liorknafo/home-robot/home-robot-sim/controller/requirements-learned.txt

# Optional desktop experiment. Install a compatible torch build separately first.
# Original Jetson Nano needs a separately validated JetPack/Python/torch environment.
lightglue @ git+https://github.com/cvg/LightGlue.git@eb42fee2d71449efb0aa5c10549752b5d75384d8
