liorknafo/home-robot/home-robot-sim/docs/superpowers/plans/2026-10-08-r1-bay-board.md

# R1 Bay Board (4-layer board under the Jetson) Implementation Plan

> **For agentic workers:** REQUIRED SUB-SKILL: Use superpowers:subagent-driven-development (recommended) or superpowers:executing-plans to implement this plan task-by-task. Steps use checkbox (`- [ ]`) syntax for tracking.

**Goal:** Move the power & I/O board from the 50 × 178 mm 2-layer strip to one 4-layer board of at most 100 × 100 mm (nominally 74 × 100) at base level under the unchanged Jetson. Then route it, check it, package it for fabrication, integrate it into the robot CAD, harness and BOM, and re-sync the simulator.

**Architecture:**
- **CAD and board stay coupled through files.** `cad/build_robot.py` (CadQuery) writes the meshes and manifest. `pcb/extract_outline.py` derives the board outline from them. `pcb/build_pcb.py` regenerates the KiCad board from `pcb/board_spec.py` (single source of truth). `pcb/route.py` routes it with Freerouting.
- **Two-way coupling from B8 on.** Until then the coupling is one-way, CAD → pcb. From B8 the CAD also imports the routed board: a STEP plus `pcb/board_cad.json`.
- **Plan order.** B1 moves the CAD placeholders, B2–B7 build the board, B8–B10 close the loop in the CAD, the harness and the simulator.

**Tech stack:**
- CadQuery 2.8 (`$CADPY`).
- KiCad 9.0.9 pcbnew (`$KPY`), `kicad-cli` (`$KCLI`).
- Freerouting 2.4.1 on Java 25.
- Blender 4 (viewer).
- Simulator `.venv` (sync, controller tests), Unreal 5.8 (benchmark).

**Spec:** `/Users/liorknafo/Documents/Codex/2026-10-03/i-x20/outputs/home-robot-sim/docs/superpowers/specs/2026-10-07-r1-bay-board-design.md`.
- It amends `2026-10-06-r1-low-profile-design.md` and `2026-10-04-r1-power-io-board-design.md`. Read the bay spec first, then the parts of those two that it keeps in force.

**Replaces:** tasks L4–L11 of `docs/superpowers/plans/2026-10-06-r1-low-profile.md`. L1–L3b of that plan are done and stay.

**Evidence to start from:**
- `home-robot-r1/.superpowers/sdd/2026-10-06-r1-low-profile/task-W4L-report.md` (the fit spike).
- Its scripts and placements in `.../handoff-scratch/w4l/`: `bay1_full.py` / `bay1_full.json` hold the THT and SMD positions in robot x, y; `bay1_full_conn.json` holds the connector positions.
- `home-robot-r1/.superpowers/sdd/codebase-survey-bay.md`: file:line map of every strip-specific and 2-layer-specific place in the code.

## Global Constraints

Copied from the bay spec. Every task's requirements include this section.

**Board:**
- **Size and position:** one 4-layer, 1.6 mm PCB with a bounding box ≤ 100 × 100 mm. Nominal outline robot x −66.5..7.5, y −50..50. Board bottom z 35.4, top z 37.0.
- **Outline from the CAD:** ≥ 1.5 mm to every fixed part.
- **Shape:**
  - full width for x −66.5..−14;
  - a tongue at |y| ≤ 33.5 for x −14..7.5, between the motor notches (motor x ±12.5, |y| ≥ 35, + 1.5 mm);
  - the rear Jetson standoffs at (−33, 40) and (−33, −46) clamp the board;
  - the front Jetson standoffs (x 25) lie ahead of it.
- **Stack-up:**
  - F.Cu: signals + SMD;
  - In1: solid GND;
  - In2: power pours (VBAT_SW, VMOT, 5V, 3V3) + signals;
  - B.Cu: signals.
- **Copper:** the quote's default (JLCPCB 4-layer default: 1 oz outer, 0.5 oz inner; confirm when ordering). Power paths sized from IPC-2221 at ≤ 10 °C rise. Parallel copper on F.Cu / In2 / B.Cu with via stitching counts. Heavier copper changes the price, so it needs the user's approval.

**Height zones:**
- **Under the carrier** (x ≥ −38.5): every part top, including a mated plug and its wire bend, ≤ z 54.77 − 1.5, i.e. ≤ 16.27 mm above the board top.
- **Behind the carrier** (x < −38.5): part tops ≤ lid underside − 3 mm (z 97.5).
- The old carrier-band rule (BAND_PLAN_MARGIN / BAND_PLAN_EXEMPT) is retired.

**Placement:**
- **Behind the carrier, exposed with the lid off:**
  - F1, F2, K1, C1;
  - the Pico, with its USB plug out of the left edge into the old strip-end space (x ≈ −54..−42, y 50..70), pluggable from above;
  - J1 battery, J2 rocker, J13 toggle loop, J12 arm button, J6 / J7 rear cliffs, on the rear edge.
- **Under the carrier:**
  - both DRV8874 carriers and the GY-521;
  - J4 / J5 on the motor-notch edges;
  - J10 / J11 bumpers on the side edges;
  - J8 / J9 front cliffs and J3 Jetson 5 V on the tongue's front edge;
  - U5A / U5B facing the P03;
  - the spares J14 / J15.
- **Under-carrier connectors:** each leaves its cable a path in the 17 mm gap. Either a right-angle (side-entry) housing or header, or a vertical part whose mated height plus a 90° wire bend fits the 16.27 mm zone. The cable leaves at a board edge, outward. These are plugged before the Jetson is fitted.
- **Assembly (LP3/LP4):**
  - reflow on top only;
  - ≥ 1.0 mm between SMD bodies;
  - ≥ 2.0 mm from an SMD pad to the pads of tall THT parts;
  - R13 thermal reliefs on SMD pads in zones;
  - values and polarity on silk;
  - F.Paste + stencil;
  - order: reflow SMD → inspect → iron THT → modules.
- **C1:** within 30 mm of both drivers' VIN pins.
- **Module sockets:** unmirrored.
- **Status LEDs and test pads:** behind the carrier if they fit there without breaking a rule; otherwise under it, recorded in BRINGUP.

**Rules:**
- **Unchanged:** R13 thermal reliefs; R16 Motor class with 1.0 mm clearance; R17 vias ≥ 0.5 mm from other-net pads and the 4.5 mm GND-only washer keep-out per M3 hole; LP12 one tented GND via per top-side SMD GND pad, now to In1; zero GND tracks; placement parity; route.py writes the board only on a clean result.
- **R4:** widths recomputed for the ordered copper.
- **R15:** on In1 — ≤ 1.05× for the power loops, ≤ 1.2× for the signal returns, and no In1 slot longer than 10 mm. The 40 mm B.Cu run rule is dropped.

**Mounting:**
- 4 × M3 into heat-set inserts in P_base on 2.4 mm printed PETG spacers. Start from the spike positions (−19.5, ±38), (−11.5, ±8.5) (H3/H4 moved by ruling PB4).
- The board is clamped in the two rear Jetson standoff stacks: base → 2.4 mm spacer → board → M2.5 × 20 mm standoff → Jetson. The Jetson stays at z 57.
- Printed bearing ribs on P_base sit under the rear-edge connector row.
- THT leads are trimmed to ≤ 1.4 mm.

**P03:** turned 90° in the front bay, x 9..47, |y| ≤ 31, z 33–48. Foam tape plus tie slots. Leads to U5A / U5B are about 10 mm. Re-check against the bumper riders B at full travel.

**Motor cables:** the factory 6-wire cables plug straight into J4 / J5. The W_motor harness and the motor-header joints are dropped.

**Pico GPIO:** PICO_GPIO in board_spec stays the single map. Constraints: I2C on a valid I2C pair; ADC only on GP26–28; each motor's IN1/IN2 on one PWM slice A/B. parts-and-connections.json follows it.

**CAD gates:**
- the build exits 0;
- `validation.json` → `clash_scan_empty` true;
- printability all-pass (Prusa MK3S: fits 250 × 210 × 210, overhangs, walls, a flat base);
- COM x ≤ −15 mm, nominal and worst case;
- robot top 155.15 mm (≤ 160);
- the Jetson, the lid and the LiDAR unchanged.

**Jetson model:** always NVIDIA's official Jetson Nano B01 model in the CAD, renders, viewer and sim sync. Never a block.

**Hard robot rules:** no blind reversing; the circle rule for spins; bumper and cliff behaviour unchanged.

**Never:**
- order or pay for anything;
- add ballast without asking the user;
- delete user data (`$SIM/Saved/Stereo` is theirs).

**Running sim:** the Unreal editor and the autonomy service may be running. Restart them only in B10, and tell the user.

**Version control:**
- Commit on branch `power-io-board` in `$R1`. Every message ends with `Co-Authored-By: Claude Opus 5.5 <noreply@anthropic.com>`.
- `$SIM` is not git: back up the files a task changes to `$SP/backup-original/bay-B<N>/` first.

**Machine limits:**
- ONE Freerouting JVM at a time, `-Xmx1g`.
- `df -h /System/Volumes/Data` ≥ 10 GB before each router run.
- No blocking command over about 4 minutes: run builds, routing, DRC and fills in the background with a log.
- Keep outputs small.
- Never open `$SP/f1`, `$SP/t6`, `$SP/t6r`.

Shell variables:

```bash
R1=/Users/liorknafo/Documents/Codex/2026-10-03/i-x20/outputs/home-robot-r1
SIM=/Users/liorknafo/Documents/Codex/2026-10-03/i-x20/outputs/home-robot-sim
SP=/private/tmp/claude-501/-Users-liorknafo-Documents-Codex-2026-10-03-i-x20-outputs-home-robot-sim/030356d9-c2ab-4fc2-a131-e83b5b8d9fe0/scratchpad
CADPY=$SP/cadvenv/bin/python          # CadQuery 2.8 + trimesh + numpy + matplotlib; recreate from $R1/cad/requirements.txt if $SP is gone
KPY=/Applications/KiCad/KiCad.app/Contents/Frameworks/Python.framework/Versions/Current/bin/python3
KCLI=/Applications/KiCad/KiCad.app/Contents/MacOS/kicad-cli
PURE="cd $R1 && $CADPY -m unittest discover -s pcb/tests -p 'test_*.py' -t ."
KTEST() { cd $R1 && PYTHONPATH=$R1 $KPY -m unittest pcb.tests.$1 -v; }
```

## Review Focus

These are inputs and conditions the spec implies but the obvious tests would miss. Each has its test in the owning task.

1. **A cable plugged into a connector under the Jetson.** The mated plug plus its wire bend must clear the carrier underside, and the cable must leave at an edge with nothing in the way. Test: B3 `test_under_carrier_connectors_leave_a_cable_path`.
2. **Plugging and unplugging the battery (J1), the rocker (J2) and the rear XH row.** The board must not flex. Every rear-edge connector sits over a bearing rib and within 35 mm of a fixing (M3 hole or standoff clamp). Test: B8 validation key `bay_rear_connectors_supported`.
3. **A bumper hit at full travel.** The turned P03 must not be struck by the bumper riders B. Test: B1 validation key `p03_clear_of_bumper_travel`.
4. **THT power pads connected to the planes through thermal spokes.** The spokes, summed over the layers each pad connects on, must carry the pad's net current at ≤ 10 °C. They must stay spokes, not solid, so the user can still iron the pad. Test: B6 `test_power_pad_spokes_carry_their_current`.
5. **The Pico USB plug, pushed in from above with the lid off and the Jetson fitted.** Its path to the left edge, and the space above it, must be clear. Tests: B3 `test_pico_usb_at_the_left_edge_with_clear_plug_path` and B8 validation key `pico_usb_insert_path_clear`.

## File structure

| File | Responsibility | Tasks |
|---|---|---|
| `cad/build_robot.py` | Robot CAD: the bay board placeholders (B1), then the real board (B8), cable runs (B9), mass records, validation keys | B1, B8, B9 |
| `pcb/board_spec.py` | Frame, height zones, REMOVED_CAD_IDS, PARTS footprints, PLACEMENT, EDGE_CONNECTORS, POWER_ZONES, PICO_GPIO | B2, B3, B4 |
| `pcb/extract_outline.py` | Bay outline, M3 holes and clamp holes from the CAD meshes → `pcb/board_outline.json` | B2 |
| `pcb/copper.py` (new) | Stack-up, copper weights, IPC-2221 widths and capacities | B4 |
| `pcb/build_pcb.py` | 4-layer board generation (stack-up, In1 plane, power pours on F.Cu / In2, B.Cu GND fill) | B4 |
| `pcb/zone_check.py` | Trunk check per layer, GND plane on In1, R15 on In1, In1 slot check, power capacity | B4, B5, B6 |
| `pcb/route.py` | 4-layer routing (In1 as a plane), strip-only stages removed | B5 |
| `pcb/power_check.py` (new) | B6 power check entry point and report | B6 |
| `pcb/make_fab.py` (new), `pcb/fab/ORDERING.md` (new) | Fabrication package | B7 |
| `pcb/export_cad.py` (new) → `pcb/board_cad.json`, `pcb/fab/r1_power_io.step` | Board data for the CAD | B8 |
| `pcb/tests/*` | test_board_spec, test_outline, test_copper (new), test_fab (new), ktest_pcb, ktest_route, ktest_power (new) | B2–B7 |
| `parts-and-connections.json`, `BRINGUP.md` (new, R1 root) | Harness, pin tables, BOM notes; bring-up | B9, B10 |
| `$SIM/Scripts/sync_robot_data.py` outputs, viewer files | Simulator and viewer | B10 |

---

### Task B1: CAD — bay board placeholders under the Jetson, P03 turned, motor joints removed

**Files:**
- Modify `cad/build_robot.py`. The survey (`codebase-survey-bay.md`, "cad/build_robot.py") lists every strip site with line numbers: the STRIP block :253–269, base holes :286 / :339 / :363, motor items :419–420, strip parts :433–455, Jetson standoffs :491–495, wires :882–902, NOW :1014, screw checks :1063 / :1493, lid-switch gaps :1627–1631, mass :1780–1791, prose :1830–2044.
- Regenerated outputs: `cad/*.json`, `cad/home-robot-r1.step` / `.glb`, `print-parts/`.

**Interfaces:**
- Consumes: spike positions from `handoff-scratch/w4l/bay1_full.json` and `bay1_full_conn.json` (robot x, y).
- Produces CAD ids:
  - `bay_board` (1.6 mm plate, nominal outline, M3 holes, clamp holes);
  - `bay_pico`, `bay_drv_0` (left), `bay_drv_1` (right), `bay_imu`, `pico_usb_plug` (at the left edge);
  - `bay_spacer_0..3` (2.4 mm printed PETG, z 33–35.4), `bay_screw_0..3`, `insert_bay_0..3`;
  - `bay_clamp_spacer_1`, `bay_clamp_spacer_3` (2.4 mm, under the rear Jetson standoffs);
  - `bay_rib_0..n` (printed ribs on P_base, top z 35.4).
- Produces constants: `BAY_OUTLINE` (robot x, y polygon), `ZBAY=35.4`, `BAY_T=1.6`, `ZBAY_TOP=37.0`, `BAY_MOUNTS=[(-19.5,38),(-19.5,-38),(-5.5,24),(-7,-14.5)]`, `BAY_CLAMPS=[(-33,40),(-33,-46)]`, `CARRIER_X=-38.5`, `UNDER_CARRIER_Z=54.77`.
- Changed: `jetson_standoff_1` and `jetson_standoff_3` become M2.5 × 20 mm nylon F-F, z 37.0–57.0. `jetson_screw_1` and `jetson_screw_3` become M2.5 × 12 countersunk.
- `p03_regulator` is turned: x 9..47, |y| ≤ 31, z 33..47 (14 mm), with foam z 33..34 if the current model has it. Tie slots in P_base.
- Removed: `strip_*`, `insert_strip_*`, `motor_header_*`, `W_motor_*`. `motor_cable_*` is re-routed to the J4 / J5 positions.
- New `validation.json` keys:
  - `p03_clear_of_bumper_travel` (bool);
  - `jetson_carrier_bottom_z` (float, must be 57.0);
  - `bay_under_carrier_max_top_z` (float, ≤ 53.27, from the placeholder modules);
  - `bay_ribs_under_rear_row` (bool).

**Steps:**
- [ ] **Step 1: Read the inputs.** Read the spec, this task, the survey's CAD section, and spike report §5 and §8. Load `bay1_full.json` / `bay1_full_conn.json` and note the positions of the Pico, DRV_L, DRV_R, IMU and the rear-edge connectors (J13, J6, J7, J12, J2, J1).
- [ ] **Step 2: Replace the strip block with the bay block** (:253–269 and the strip parts :433–455):
  - `BAY_OUTLINE` as the nominal polygon: rear x −66.5; front x 7.5 on the tongue; tongue |y| ≤ 33.5 for x > −14; full width |y| ≤ 50 for x ≤ −14.
  - `bay_board` = that polygon extruded `BAY_T` at `ZBAY`, with Ø3.2 holes at `BAY_MOUNTS` and Ø2.7 holes at `BAY_CLAMPS`.
  - Module placeholders at the spike positions, with the same `module()` helper and heights: Pico 15, DRV 14, IMU 14 above the board top. Rename the ids as above.
  - `pico_usb_plug` at the Pico's left-edge receptacle, pointing +y, into x ≈ −54..−42, y 50..70, z ≈ 44–52.
- [ ] **Step 3: Mounting.**
  - `insert_bay_i` at `BAY_MOUNTS`, made with the existing `insert()` helper (:158), with base holes as at :286.
  - `bay_spacer_i` 2.4 mm printed rings (z 33–35.4, Ø7 / Ø3.4).
  - `bay_screw_i` M3 × 8 pan-head from above.
  - Split the two rear Jetson standoff stacks (`JSTAND` indices at x −33): add the `bay_clamp_spacer_*` rings (z 33–35.4), make the standoff z 37.0–57.0 (20 mm), and lengthen the screw to M2.5 × 12. The front standoffs stay unchanged.
  - Remove `insert_strip_*` and their base holes. Remove the `JTHRU` clearance holes, since the clamp replaces them.
- [ ] **Step 4: P03.**
  - Set `P03C,P03S` to the turned pose: centre (28, 0), size (38, 62, 14) in x, y, z.
  - Add 2 tie slots in P_base beside it, in the same style as `TIES` (:253).
  - Add validation `p03_clear_of_bumper_travel`: sweep each `P_bumper_rider_*_B` (and every bumper part extract_outline sweeps) through its 5 mm travel, using the same sweep vector as `extract_outline.py` (bumper sweep near :162). Assert the swept solid does not intersect the P03 box inflated by 0.5 mm. Store the bool and the minimum gap.
- [ ] **Step 5: Motor items.**
  - Delete `motor_header_*` (:419) and `W_motor_*` (:885).
  - Re-route `motor_cable_{side}` with `wire()` from its motor exit to the J4 (left) / J5 (right) position in `bay1_full_conn.json`, at z 38 + 5.
  - Keep `NOW` treating `motor_cable*` as a wire.
- [ ] **Step 6: Wires.** Point W01, W02, W04, W10–W13, W14, W15, W16 and W_bumper_* (:882–902) at the spike connector positions (`bay1_full_conn.json`). Exit z = `ZBAY_TOP` + 5 behind the carrier, and `ZBAY_TOP` + 3 under it. Use the existing `wire()` helper, which writes `cable-cut-list.json`.
- [ ] **Step 7: Ribs and the remaining strip references.**
  - Add `bay_rib_i` on P_base under the rear-edge connector row. Each rib runs along y, 2 mm wide, z 33–35.4, under each rear connector's body (from `bay1_full_conn.json`). Keep each rib ≥ 1.0 mm from every THT pad position in `bay1_full.json`.
  - Validation `bay_ribs_under_rear_row`: true when each of J13, J6, J7, J12, J2, J1 has a rib under ≥ 50 % of its courtyard length.
  - Mass records: `PW` = p03_regulator, bay_board, bay_drv_0, bay_drv_1; `CTRL` = bay_pico, bay_imu, bay_board.
  - Lid-switch gaps (:1627–1631): use the bay ids. Update the strip prose (:1830–1831, :1990, :2012–2018, :2044) to describe the bay board.
- [ ] **Step 8: Remaining validation keys.**
  - `jetson_carrier_bottom_z` = the Jetson carrier PCB's min z, which must be 57.0.
  - `bay_under_carrier_max_top_z` = the max top z of every bay module placeholder whose footprint has x ≥ `CARRIER_X`, which must be ≤ 53.27.
  - Fold all four new keys into the overall validation pass, so a False fails the build's validation summary.
- [ ] **Step 9: Build** in the background:
  ```bash
  mkdir -p $SP/B1 && cd $R1 && $CADPY cad/build_robot.py > $SP/B1/build.log 2>&1; echo exit $?
  ```
  Expected: exit 0. Check with `python3 -c "import json;v=json.load(open('$R1/cad/validation.json'));print({k:v[k] for k in ('clash_scan_empty','p03_clear_of_bumper_travel','jetson_carrier_bottom_z','bay_under_carrier_max_top_z','bay_ribs_under_rear_row')})"`. Expected: True, True, 57.0, ≤ 53.27, True.
  - The printability summary is all-pass.
  - `mass-properties.json` `total_com_mm[0]` ≤ −15, and the worst case ≤ −15. The spike estimate is −18.25 / −15.70.
  - Robot top 155.15.
- [ ] **Step 10: Pure pcb tests.** Run `$PURE`. The tests that read strip ids are expected to fail until B2 (`test_removed_cad_ids_exist`, `test_removed_cad_ids_are_the_strip_placeholders`, test_outline). List them in the report. No other test may newly fail.
- [ ] **Step 11: Commit.**
  ```bash
  cd $R1 && git add cad print-parts && git commit -m "cad: board moves under the Jetson (bay placeholders), P03 turned in the front bay, motor joints dropped (bay B1)

  Co-Authored-By: Claude Opus 5.5 <noreply@anthropic.com>"
  ```

### Task B2: Board frame and outline for the bay

**Files:**
- Modify `pcb/board_spec.py`: frame :9–44, `HEIGHT_ZONES` :28, `BAND_*` :32–39, `max_part_h_at`, `REMOVED_CAD_IDS` :233, `MAX_PART_H`.
- Modify `pcb/extract_outline.py`: `ENV` :40, slab :39, `HOLE_SPOTS_ROBOT` :46, holes :321–331, plus clamp holes.
- Regenerate `pcb/board_outline.json`.
- Modify `pcb/tests/test_outline.py` and `pcb/tests/test_board_spec.py` (the strip tests listed in the survey).

**Interfaces:**
- Consumes: the B1 CAD ids and constants (`BAY_MOUNTS`, `BAY_CLAMPS`, `CARRIER_X`, `UNDER_CARRIER_Z`).
- Produces in `board_spec`:
  - `BOARD_X0=-66.5`, `BOARD_Y0=50.0`, `BOARD_W=74.0`, `BOARD_H=100.0`. The frame convention is unchanged: u = x − X0 (u 0 rear → 74 front), v = Y0 − y (v 0 = left edge y +50 → v 100 right edge).
  - `Z_PCB_BOTTOM=35.4`, `Z_PCB_TOP=37.0`.
  - `CARRIER_U=28.0` (x −38.5), `UNDER_CARRIER_Z=54.77`, `CARRIER_CLEARANCE=1.5`.
  - `UNDER_CARRIER_MAX_H = UNDER_CARRIER_Z - CARRIER_CLEARANCE - Z_PCB_TOP` (= 16.27).
  - `MAX_PART_H = CEILING_Z_LID - Z_PCB_TOP`, with `CEILING_Z_LID = LID_UNDERSIDE_Z - 3.0` (= 97.5), giving 60.5.
  - `HEIGHT_ZONES=[(CARRIER_U, 0.0, BOARD_W, BOARD_H, UNDER_CARRIER_MAX_H)]`.
  - `max_part_h_at(u, v)` returns the zone limit or `MAX_PART_H`. `BAND_PLAN_MARGIN` and `BAND_PLAN_EXEMPT` are deleted.
  - `REMOVED_CAD_IDS` = bay_board, bay_pico, bay_drv_0, bay_drv_1, bay_imu, pico_usb_plug, bay_spacer_0..3, bay_screw_0..3, bay_clamp_spacer_1, bay_clamp_spacer_3.
- Produces `board_outline.json` with the same keys as today, plus `clamp_holes_uv` (2 entries). `cutouts_uv` is empty unless the meshes need one.

**Steps:**
- [ ] **Step 1: Write the failing tests first** (rewrite the strip tests).
  - In test_board_spec, `test_strip_frame` becomes `test_bay_frame`:
    ```python
    def test_bay_frame(self):
        self.assertEqual((B.BOARD_X0, B.BOARD_Y0, B.BOARD_W, B.BOARD_H), (-66.5, 50.0, 74.0, 100.0))
        self.assertEqual((B.Z_PCB_BOTTOM, B.Z_PCB_TOP), (35.4, 37.0))
        self.assertLessEqual(max(B.BOARD_W, B.BOARD_H), 100.0)   # JLCPCB <= 100 x 100 price
        self.assertAlmostEqual(B.UNDER_CARRIER_MAX_H, 16.27, places=2)
        self.assertAlmostEqual(B.MAX_PART_H, 60.5, places=2)
    ```
    - `test_height_zones_are_well_formed` asserts `HEIGHT_ZONES == [(28.0, 0.0, 74.0, 100.0, B.UNDER_CARRIER_MAX_H)]`.
    - `test_max_part_h_formula` asserts the formula above.
    - `test_removed_cad_ids_are_the_strip_placeholders` becomes `test_removed_cad_ids_are_the_bay_placeholders`, asserting the exact id set above.
    - Delete `test_band_plan_margin`.
  - In test_outline:
    - Replace the strip assertions with:
      - `test_bbox_within_100mm`: outline bbox ≤ 74.0 × 100.0 + 0.01;
      - `test_large_enough`: area ≥ 6,000 mm²;
      - `test_outline_inside_the_bay_envelope`;
      - `test_motor_notches`: no outline point within 1.5 mm of either motor mesh's xy hull;
      - `test_clamp_holes_at_the_rear_jetson_standoffs`: `clamp_holes_uv` equals `BAY_CLAMPS` in board coordinates ±0.1;
      - `test_holes_sit_on_the_bay_inserts`: `holes_uv` equals the `insert_bay_*` centres from the manifest ±0.1;
      - `test_rear_edge_keeps_off_the_battery_tray`: kept, with the bay values.
    - Delete `test_strip_envelope_is_the_cad_placeholder`, `test_front_corner_notches_for_the_motor_mounts` and `test_cutouts_around_both_jetson_standoffs`.
    - Keep the generic tests: necks, short edges, keep-out margin, RealGeometryTests.
    - BoardHeightTests:
      - `test_height_zones_cover_the_area_under_the_jetson_carrier`: every board cell under the carrier mesh's xy hull has u ≥ CARRIER_U;
      - `test_every_cell_of_the_board_is_under_its_height_limit`: for each 1 mm cell, `Z_PCB_TOP + max_part_h_at(cell) ≤` (the lowest mesh bottom above the board at that cell) − 1.5, or ≤ 97.5 where nothing is above.
- [ ] **Step 2: Run the tests to watch them fail.** Run `$PURE`. Expected: the new frame and outline tests FAIL with the old strip values.
- [ ] **Step 3: Update board_spec.**
  - Set the constants above.
  - Rewrite `max_part_h_at` as a zone lookup.
  - Delete the band constants and their users. Grep `BAND_PLAN` across `pcb/` and fix every hit.
  - Set `REMOVED_CAD_IDS`.
- [ ] **Step 4: Update extract_outline.**
  - `ENV` = robot x −70..10, y −50..50. The meshes then cut the rear (tray wall), the front (P03) and the notches (motors).
  - Slab Z0..Z1 = 33.0..54.77.
  - `HOLE_SPOTS_ROBOT` = the `insert_bay_*` centres from the manifest.
  - Add `CLAMP_SPOTS_ROBOT` = the centres of `jetson_standoff_1` and `jetson_standoff_3` → `clamp_holes_uv`. Exclude those two standoffs and `bay_clamp_spacer_*` from the keep-out hulls: they are the clamp, not obstacles.
  - Keep `MARGIN` 1.5, `CLOSE` 1.1 and the one-piece rule.
- [ ] **Step 5: Generate and test.**
  ```bash
  cd $R1 && $CADPY pcb/extract_outline.py && eval $PURE
  ```
  Expected: all pure tests PASS, except the ktest-dependent ones listed in B3 (none are in the pure suite).
- [ ] **Step 6: Commit.**
  ```bash
  git add pcb/board_spec.py pcb/extract_outline.py pcb/board_outline.json pcb/tests
  git commit -m "pcb: bay board frame, height zones and outline from the CAD (bay B2)

  Co-Authored-By: Claude Opus 5.5 <noreply@anthropic.com>"
  ```
  ktest_pcb is red until B3, because PLACEMENT still holds strip coordinates.

### Task B3: Placement under the Jetson (still 2 layers; B4 converts the stack)

**Files:**
- Modify `pcb/board_spec.py`:
  - `PARTS` footprints for the under-carrier connectors that need right-angle parts;
  - `PLACEMENT` (including H1–H4 at `holes_uv`, plus H5 / H6 clamp holes);
  - `EDGE_CONNECTORS`, `TERMINALS`;
  - `POWER_ZONES` (F.Cu polygons for the new placement);
  - `SMD_GND_VIAS` (regenerated);
  - `PREROUTES`, `HOP_VIAS`, `PREROUTE_VIAS` all emptied;
  - `PICO_GPIO`, only if remapped.
- Modify `pcb/build_pcb.py`: H5 / H6 as NPTH Ø2.7 footprints with the keep-out.
- Run `pcb/make_schematic.py` to regenerate the schematic, project, DRU and netlist.
- Modify `pcb/tests/ktest_pcb.py` and `pcb/tests/test_board_spec.py` (their strip tests).
- Modify `pcb/zone_check.py`: `MOUNT_HOLES` gains H5 / H6, with `CLAMP_KEEP=3.5` mm (no copper but GND).
- Modify `parts-and-connections.json`.

**Interfaces:**
- Consumes: the B2 frame, `HEIGHT_ZONES`, `max_part_h_at`, `board_outline.json` (`holes_uv`, `clamp_holes_uv`).
- Produces:
  - `EDGE_CONNECTORS: dict[str, str]`, ref → entry direction, one of `'+u'`, `'-u'`, `'+v'`, `'-v'`. The cable leaves the board in that direction. The old edge names are dropped.
  - `CABLE_BEND_MM = {'XH': 5.0, 'PinHeader': 5.0, 'VH': 7.0}`: the wire-bend allowance above a vertical mated plug.
  - `MATED_H: dict[str, float]`: per-connector mated height (housing + plug) above the board top, taken from the datasheets and recorded with a source note.
  - `UNDER_CARRIER(ref) -> bool`: true when the part's courtyard reaches u ≥ CARRIER_U, computed from PLACEMENT and the footprint courtyard bbox.
  - `connector_family(ref) -> str`: one of 'XH', 'VH', 'PinHeader', 'Terminal', from the PARTS footprint name.
  - `cable_lane_obstacles(board, ref, direction, max_h)`: a test helper in ktest_pcb (defined in Step 1).

**Steps:**
- [ ] **Step 1: Write the failing tests.**
  - ktest_pcb:
    - `test_connectors_on_their_edges`: for each ref in EDGE_CONNECTORS, the courtyard is within 1.5 mm of the outline edge in its entry direction.
    - `test_connector_plug_entry_faces_outward`: generic. The connector's entry side, from its footprint orientation, points along its EDGE_CONNECTORS direction.
    - Delete `test_lp7_front_connectors_outside_the_carrier` and `test_front_band_holds_only_smd`.
    - `test_part_heights_fit_where_they_sit`: uses `max_part_h_at` for every courtyard cell.
    - `test_under_carrier_connectors_leave_a_cable_path` (Review Focus 1):
      ```python
      def test_under_carrier_connectors_leave_a_cable_path(self):
          for ref, d in B.EDGE_CONNECTORS.items():
              if not B.UNDER_CARRIER(ref):
                  continue
              fam = B.connector_family(ref)          # 'XH' | 'VH' | 'PinHeader' | 'Terminal'
              vertical = B.PARTS[ref]['fp'].endswith('_Vertical')
              need = B.MATED_H[ref] + (B.CABLE_BEND_MM[fam] if vertical else 0.0)
              self.assertLessEqual(need, B.UNDER_CARRIER_MAX_H, ref)
              # nothing taller than 3 mm between the connector's entry side and the board edge in direction d
              self.assertEqual(cable_lane_obstacles(self.board, ref, d, max_h=3.0), [], ref)
      ```
      `cable_lane_obstacles` is a test helper: the lane is the connector's courtyard width, swept in direction d to the outline. It returns the refs whose courtyards in that lane have h > 3.0.
    - `test_pico_usb_at_the_left_edge_with_clear_plug_path` (Review Focus 5). The USB receptacle end of U1A/U1B points −v (left edge, v 0). The lane `USB_PLUG_W` wide from the receptacle to v 0 holds no courtyard. The receptacle is within 3 mm of the edge.
    - `test_band_holds_the_frequent_connectors_and_fuses`: J1, J2, J6, J7, J12, J13, F1, F2, K1, C1, U1A and U1B have every courtyard point at u < CARRIER_U.
    - `test_c1_within_30mm_of_both_vin`: the distance from C1's centre to the VIN pad of U3P and of U4P is ≤ 30.0. Report the two values.
    - `test_clamp_holes_at_outline_clamp_holes`: H5 / H6 sit at `clamp_holes_uv` ±0.05, and no copper but GND lies within `CLAMP_KEEP`.
  - test_board_spec:
    - `test_every_off_board_connector_has_an_edge`: every connector ref is in EDGE_CONNECTORS, with a direction in {'+u','-u','+v','-v'}.
    - `test_pico_usb_end_points_at_the_left_end` → `..._at_the_left_edge`, asserting the −v direction.
- [ ] **Step 2: Run the tests to watch them fail.**
  ```bash
  cd $R1 && $KPY pcb/build_pcb.py && KTEST ktest_pcb 2>&1 | tail -30
  ```
  Expected: FAIL. The parts sit at strip coordinates, outside the bay outline.
- [ ] **Step 3: Choose the under-carrier connector parts.**
  - For every connector with `UNDER_CARRIER`, compute `MATED_H + bend` for the vertical part. Record the datasheet heights in `MATED_H` with a comment giving the source.
  - If a part exceeds 16.27, switch it to the side-entry KiCad footprint: `JST_XH_S{n}B-XH-A_1x0{n}_P2.50mm_Horizontal`, `JST_VH_S2P-VH_1x02_P3.96mm_Horizontal`, or `PinHeader_1x06_P2.54mm_Horizontal`. The MKDS terminals are already horizontal.
  - Update `PARTS` (fp, h, MPN), then run `$KPY pcb/make_schematic.py` so `test_generated_files_are_current` stays green.
- [ ] **Step 4: Write PLACEMENT.**
  - Convert `handoff-scratch/w4l/bay1_full.py` positions from robot x, y to u, v with `robot_to_board`.
  - Adjust for the Step 3 footprints, and for H5 / H6 with their keep-out.
  - Move the LEDs and test pads into the band (u < 28) wherever every rule still holds. List those that stay under the carrier, for B10's BRINGUP.
  - **Band fallback (spec risk 1).** The spike filled about 98.5 of the 100 mm along v. If the band parts do not fit with the Step 3 footprints and H5 / H6, apply these in order and stop at the first that fits:
    1. C1 → SMD can, Ø10 × 10.5, Panasonic EEE-FK1E471P; then C1 may go under the carrier.
    2. C1 laid flat.
    3. Spike variant B-ii: the full 100 × 100 board, with the P03 on a printed shelf over a motor. This changes B1/B2: report BLOCKED with numbers, and the controller re-scopes.

    Record which one was used.
  - Write EDGE_CONNECTORS directions and TERMINALS.
  - Draw `POWER_ZONES` F.Cu polygons for VBAT_SW, VMOT, 5V around their trunk pads, as the existing tests require (4 mm corridor, disjoint).
  - Regenerate `SMD_GND_VIAS` with the LP12 rule.
  - Empty `PREROUTES`, `HOP_VIAS` and `PREROUTE_VIAS`.
  - If routing will want a GPIO remap, record it in `PICO_GPIO`, respecting the hardware constraints.
- [ ] **Step 5: parts-and-connections.json.**
  - Update the connector table: edges, right-angle parts, motor cables plugging straight into J4 / J5.
  - Update the Pico pin table, so it equals `PICO_GPIO`.
  - The uncommitted L5b edit in this file is the starting point. Diff it against `PICO_GPIO` and fix any mismatch.
- [ ] **Step 6: Build and run the tests.**
  ```bash
  cd $R1 && $KPY pcb/build_pcb.py && KTEST ktest_pcb 2>&1 | tail -5 && eval $PURE 2>&1 | tail -3
  ```
  Expected: ktest_pcb all PASS (still 2 layers), pure all PASS, DRC with 0 silk problems. Record the C1 distances.
- [ ] **Step 7: Plot and commit.**
  - Plot the placement (F.Fab + courtyards) to `$SP/B3/placement.png`.
  - Commit:
    ```bash
    git add pcb parts-and-connections.json && git commit -m "pcb: placement under the Jetson, right-angle connectors under the carrier (bay B3)

    Co-Authored-By: Claude Opus 5.5 <noreply@anthropic.com>"
    ```

### Task B4: 4-layer stack-up and copper rules

**Files:**
- Create `pcb/copper.py` and `pcb/tests/test_copper.py`.
- Modify `pcb/build_pcb.py`: :173 layer count, stack-up, zones :225–237.
- Modify `pcb/board_spec.py`: `POWER_ZONES` entries gain `layers`; BAT+, F1_OUT, F2_OUT become zones too; `NETCLASSES` comment and R4 text.
- Modify `pcb/zone_check.py`: `trunk_layer` :37 → per-net layer lists; the GND functions :101–180 use `copper.GND_PLANE_LAYER`; new `in1_voids`.
- Modify `pcb/tests/ktest_pcb.py` (the 2L tests :151 / :184 / :197 / :248) and `pcb/tests/test_board_spec.py` (`test_power_zones_are_the_f_cu_trunks`, `test_preroutes_are_well_formed`).

**Interfaces:**
- Produces `pcb/copper.py`:
  ```python
  """Copper stack-up of the ordered board and IPC-2221 widths (bay spec 2026-10-07 §2)."""
  STACKUP = ('F.Cu', 'In1.Cu', 'In2.Cu', 'B.Cu')
  COPPER_OZ = {'F.Cu': 1.0, 'In1.Cu': 0.5, 'In2.Cu': 0.5, 'B.Cu': 1.0}   # JLCPCB 4-layer default; confirm when ordering
  GND_PLANE_LAYER = 'In1.Cu'
  RISE_C = 10.0
  MIL = 0.0254

  def is_internal(layer):
      return layer.startswith('In')

  def ipc2221_width_mm(current_a, oz, rise_c=RISE_C, internal=False):
      """Track width (mm) that carries current_a at rise_c on copper of weight oz (IPC-2221 chart fit)."""
      k = 0.024 if internal else 0.048
      area_mil2 = (current_a / (k * rise_c ** 0.44)) ** (1 / 0.725)
      return area_mil2 / (1.378 * oz) * MIL

  def ipc2221_current_a(width_mm, oz, rise_c=RISE_C, internal=False):
      """Current (A) a track of width_mm carries at rise_c (inverse of ipc2221_width_mm)."""
      k = 0.024 if internal else 0.048
      area_mil2 = width_mm / MIL * 1.378 * oz
      return k * rise_c ** 0.44 * area_mil2 ** 0.725

  def capacity_a(widths_by_layer, rise_c=RISE_C):
      """Summed IPC current of parallel copper: {layer: width_mm} -> A."""
      return sum(ipc2221_current_a(w, COPPER_OZ[l], rise_c, is_internal(l)) for l, w in widths_by_layer.items() if w > 0)
  ```
- Produces `POWER_ZONES` entries shaped `dict(net=..., layers=('F.Cu','In2.Cu'), poly=[(u, v), ...])`.
- Produces `zone_check.in1_voids(board) -> list[(length_mm, bbox)]`: the holes in the filled In1 GND polygon, excluding the board cutouts and the mounting / clamp holes.

**Steps:**
- [ ] **Step 1: Write the failing tests** in `pcb/tests/test_copper.py` (pure):
  ```python
  import unittest
  from pcb import copper as C

  class CopperTests(unittest.TestCase):
      def test_ipc2221_reference_widths(self):
          self.assertAlmostEqual(C.ipc2221_width_mm(7.5, 1.0), 4.838, delta=0.01)
          self.assertAlmostEqual(C.ipc2221_width_mm(5.0, 1.0), 2.765, delta=0.01)
          self.assertAlmostEqual(C.ipc2221_width_mm(2.1, 1.0), 0.836, delta=0.01)
          self.assertAlmostEqual(C.ipc2221_width_mm(1.0, 0.5, internal=True), 1.563, delta=0.01)

      def test_current_is_the_inverse_of_width(self):
          for i in (0.5, 2.1, 5.0, 7.5):
              self.assertAlmostEqual(C.ipc2221_current_a(C.ipc2221_width_mm(i, 1.0), 1.0), i, places=6)

      def test_parallel_copper_adds(self):
          one = C.capacity_a({'F.Cu': 3.0})
          self.assertAlmostEqual(C.capacity_a({'F.Cu': 3.0, 'B.Cu': 3.0}), 2 * one, places=6)
          self.assertGreater(C.capacity_a({'F.Cu': 3.0, 'B.Cu': 3.0}), 7.5)   # BAT+ on two outer layers

      def test_stackup_is_the_ordered_default(self):
          self.assertEqual(C.STACKUP, ('F.Cu', 'In1.Cu', 'In2.Cu', 'B.Cu'))
          self.assertEqual(C.COPPER_OZ, {'F.Cu': 1.0, 'In1.Cu': 0.5, 'In2.Cu': 0.5, 'B.Cu': 1.0})
          self.assertEqual(C.GND_PLANE_LAYER, 'In1.Cu')
  ```
  - ktest_pcb:
    - `test_power_zones_present`: In1 holds exactly one zone, net GND, covering the outline. In2 holds the pours VBAT_SW, VMOT, 5V, 3V3. B.Cu holds a GND fill. F.Cu holds the POWER_ZONES F.Cu entries.
    - `test_power_zone_pads_use_wide_thermal_reliefs`: every zone on every layer, spokes ≥ 1.2 mm, gap 0.3–0.5.
    - `test_filled_copy_keeps_every_trunk_connected`: per net, per layer it is poured on.
    - `test_in1_has_no_slot_longer_than_10mm`: on the placed board, `max(length for length, _ in in1_voids(b)) <= 10.0`. This catches THT rows whose antipads merge, e.g. 2.54 mm socket rows. The fix is a smaller In1 clearance and min-width, not a weaker test.
    - `test_assembly_rules_for_reflow`: unchanged, except SMD pads stay off In1, In2 and B.Cu.
  - test_board_spec:
    - `test_power_zones_are_the_trunks_on_their_layers`: each POWER_ZONES entry's layers ⊆ ('F.Cu','In2.Cu','B.Cu'). BAT+, F1_OUT, F2_OUT, VBAT_SW, VMOT and 5V each have a zone.
    - `test_preroutes_are_well_formed`: allows the four STACKUP layers.
- [ ] **Step 2: Run the tests to watch them fail.** Run `eval $PURE` and `KTEST ktest_pcb`. Expected: test_copper fails with ImportError; the ktest layer tests fail on the 2-layer board.
- [ ] **Step 3: Implement.**
  - Add `pcb/copper.py` as above.
  - In build_pcb:
    - `SetCopperLayerCount(4)`;
    - set the board stack-up to 1.6 mm with copper thicknesses from `COPPER_OZ` (0.035 mm per oz) via the KiCad 9 `BOARD_STACKUP` API;
    - In1 GND zone over the outline, priority 0, zone clearance 0.2, min width 0.2 (keeps the webs in 2.54 mm rows);
    - In2 pours for VBAT_SW, VMOT, 5V (the POWER_ZONES In2 polygons) and 3V3 (the area round the Pico 3V3 pin, U2 and the shifters);
    - B.Cu GND fill, priority 0;
    - F.Cu POWER_ZONES;
    - all with R13 reliefs.
  - zone_check:
    - `trunk_layer(net)` becomes `trunk_layers(net) -> tuple[str, ...]`, read from POWER_ZONES; GND → (`GND_PLANE_LAYER`, 'B.Cu').
    - Every GND function takes a `layer` argument that defaults to `GND_PLANE_LAYER`.
    - Add `in1_voids`.
  - board_spec: BAT+, F1_OUT and F2_OUT become POWER_ZONES on ('F.Cu', 'B.Cu'). Keep the Power class width 3.0 mm for the short stubs, and document that in the R4 comment: "two 1-oz outer layers in parallel, 10.6 A > 7.5 A at 10 °C".
  - Run `$KPY pcb/make_schematic.py` if the net classes change.
- [ ] **Step 4: Run the tests to watch them pass.**
  ```bash
  cd $R1 && $KPY pcb/build_pcb.py && KTEST ktest_pcb 2>&1 | tail -5 && eval $PURE 2>&1 | tail -3
  ```
  Expected: all PASS. Record the largest In1 void.
- [ ] **Step 5: Commit.**
  ```bash
  git add pcb && git commit -m "pcb: 4-layer stack-up - In1 GND plane, In2 power pours, IPC-2221 copper rules (bay B4)

  Co-Authored-By: Claude Opus 5.5 <noreply@anthropic.com>"
  ```

### Task B5: Route on 4 layers

**Files:**
- Modify `pcb/route.py`:
  - delete the strip stages: `CELL_GRIDS` :233, `BOX` :254, `POWER_PATH_*` :245, hop windows :250–277, `promote_bcu` :375, `BCU_RUN_MAX` :551;
  - generalise the layer handling (:33–55, :310–351, :454) to `copper.STACKUP`, with In1 as a plane that is not routed;
  - vias through all layers.
- Modify `pcb/zone_check.py`: `bcu_runs` is removed or kept unused.
- Modify `pcb/tests/ktest_route.py`:
  - The 2L tests → In1: `test_every_gnd_pad_on_the_main_gnd_piece`, `test_return_paths_through_the_gnd_plane`, and `test_no_foreign_copper_in_power_zones` per layer.
  - Delete `test_router_bcu_runs_are_short`.
  - Add `test_in1_has_no_slot_longer_than_10mm` on the routed board.
  - Move `CLASS_VIA` to one place, board_spec, and import it in route.py, ktest_route and make_schematic.
- Commit the routed `pcb/r1_power_io.kicad_pcb`.

**Interfaces:**
- Consumes: copper.py, `zone_check.in1_voids`, `POWER_ZONES` layers.
- Produces: the routed board, written only by route.py's clean path.

**Steps:**
- [ ] **Step 1: Rewrite the ktest_route tests first** (failing on the unrouted board).
  - R15 limits stay as they are: `POWER_LOOPS` ≤ 1.05×, `SIGNAL_RETURNS` ≤ 1.2×, measured on `GND_PLANE_LAYER`.
  - Add the slot test.
- [ ] **Step 2: Adapt route.py.**
  - The DSN carries F.Cu, In2.Cu and B.Cu as signal layers. In1.Cu is a plane: mark it as a power layer in the stack-up, or remove it from the DSN, then check the exported .dsn shows it is not routed.
  - Keep stages B–E, the clean-write rule, `--grids`, `--parallel 1` and `-Xmx1g`.
  - Remove `--critical` only if it is unused afterwards.
- [ ] **Step 3: Route** in the background:
  ```bash
  df -h /System/Volumes/Data | tail -1; pgrep -fl freerouting || true
  mkdir -p $SP/B5 && cd $R1 && $KPY pcb/route.py --grids 1 --parallel 1 --keep $SP/B5/run1 > $SP/B5/run1.log 2>&1; echo exit $?
  ```
  Expected: exit 0 with "clean". If not clean, read the evaluation in the log, fix the cause (placement nudges of ≤ 2 mm within the B3 rules, zone tweaks), and run the next grid. Use one JVM at a time.
- [ ] **Step 4: Run the tests.**
  ```bash
  KTEST ktest_route 2>&1 | tail -5; KTEST ktest_pcb 2>&1 | tail -3; eval $PURE 2>&1 | tail -3
  ```
  Expected: all PASS. Record the R15 ratios, the largest In1 void and the via count.
- [ ] **Step 5: Renders.** Write to `$SP/B5/`:
  - `render_top.png` and `render_iso.png` (`$KCLI pcb render`);
  - `copper_F.png`, `copper_In1.png`, `copper_In2.png`, `copper_B.png` (`$KCLI pcb export svg` per layer, converted to PNG).
- [ ] **Step 6: Commit.**
  ```bash
  git add pcb && git commit -m "pcb: bay board routed on 4 layers - DRC 0, R15 on In1 (bay B5)

  Co-Authored-By: Claude Opus 5.5 <noreply@anthropic.com>"
  ```
- **Stop condition:** if no grid gives a clean result after a real effort, stop and report what is unrouted, which test fails and by how much, and what you tried. The controller decides. Never change the layer count or relax a limit.

### Task B6: Power-path check

**Files:**
- Create `pcb/power_check.py` (report CLI) and `pcb/tests/ktest_power.py`.
- Modify `pcb/zone_check.py`: reuse the erosion code with a width parameter.

**Interfaces:**
- Consumes: `copper.capacity_a`, `copper.ipc2221_width_mm`, `B.CURRENT_A`, `B.POWER_TRUNK`, `POWER_ZONES` layers, the routed board.
- Produces:
  - `power_check.trunk_capacity(board, net) -> dict` with `{'width_mm': {layer: w}, 'capacity_a': A}`. w is the largest width for which the eroded filled copper of that net on that layer still joins every POWER_TRUNK pad of the net.
  - `power_check.pad_spoke_capacity(board, ref, pad) -> float` in A: the spoke copper summed over the layers the pad connects to its zone on.
  - `power_check.power_trunk_pads(board) -> list[(ref, pad, net)]`: every POWER_TRUNK pad, plus the GND pads of J1, J3, U5A, U5B, U3P and U4P.
  - `power_check.pad_uses_spokes(board, ref, pad) -> bool`: true when every zone connection of the pad is a thermal relief, not solid.
  - `power_check.min_track_width(board, net) -> float`: the narrowest track segment of the net, in mm.

**Steps:**
- [ ] **Step 1: Write the failing tests** (`pcb/tests/ktest_power.py`):
  ```python
  def test_trunks_carry_their_current_at_10C(self):
      for net, amps in B.CURRENT_A.items():
          if net in ('L_M1', 'L_M2', 'R_M1', 'R_M2'):
              continue
          cap = P.trunk_capacity(self.board, net)['capacity_a']
          self.assertGreaterEqual(cap, amps, net)

  def test_power_pad_spokes_carry_their_current(self):      # Review Focus 4
      for ref, pad, net in P.power_trunk_pads(self.board):
          self.assertGreaterEqual(P.pad_spoke_capacity(self.board, ref, pad), B.CURRENT_A[net], f'{ref}.{pad}')
          self.assertTrue(P.pad_uses_spokes(self.board, ref, pad), f'{ref}.{pad} must be relieved (iron-solderable)')

  def test_motor_tracks_meet_ipc(self):
      for net in ('L_M1', 'L_M2', 'R_M1', 'R_M2'):
          self.assertGreaterEqual(P.min_track_width(self.board, net), C.ipc2221_width_mm(B.CURRENT_A[net], C.COPPER_OZ['F.Cu']), net)
  ```
- [ ] **Step 2: Run to watch them fail.** `KTEST ktest_power`. Expected: FAIL with ImportError.
- [ ] **Step 3: Implement `power_check.py`.**
  - Trunk capacity: binary-search w per layer with the zone_check erosion of the filled zone (erode w/2, then check that the trunk pads still join); sum the layers with `capacity_a`.
  - Spokes: count the spoke width × spoke count per layer from the zone's relief settings and the pad's connection.
  - Track width: the minimum of the net's segments.
  - CLI: `$KPY pcb/power_check.py` prints a table: net, A, width per layer, capacity, margin.
- [ ] **Step 4: Run and fix the copper.** Widen pours or spokes, or add stitching vias, until every test passes. Spoke width ≤ 2.0 mm keeps the pads solderable. Then:
  ```bash
  $KPY pcb/route.py ...   # only if copper changed: re-route through the clean path
  KTEST ktest_power; KTEST ktest_route; KTEST ktest_pcb
  ```
  Expected: all PASS.
- [ ] **Step 5: Write the report table** to `$SP/B6/power.txt`, plus a DRV8874 dissipation estimate at 2.1 A per channel (R_DS(on) from the datasheet, both drivers) for spec risk 5.
- [ ] **Step 6: Commit** with the message "pcb: power-path check on the 4-layer copper (bay B6)" and the Co-Authored-By line.

### Task B7: Fabrication package

**Files:**
- Create `pcb/make_fab.py`, `pcb/fab/ORDERING.md` and `pcb/tests/test_fab.py`.
- Generated (committed): `pcb/fab/` with gerbers, drill, BOM csv, 1:1 PDF and STEP.

**Interfaces:**
- Consumes: the routed board.
- Produces `pcb/fab/r1_power_io-gerbers.zip`, `pcb/fab/r1_power_io-bom.csv`, `pcb/fab/r1_power_io-1to1.pdf` and `pcb/fab/r1_power_io.step`. B8 reads the STEP.

**Steps:**
- [ ] **Step 1: Write `test_fab.py` (pure).** The zip holds:
  - F.Cu, In1.Cu, In2.Cu, B.Cu;
  - F/B.Mask, F/B.Silkscreen;
  - F.Paste;
  - Edge.Cuts;
  - PTH and NPTH drill.

  It also asserts:
  - the Edge.Cuts gerber's extent is ≤ 100.0 × 100.0 mm;
  - the BOM lists every PARTS ref with its MPN;
  - ORDERING.md contains the strings "4 layers", "1 oz outer", "0.5 oz inner", "stencil", "reflow", "trim", "tented".
- [ ] **Step 2: Run to watch it fail.** Run `eval $PURE`. Expected: test_fab FAILs (no fab folder).
- [ ] **Step 3: Implement `make_fab.py`.**
  - Gerbers: `$KCLI pcb export gerbers --layers F.Cu,In1.Cu,In2.Cu,B.Cu,F.Mask,B.Mask,F.Silkscreen,B.Silkscreen,F.Paste,Edge.Cuts`.
  - Drill: `$KCLI pcb export drill --excellon-separate-th`.
  - BOM from PARTS.
  - PDF: `$KCLI pcb export pdf` at 1:1.
  - STEP: `$KCLI pcb export step --subst-models --include-tracks`, with envelopes for the parts that have no 3D model (FLR holders, VH and side-entry headers).
  - Silk text: raise 0.8 → 1.0 mm if every label still places (deferred L5 minor). Otherwise keep 0.8 and note it.
- [ ] **Step 4: Write ORDERING.md.** It must say:
  - JLCPCB, 4 layers, 1.6 mm, ≤ 100 × 100 (74 × 100), default copper (1 oz outer, 0.5 oz inner; confirm on the order page; heavier copper only with the user's OK), via tenting on, 5 pcs, about $8, plus a top stencil (solder paste);
  - FLR holder on a 1.6 mm board;
  - up-angled micro-USB for the Pico;
  - no D24V50F5;
  - P03 on foam tape; measure it first;
  - M2.5 × 20 mm nylon F-F standoffs ×2, M2.5 × 12 countersunk ×2, M3 inserts ×4, printed spacers;
  - assembly order: reflow SMD → inspect → iron THT (trim leads ≤ 1.4 mm) → modules;
  - "agents never order: the user places the order".
- [ ] **Step 5: Run the tests.** Run `$KPY pcb/make_fab.py && eval $PURE`. Expected: all PASS.
- [ ] **Step 6: Commit** with the message "pcb: fabrication package for the 4-layer bay board (bay B7)" and the Co-Authored-By line.

### Task B8: Real board into the robot CAD

**Files:**
- Create `pcb/export_cad.py` → `pcb/board_cad.json`. It holds, in robot x, y, z:
  - outline, holes, clamp holes;
  - every THT pad;
  - every connector's courtyard, entry direction and mated height;
  - module bodies;
  - the Pico USB receptacle.
- Modify `cad/build_robot.py`:
  - import `pcb/fab/r1_power_io.step` as `bay_board`;
  - the module models: Pico and DRV8874 from `reference-models/`, GY-521 body, P03 envelope;
  - ribs regenerated from `board_cad.json`;
  - plug, cable-stub and insertion checks;
  - new validation keys.
- Run `cad/rebuild_review.py` to regenerate design-review.html.

**Interfaces:**
- Consumes: `board_cad.json`, the STEP, the B1 ids.
- Produces validation keys:
  - `bay_rear_connectors_supported` (bool; Review Focus 2);
  - `pico_usb_insert_path_clear` (bool; Review Focus 5);
  - `under_carrier_cable_paths_clear` (bool).

**Steps:**
- [ ] **Step 1: Write `export_cad.py`.** Run `$KPY pcb/export_cad.py`. Check `board_cad.json` against the board: the hole count, and the outline area ±1 %.
- [ ] **Step 2: Replace the placeholders in `build_robot.py`.**
  - The STEP board at `ZBAY` (B1 ids keep their names, so REMOVED_CAD_IDS still matches).
  - Real module models at their socket pads, as `show/modules_l5.py` did for the viewer: official Pico R3 and Pololu DRV8874 STEP from `reference-models/`.
  - Re-place the M3 holes and clamps from `board_cad.json`.
- [ ] **Step 3: Ribs from the real pads.** Ribs sit under J1, J2, J6, J7, J12 and J13, at ≥ 1.0 mm from every THT pad.
  - `bay_rear_connectors_supported` = for each of those connectors: rib coverage ≥ 50 % of its courtyard length, and distance from its centre to the nearest M3 hole or clamp ≤ 35 mm.
  - If the distance fails, add an M3 hole in the band in board_spec PLACEMENT (B3 rules) and re-run B5–B7.
- [ ] **Step 4: Plug and cable checks.**
  - `pico_usb_plug` at the receptacle. `pico_usb_insert_path_clear` = the plug box swept +z by 30 mm intersects nothing but the lid.
  - For each under-carrier connector, add a cable-stub solid: the connector width, its mated height plus the bend, 15 mm long in its entry direction. `under_carrier_cable_paths_clear` = no stub intersects a non-wire solid.
  - Add the carrier underside lead-tail allowance (2.23 mm under the carrier PCB) as a slab in the clash scan.
- [ ] **Step 5: Build** with `$CADPY cad/build_robot.py > $SP/B8/build.log 2>&1; echo exit $?`. Expected:
  - exit 0;
  - `clash_scan_empty`, the three new keys and the B1 keys all true;
  - printability all-pass;
  - COM nominal and worst case ≤ −15;
  - robot top 155.15.
- [ ] **Step 6: Also do the deferred L2 items.**
  - Lid sector STLs are written bed-ready (skirt up, flat face down).
  - The LD14 lead aperture's warm-air path is counted in the `jetson_cooling` bypass term, or plugged with a printed grommet.
  - Then run `$CADPY cad/rebuild_review.py`.
- [ ] **Step 7: Run the pure tests** with `eval $PURE`. Expected: PASS.
- [ ] **Step 8: Commit** with the message "cad: real 4-layer bay board and modules in the robot, rear support ribs, plug and cable checks (bay B8)" and the Co-Authored-By line.

### Task B9: Harness and BOM

**Files:**
- Modify `cad/build_robot.py`: wire end points from `board_cad.json` connectors; `cable-cut-list.json`.
- Modify `parts-and-connections.json` (R1 root): cable lengths and the BOM.
- Create `pcb/tests/test_harness.py` (pure).

**Interfaces:**
- Consumes: `board_cad.json`, the CAD wires, PICO_GPIO.
- Produces: the final cable cut list and BOM.

**Steps:**
- [ ] **Step 1: Write `test_harness.py` first.**
  - Every connector ref in `EDGE_CONNECTORS` appears in `parts-and-connections.json` with the same part number as PARTS.
  - The Pico pin table equals `PICO_GPIO`.
  - Every `cable-cut-list.json` entry ending at a board connector ends within 10 mm of that connector's position in `board_cad.json`.
  - No BOM line names "D24V50F5", "W_motor" or "E06" for the drivers.
- [ ] **Step 2: Run it to watch it fail.** Run `eval $PURE`.
- [ ] **Step 3: Implement.**
  - Wires read the connector positions from `board_cad.json`.
  - Update the cut lengths in `parts-and-connections.json` (spike §8 table as the check: net about +169 mm).
  - BOM:
    - add M2.5 × 20 mm nylon F-F standoffs ×2, M2.5 × 12 screws ×2, M3 inserts ×4, M3 × 8 screws ×4, the right-angle connectors chosen in B3, printed spacers and ribs;
    - remove the strip spacers, the D24V50F5 and the W_motor parts;
    - fix the driver BOM code (E06 was the old MDD3A).
- [ ] **Step 4: Build and test.**
  ```bash
  $CADPY cad/build_robot.py > $SP/B9/build.log 2>&1; echo exit $?; eval $PURE
  ```
  Expected: exit 0, wire gap check clean, all tests PASS.
- [ ] **Step 5: Commit** with the message "harness: cables and BOM for the bay board (bay B9)" and the Co-Authored-By line.

### Task B10: Simulator sync, bring-up guide, viewer, mapping benchmark

**Files:**
- `$SIM`, after backups to `$SP/backup-original/bay-B10/`: `Scripts/sync_robot_data.py` outputs in `Content/RobotData`, and the Unreal robot refresh.
- Create `$R1/BRINGUP.md`.
- Viewer sources in `$R1/.superpowers/sdd/2026-10-06-r1-low-profile/handoff-scratch/viewer` and `/show`.

**Steps:**
- [ ] **Step 1: Sync the simulator.**
  - Back up `Content/RobotData` and every file the sync writes.
  - Run `$SIM/.venv/bin/python $SIM/Scripts/sync_robot_data.py`. Expected: exit 0, COM guard passes (≤ −15).
  - Run the controller unit tests and the scenarios: `cd $SIM && .venv/bin/python -m unittest discover -s controller/tests` and `tests/scenarios_round.py`. Expected: 166 OK + 1 expected failure (camera re-record), and every scenario PASS.
- [ ] **Step 2: Restart the Unreal editor and the autonomy service.**
  - Tell the user first: "restarting the Unreal editor now for the robot refresh".
  - Start the service with `$SIM/.venv/bin/python` (homebrew python has no cv2).
- [ ] **Step 3: L11 sim carry-overs.**
  - Re-record the 5 camera fixture sets at `camera_mount_m`: bedroom-edges, floor-rejection, floor_parallax, slipper-approach, slipper-side-approach. The expected-failure test then passes and its decorator is removed.
  - RobotPawn inertia from `body_inertia_kg_m2`.
  - LiDAR collision box set to the turret cylinder (160.3 mm box → cylinder).
- [ ] **Step 4: Mapping benchmark.** Run `tests/full_mapping_run.py` + `tests/score_full_mapping.py` in the background. Expected: all 5 rooms ≥ 90 %, the robot reports complete, ≤ 1500 s.
- [ ] **Step 5: Write `BRINGUP.md`.** It covers:
  - Order: reflow SMD → inspect → iron THT, trimming leads ≤ 1.4 mm → modules.
  - Measure the Jetson carrier's underside lead tails and the gap to the tallest under-carrier part before fitting the Jetson. The plan limit is 16.27 mm above the board top.
  - Set the P03 trimpot to 5.1 V before fitting the Jetson.
  - Plug every under-carrier connector (J3, J4, J5, J8–J11, U5A / U5B leads, spares) before fitting the Jetson.
  - Board bring-up with the Jetson off: Pico on USB, rails, LEDs. List the LEDs and test pads under the carrier (from B3).
  - Lid-on tegrastats test, and the 0.5 mm skirt feeler check.
  - Rules: no blind reversing, the circle rule, bumper and cliff behaviour unchanged.
- [ ] **Step 6: Viewer v9.**
  - Rebuild `r1-board.glb.txt` from the routed board: `$KCLI pcb export glb --subst-models --include-tracks --include-pads --include-silkscreen --include-soldermask --user-origin 0x0mm`. Offset it by (BOARD_X0, BOARD_Y0, Z_PCB_BOTTOM), with z 0 at the board bottom, and use the new frame.
  - Place the modules with `show/modules_l5.py`, adapted to the bay pads.
  - Rebuild `r1-robot.glb.txt` with `viewer/compose.py` and keep NVIDIA's full Jetson model.
  - Read artifact `3iX75ZyJSkk9HHurZMSUMp` first, then publish it with its URL.
- [ ] **Step 7: Final check against both specs.** Copy every acceptance line of the bay spec §6 and the low-profile spec §5–§6 into the report, each with its evidence.
- [ ] **Step 8: Commit** with the message "docs: bring-up guide; sim synced for the bay board (bay B10)" and the Co-Authored-By line.

### Task B11: Realistic IMU and odometry errors in the simulator (added 2026-10-09 at the user's request)

**Why:** the simulated gyro is ideal. `Source/HomeRobotSim/RobotPawn.cpp:437` sends the physics body's exact angular velocity: no zero-rate offset, noise, drift or scale error. So the mapping benchmark flatters heading between LiDAR scan matches. The real GY-521 (MPU-6050) has all of those. The robot code has no gyro-bias calibration, because the sim never needed one.

**Files:**
- Create `controller/sim_sensor_model.py`, a simulator-only layer applied where Unreal's raw state enters the controller. `autonomy_service.py` and `robot_client.py` use it; the brain never imports it.
- Create `Content/RobotData/sensor-errors.json`: parameters with datasheet sources, and a seed.
- Modify the robot side (`controller/autonomy/lidar_brain.py`, `localization.py` / `lidar.py`): gyro-bias estimation.
- Add tests under `controller/tests`.

**Steps:**
- [ ] **Step 1: Error model (sim side), seeded and switchable** (`errors: on/off`; default on for benchmarks, off only for exact-regression tests).
  - **Gyro (MPU-6050, ±250 °/s range):**
    - initial zero-rate offset per axis, drawn within ±20 °/s (datasheet ZRO tolerance);
    - a slow warm-up drift (the enclosure heats as the Jetson runs);
    - white noise at 0.005 °/s/√Hz × √(sample rate);
    - scale-factor error ±3 %;
    - cross-axis ±2 %;
    - quantization 1/131 °/s.
  - **Accelerometer:**
    - bias ±50 mg on x/y and ±80 mg on z;
    - noise 400 µg/√Hz;
    - quantization 1/16384 g.
  - **Odometry calibration error:**
    - per-wheel effective radius ±1 %;
    - effective track ±2 %.
    - Wheel slip already comes from the physics: the encoders count wheel rotation relative to the body.
  - Every number has its source in the JSON, marked "datasheet" or "assumed".
- [ ] **Step 2: Robot side.**
  - Estimate the gyro bias at start-up, while stationary (motors off; for example 2–3 s of samples, with the accelerometer and encoders confirming rest).
  - Keep re-estimating it whenever the robot is stationary (zero-velocity updates).
  - Inflate the heading uncertainty growth to match the noise model.
  - **Accelerometer.** Today the robot accepts a gravity sample only if the measured magnitude is within ±0.3 m/s² of 9.8 (`controller/autonomy/lidar_brain.py:468`, `:477`). The MPU-6050's z-axis offset can be up to ±80 mg (±0.78 m/s²), so a real board could fail that gate forever. The attitude would then never initialise, and the robot would stop with "tilted or attitude unknown" (`:1475`). Fix:
    - **Level calibration:** a one-time calibration on a flat floor at bring-up stores per-axis accelerometer offsets on the robot. The sim provides the same calibration file, generated by the same procedure.
    - **Gate:** the gravity gate becomes relative to the calibrated gravity magnitude.
    - **Online offset correction:** the roll/pitch offsets are re-estimated online from the cliff ToF floor plane (`downward_floor_pose`), which already overrides attitude when valid.
    - **Tests** (errors on):
      - attitude initialises;
      - stays within 1° of truth (offline scoring);
      - the tilt stop (> 0.15 rad for 10 s) still fires on a real tilt and never on bias alone.
  - No use of simulator truth.
  - The robot rules stay: no blind reversing, the circle rule, bumper and cliff behaviour.
- [ ] **Step 3: Tests.**
  - The model's statistics match the JSON for the gyro and the accelerometer (bias range, noise density, quantization), with a fixed seed.
  - Bias calibration converges within 0.05 °/s at rest.
  - A turn-in-place heading error stays bounded with errors on.
  - All existing controller tests and `tests/scenarios_round.py` still pass with errors on.
- [ ] **Step 4: Benchmark with errors on.** Run `tests/full_mapping_run.py` + `tests/score_full_mapping.py` in the background.
  - Compare with B10's error-free baseline: coverage per room, time, the heading-error trace (scored against truth, offline only).
  - Acceptance: all 5 rooms ≥ 90 %, complete, ≤ 1500 s.
  - If it fails, improve the robot's estimation. Don't weaken the error model.
- [ ] **Step 5: Report and commit.** Back up `$SIM` files to `$R1/.superpowers/backups/sim/bay-B11/` first (`$SIM` is not git). Commit the R1-side docs, if any, with the Co-Authored-By line.
