liorknafo/home-robot/home-robot-r1/pcb/fab/r1_power_io-bom.csv

Refs | Qty | Fit | Value | MPN | Footprint | Mount | Notes
C2 C4 C5 | 3 | yes | 100nF | Samsung CL21B104KBCNNNC (100 nF 50 V X7R 0805; verify before ordering) | Capacitor_SMD:C_0805_2012Metric | SMD top (reflow)
C3 | 1 | yes | 100uF 16V | Panasonic EEE-FK1C101P (FK, low ESR, 6.3 x 5.8 mm; verify before ordering) | Capacitor_SMD:CP_Elec_6.3x5.8 | SMD top (reflow) | polarised: + on silk; under the IMU module (5.8 mm can, PB16 / PB20)
D1 | 1 | yes | SS14 | Vishay SS14-E3/61T (SMA 40 V 1 A Schottky; verify before ordering) | Diode_SMD:D_SMA | SMD top (reflow) | cathode mark on silk
LED1 LED2 | 2 | yes | green | Lite-On LTST-C171GKT (green 0805; verify before ordering) | LED_SMD:LED_0805_2012Metric | SMD top (reflow) | cathode mark on silk
LED3 | 1 | yes | yellow | Lite-On LTST-C171YKT (yellow 0805; verify before ordering) | LED_SMD:LED_0805_2012Metric | SMD top (reflow) | cathode mark on silk
Q1 Q2 Q3 Q4 Q5 | 5 | yes | 2N7002 | Nexperia 2N7002,215 | Package_TO_SOT_SMD:SOT-23 | SMD top (reflow)
R1 R3 R5 R7 R9 R11 R17 | 7 | yes | 100k | Yageo RC0805FR-07100KL (0805, 1 %, 0.125 W thick film; verify before ordering) | Resistor_SMD:R_0805_2012Metric | SMD top (reflow)
R2 R4 R6 R8 R10 R13 R14 R15 R16 R18 R19 R20 R26 | 13 | yes | 10k | Yageo RC0805FR-0710KL (0805, 1 %, 0.125 W thick film; verify before ordering) | Resistor_SMD:R_0805_2012Metric | SMD top (reflow)
R12 | 1 | yes | 33k | Yageo RC0805FR-0733KL (0805, 1 %, 0.125 W thick film; verify before ordering) | Resistor_SMD:R_0805_2012Metric | SMD top (reflow)
R21 R23 | 2 | yes | 3.3k | Yageo RC0805FR-073K3L (0805, 1 %, 0.125 W thick film; verify before ordering) | Resistor_SMD:R_0805_2012Metric | SMD top (reflow)
R22 | 1 | yes | 1k | Yageo RC0805FR-071KL (0805, 1 %, 0.125 W thick film; verify before ordering) | Resistor_SMD:R_0805_2012Metric | SMD top (reflow)
R24 R25 | 2 | yes | 4.7k | Yageo RC0805FR-074K7L (0805, 1 %, 0.125 W thick film; verify before ordering) | Resistor_SMD:R_0805_2012Metric | SMD top (reflow)
C1 | 1 | yes | 470uF 25V | Panasonic EEU-FR1E471 | Capacitor_THT:CP_Radial_D10.0mm_P5.00mm | THT (iron) | polarised: + on silk
F1 F2 | 2 | yes | ATO fuse holder (FLR) | Littelfuse 178.6165.0001 | Fuse:FuseHolder_Blade_ATO_Littelfuse_FLR_178.6165 | THT (iron) | fuse holder only (the fuses are the plug-in rows: 7.5 A ATO in F1, 5 A ATO in F2); the KiCad footprint gives PCB <= 1.5 mm for its snap lock, this board is 1.6 mm: hold it flat and solder all 8 pins
J1 | 1 | yes | Battery in | AMASS XT30UPB-M (XT30 vertical PCB male, 2-pin, 15 A continuous; LCSC C428721; verify before ordering) | Connector_AMASS:AMASS_XT30UPB-M_1x02_P5.0mm_Vertical | THT (iron) | battery: pin 1 = GND, pin 2 = BAT+ (PB20; silk - / +): the battery lead GND in cavity 1
J2 | 1 | yes | Master rocker | JST B2P-VH(LF)(SN) | Connector_JST:JST_VH_B2P-VH_1x02_P3.96mm_Vertical | THT (iron)
J3 | 1 | yes | Jetson 5V | Molex 43650-0200 (Micro-Fit 3.0 1x2 right-angle THT header with peg, 8.5 A/circuit on 18 AWG; verify before ordering) | Connector_Molex:Molex_Micro-Fit_3.0_43650-0200_1x02_P3.00mm_Horizontal | THT (iron)
J4 J5 | 2 | yes | Left motor / Right motor | Amphenol 68016-106HLF (1x6 2.54 mm right-angle pin header; verify before ordering) | Connector_PinHeader_2.54mm:PinHeader_1x06_P2.54mm_Horizontal | THT (iron) | right-angle: the C18 pigtail socket lies on the board (PB25)
J6 J7 J8 J9 | 4 | yes | Cliff 1 / Cliff 2 / Cliff 3 / Cliff 4 | JST B5B-XH-A(LF)(SN) | Connector_JST:JST_XH_B5B-XH-A_1x05_P2.50mm_Vertical | THT (iron)
J10 J11 J12 J13 | 4 | yes | Bumper L / Bumper R / Arm button / Motor toggle loop | JST B2B-XH-A(LF)(SN) | Connector_JST:JST_XH_B2B-XH-A_1x02_P2.50mm_Vertical | THT (iron)
K1 | 1 | yes | G5LE-1 DC5 | Omron G5LE-1 DC5 | Relay_THT:Relay_SPDT_Omron-G5LE-1 | THT (iron)
U1A U1B | 2 | yes | Pico left row / Pico right row | Sullins PPTC201LFBN-RC (1x20 2.54 mm female socket, 8.5 mm body; verify before ordering) | Connector_PinSocket_2.54mm:PinSocket_1x20_P2.54mm_Vertical | THT (iron)
U2 | 1 | yes | GY-521 MPU-6050 | Sullins PPTC081LFBN-RC (1x8 2.54 mm female socket, 8.5 mm body; verify before ordering) | Connector_PinSocket_2.54mm:PinSocket_1x08_P2.54mm_Vertical | THT (iron)
U3L U3P U4L U4P | 4 | yes | DRV8874 left, VM/EN/PH row / DRV8874 left, VIN/OUT row / DRV8874 right, VM/EN/PH row / DRV8874 right, VIN/OUT row | Sullins PPTC071LFBN-RC (1x7 2.54 mm female socket, 8.5 mm body; verify before ordering) | Connector_PinSocket_2.54mm:PinSocket_1x07_P2.54mm_Vertical | THT (iron)
U5A U5B | 2 | yes | Regulator in (P03 module) / Regulator out (P03 module) | Phoenix Contact 1715721 (MKDS 1,5/ 2-5,08; verify before ordering) | TerminalBlock_Phoenix:TerminalBlock_Phoenix_MKDS-1,5-2-5.08_1x02_P5.08mm_Horizontal | THT (iron)
D2 | 1 | DNP | SS14 | Vishay SS14-E3/61T (SMA 40 V 1 A Schottky; verify before ordering) | Diode_SMD:D_SMA | SMD top (reflow) | DNP (LIO-226): 5V to the Pico's VSYS, fit it to run the Pico and 3V3 without the Jetson USB (BRINGUP.md section 4 item 2); under the DRV_R carrier; cathode mark on silk
J14 | 1 | DNP | Spare I2C |  | Connector_PinHeader_2.54mm:PinHeader_1x04_P2.54mm_Vertical | THT (iron) | DNP spare pad row (PB8); a bare 1x4 2.54 mm header may be fitted later (<= 8.5 mm tall)
J15 | 1 | DNP | Spare GPIO |  | Connector_PinHeader_2.54mm:PinHeader_1x06_P2.54mm_Vertical | THT (iron) | DNP spare pad row (PB8); a bare 1x6 2.54 mm header may be fitted later (<= 8.5 mm tall)
TP1 TP2 TP3 TP4 TP5 | 5 | no part | VBAT_SW / VMOT / 5V / 3V3 / GND |  | TestPoint:TestPoint_Pad_D2.0mm | SMD top (reflow) | bare copper test pad, no part
H1 H2 H3 H4 | 4 | no part | M3 |  | MountingHole:MountingHole_3.2mm_M3_Pad_Via | THT (iron) | plated M3 mounting hole (GND ring), no part
H5 H6 | 2 | no part | M2.5 clamp |  | MountingHole:MountingHole_3mm | THT (iron) | M2.5 clamp hole (NPTH, PB3), no part
 | 1 | plug-in | Raspberry Pi Pico (RP2040), owned (E02), with 2.54 mm male headers soldered on by the user | Raspberry Pi SC0915 (bare Pico, no headers; owned, E02; solder two 1x20 male strips before it goes in the sockets) |  | plugs in | into U1A, U1B
 | 2 | plug-in | DRV8874 single brushed DC motor driver carrier | Pololu 4035 |  | plugs in | into U3L, U3P, U4L, U4P
 | 1 | plug-in | GY-521 MPU-6050 IMU module | HiLetgo GY-521 (owned, E03) |  | plugs in | into U2
 | 1 | plug-in | P03 adjustable 5 V buck module, leads to the terminals | P03 (owned; set 5.1 V on the bench first) |  | plugs in | into U5A, U5B
 | 1 | plug-in | ATO blade fuse 7.5 A (main) | Littelfuse 0287007.PXCN (ATO 7.5 A; verify before ordering) |  | plugs in | into F1
 | 1 | plug-in | ATO blade fuse 5 A (motor branch) | Littelfuse 0287005.PXCN (ATO 5 A; verify before ordering) |  | plugs in | into F2
