liorknafo/home-robot/home-robot-r1/pcb/fab/r1_power_io.step

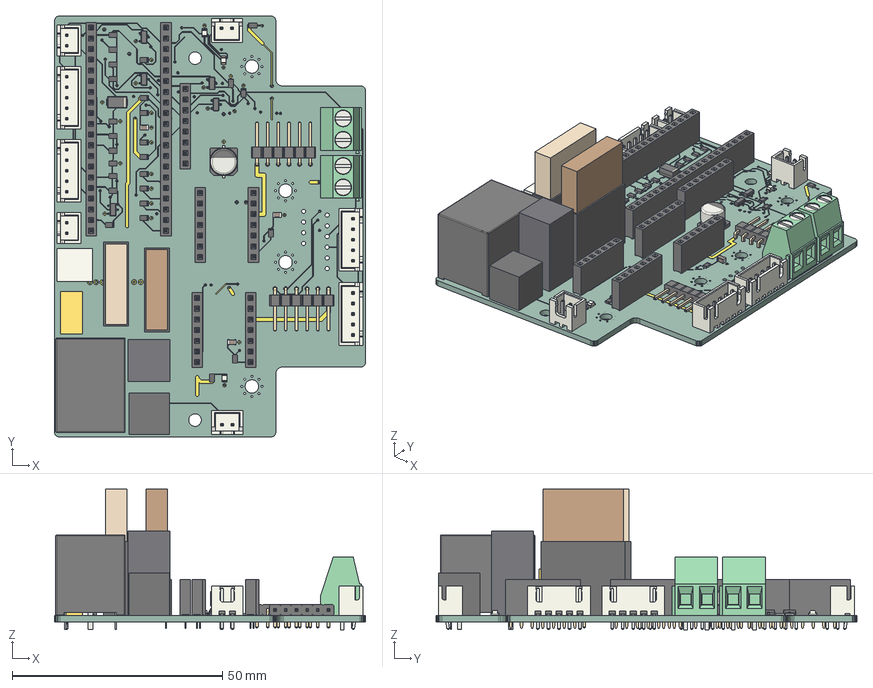
[picture p3: CAD file, 2026-10-21]
home-robot-r1/pcb/fab/r1_power_io.step
73.9 x 100.0 x 33.5 mm
LED_0805_2012Metric x 3
R_0805_2012Metric x 26
TerminalBlock_Phoenix_MKDS-1,5-2-5.08_1x02_P5.08mm_Horizontal x 2
J2_envelope
SOT-23 x 5
JST_XH_B2B-XH-A_1x02_P2.50mm_Vertical x 4
CP_Elec_6.3x5.8
JST_XH_B5B-XH-A_1x05_P2.50mm_Vertical x 4
C_0805_2012Metric x 3
PinSocket_1x07_P2.54mm_Vertical x 4
PinSocket_1x20_P2.54mm_Vertical x 2
J1_envelope
Relay_SPDT_Omron-G5LE-1
F2_envelope
C1_envelope
F1_envelope
PinHeader_1x06_P2.54mm_Horizontal x 2
PinSocket_1x08_P2.54mm_Vertical
J3_envelope
D_SMA
r1_power_io_copper
r1_power_io_via
r1_power_io_PCB
