liorknafo/home-robot/home-robot-r1/print-parts/coupons/P_coupon.step

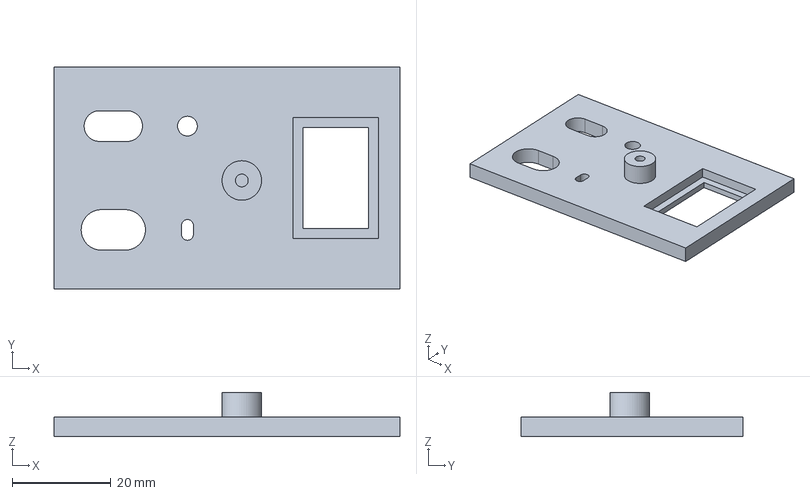
[picture p4: CAD file, 2026-10-12]
home-robot-r1/print-parts/coupons/P_coupon.step
70.0 x 45.0 x 9.00 mm
