liorknafo/home-robot/home-robot-r1/print-parts/P_bumper_right.step

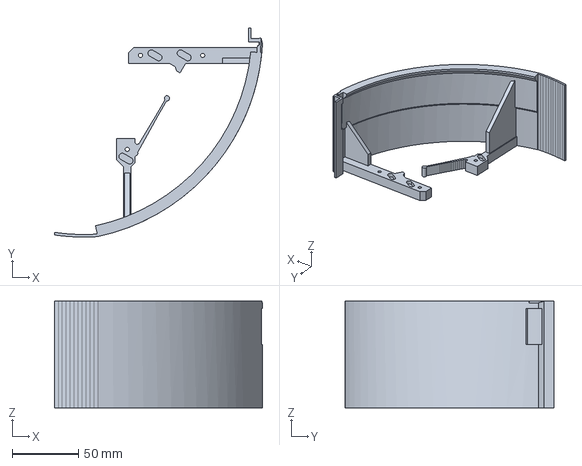
[picture p5: CAD file, 2026-10-17]
home-robot-r1/print-parts/P_bumper_right.step
157.2 x 158.1 x 80.5 mm
