liorknafo/home-robot/home-robot-r1/print-parts/P_rear_shell_right.step

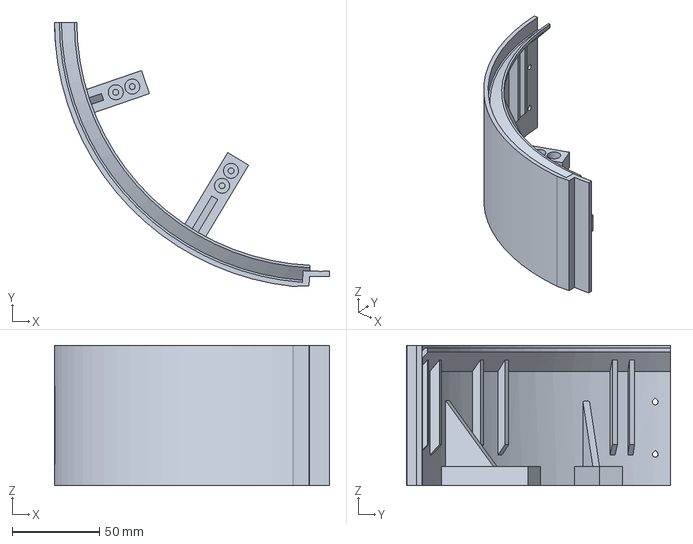
[picture p6: CAD file, 2026-10-17]
home-robot-r1/print-parts/P_rear_shell_right.step
157.6 x 151.2 x 80.5 mm
