liorknafo/home-robot/home-robot-r1/print-parts/P_lid_post_3.step

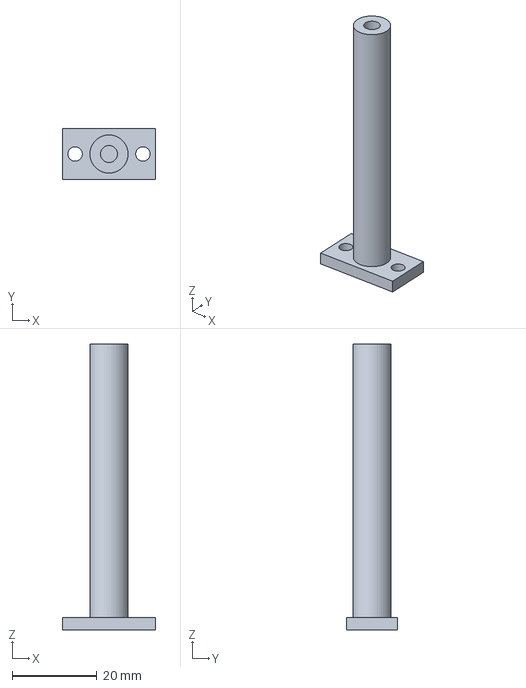
[picture p7: CAD file, 2026-10-17]
home-robot-r1/print-parts/P_lid_post_3.step
22.0 x 12.0 x 67.5 mm
