liorknafo/home-robot/home-robot-r1/print-parts/P_bumper_rider_left_A.step

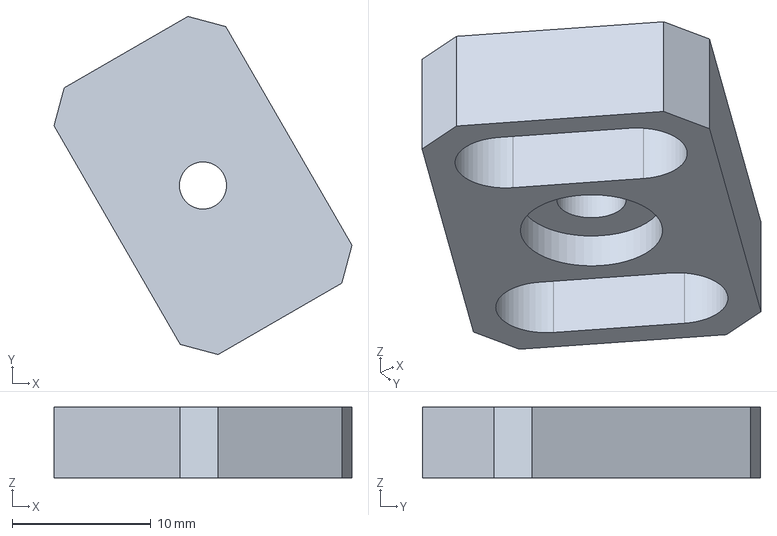
[picture p8: CAD file, 2026-10-17]
home-robot-r1/print-parts/P_bumper_rider_left_A.step
21.5 x 24.4 x 5.10 mm
