liorknafo/home-robot/home-robot-r1/print-parts/bay_clamp_spacer_1.step

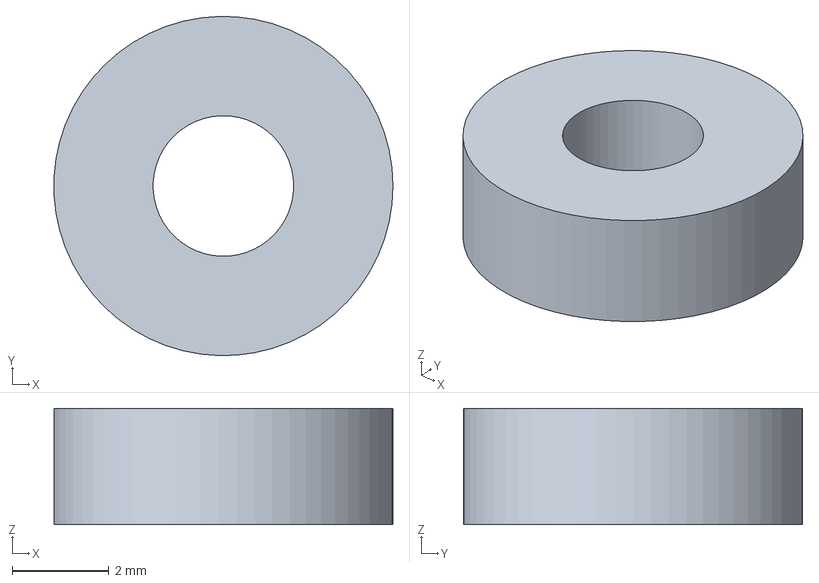
[picture p9: CAD file, 2026-10-17]
home-robot-r1/print-parts/bay_clamp_spacer_1.step
7.00 x 7.00 x 2.40 mm
