liorknafo/home-robot/home-robot-r1/print-parts/P_cliff_mount_4.step

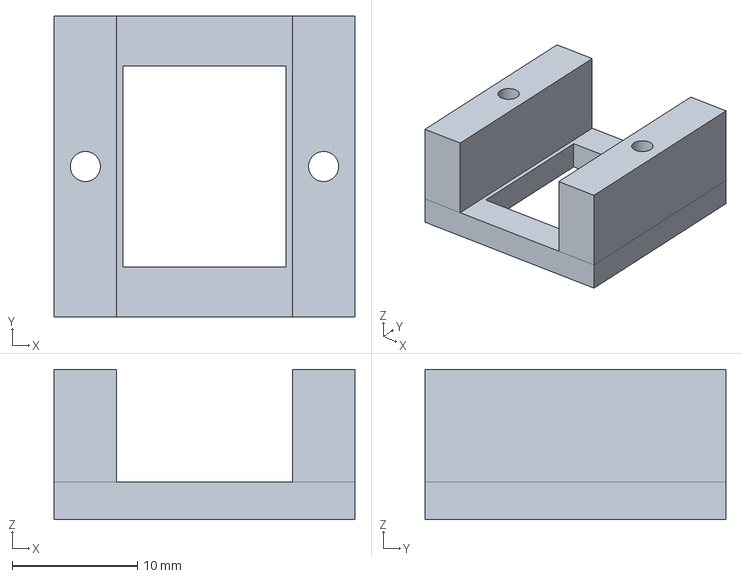
[picture p10: CAD file, 2026-10-17]
home-robot-r1/print-parts/P_cliff_mount_4.step
24.0 x 24.0 x 12.0 mm
