liorknafo/home-robot/home-robot-r1/print-parts/P_cliff_mount_2.step

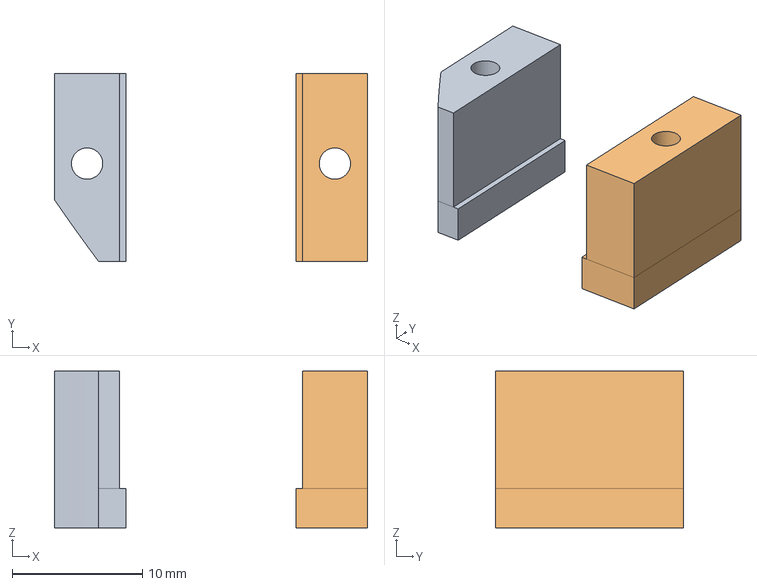
[picture p11: CAD file, 2026-10-17]
home-robot-r1/print-parts/P_cliff_mount_2.step
24.0 x 14.4 x 12.0 mm
