liorknafo/home-robot/home-robot-r1/print-parts/P_lid_front.step

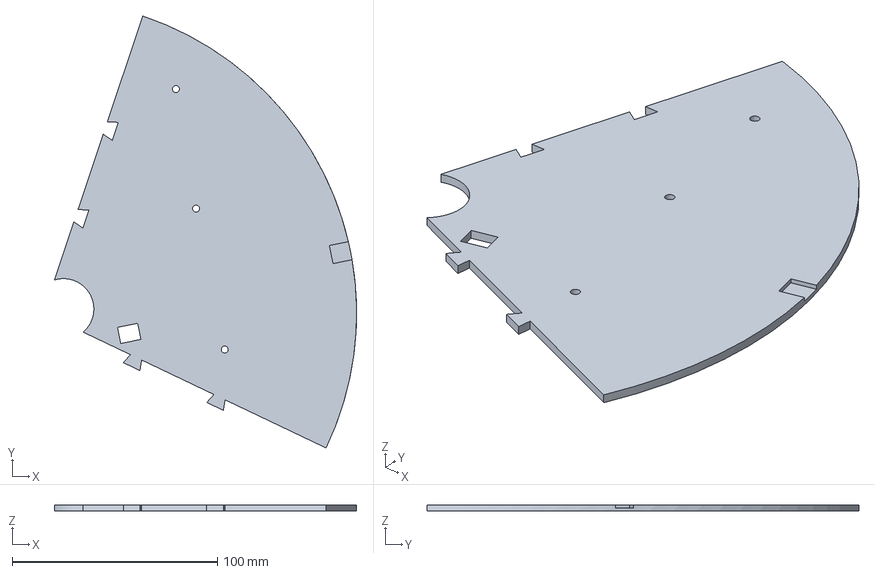
[picture p12: CAD file, 2026-10-17]
home-robot-r1/print-parts/P_lid_front.step
147.1 x 210.3 x 3.00 mm
