liorknafo/home-robot/home-robot-r1/print-parts/bay_rib_0.step

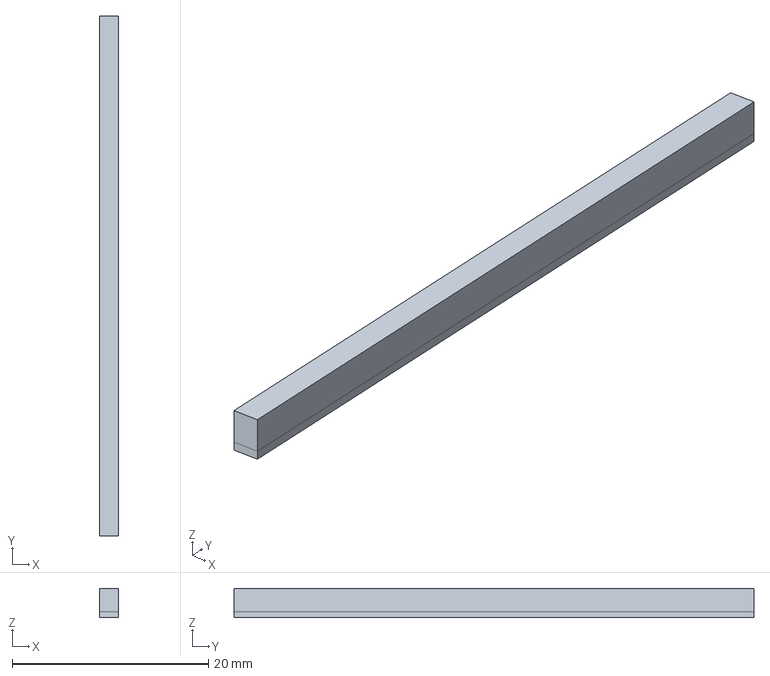
[picture p13: CAD file, 2026-10-17]
home-robot-r1/print-parts/bay_rib_0.step
1.95 x 53.0 x 3.00 mm
