liorknafo/home-robot/home-robot-r1/print-parts/P_lid_right.step

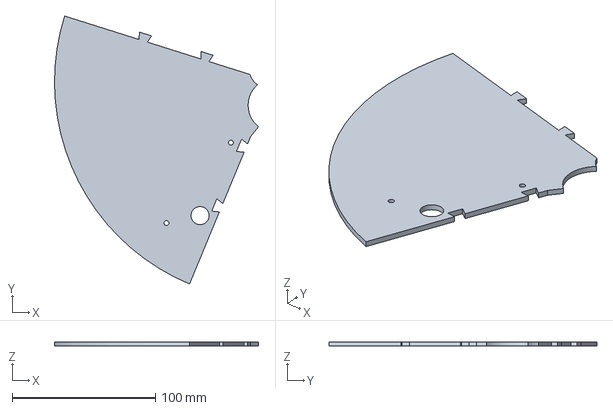
[picture p14: CAD file, 2026-10-17]
home-robot-r1/print-parts/P_lid_right.step
142.2 x 186.7 x 3.00 mm
