liorknafo/home-robot/home-robot-r1/print-parts/P_camera_led_shelf.step

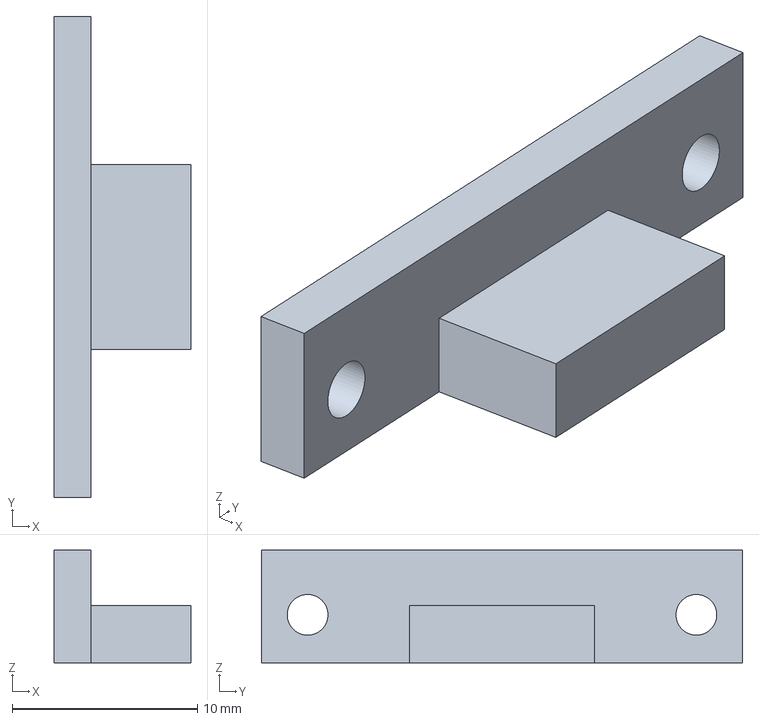
[picture p15: CAD file, 2026-10-17]
home-robot-r1/print-parts/P_camera_led_shelf.step
7.40 x 26.0 x 6.10 mm
