liorknafo/home-robot/home-robot-r1/print-parts/P_base.step

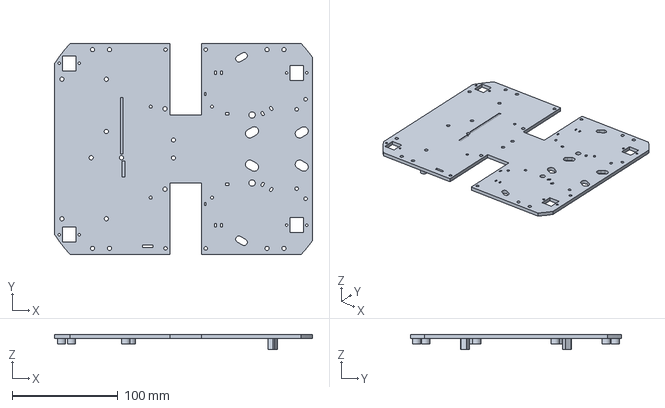
[picture p16: CAD file, 2026-10-13]
home-robot-r1/print-parts/P_base.step
244.0 x 200.0 x 14.5 mm
