liorknafo/home-robot/home-robot-r1/print-parts/P_lidar_tray.step

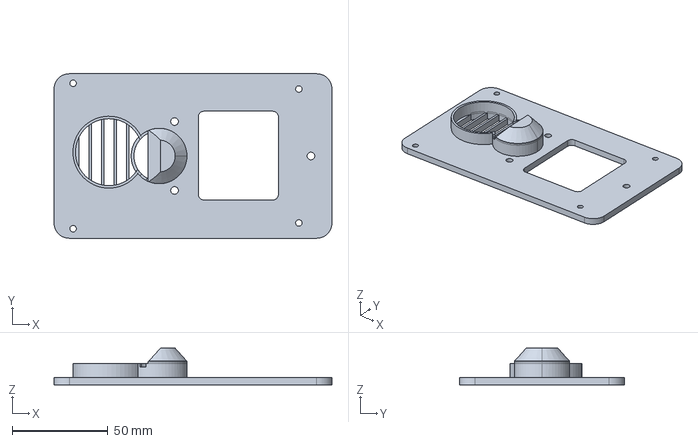
[picture p17: CAD file, 2026-10-13]
home-robot-r1/print-parts/P_lidar_tray.step
145.3 x 86.0 x 19.2 mm
