liorknafo/home-robot/home-robot-r1/print-parts/P_lidar_adapter_clip.step

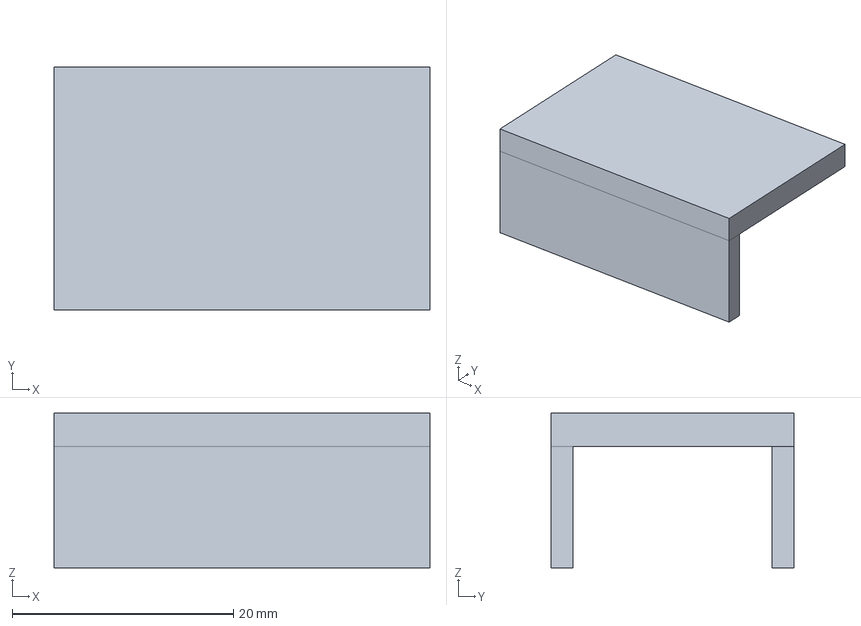
[picture p18: CAD file, 2026-10-12]
home-robot-r1/print-parts/P_lidar_adapter_clip.step
34.0 x 22.0 x 14.0 mm
