liorknafo/home-robot/home-robot-r1/print-parts/P_bumper_left.step

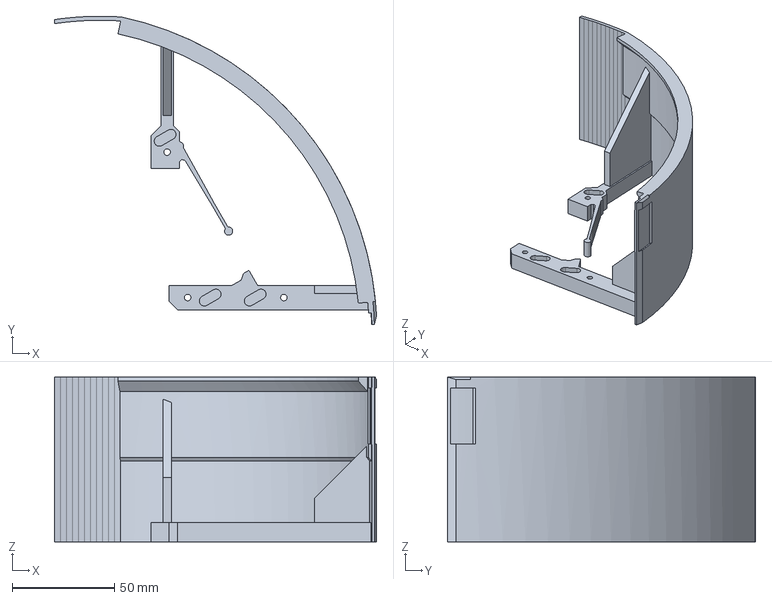
[picture p19: CAD file, 2026-10-12]
home-robot-r1/print-parts/P_bumper_left.step
157.2 x 150.6 x 80.5 mm
