liorknafo/home-robot/home-robot-r1/print-parts/bay_rib_1.step

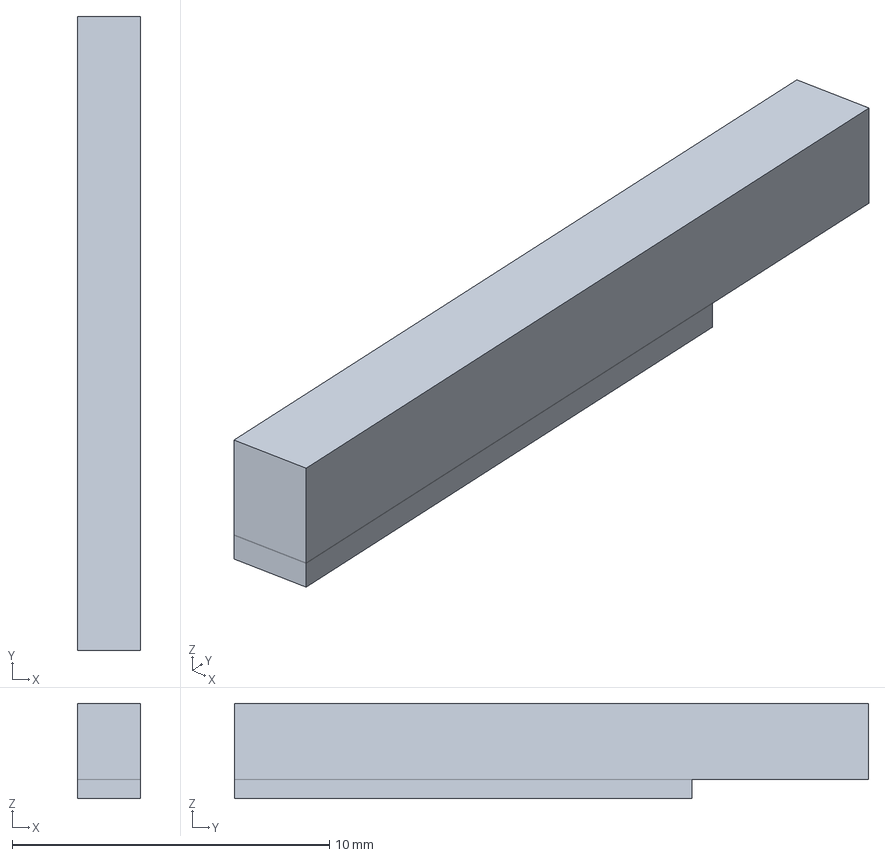
[picture p20: CAD file, 2026-10-12]
home-robot-r1/print-parts/bay_rib_1.step
2.00 x 20.0 x 3.00 mm
