liorknafo/home-robot/home-robot-r1/print-parts/P_rear_shell_left.step

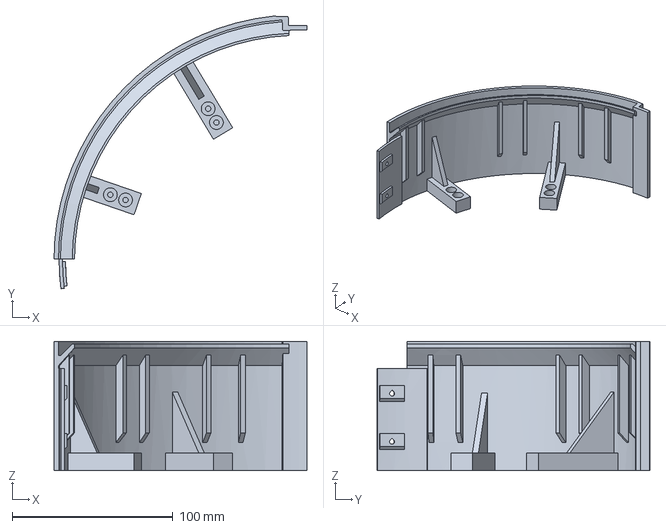
[picture p21: CAD file, 2026-10-12]
home-robot-r1/print-parts/P_rear_shell_left.step
157.6 x 169.9 x 80.5 mm
