liorknafo/home-robot/home-robot-r1/print-parts/P_battery_tray.step

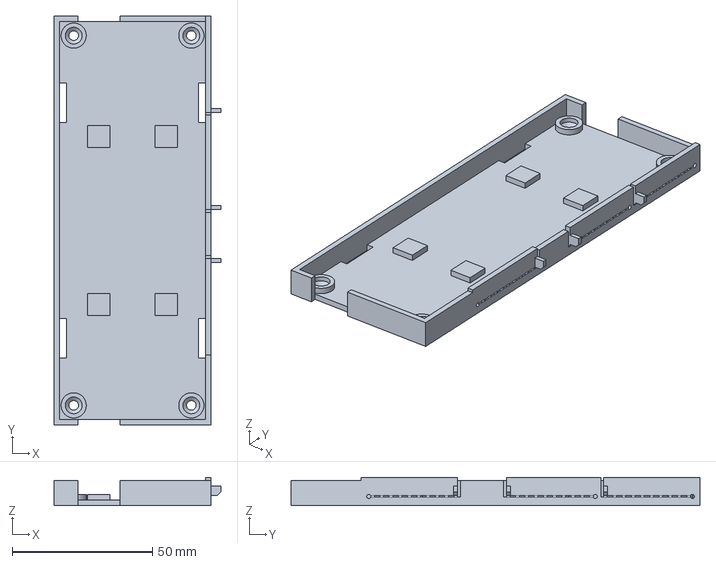
[picture p22: CAD file, 2026-10-12]
home-robot-r1/print-parts/P_battery_tray.step
59.5 x 146.0 x 10.0 mm
