liorknafo/home-robot/home-robot-r1/print-parts/P_ld14_grommet.step

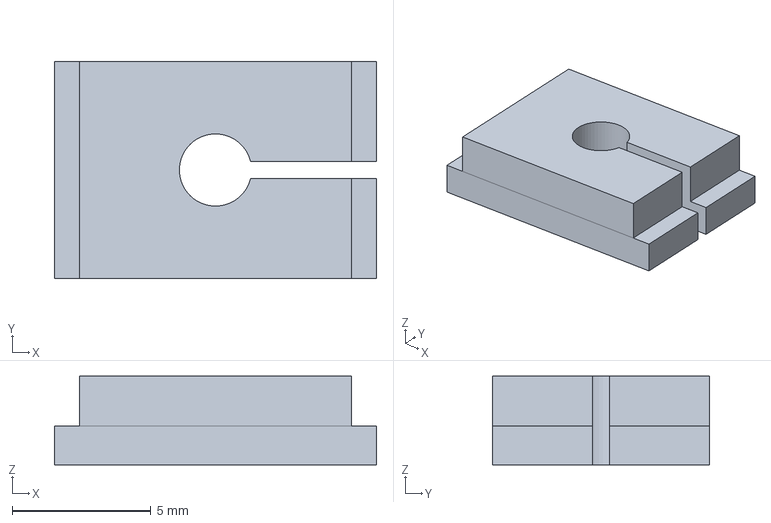
[picture p23: CAD file, 2026-10-12]
home-robot-r1/print-parts/P_ld14_grommet.step
11.6 x 7.80 x 3.20 mm
