liorknafo/home-robot/home-robot-r1/print-parts/P_camera_mount.step

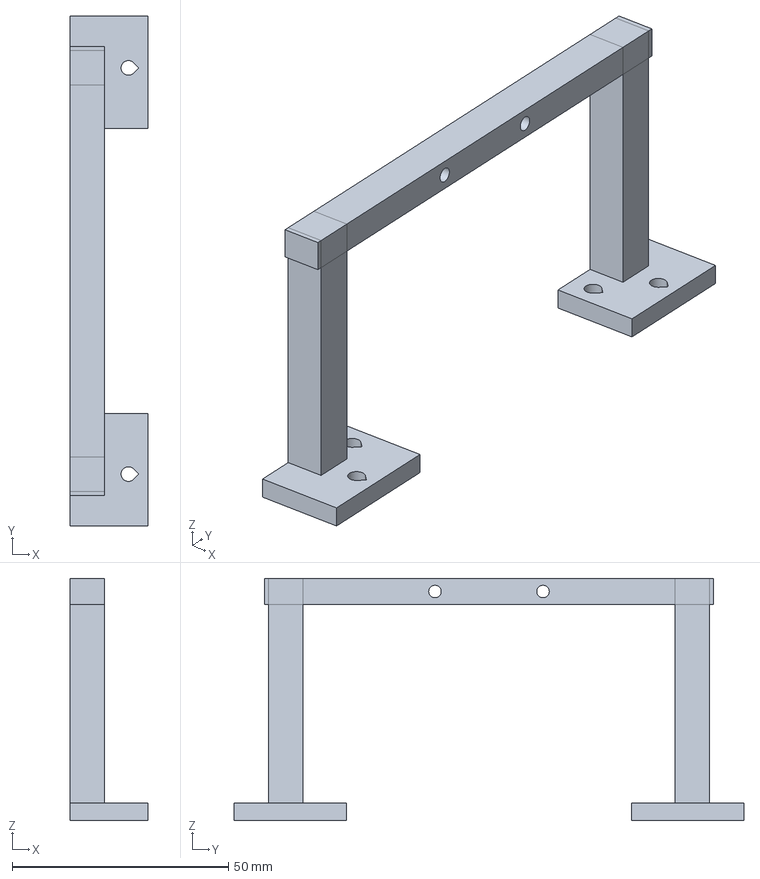
[picture p24: CAD file, 2026-10-12]
home-robot-r1/print-parts/P_camera_mount.step
18.0 x 118.0 x 56.0 mm
