liorknafo/home-robot/home-robot-r1/print-parts/P_lid_rear.step

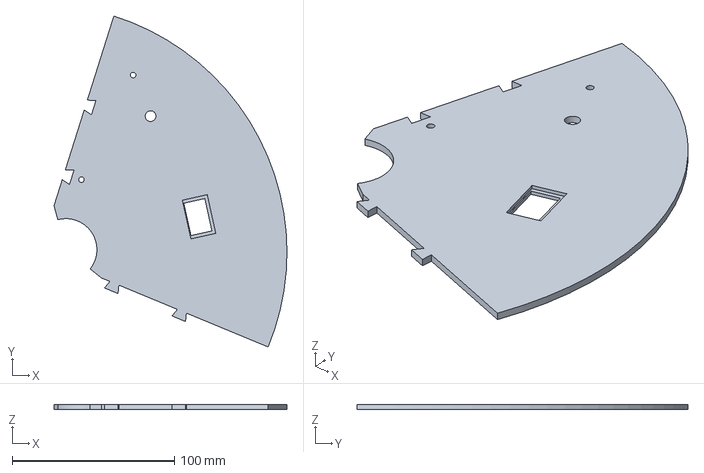
[picture p25: CAD file, 2026-10-12]
home-robot-r1/print-parts/P_lid_rear.step
143.5 x 203.8 x 3.00 mm
