liorknafo/home-robot/home-robot-r1/print-parts/P_motor_mount_right.step

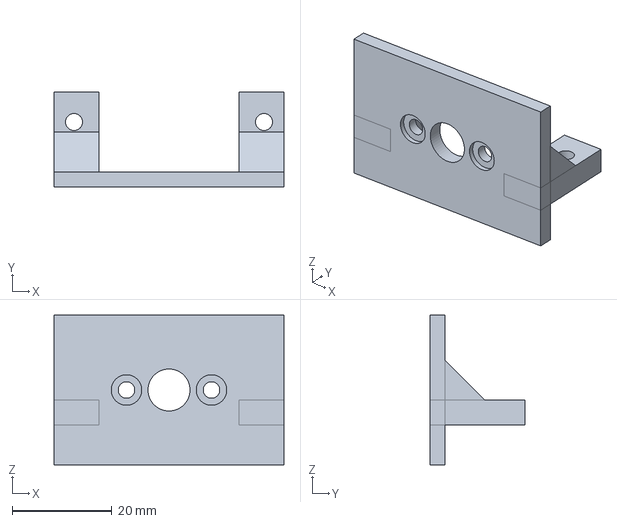
[picture p26: CAD file, 2026-10-12]
home-robot-r1/print-parts/P_motor_mount_right.step
46.0 x 19.0 x 30.0 mm
