liorknafo/home-robot/home-robot-r1/print-parts/P_camera_holder.step

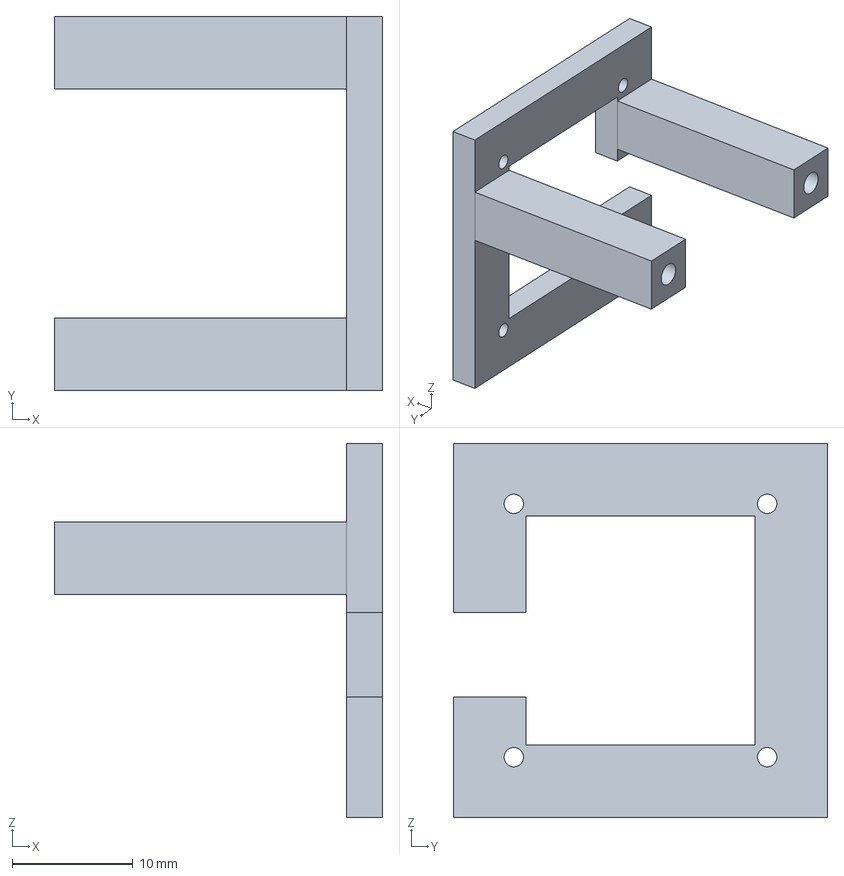
[picture p27: CAD file, 2026-10-12]
home-robot-r1/print-parts/P_camera_holder.step
27.2 x 31.0 x 31.0 mm
