liorknafo/home-robot/home-robot-r1/print-parts/P_camera_tower.step

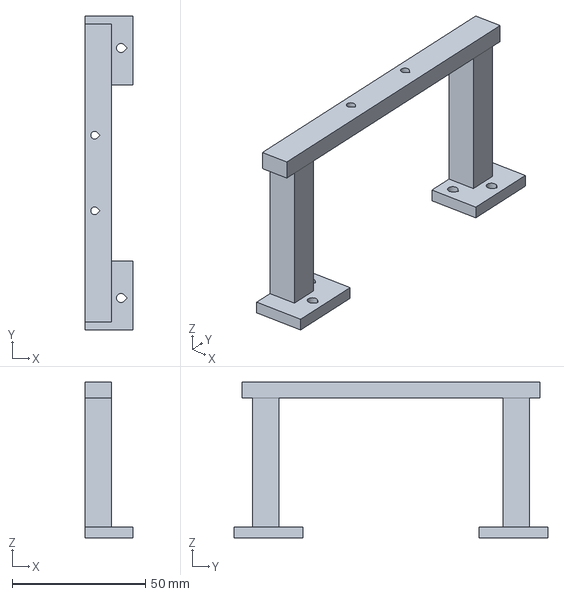
[picture p28: CAD file, 2026-10-09]
home-robot-r1/print-parts/P_camera_tower.step
18.0 x 118.0 x 58.5 mm
