liorknafo/home-robot/home-robot-r1/print-parts/P_camera_guard.step

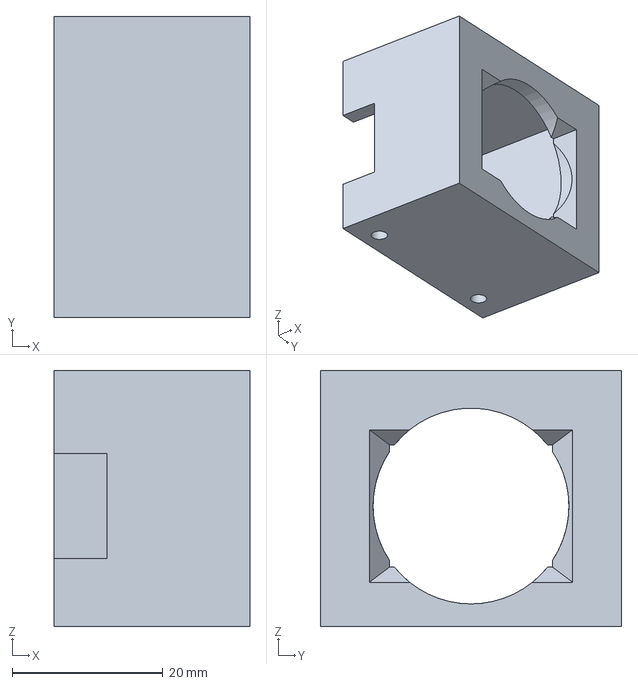
[picture p29: CAD file, 2026-10-09]
home-robot-r1/print-parts/P_camera_guard.step
26.0 x 40.0 x 34.0 mm
