liorknafo/home-robot/(list of files, cad)

Other CAD files:
home-robot-r1/print-parts/P_bumper_rider_left_B.step
home-robot-r1/print-parts/P_bumper_rider_left_C.step
home-robot-r1/print-parts/P_lid_post_2.step
home-robot-r1/print-parts/bay_spacer_0.step
home-robot-r1/print-parts/P_lid_post_4.step
home-robot-r1/print-parts/bay_spacer_3.step
home-robot-r1/print-parts/bay_clamp_spacer_3.step
home-robot-r1/print-parts/P_lid_post_1.step
home-robot-r1/print-parts/bay_spacer_1.step
home-robot-r1/print-parts/P_lid_left.step
home-robot-r1/print-parts/P_bumper_rider_right_B.step
home-robot-r1/print-parts/bay_spacer_2.step
home-robot-r1/print-parts/P_bumper_rider_right_A.step
home-robot-r1/print-parts/P_cliff_mount_1.step
home-robot-r1/print-parts/P_bumper_rider_right_C.step
home-robot-r1/print-parts/P_cliff_mount_3.step
home-robot-r1/print-parts/P_motor_mount_left.step
home-robot-r1/print-parts/P_base.stl
home-robot-r1/print-parts/P_battery_tray.stl
home-robot-r1/print-parts/P_bumper_left.stl
home-robot-r1/print-parts/P_bumper_rider_left_A.stl
home-robot-r1/print-parts/P_bumper_rider_left_B.stl
home-robot-r1/print-parts/P_bumper_rider_left_C.stl
home-robot-r1/print-parts/P_bumper_rider_right_A.stl
home-robot-r1/print-parts/P_bumper_rider_right_B.stl
home-robot-r1/print-parts/P_bumper_rider_right_C.stl
home-robot-r1/print-parts/P_bumper_right.stl
home-robot-r1/print-parts/P_camera_guard.stl
home-robot-r1/print-parts/P_camera_holder.stl
home-robot-r1/print-parts/P_camera_led_shelf.stl
home-robot-r1/print-parts/P_camera_mount.stl
home-robot-r1/print-parts/P_camera_tower.stl
home-robot-r1/print-parts/P_cliff_mount_1.stl
home-robot-r1/print-parts/P_cliff_mount_2.stl
home-robot-r1/print-parts/P_cliff_mount_3.stl
home-robot-r1/print-parts/P_ld14_grommet.stl
home-robot-r1/print-parts/P_lid_front.stl
home-robot-r1/print-parts/P_lid_left.stl
home-robot-r1/print-parts/P_lid_post_2.stl
home-robot-r1/print-parts/P_lid_post_4.stl
home-robot-r1/print-parts/P_lid_rear.stl
home-robot-r1/print-parts/P_lid_right.stl
home-robot-r1/print-parts/P_lidar_adapter_clip.stl
home-robot-r1/print-parts/P_lidar_tray.stl
home-robot-r1/print-parts/P_motor_mount_left.stl
home-robot-r1/print-parts/P_motor_mount_right.stl
home-robot-r1/print-parts/P_rear_shell_left.stl
home-robot-r1/print-parts/P_rear_shell_right.stl
home-robot-r1/print-parts/bay_clamp_spacer_1.stl
home-robot-r1/print-parts/bay_rib_0.stl
home-robot-r1/print-parts/bay_rib_1.stl
home-robot-r1/print-parts/bay_spacer_1.stl
home-robot-r1/print-parts/bay_spacer_2.stl
home-robot-r1/print-parts/coupons/P_coupon.stl
home-robot-sim/Blender/furnished-apartment.blend
