liorknafo/home-robot/home-robot-r1/revised-wiring-view.png

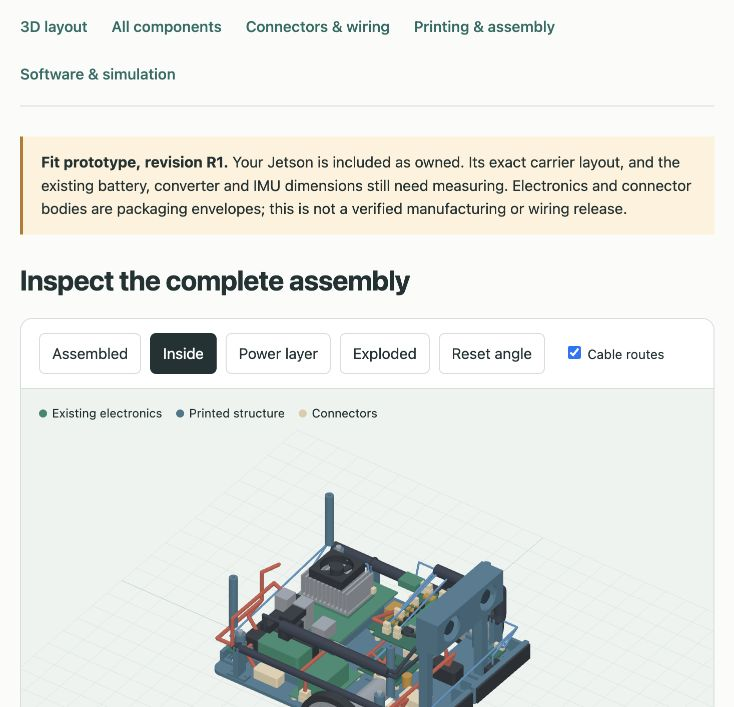
home-robot-r1/revised-wiring-view.png
