liorknafo/home-robot/home-robot-r1/robot-assembled.png

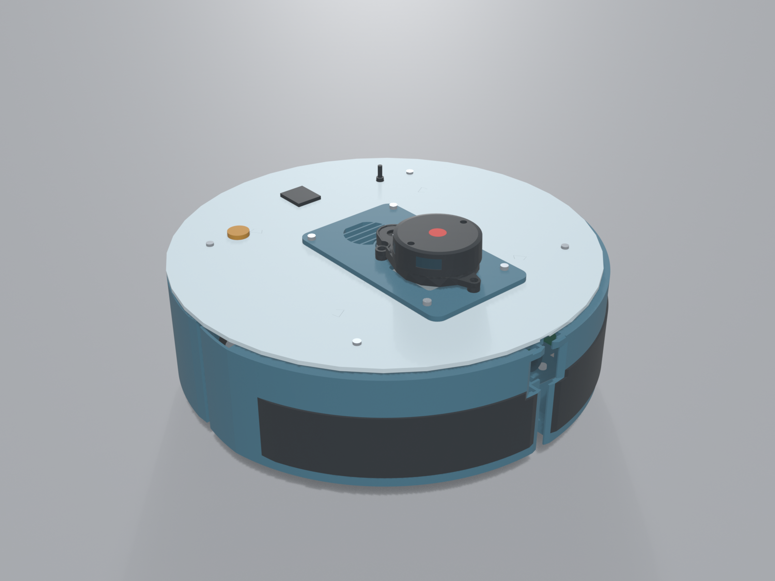
home-robot-r1/robot-assembled.png
