liorknafo/home-robot/home-robot-sim/tests/fixtures/threshold-offset/README.md

# Threshold offset fixture (task R, LIO-153)

Cut by `tests/cut_tv_console_fixture.py --threshold` from Unreal trial `full-mapping-20261013T023710` (task R trial 2): a reference map of the scans before 945 s at their true poses, and 6 level scans of 951.2-952.0 s just after the robot came down the 10 mm threshold (re-cast from the true pose). See `cut_threshold`.
