liorknafo/home-robot/home-robot-sim/tests/fixtures/tv-console-tilt/README.md

# TV console tilt fixture (task R, LIO-153)

Cut by `tests/cut_tv_console_fixture.py` from Unreal trial `full-mapping-20261013T010812` (task Q trial 2): the LiDAR re-cast from the evaluation-only true pose, pitch and roll (tests/replay_unreal_lidar.py), the localizer map as its own mapping loop had built it by 102.3 s, and 53 scans of 102.3-112.0 s while the robot turned in place tilted on the living rug's edge next to the TV console. See the script's docstring.
