liorknafo/home-robot/home-robot-r1/BRINGUP.md

# R1 bring-up guide (bay board under the Jetson)

How to solder, check, fit and first power the R1 power & I/O board (the 4-layer "bay board"), and the checks to make before the Jetson
and the lid go on.

**Where the numbers come from.** Written for commit 76232c4 (bay B10); the power connectors, the power rules and the assembly numbers
updated in bay B12a.
- The assembly order is `ASSY_ORDER` in `cad/build_robot.py`. Its resolved text is in `cad/component-manifest.json` (the `bay_board`
  note) and `design-review.html`. If this guide and `ASSY_ORDER` ever disagree, `ASSY_ORDER` wins. Section 6 follows its numbering.
- Soldering and ordering: `pcb/fab/ORDERING.md`.
- The firmware and board notes from B7 (`pcb/fab/BRINGUP-NOTES.md`) are folded in here.
- Heights and clearances: `cad/validation.json`.
- Part positions: `pcb/board_cad.json`, generated from the routed board. They are in robot coordinates (mm): x forward, y left, the
  board top at z 37.0.

---

## 0. Before anything: the battery connector J1 and the power rules

> **J1 pin 1 = GND, pin 2 = BAT+** (silk "−" and "+" beside each pin, on the side toward the fuses: the housing covers the pin ends;
> ruling PB20). This is the reverse of the usual "pin 1 = +" habit.
>
> **J1 is an XT30 header:** the AMASS XT30UPB-M, a vertical PCB-mount male rated 15 A continuous, on the board's rear edge. It is
> plugged from above with the lid off. The battery lead W01 runs from the battery's Tamiya plug, on 18 AWG silicone wire (red BAT+,
> black GND), to an AMASS XT30U-F (the female half). The XT30 housing is D-shaped, so it mates only one way round. The lead must carry:
> - **BAT+ (battery +, red) on the XT30U-F's "+" contact** (cavity 2), which mates J1 pin 2;
> - **GND (battery −, black) on its "−" contact** (cavity 1), which mates J1 pin 1.
>
> The D shape stops the plug going in the wrong way round. It does not stop a lead with its two wires soldered the wrong way round, so
> the meter check below still applies.
>
> **Three connector families: no lead fits a wrong header.** J1 (battery) is an XT30, J2 (rocker) a JST VH, J3 (Jetson 5 V) a Molex
> Micro-Fit 3.0. Tag each lead anyway, with a heat-shrink label near its plug: "J1 BATT", "J2 ROCKER", "J3 JETSON 5V".
>
> **The board has no reverse-polarity protection.** A reversed lead with the fuses fitted puts the battery backwards across the whole
> board. That is the costliest mistake you can make on it.
>
> **Fail-safe meter check, before the fuses ever go in** (ASSY step 0):
> 1. Leave F1 and F2 out.
> 2. Plug W01 into J1 and into the battery.
> 3. Measure **F1's input clip** (its BAT+ side, F1 pin 1) against GND. For GND, use an M3 hole ring (H1–H4), or TP5 if the GY-521 is
>    not yet plugged in (TP5 sits under it).
> 4. It must read **positive, about the pack voltage (≥ 6 V)**. A part-discharged pack reads lower.
> 5. A negative reading means the lead is reversed. With the fuses out, it has no current path: unplug it and swap the two wires at
>    the XT30U-F.
>
> Only after a positive reading may the fuses go in. **Fit a fuse only with the rocker off:** F1 first, F2 last (section 7, steps 1
> and 5).
>
> **The same check for the Jetson lead W04, before it ever touches the Jetson** (after section 7 step 3, with the P03 set and
> checked). The Micro-Fit only mates one way round, but its two crimps can still sit in the wrong cavities:
> 1. Plug W04 into J3. Leave its barrel plug free (not in the Jetson).
> 2. Rocker on. Measure the barrel plug's **centre against its sleeve**: it must read **positive, about 5.1 V**.
> 3. A negative reading means the crimps are swapped: rocker off, unplug W04, swap the two crimps in the receptacle.
>
> **Everyday rule:** switch the rocker off before you plug or unplug the battery, and shut the Jetson down before you switch the
> rocker off.

---

## 1. Solder the board

Order: **reflow SMD → inspect → iron THT, trimming leads to ≤ 1.4 mm → modules.** `pcb/fab/ORDERING.md` "Assembly" gives the full text.

1. **Reflow the SMD parts, top side only.** Tape the board down and print paste through the stencil. Place C2–C5, D1, Q1–Q5,
   LED1–LED3 and R1–R26, following the polarity marks on the silk: the LED and D1 cathode marks, SOT-23 pin 1 and C3 "+". Reflow on a
   hot plate or in an oven. TP1–TP5 stay bare copper, and D2 stays empty (DNP: section 4 item 2).
2. **Inspect.**
   - Look for bridges on the SOT-23 and 0805 parts, and re-check the polarity marks.
   - Check the GND joints for solder wicking into the tented vias beside them. The mask web there is only about 0.15 mm.
3. **Iron the THT parts, lowest first:**
   - the sockets U1A / U1B, U2, U3L / U3P, U4L / U4P;
   - the connectors: the XH headers, the VH (J2), the XT30 (J1) and the Micro-Fit (J3; push its plastic peg through its hole);
   - J4 / J5, U5A / U5B;
   - J15 stays without a header (DNP). The camera LED lead W21 is soldered into its holes 3, 5 and 6 from the top, on the bench, and laid
     flat along the board top to its front edge (under 6 mm high; a header with a plug would not fit under the Jetson carrier). See
     section 10 item 6. J15 hole 4 (3V3) sits between holes 3 and 5 and stays empty: after soldering, check with a meter for **no
     short** from 5V to 3V3 (TP3 to TP4), from hole 3 to hole 4, and from 5V to GND;
   - the FLR fuse holders, K1, and C1 ("+" on the silk).

   The power pads keep thermal-relief spokes, so use a large tip. U3P.2 (DRV_L GND) has one spoke per outer layer by design (ruling
   PB21): give it time to wet.

   **Trim every lead to ≤ 1.4 mm under the board.** The board sits on 2.4 mm spacers and printed ribs, which leaves 1.0 mm of air.
4. **Modules come last** (section 4 onward): the Pico first, on USB (section 4), then the P03, set on the bench (section 5), then the
   two DRV8874 carriers and the GY-521. Solder each carrier's two loose 1 × 7 headers so the pins stand out of its silkscreen
   (labelled) side: its components then face up when it is plugged (Pololu's "parts visible" option), and VIN is named on that
   underside, so find it before plugging. **A DRV8874 carrier also fits turned 180°, which puts VMOT on its VREF pin:** component side
   up, its VIN / GND / OUT1 row in U3P / U4P (the row nearer the front edge) and its VM / GND / EN row in U3L / U4L, VIN (named on its
   underside; VIN and VM share an end, beside the square GND pads) in the hole at the silk "VIN".

## 2. Unpowered checks

Make these checks with the board bare: no battery, no USB, no modules, F1 and F2 out.
- With a meter, check for **no short** from GND to BAT+, VBAT_SW, VMOT, 5V and 3V3.
  - For VBAT_SW, VMOT, 5V and 3V3, use the test pads in section 7.
  - BAT+ has no pad: probe it at F1's input clip or J1 pin 2.
- C1 and C3 charge from the meter on the resistance range, so the reading climbs. That is normal; a steady near-0 Ω reading is not.

## 3. The J1 lead check

Do the fail-safe check in section 0 now, on the bench. It is ASSY step 0.

## 4. Pico on USB only (battery unplugged, Jetson off)

1. Plug the Pico into its sockets, with the USB end toward the board's left edge. Connect it to a computer by USB.
2. The Pico's VBUS is not connected to the board, and its VSYS only through D2, which is not fitted (DNP). So USB powers only the Pico
   and, through its 3V3 pin, the board's 3V3 rail: the GY-521, the cliff ToF sensors (when plugged in) and the pull-ups. With the
   robot built, that USB is the Jetson's: with the Jetson off, the Pico and its sensors are off. If the robot must run its sensors
   without the Jetson's USB, fit D2 (an SS14, its band on the silk mark; it sits inside DRV_R's socket rows, so fit it with the DRV_R
   carrier out): the board's 5V then feeds VSYS, and the Pico's own VBUS diode keeps that 5V out of the USB host. With D2 fitted the
   firmware must enable USB only while VBUS is present (section 8, "D2 fitted").
3. **Expect:**
   - TP4 (3V3) at about 3.3 V.
   - TP3 (5V), TP1 (VBAT_SW) and TP2 (VMOT) dead.
   - LED1–LED3 off.
4. **I2C pull-ups, powered.** The GY-521 and all four ToF sensors plugged in, the Pico on USB in BOOTSEL (hold BOOTSEL while plugging
   it in, so no firmware drives the bus). Put the meter on its mA range from SDA to GND (J14 pad 3 to an M3 hole ring), then from SCL
   (J14 pad 4). R = 3.3 V / I: expect about **3.1 mA, 1.05 kΩ** each: R19 / R20 (10 kΩ), the GY-521's 2.2 kΩ and the four ToF
   carriers' 10 kΩ in parallel (2.8 mA at 0.4 V, inside I2C's 3 mA). If R < 1 kΩ (a module with stronger pull-ups), leave R19 / R20 off
   (design spec 2026-10-04). Do not use an ohmmeter to 3V3 with the Pico unpowered: it reads the RP2040's pad diodes and misses the
   GY-521's pull-ups, which hang on its LDO's output.
5. With a test sketch:
   - The I2C bus (GP2 SDA, GP3 SCL) finds the GY-521 at 0x68 (AD0 is tied to GND).
   - Each ToF sensor answers once its XSHUT line (GP0, GP10, GP5, GP13) is released.
6. The Pico's 3V3 regulator has about 300 mA for external loads (verify item in `ORDERING.md`).

## 5. Set the P03 5 V converter (before the Jetson)

1. Set the P03 on the bench, with a bench supply on its input: **trimpot to 5.1 V**.
2. Then verify it at **6.0 V input with a 4.71 A load**: the firmware's low-battery stop, at the P03's full output, the Jetson's 4.5 A
   + the 5V taps (`board_spec` P03_VIN_MIN, P03_OUT_A). Use an electronic load at 4.71 A, or a 1.08 Ω resistor (4.71 A at 5.1 V; a
   1.1 Ω part draws 4.64 A). The load dissipates about 24 W: use a 50 W part, or a smaller one on a heatsink. The bench supply must
   give at least 5 A at 6 V. Set 6.0 V at the P03's IN terminal (the bench leads drop too). Pass: the output holds the set 5.1 V
   within 0.1 V for a minute. **Read the input current too:** efficiency = 5.1 V × 4.71 A / (6.0 V × I_in) must be ≥ 85 %
   (`board_spec.P03_EFF`), i.e. I_in ≤ 4.7 A (about 4.6 A at the 5.0 V nominal, `P03_IN_A` 4.62 A). Its rating alone is not
   acceptance: the HW-316E's XL4015 (datasheet input 8–36 V; the seller says 4–38 V) is a non-synchronous buck with a sense shunt and
   needs about 0.6–0.8 V of headroom at this current, and motor starts sag the pack 0.3–0.5 V more, so the Jetson could brown out
   (SD-card corruption) before the clean shutdown.
   **If it fails,** raise the input in 0.1 V steps to the lowest input at which it passes. The firmware stop (section 8) becomes that
   input + 0.5 V (the motor-start sag), and `board_spec.P03_VIN_MIN` is set to match (a comment there; no board change).
3. Only then connect it to U5A (input) / U5B (output) and fit it (ASSY step 5).
4. **Polarity: pin 1 is "+" on both terminals.**
   - U5A pin 1 = P03 IN+ (VBAT_SW); U5B pin 1 = P03 OUT+ (5 V). Pin 2 is GND on both (IN− / OUT−).
   - Pin 1 is the screw nearer the robot's centre line. The silk "+" for U5A sits on the board just behind the terminal (the side away
     from the P03); for U5B, just past the terminal's end nearer the centre line.
   - Before the first power, check each "+" lead end to end with the meter's continuity range: P03 IN+ to U5A pin 1, P03 OUT+ to U5B
     pin 1. A swapped input lead puts the pack backwards on the P03 the moment the rocker goes on.
   - Section 7 step 3 checks both with power on, before the Jetson is connected.

Once the Jetson is on, its trimpot and tie cannot be reached.

## 6. Assembly into the robot (ASSY_ORDER, condensed)

The numbers below are copied from the resolved `ASSY_ORDER` (bay B12a build). The full text is the reference.

### Step 0. On the bench

**Make the two motor pigtails (C18) and tag them at once.**
- Tag one "**L / J4**" (left motor) and the other "**R / J5**" (right motor), right after making each one and before it is plugged on.
  They differ in length and in pin-1 order.
- Pre-cut the six wires to **61 mm (J4) / 57 mm (J5)**: the drawn route, plus the terminations, plus the full 12.7 mm pin spread.
  The six wires fan out 6.35 mm either side of the bundle's centre line at both ends: at the socket's sleeves and again at the male
  housing's cavities.
- Solder the socket end first: one wire on each tail of the right-angle socket, under a Ø1.8 sleeve. The red wire goes on pin 1, and
  the tails and wires point up.
- Push the socket onto its header. Leave the male ends long; they are finished in step 4.
- J4 pin 1 is at the rear end and J5 pin 1 at the front end (the square pads). The rule is the same for both: looking into the
  socket's mating face with its tails up, **the red wire (pin 1) is on the left**.
- The pigtails stay with the board.

**Tag the three power leads** "J1 BATT", "J2 ROCKER" and "J3 JETSON 5V". They are three different connector families and cannot be
cross-plugged (section 0); the tags are there anyway.

**Do the J1 fail-safe check** (section 0).

### Step 1. Ribs and front standoffs

- Bond the two printed bearing ribs into their 0.6 mm pockets in P_base with epoxy (F04), and let it cure.
- Fit the two front Jetson standoffs (24 mm stacks), screwed from below.

### Step 2. The board

Set the four 2.4 mm spacers and the two clamp spacers on P_base. Lower the board onto them and fix it with four M3 × 8 pan-head screws
into the inserts.

### Step 3. The battery tray, after the board

1. The tray's hold-down beams must be freed first: cut the breakaway posts.
2. **Set the tray 2 mm aft of its place**, then slide it forward. Its three spring fingers ride up their lead-ins onto the board's top
   face, between the rear connectors.
3. Screw the tray down.
4. **Hold-down feeler check:** at each finger, a **0.05 mm feeler must not pass under the tip.**
5. If it passes, that finger has play. Shim it with **0.1 mm PTFE tape (F03)** under the tip, one layer at a time (about 0.3 mm at
   most), until the feeler no longer passes.

### Step 4. The under-carrier cables

**Pigtails.**
1. Dress each one as drawn, with no slack (it rides up with the board when the joint is unplugged). The route: straight up out of the
   socket, forward about 12 mm over the board beside U5A (beside J9 on the right), out between the P03 and the motor face, and down to
   the inline joint just ahead of the motor (x 15.2..17.8, |y| 38..60).
2. Trim each wire at its own cavity of the male housing. Its finished length depends on where the wire sits at both ends:
   - J4: 35.4–60.8 mm (about 48.1 mm on the bundle's centre line);
   - J5: 31.1–56.5 mm (about 43.8 mm).
3. Crimp the male pins into the 1×6 housing, red wire = pin 1.

**Factory motor cables: measure, then coil.**
1. Measure each cable from the encoder cap to the female housing's rear face (the wire entry). Readings of **186–200 mm** all fit
   (2–3 turns). A longer cable, up to **220 mm**, still fits (up to 3.5 turns).
2. Lay the fixed path first, about 89 mm outside the coil:
   - a flat row along the motor's inner end face toward the rear;
   - round the motor's rear shoulder and forward over the motor top (never over the pigtail);
   - down the motor's front shoulder, under the bumper lead;
   - from the coil position into the housing.
3. Wind the remainder (the measured length less the fixed path: **97–111 mm**) into the **coil** on the base ahead of the motor:
   2–3.5 turns, about 16 mm across, at x 25, |y| 72. Tie it through its two slots.

**Inline joints.**
- Mate each motor's factory female housing onto its pigtail's male housing.
- The joint is **not keyed**: mate the pin-1 stripe to the pin-1 stripe (both halves are marked at the red wire), and check that the
  colours run straight across.
- Stand the joint on the base and tie it down: the tie goes down the motor opening and up through the slot beside it.

**Then plug the rest:** the bumpers J10 / J11 and the front cliffs J8 / J9.

### Step 5. The P03

Set and verify it on the bench (section 5). Connect it to U5A / U5B: pin 1 ("+", the screw nearer the robot's centre line) is IN+ on
U5A and OUT+ on U5B; the red wires go on pin 1. The P03 is the HW-316E board: its IN terminal is on one short end and OUT on the
other. Fit it with the IN end toward the robot's left (the U5A / U5B side), display up and toward the rear. The leads run out of each
end and over the P03's top: about 46 mm (IN) and 70 mm (OUT); cut 100 mm and 150 mm (cable-cut-list.json). On each P03 terminal "+" is
the screw nearer the robot's front. Fit it on its foam tape in the front bay, with a 2.5 mm cable tie through the P_base slots at
(39.5, ±33.3): the tie runs over the two capacitor tops, clear of the end terminals and the trimpot. Pull it snug, not tight: it presses on the
capacitors' vented tops and their surface-mount joints. Do not let it slide onto the trimpot.
Before the Jetson is connected, check both terminals with the meter (section 7 step 3).

### Step 6. Rear standoffs

Stand the two rear 20 mm F-F standoffs on the board. Screw each one down with an M2.5 × 12 countersunk screw from under P_base,
through the base, the clamp spacer and the board. These two stacks clamp the board.

### Step 7. The Jetson

Fit the Jetson (four M2.5 top screws), then its six plugs. Its barrel-jack power needs the J48 jumper fitted (section 8). Before the
5 V barrel plug goes in, check the Jetson lead W04 (section 0): its centre reads positive 5.1 V against its sleeve.

Before step 7, do sections 7–9: the LEDs, the test pads and the under-carrier plugs can be reached only until the Jetson is on.

## 7. First power with the Jetson not fitted

All three status LEDs and all five test pads sit **under the Jetson carrier** (robot x ≥ −38.5). They can be seen and reached only
before the Jetson is fitted, so do this whole section with it not fitted; the one point where it is powered is step 3, beside the
robot. **Keep the Pico on the bench computer's USB (section 4)** throughout: with D2 DNP and the Jetson not fitted, nothing else
powers the Pico and the 3V3 rail.

| Ref | Shows / net | Robot (x, y) mm | Note |
|---|---|---|---|
| LED1 | VBAT_SW (green, R21 3.3 k) | (−30.8, 46.0) | |
| LED2 | 5V (green, R22 1 k) | (−26.3, 39.5) | |
| LED3 | VMOT (yellow, R23 3.3 k) | (−26.0, −36.0) | |
| TP1 | VBAT_SW | (−17.0, 43.5) | |
| TP2 | VMOT | (−32.5, −40.0) | right edge, past the end of the right driver's U4L row; or probe VMOT at C1 "+" (behind the carrier) |
| TP3 | 5V | (−5.5, 10.5) | |
| TP4 | 3V3 | (−35.5, 45.0) | |
| TP5 | GND | (−22.3, 27.4) | **under the GY-521 module**: probe it before the IMU is plugged in, or use an M3 hole ring as GND |

> **Note on the GY-521.** B3's note (carried into the B10 brief) placed TP1, TP3, TP4 and TP5 under the GY-521. On the routed board
> (`board_cad.json`, GY-521 outline x −36.6..−20.2, y 13.2..34.4) **only TP5 is under it**. TP1, TP3 and TP4 lie outside the module,
> though still under the carrier. No test pad or LED sits under the Pico or the DRV8874 carriers.

Steps:

1. **Rocker off; then battery in, F1 fitted, F2 out.** Expect LED1 off and TP1 at 0 V.
2. **Rocker on.** Expect:
   - LED1 on;
   - TP1 at about the pack voltage;
   - the Pico's VSENSE (GP26) at about 0.248 × TP1 (the R11 100 k / R12 33 k divider; 2.16 V at 8.7 V).
3. **5 V rail and the P03 polarity check** (P03 connected; the Jetson lead W04 unplugged from J3). Measure against a GND pad:
   - U5A pin 1 ("+", P03 IN+) reads the pack voltage, positive;
   - U5B pin 1 ("+", P03 OUT+) reads the set 5.1 V, positive. TP3 reads the same, and LED2 is on.

   A negative or 0 V reading at U5B pin 1 means the P03 leads are swapped or loose: rocker off, battery out, fix them before going on.

   **5 V at the Jetson, under load** (after the W04 check in section 0). From the P03 to the Jetson there is about 65 mΩ (board copper,
   W04's 18 AWG, the Micro-Fit, the barrel jack): about 0.3 V at 4.5 A. Run the Jetson under load (a CPU + GPU stress) on W04, beside
   the robot and not yet fitted (the trimpot cannot be reached once it is on). Its barrel plug must read **≥ 5.0 V**; if not, trim the
   P03 up, but never so far that U5B pin 1 reads above `board_spec.V5_MAX` **5.25 V** with the Jetson unplugged. If both cannot hold,
   stop and report it (a shorter or heavier W04). A trim above 5.1 V is the new set-point for the 5.1 V readings in sections 0 and 6.
4. **Motor toggle on** (the J13 loop). K1 clicks, and MOTOR_ON_N (GP9) reads low. With F2 still out, VMOT stays dead.
5. **Rocker off, fit F2, rocker on.** F2 goes in only with the rocker off: fitted live, it would charge C1 + C3 (570 µF) through the
   fuse contacts. K1 makes the same charge on every motor-toggle-on (40–80 A peak for tens of µs), and that is accepted: the relay
   closes once, on contacts made for switching (their capacitive-inrush rating is on the `ORDERING.md` verify list), while a blade
   pushed in by hand makes and breaks several times as it scrapes into the clip, each time arcing on the clip that then carries the
   motor current. Expect:
   - TP2 (or C1 "+") at about the pack voltage;
   - LED3 on.
6. **Motors, wheels lifted.** Use the firmware limits in section 8.
   - Wake the drivers: DRV_SLEEP (GP7) high. R17 holds SLEEP low by default.
   - Spin each motor both ways at 20 kHz PWM.
   - Check that the encoder counts follow (GP1 / GP4 left, GP11 / GP12 right).
   - Check the current sense at about 50 % duty, with an ammeter in series with the motor: L_CS_ADC (GP27) and R_CS_ADC (GP28) read
     about D × I × 1.1 V/A (slow decay: CS is 0 in the off-time; through the R24 / C4 and R25 / C5 filters, settled in about
     3.6 ms), so I = V_ADC / (1.1 V/A × D) must match the ammeter (section 8).
7. **After a stall test,** touch U3P.2 (DRV_L GND, ruling PB21): its joint must not be hot.

## 8. Firmware limits (from BRINGUP-NOTES.md)

- **DRV8874 continuous current: 1.8 A per channel.**
  - At 2.1 A continuous, the junction reaches 88–136 °C. This assumes 40 °C air under the carrier, R_θJA 40 °C/W (JEDEC), and 70 °C/W
    for the 2-layer carrier. 1.8 A keeps it at or below about 110 °C.
  - Firmware enforces the limit from CS: 1.1 V/A on the carrier's 2.49 kΩ, read on GP27 (L_CS_ADC) and GP28 (R_CS_ADC). Each
    CS reaches its pin through an RC filter by its driver (R24 / C4, R25 / C5: 4.7 kΩ and 100 nF; with the carrier's 2.49 kΩ,
    τ = 7.19 kΩ × 100 nF ≈ 0.72 ms, about 220 Hz), so the reading is the 20 kHz chopping averaged; a stall shows within about 3.6 ms.
  - **CS reads I × duty** (LIO-234): the DRV8874 senses only its high-side FETs, and in the slow-decay off-time (the low-side brake)
    CS is 0, so V_ADC ≈ D × I × 1.1 V/A while the driver and the motor carry the full I. Use **I = V_ADC / (1.1 V/A × D)** and apply
    the 1.8 A limit to that I. It holds for D ≳ 0.1; at lower duty rely on the stall timer.
  - The filter cap also raises the driver's own cycle-by-cycle current limit from about 2.9 A to about 3.5 A at D = 0.5 (up to about
    4.4 A at low duty and in the first ms), still under its overcurrent protection.
  - Short peaks are fine: starts, and a stall up to the 2.1 A design current. A stall must be cut within seconds.
  - These datasheet figures are quoted from memory; see "Verify before ordering" in `ORDERING.md`.
- **Motor PWM about 20 kHz** (`board_spec.DRV_PWM_HZ`), **with slow decay.**
  - Forward: IN1 = 1 and IN2 = inverted PWM; reverse: IN2 = 1 and IN1 = inverted PWM. The off-time brakes on the low sides; the duty
    is the fraction with the PWM input low. On the RP2040, hold one channel of the slice high and invert the other's output.
  - With C1 fitted, C3 (100 µF FK at DRV_L's VIN) then carries 0.10 A of ripple, against its 0.16 A rating. At 1 kHz it would carry
    0.18 A, over its rating.
  - **Fast decay is not allowed.** PWM on IN1 with IN2 low coasts in the off-time: the motor current flows back into VIN and C3
    carries about 0.20 A, over its rating. The 0.16 A is the datasheet's 100 kHz figure, not derated to 20 kHz.
  - The off-time brake lasts one PWM period. It is not the sustained short brake a disarm must avoid (see "Braking" below); the
    firmware ramp still sets the deceleration.
  - **Never run the motors at low PWM frequencies, and never without C1.**
- **Driver control lines:**
  - PMODE is tied high (PWM / IN-IN mode).
  - SLEEP (GP7) wakes both drivers; R17 pulls it low.
  - FAULT (GP8) is open drain and shared, with an R18 pull-up.
  - Each motor's IN1 / IN2 pair is on one PWM slice: GP16 / 17 left, GP18 / 19 right.
- **Switch inputs.** The switches pull their pins to GND. ARM (GP14, a normally-open button on a 200 mm lead) has a 10 kΩ pull-up on
  the board (R26). BUMP_L (GP6) and BUMP_R (GP15) have none: they are normally closed (an open lead reads as a bump), so enable the
  RP2040's internal pull-ups on those two pins in firmware.
- **I2C:** I2C1 on GP2 (SDA) / GP3 (SCL) at **100 kHz**. The board has 10 kΩ pull-ups (R19 / R20); the bus runs over cables to the
  four ToF boards and the IMU. With their pull-ups the bus totals about 1.05 kΩ (section 4 item 4).
- **ToF addresses.** The four VL53L0X sensors all start at address 0x29.
  1. At boot, hold all four in reset: XSHUT1–XSHUT4 (GP0, GP10, GP5, GP13) low.
  2. Release one at a time, and give each a new address: **0x30, 0x31, 0x32, 0x33** for cliff 1–4 (J6, J7, J8, J9).
  3. The IMU stays at 0x68.
- **Battery low-voltage stop.** The pack is 6-cell NiMH: 7.2 V nominal, 8.7 V full.
  - VSENSE (GP26, ADC0) = VBAT_SW × 33 kΩ / (100 kΩ + 33 kΩ) = **0.248 × VBAT_SW** (R11 100 k top, R12 33 k bottom, C2 100 nF).
    Full charge (8.7 V) reads 2.16 V, inside the 3.3 V ADC range.
  - **Warn at 6.6 V** (1.1 V per cell; VSENSE 1.64 V).
  - **Stop at 6.0 V** (1.0 V per cell; VSENSE 1.49 V, an ADC count of about 1847 of 4095 at the 3.3 V reference). This assumes the
    P03 passed the 6.0 V / 4.71 A test in section 5; if it failed, the stop is the lowest passing input + 0.5 V.
  - Average over about 2 s, so motor starts do not trip it.
  - At the stop: stop the motors and tell the Jetson to shut down. Then switch the rocker off and charge the pack.
  - Do not run NiMH below 1.0 V per cell.
- **Camera LED:** GP20 (SPARE3, J15 pin 3) is the output CAMERA_LED, **low by default**.
  - The controller sets it high (LED fully on, about 59 mA from J15 pin 5) while a task drives, mapping or Go-to, and low when idle.
  - **No PWM dimming:** a rolling-shutter camera would show bands. GP20 is on PWM slice 2 A if dimming is ever wanted.
  - A 100 kΩ resistor from the MOSFET gate to GND keeps the LED off while the Pico boots or resets (section 10 item 6).
- **Jetson power:** barrel-jack power needs the Jetson Nano's **J48 jumper** fitted. On a B01 it sits beside the barrel jack; on an A02,
  beside the camera connector J13, on the carrier edge opposite the 40-pin header.
- **D2 fitted** (DNP as delivered; section 4 item 2): the Pico then runs from the board's 5V with the Jetson off. Once firmware
  enables USB, the RP2040's 1.5 kΩ D+ pull-up feeds 1–2 mA into the unpowered Jetson's hub, so enable USB only while the Pico's VBUS
  sense (GPIO24) is high; without VBUS, hold XSHUT1–XSHUT4 low and idle. The Pico and its sensors (about 0.2 A) keep running after
  the low-battery shutdown until the rocker goes off.
- **IMU:** the MPU-6050 runs DLPF_CFG = 4 (about 20 Hz), with samples forwarded at 20 Hz (ruling PB27; see section 14).
- **Braking: keep the ramp, never short-brake** (task F; numbers updated in tasks I and L). With the LD14 turned round at x 54, the lid
  closed over the front bay and the LD14 20 mm lower (task L), the robot's balance point is 16.2 mm behind the axle (13.7 mm in
  the CAD's worst case). Braking harder than about 1.4 m/s² down a 5° slope in that worst case (1.8 m/s² nominal) would
  lift the caster and rock the robot onto its bumper. DriveCore ramps every wheel setpoint, braking included, at 0.25 m/s², well below
  that. The firmware must keep that ramp. On a disarm (bumper, cliff, tilt, timeout) it must let the motors **coast**: drive both
  DRV8874 inputs of each motor low (IN-IN mode coast), never both high (short brake). The motor torque cap alone would allow about
  1.63 m/s², 0.2 m/s² above the worst-case downhill onset (task F had 0.06): only the firmware ramp keeps a hard stop on a
  downhill from rocking the robot forward, so it must not be removed or raised.

## 9. Before fitting the Jetson: plugs and the gap under the carrier

1. **Plug every under-carrier connector first.** Once the Jetson is on, none of them can be reached:
   - the J4 / J5 pigtails and their inline joints (step 4);
   - the bumpers J10 / J11;
   - the front cliffs J8 / J9;
   - the P03 leads at U5A / U5B;
   - the camera LED lead W21, soldered into J15 (section 1): check it lies flat on the board top and leaves the front edge without
     crossing a connector's mating face;
   - the spare J14, if fitted (DNP as delivered).

   **Handle these leads with ESD care, and inspect each cable before it is plugged** (LIO-234). ARM, BUMP_L / BUMP_R, XSHUT1–4,
   SDA / SCL and GP20 run straight to RP2040 pins and the encoder lines to bare 2N7002 gates, with no ESD protection: touch an M3 hole
   ring (GND) before handling a plug. The 5 V taps J4.4 / J5.4 (encoders), J13.1 (toggle loop) and J15.5 (camera LED) have no fuse
   or PTC, so a pinched motor cable or a shorted toggle or LED lead crowbars the Jetson's 5 V, and can fuse an inner trace (J5.4,
   J13.1 and J15.5 run on 0.8 mm half-ounce In2). The 3V3 taps J6.1–J9.1 (the four cliff leads; J8.1 / J9.1 via the In2 run to
   J15.4, then 0.15 mm F.Cu) leave on 0.15 mm In2 (about 0.76 A for 1 s), limited only by the Pico's 3V3 regulator, and COIL_P
   leaves on J13.2 to Q5's gate (D1 clamps it negative). Look for nicked insulation and check that no lead is pinched under the
   carrier, the P03 or a tie (`ORDERING.md` risk list; LIO-235 decides on PTCs).

   **J3 (Jetson 5 V)** is not under the carrier. It is in the rear band, behind the carrier (robot about (−43.9, −44.5)), with its
   mating face at the board's right edge, reachable with the lid off. Plug the Jetson lead W04 into it after the section 7 checks.
2. **Measure the gap.** The carrier PCB underside sits at z 57.0, which is **20.0 mm over the board top**. The plan's limit for any part
   under it, including a mated plug and its wire bend, is **16.27 mm over the board top** (z 53.27). That leaves 1.5 mm below the
   carrier's through-hole lead tails, which the CAD allows to reach 2.23 mm under the carrier PCB (`validation.carrier_lead_tail_slab`).

   The CAD's tallest under-carrier items:
   - the DRV8874 and GY-521 module stacks: 14.0 mm (z 51.0, `bay_under_carrier_max_top_z`);
   - the mated XH plugs J8–J11 with their wire bend: 14.8 mm;
   - the pigtail sockets and sleeves: 13.8 mm (z 50.8);
   - the U5A / U5B terminals: 13.8 mm.

   Measure two things:
   - **(a)** the tallest part over the board top, with every plug mated;
   - **(b)** how far the Jetson carrier's lead tails stand below its PCB. Measure this on the Jetson, upside down. On an A02, include
     the tails of its J40 / J44 pin headers (the carrier's rear-right corner); the B01 CAD model has no headers there.

   Then require **(a) + (b) + 1.5 mm ≤ 20.0 mm**.

   One way to see the real gap: put a small ball of modelling clay on the tallest parts, fit the Jetson, take it off again, and measure
   the squashed clay.

   **If the rule fails, do not force the Jetson down.** Re-dress the cable that is too high, or report it. The DRV and GY-521 stacks
   have only 2.27 mm of margin (bay spec, risk 2).

Then fit the Jetson (ASSY step 7).

## 10. Lid-on checks

1. **Fan duct check** (the LiDAR tray note in `cad/component-manifest.json`). Task L moved the seal round the fan's intake from a
   skirt under the lid to a duct under the LiDAR tray: it passes through the lid's central opening, ends 0.9 mm above the fan
   frame and, ahead of the fan, closes under the LD14 motor with a bowl.
   - Do this with the lid on its posts and the tray screwed onto it, before the LD14 goes on. The duct's lower edge cannot be reached
     from above, so use modelling clay: press four small balls (about 4 mm across) onto the fan frame just outside the round fan
     opening (front left, front right, rear left, rear right), fit the lid and the tray, lift them off again and measure the squashed
     clay with a caliper.
   - Every ball must be **0.5–1.0 mm** thick. Thinner: sand the duct end where it touched. Thicker than 1.0 mm: shim the fan,
     otherwise the bypass limit is lost (the bypass is 21.4 % of the grille's open area, against a 25 % limit that is
     reached at a 1.10 mm gap).
   - Through the tray's Ø26.4 hole for the LD14 motor, look down past the front of the fan: light must show between the
     bowl's back wall and the fan's front face (0.5 mm by design).
   - **LD14 motor over the fan.** The motor's rim sits 1.4 mm above the fan frame. Repeat the clay check with one ball on the
     fan frame's front edge, under where the motor will be, with the LD14 fitted: it must stay at least 0.5 mm thick. If not, put
     0.5 mm washers under the LD14's three lugs (not under the tray: that would open the duct gap).
2. **Lid-on tegrastats test.**
   - Everything is fitted and the lid and LiDAR tray are on.
   - Run the Jetson under its real load (the autonomy stack, or a CPU + GPU stress) until the temperatures settle, about 30 minutes, and
     log `tegrastats` throughout.
   - Pass: no thermal throttling (no forced clock drop), and the temperatures level off.
   - Record the peak CPU / GPU / thermal-zone values.
   - Also record the air temperature under the carrier, near the drivers: the DRV8874 figures in section 8 assume 40 °C.
3. **LD14 orientation and scan direction** (task F: the LD14 is turned round, spin axis 54 mm ahead of the axle).
   - The LD14 sits on its tray with its **round turret toward the front and its motor toward the back**. Task L: it sits 20 mm lower,
     straight on the tray plate (no towers): its three lugs rest on M3 heat-set inserts pressed flush into the plate top and take
     M3 × 5 socket-head screws from above (heads in the lugs' counterbores). Its motor drops through the tray into the fan duct. The
     tray takes four M3 × 12 screws with nyloc nuts under the lid: (−35, ±38) and (83, ±35).
   - The LD14 lead (W20, the 0.2 m C17 lead) runs from the USB adapter forward under the lid and straight up through the lid aperture
     at (39, 18), beside the J28 plug. Pass the plug up through the aperture, fit the grommet `P_ld14_grommet` round the lead, plug J28
     into the LD14 while the LD14 is still off the tray, then set the LD14 down and feed the slack back down through the grommet.
   - **Scan offset.** The LD14's 0° direction (its motor end) now points **backward**. In the LiDAR driver, add 180° to every scan
     angle and wrap the result into (−180°, 180°]: robot bearing = wrap(scan angle + 180°), for a scan in the usual counter-clockwise
     (REP-103) form whose 0° is the motor end. A raw LD14 angle, which runs clockwise, maps to wrap(180° − raw angle).
   - **Check.** Put a box about 0.5 m straight ahead of the robot: it must show at bearing 0°, not 180°. Then move it to the robot's
     left: it must show near +90°.
   - The LD14 sees nothing closer than 0.1 m from its spin axis. At x 54 that circle stays just inside the bumper, even with a half
     pushed in, so the LiDAR sees anything the bumper can touch. Do not move the LD14 further forward: at x 109 (tried in task F) a
     strip 5 cm deep in front of the bumper was blind, and the controller's close-range checks lost what was in it.
4. **Camera window check** (task F: the camera sits in the bumper band, fixed to the chassis, and looks out through a window cut across the
   bumper seam).
   - Jetson on, camera streaming at its full 1920 × 1080 mode (the widest view). Put a sheet of white paper about 0.5 m in front of the
     robot so that edges show up.
   - Look at all four image corners and edges: no part of the bumper may show. Then push the left half in to its stop, then the right
     half, then both, and look again each time.
   - Pass: the image never shows a bumper edge. If one shows, check that the camera holder sits flat on its crossbar and that the
     camera board sits flat on the holder (the lens must point straight ahead and level).
   - With the bumper at rest, the lens face sits about 12 mm behind the bumper skin. Check by eye that a flat card held against the
     bumper front, pushed until the bumper stops, does not touch the lens.
5. **Camera top-edge check** (task M, LIO-121: the camera now also finds furniture whose underside is between the LiDAR's scan line
   and the robot top, which the LiDAR passes under and only the LiDAR turret would hit).
   - The controller needs the top of the image to see the band up to 2 cm above the robot top, about 75 mm above the lens, from
     0.15 m ahead. The OV2735 camera (A) is sold as 96° diagonal with almost no distortion, which is about 88° × 57° at 16:9
     (top edge 28.6° above level). The simulator uses 84° × 54° (top edge 26.9°).
   - Jetson on, camera streaming in the mode the controller will use. Lay a ruler across the floor 0.15 m in front of the lens and
     hold a card edge level over it, first 155 mm above the floor (the detector's ceiling: the robot top + 2 cm, 26.6° up), then
     135 mm (the robot top with the LiDAR 20 mm lower, 20° up).
   - Pass: both card edges show in the image, below the top edge. If only the 135 mm edge shows, the camera still covers the robot
     top but not the 2 cm margin. If neither shows, the mode crops the sensor (some 4:3 modes do) or the lens points down: use a
     16:9 mode and check that the holder sits flat. Each degree the lens points down costs about 3 mm at 0.15 m.
6. **Camera LED** (task N, LIO-134: one white LED above the camera lens lights the floor and the band in front of the robot, so the camera
   can see the sofa's overhang in a dark corner. The controller sets it on at full brightness while a task drives, and off when idle.
   Parts E19 to E21 and C21; lead W21; it is fed from J15 pin 5 (5 V, budget 0.10 A) and switched by GP20.)
   - **Polarity, before gluing.** Solder the LED onto its carrier (E20) first. It lights only one way round.
     - Touch a 3 V coin cell through a 100 Ω resistor across the two pads. It glows dimly. If it stays dark, swap the leads.
     - Mark the anode pad (the pad that was on the cell's + when it lit) with a paint-pen dot on the back of the carrier. The wire from
       the 39 Ω resistor goes to that pad, and the wire from the MOSFET drain to the other.
     - Only then glue the carrier to the front face of the shelf `P_camera_led_shelf`, with its top edge flush with the block's top
       (z 91.0), never above it. Keep the two wires under that edge too.
   - **Fit check.** Screw the shelf under the camera board's two upper corner screws (M2 × 8 thread-forming, H09). Its block sits
     0.9 mm above the lens barrel. If the barrel touches it, file the underside of the block. The lens holder must stay under z 87.
     - Once the bumper is on, push its right half in to its stop (as in item 4). Its seam backer then passes 2.1 mm above the carrier:
       the half must reach its stop freely, with no tick from the carrier or its wires.
   - **Current check.** J15 is under the Jetson carrier, so do this and the next check **before the Jetson goes on** (section 9), with the
     Jetson off and the board powered as in section 7.
     - With the lead soldered into J15: at the switch, its red (5 V) wire against its black (GND) wire reads **5.0–5.2 V**.
     - Open the 5 V wire at the 39 Ω resistor (its joint is not yet in heat-shrink) and put the meter, on its 200 mA range, in series.
     - Force the LED on at the white wire (from J15 hole 3), on the J15 side of the switch's 100 Ω gate resistor, through a second
       100 Ω resistor. Use one of these two ways:
       - **Pico in its sockets, on USB, with no firmware driving GP20** (for example in BOOTSEL mode: hold BOOTSEL while you plug the
         USB cable in). Touch the second resistor to TP4 (3.3 V). TP4 has 3.3 V only while the Pico is on USB (section 4).
       - **Pico out of its sockets.** Touch the second resistor to TP3 (5 V). Never use 5 V with the Pico in: GP20 takes at most 3.3 V.
     - Expect **55–65 mA** (59 mA by design: (5 − 2.7 V) / 39 Ω). **Above 70 mA: stop** and check the resistor (it must be 39 Ω) and the
       wiring for a short.
     - **Heat check.** With the meter still in series, leave the LED forced on for 20 minutes (clip the second resistor in place).
       Then check the shelf block beside the carrier, with a fingertip if you can reach it or with a meter's thermocouple taped to it.
       It may be warm, but must stay under about 50 °C, where you can keep a finger on it (the PETG shelf softens near 80 °C). The
       current must still read 55–65 mA. The 39 Ω resistor (0.14 W in a 0.25 W part) may be warm too. If either is hotter, stop and
       report it: the fix is a 0.5 W resistor or a larger copper carrier.
     - Take the second 100 Ω resistor away: the LED must go out at once. Then close the 5 V joint and put every joint of the switch in
       heat-shrink.
   - **Off at power-up.** The 100 kΩ resistor from gate to source holds the MOSFET off while GP20 floats. Power the board with the Pico out
     of its sockets: the LED must stay dark. Then fit the Pico, plug its USB cable and watch it boot, then reset it: the LED must stay
     dark throughout, and come on only when the firmware sets GP20 high.
   - **Glare check** (Jetson on, camera streaming, lid on; in a dark room, so the LED is the only strong light).
     - Switch the LED on from the controller: a task sets it on while it drives (wheels lifted, as in section 7 step 6). If the task
       stops too soon, set GP20 high from a test sketch instead. Do not use the 100 Ω trick now: the firmware holds GP20 low, and the
       joints are in heat-shrink.
     - Hold a white card about 0.5 m in front of the robot. The camera image must show **no bright spot, ring or haze** from the LED, and no
       glow along the window's edges.
     - If it does, add black tape or matt black paint to the window's inner edges, outside the image (it must not cover the view).
       Then repeat item 4: no bumper edge or tape may show in the image.

## 11. Service

**Step 0, every time, before you reach inside:** shut the Jetson down, switch the rocker off, then unplug the battery at its Tamiya
plug. BAT+ is live and unfused at F1's input whenever the battery is plugged in: the rocker switches only what comes after F1.

- **Everyday rule:** switch the rocker off before you plug or unplug the battery, and shut the Jetson down before you switch the
  rocker off. Fit or pull a fuse only with the rocker off.
- **The lid comes off with the LiDAR tray and the LD14 on it** (four lid screws). Lift it straight up. Task L: the tray's fan duct
  hangs through the lid; when you refit it, lower it straight down: the bowl under the LD14 motor passes 0.5 mm in front of the fan's
  front face. The duct fits the glued lid's central opening with about 0.3 mm a side: if it binds when the tray first goes on, sand
  the lid opening's edge, not the duct.
- **With the lid off, these are reachable:** the board's rear band (Pico USB, the rear connector row, the Jetson 5 V lead J3, the
  fuses).
- **These need the Jetson off:** the motor inline joints, the other under-carrier connectors and the P03 (tie, trimpot). To take the
  Jetson off, unplug its six plugs (camera, LiDAR and Pico USB, Wi-Fi dongle, 5 V barrel plug, fan), then undo its four top screws.
- **To take the board out:**
  1. Jetson off.
  2. The two rear standoffs off (their M2.5 screws from under P_base).
  3. The battery out (undo the strap; its Tamiya plug is already out, step 0).
  4. The four tray screws out. Slide the tray 2 mm aft and lift it straight out.
  5. The four M3 board screws out.
  6. Unplug the rear-band plugs.
  7. **Unplug the motor inline joints before the board lifts:**
     - loosen each factory-cable coil tie first (the 8 mm each housing slides back comes out of the coil);
     - cut the joint ties;
     - slide each factory housing off its pigtail.

     The pigtails stay on J4 / J5 and ride up with the board.
  8. Unplug the bumper leads, the front cliff leads and the P03 leads.
  9. Lift the board.

  Fit new ties when it goes back, and re-tie the coils.

## 12. Robot behaviour rules (unchanged by the bay board)

- **No blind reversing.** The robot reverses only along the trail it has driven. Every simulator scenario audits this.
- **The circle rule for spins.** A turn in place is allowed only if every measured point is at least TURN_CLEAR (body radius +
  TURN_MARGIN) from base_link (`local_planner.turn_clear`).
- **Bumper and cliff behaviour are unchanged.**
  - A bumper press disarms the drive. The firmware re-arms only for a reverse with both wheels ≤ 0, which the controller drives only
    along its own trail, or for a pure spin toward the pressed side.
  - A cliff or tilt is a hard stop.

## 13. Simulator

On 2026-10-09 (bay B10) the simulator data were re-synced from `cad/mass-properties.json` at 76232c4:
- body 2.2838 kg, robot 2.4218 kg;
- robot COM x −18.48 mm (guard ≤ −15; the CAD worst case is −15.92);
- the body inertia tensor;
- the real bay board, modules, plugs, pigtails and joints in the visual meshes.

The Unreal pawn (rebuilt in B10 phase 2) takes its body inertia from `body_inertia_kg_m2`; the physics check reads it back exactly.
Its LiDAR collider is the turret-radius column from the lid top to the 155.15 mm robot top.

On 2026-10-11 (task F) the camera moved into the bumper band and the LD14 was turned round and moved forward; the simulator was
re-synced at 1876045:
- camera lens face x 146 mm, axis 80 mm above the floor, level (was x 117, 107.5 mm);
- LD14 turned 180° (motor toward the back), spin axis x 54 mm (was 20): the most forward position at which its 0.1 m minimum range
  stays inside the pressed bumper. Its scan plane stays at 147.5 mm. The simulator reports scans in the robot frame; the 180° offset is
  only for the real driver (section 10, item 3);
- robot 2.4175 kg, COM x −17.44 mm (guard, user decision: nominal ≤ −12 mm and the CAD's worst case ≤ −10 mm; the worst case is
  −14.88 mm).

The Unreal mapping benchmark with this robot (full-mapping-20261011T183022, errors on) entered all five rooms and mapped each 95–100 %,
with one bumper contact. It did not report the map complete within the 1500 s budget: the controller's completion rule allows at most
1.5 m² of safe-looking floor it cannot reach, and 1.56 m² remained (a living-room pocket and the inside of the shower tray). Details are
in the task F report.

On 2026-10-11 (task I) the lid was closed over the front bay (a 1.5 mm pocket under it over the bumper seam keeps a push into the
seam sensed) and the simulator was re-synced at e068608: robot 2.4442 kg (+26.7 g), COM x −15.96 mm (the CAD's worst case
−13.48 mm). The scenario suites, errors on and off, and goto_wall gave the same results as before the change. Unreal was not re-run for
this 1 % mass change; it reads the new mass and inertia at its next launch.

On 2026-10-12 (task L, LIO-120, the user's request) the LD14 was lowered 20 mm, the most the scan-band rule allows: laser plane
127.5 mm (was 147.5), robot top 135.15 mm (was 155.15). The simulator was re-synced from task L's final CAD: robot 2.4388 kg (was 2.4442), COM x −16.17 mm (the CAD's worst case −13.68 mm); the LiDAR scan plane is at 0.1275 m and the Unreal LiDAR column reaches 0.13515 m. Both sim2d scenario suites and goto_wall give logs byte-identical to main's; the 2D house completes 6 of 6 runs (median 790 s, main 763 s). sim2d has no camera, so in the 2D house the sofa base (underside 130 mm,
now between the scan line and the turret top) is found only by stall marks after the turret meets it; the front camera's overhang
detection is task M (LIO-121).

## 14. IMU calibration at bring-up

The GY-521 (MPU-6050) is not usable raw. Its datasheet allows a gyro zero-rate offset of up to ±20 °/s per axis, and accelerometer
zero-g offsets of ±50 mg (x, y) and ±80 mg (z). With the z offset alone the measured gravity can be 0.8 m/s² off 9.8: the controller's
gravity check would never pass, the attitude would never initialise, and the robot would stop with "tilted or attitude unknown". Bay
B11 added the calibration to the controller (`controller/autonomy/imu.py`) and tested it against a simulated board drawn near these
corners (`Content/RobotData/sensor-errors.json` in the simulator).

**Once, at bring-up** (and again after the bay board or the GY-521 is removed, re-seated or replaced):
1. **Where.** A flat, hard, plain floor (not a rug: the four cliff ToF sensors must see one plane), with 0.5 m clear all round.
2. **Warm up (preferred, not required).** About 10 min powered, Jetson running, puts the board near its working temperature. A cold
   calibration also works: the simulator calibrates cold, which is the worse case for the drift that follows. Either way the controller
   corrects the remaining temperature drift online, from the cliff floor plane, at every rest.
3. **Level, two headings.** The robot must be still with no motion command for 0.5 s; the motors may be on. Run the level
   calibration: `autonomy.imu.level_calibration`, driven by `controller/imu_level_calibration.py`. Today that tool reads the
   simulator; on the robot it must read the Pico's IMU stream, which is wired up with the firmware. Keep the robot still for the 5 s
   it records. Then turn it 180° by hand on the same spot and keep it still for 5 s more. The two headings cancel the floor's own tilt; the cliff ToF floor plane gives the
   reference attitude.
4. **Spin.** Motors on. The robot turns in place two full turns each way at 0.5 rad/s, so keep the 0.5 m clear. This measures how
   much of the yaw rate leaks into the x / y gyro (cross-axis sensitivity ±2 % plus the module's mounting tilt). The body's own
   vibration while spinning averages out over the two turns. The tilt of the spin axis, which the cliff floor plane sees, is taken
   out.
5. **Result.** `Content/RobotData/imu-calibration.json`: per-axis accelerometer offsets, the reference gravity, and the yaw coupling.
   The tool installs the file only if every check passes. Otherwise it writes `imu-calibration.rejected.json` and stops. The limits
   live in one place, `controller/autonomy/imu.py` (`LEVEL_HEADING_DIFF_LIMIT_M_S2`, `LEVEL_FLOOR_ATTITUDE_LIMIT_DEG`,
   `LEVEL_OFFSET_LIMIT_M_S2`, `YAW_COUPLING_LIMIT`); they are quoted here.

   **The real fault detectors:**
   - **Heading residuals.** The two headings' residuals must agree within 0.2 m/s² per axis. That is twice the floor's tilt times g,
     about 0.6°. A larger difference means the floor is not flat or the robot moved: move it and repeat.
   - **Floor attitude.** The cliff floor-plane attitude at rest must be ≤ 0.5°. More means the robot is not sitting flat on its wheels
     and caster (debris, an uneven spot) or a cliff ToF sensor reads off. Fix that rather than accept the numbers. A tilted GY-521 does
     not show here: it goes into the x / y offsets.

   **Gross-fault bounds:**
   - **Offsets:** |x|, |y| ≤ 0.75 and |z| ≤ 1.2 m/s². The stored offsets also absorb the accelerometer's sensitivity (±3 % of g) and
     cross-axis error (±2 % of g), so an in-spec MPU-6050 stores up to ±0.69 / ±0.69 / ±1.08 m/s² cold, and ±0.733 / ±0.733 /
     ±1.158 m/s² after the preferred 10-min warm-up (the zero-g temperature drift). Values beyond the bounds mean a broken sensor or a
     wrong range setting.
   - **Couplings:** ≤ 0.05 (cross-axis 2 % plus the mounting tilt).

**At every power-on** the robot calibrates the gyro bias itself. It must stand still for 2 s with no motion command; the motors may
be on. Do not touch it. It waits in its first measuring stop until this is done; if it never gets 2 s of stillness within 30 s it stops
with a message (Mapping and Go-to). After that, every stop re-estimates the bias (zero-velocity updates), and the
cliff floor plane keeps the accelerometer offsets right as the board warms.

**Firmware requirement (ruling PB27).**
- **Filter.** The Pico configures the MPU-6050 with **DLPF_CFG = 4**: gyro bandwidth 20 Hz, accelerometer 21 Hz.
- **Rate.** It forwards samples to the Jetson at **20 Hz**: either one sample per 20 Hz tick, or the samples in each 50 ms averaged.
- **Raw values.** Gyro at FS ±250 °/s, accelerometer at ±2 g, with no offset correction of its own.
- **Why it matters.** The controller's noise-dependent constants derive from these numbers (`IMU_DLPF_CFG`, `IMU_BANDWIDTH_HZ`,
  `IMU_RATE_HZ` in `imu.py`). Changing the firmware means changing them there.
- **Not calibrated.** The gyro scale factor (±3 %): the LiDAR corrects the heading every scan.
- **Floor-slope caveat.** The online offset correction treats the floor under the cliff sensors as level. Resting on a sloped floor
  it can learn up to ±0.5 m/s² (about 3°) of slope, with a 30 s time constant, and carry it into areas where the floor plane is
  invalid. That uses part of the tilt stop's 0.15 rad (8.6°) margin.
