liorknafo/home-robot/home-robot-sim/tests/fixtures/dining-chairs/chair_south_350_001724.png

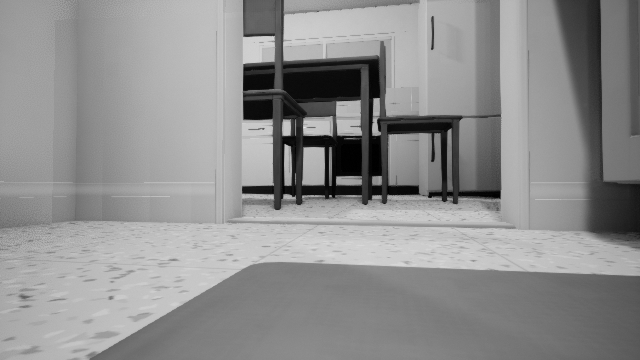
home-robot-sim/tests/fixtures/dining-chairs/chair_south_350_001724.png
