liorknafo/home-robot/home-robot-sim/tests/fixtures/dining-chairs/chair_south_350_001725.png

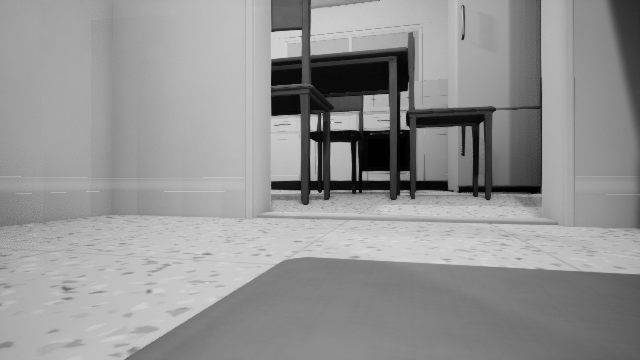
home-robot-sim/tests/fixtures/dining-chairs/chair_south_350_001725.png
