liorknafo/home-robot/home-robot-sim/tests/fixtures/dining-chairs/chair_south_350_001745.png

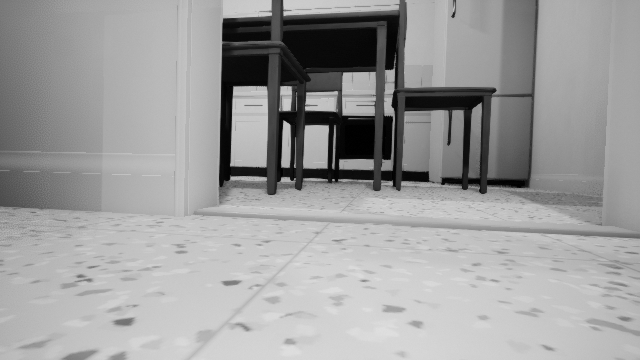
home-robot-sim/tests/fixtures/dining-chairs/chair_south_350_001745.png
