liorknafo/home-robot/home-robot-sim/tests/fixtures/dining-chairs/chair_south_350_001749.png

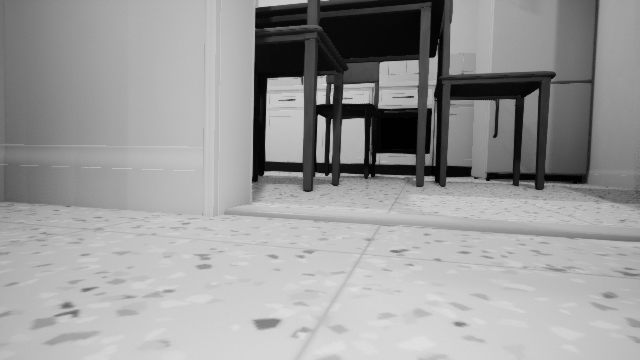
home-robot-sim/tests/fixtures/dining-chairs/chair_south_350_001749.png
