liorknafo/home-robot/home-robot-sim/tests/fixtures/dining-chairs/chair_south_937_004654.png

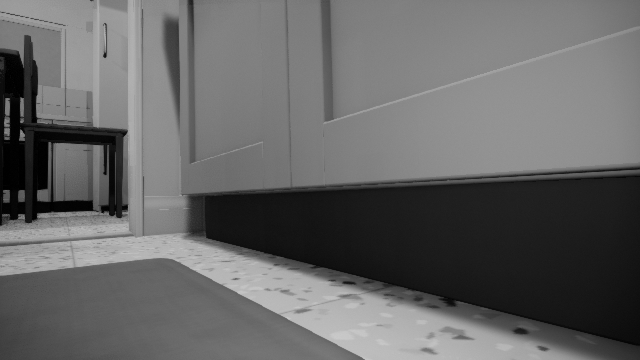
home-robot-sim/tests/fixtures/dining-chairs/chair_south_937_004654.png
