liorknafo/home-robot/home-robot-sim/tests/fixtures/dining-chairs/chair_south_937_004656.png

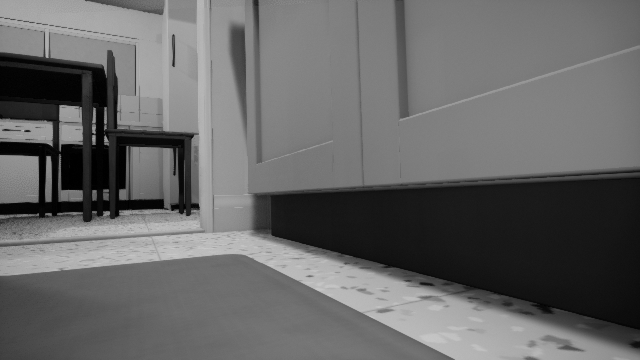
home-robot-sim/tests/fixtures/dining-chairs/chair_south_937_004656.png
