liorknafo/home-robot/home-robot-sim/tests/fixtures/dining-chairs/chair_south_937_004668.png

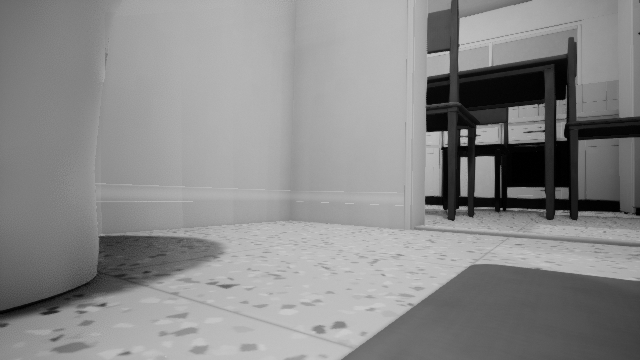
home-robot-sim/tests/fixtures/dining-chairs/chair_south_937_004668.png
