liorknafo/home-robot/home-robot-sim/tests/fixtures/dining-chairs/chair_south_937_004669.png

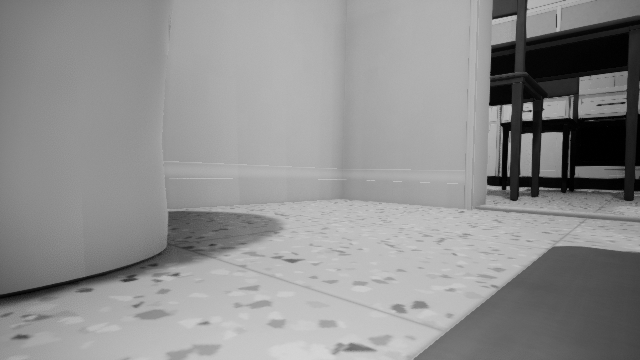
home-robot-sim/tests/fixtures/dining-chairs/chair_south_937_004669.png
