liorknafo/home-robot/home-robot-sim/tests/fixtures/floor_parallax/bathroom_001464.png

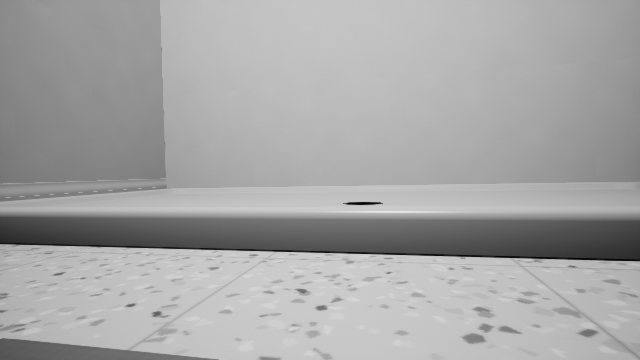
home-robot-sim/tests/fixtures/floor_parallax/bathroom_001464.png
