liorknafo/home-robot/home-robot-sim/tests/fixtures/floor_parallax/bathroom_001474.png

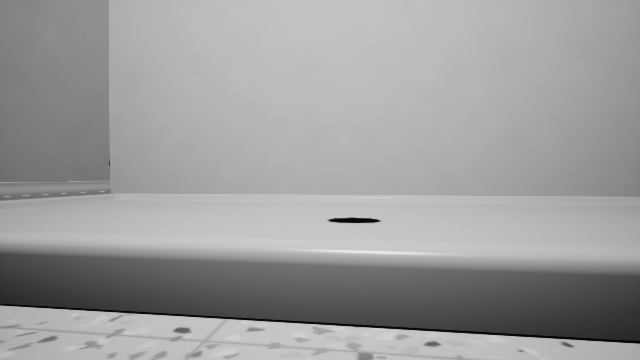
home-robot-sim/tests/fixtures/floor_parallax/bathroom_001474.png
