liorknafo/home-robot/home-robot-sim/tests/fixtures/floor_parallax/bathroom_001477.png

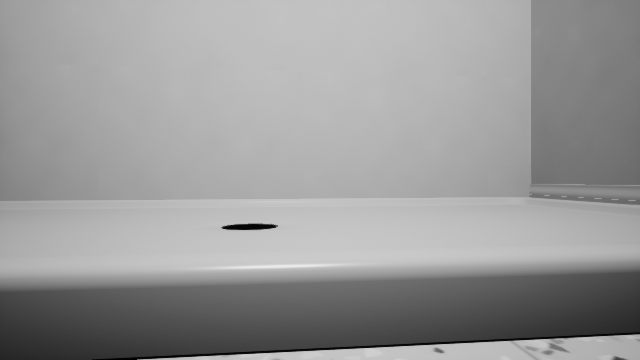
home-robot-sim/tests/fixtures/floor_parallax/bathroom_001477.png
