liorknafo/home-robot/home-robot-sim/tests/fixtures/floor_parallax/threshold_000037.png

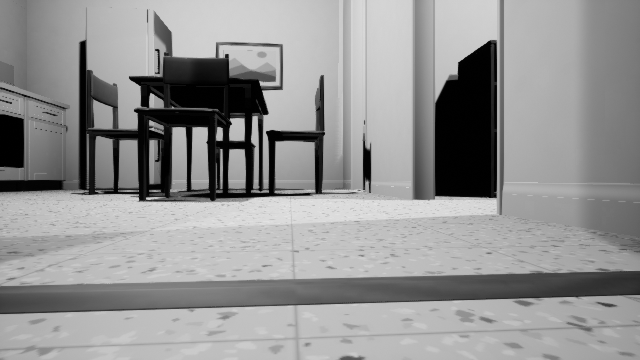
home-robot-sim/tests/fixtures/floor_parallax/threshold_000037.png
