liorknafo/home-robot/home-robot-sim/tests/fixtures/floor_parallax/threshold_000055.png

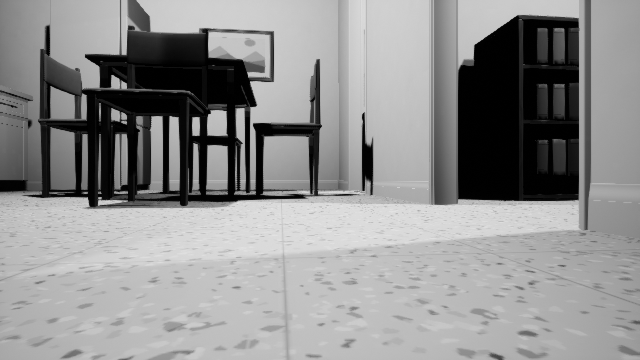
home-robot-sim/tests/fixtures/floor_parallax/threshold_000055.png
