liorknafo/home-robot/home-robot-sim/tests/fixtures/floor_parallax/threshold_000061.png

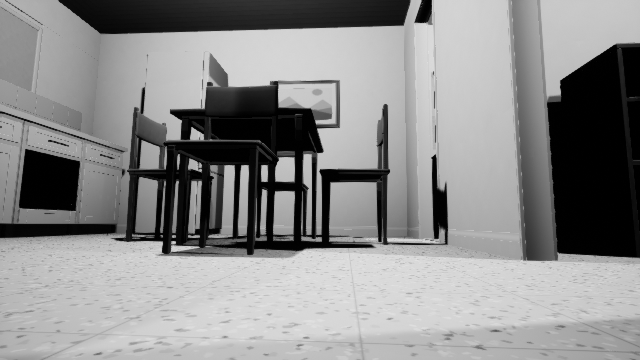
home-robot-sim/tests/fixtures/floor_parallax/threshold_000061.png
