liorknafo/home-robot/home-robot-sim/tests/fixtures/floor_parallax/threshold_000067.png

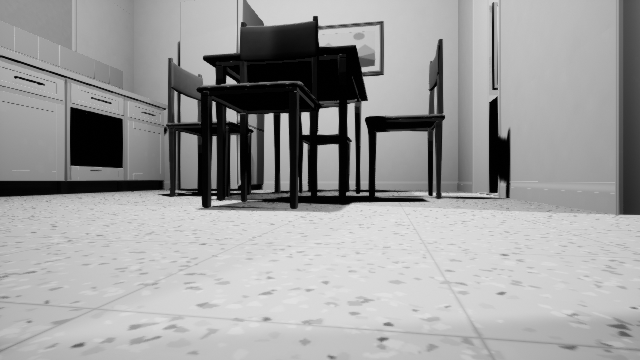
home-robot-sim/tests/fixtures/floor_parallax/threshold_000067.png
