liorknafo/home-robot/home-robot-sim/tests/fixtures/slipper-side-approach/left_000297.png

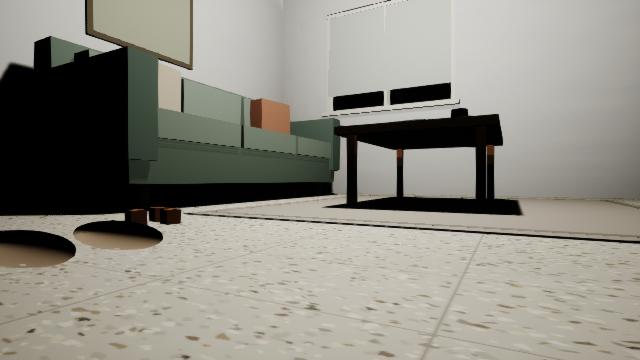
home-robot-sim/tests/fixtures/slipper-side-approach/left_000297.png
