liorknafo/home-robot/home-robot-sim/tests/fixtures/slipper-side-approach/left_000319.png

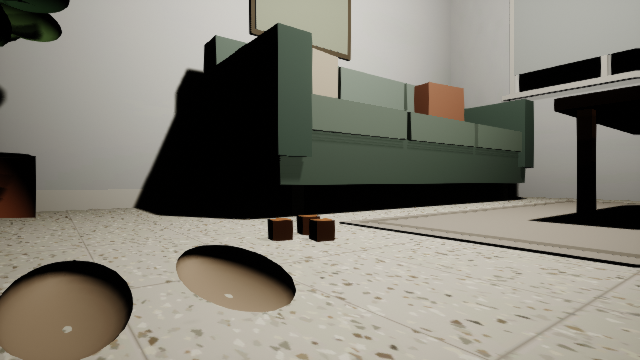
home-robot-sim/tests/fixtures/slipper-side-approach/left_000319.png
