liorknafo/home-robot/home-robot-sim/tests/fixtures/slipper-side-approach/left_000321.png

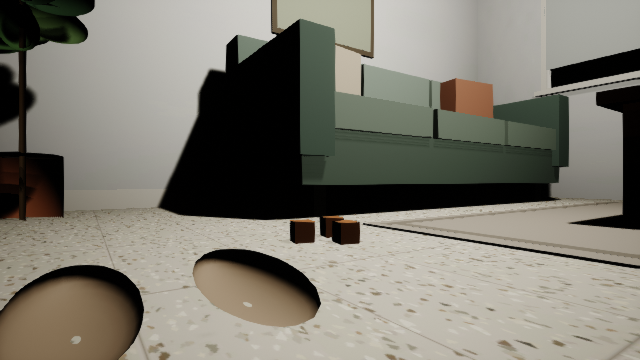
home-robot-sim/tests/fixtures/slipper-side-approach/left_000321.png
