liorknafo/home-robot/home-robot-sim/tests/fixtures/slipper-side-approach/left_000331.png

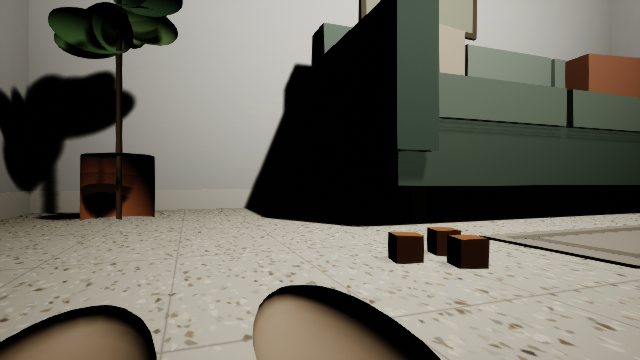
home-robot-sim/tests/fixtures/slipper-side-approach/left_000331.png
