liorknafo/home-robot/home-robot-sim/tests/fixtures/slipper-side-approach/left_000335.png

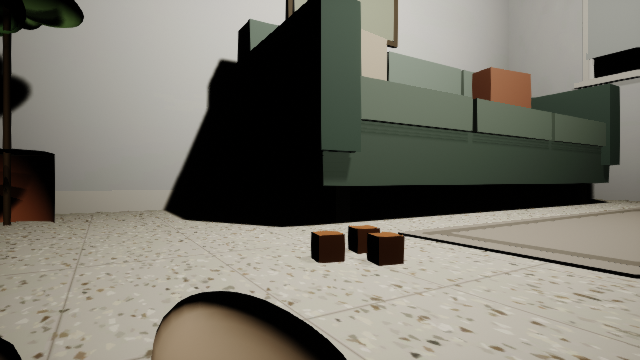
home-robot-sim/tests/fixtures/slipper-side-approach/left_000335.png
