liorknafo/home-robot/home-robot-sim/tests/fixtures/sofa-approach/angled_p045_000037.png

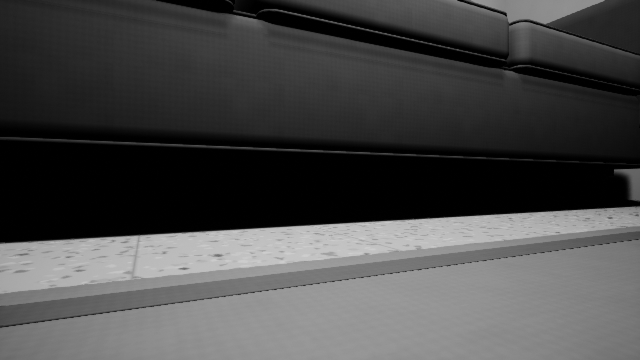
home-robot-sim/tests/fixtures/sofa-approach/angled_p045_000037.png
