liorknafo/home-robot/home-robot-sim/tests/fixtures/sofa-approach/angled_p045_000038.png

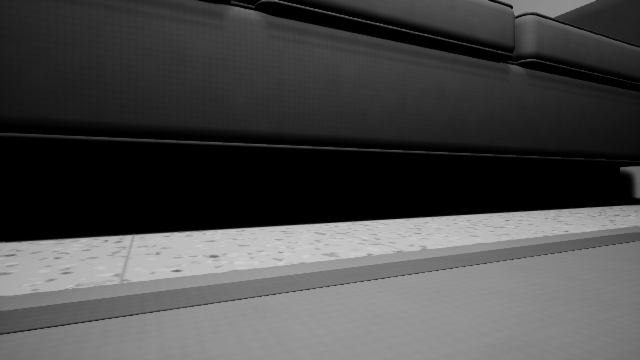
home-robot-sim/tests/fixtures/sofa-approach/angled_p045_000038.png
