liorknafo/home-robot/home-robot-sim/tests/fixtures/sofa-approach/angled_p045_000054.png

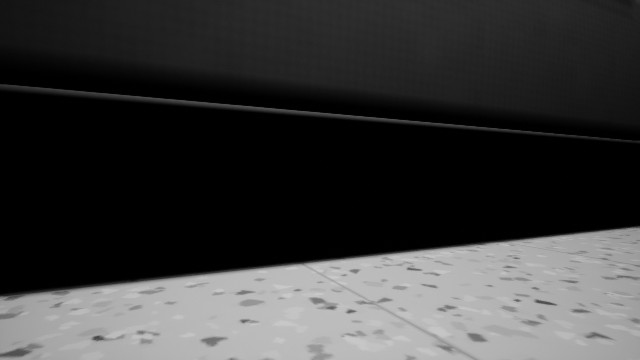
home-robot-sim/tests/fixtures/sofa-approach/angled_p045_000054.png
