liorknafo/home-robot/home-robot-sim/tests/fixtures/sofa-approach/straight_y150_000019.png

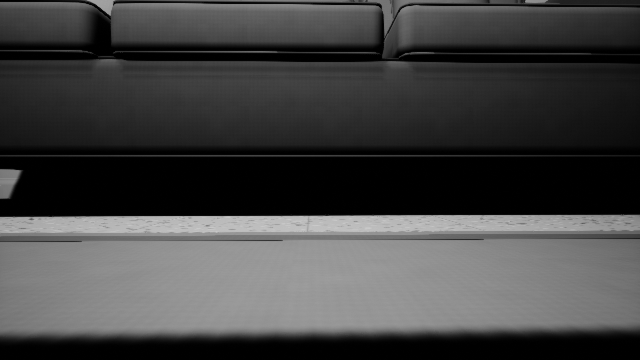
home-robot-sim/tests/fixtures/sofa-approach/straight_y150_000019.png
