liorknafo/home-robot/home-robot-sim/tests/fixtures/sofa-south-end/south_end_001488.png

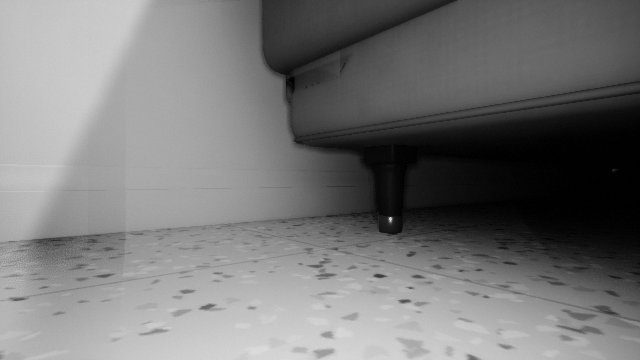
home-robot-sim/tests/fixtures/sofa-south-end/south_end_001488.png
