liorknafo/home-robot/home-robot-r1/pcb/fab/r1_power_io-1to1.pdf

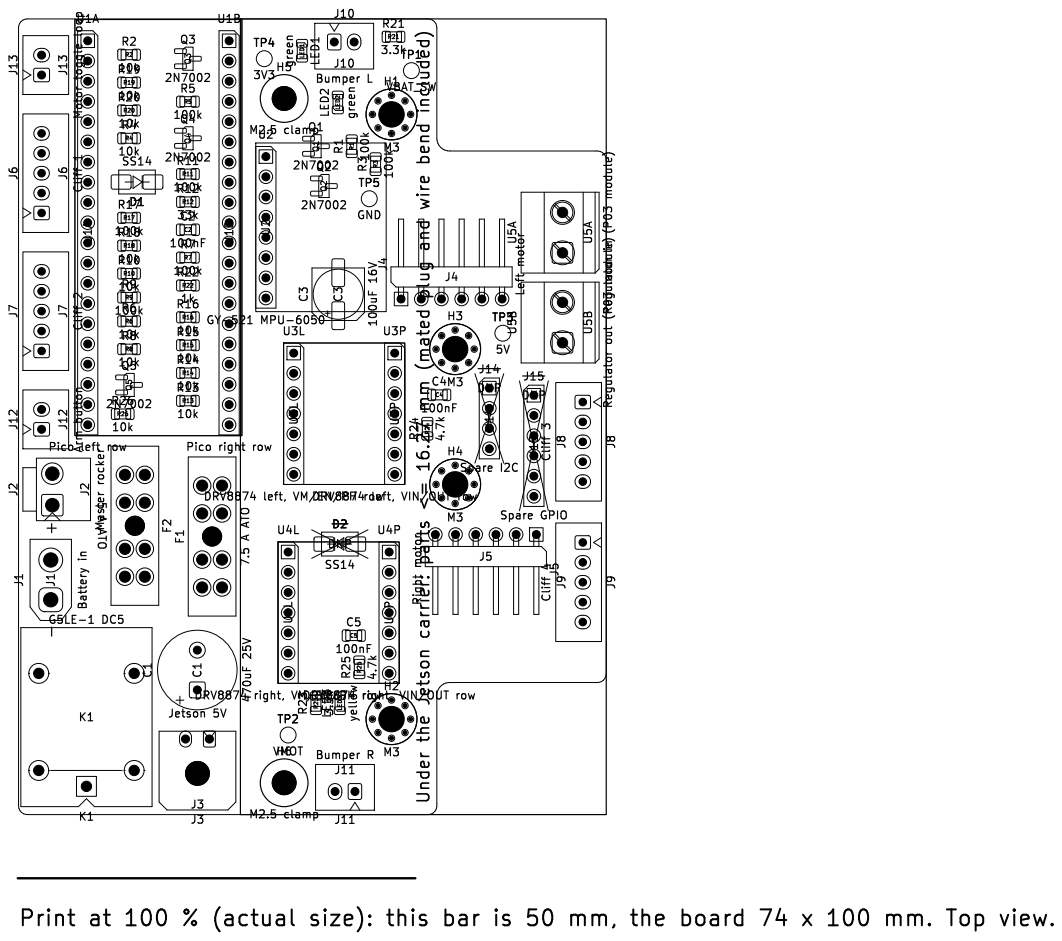
[picture p234: page 1]

Id: 1/4 Title: R1 bay board, 4 layers, 74 x 100 mm, 1:1

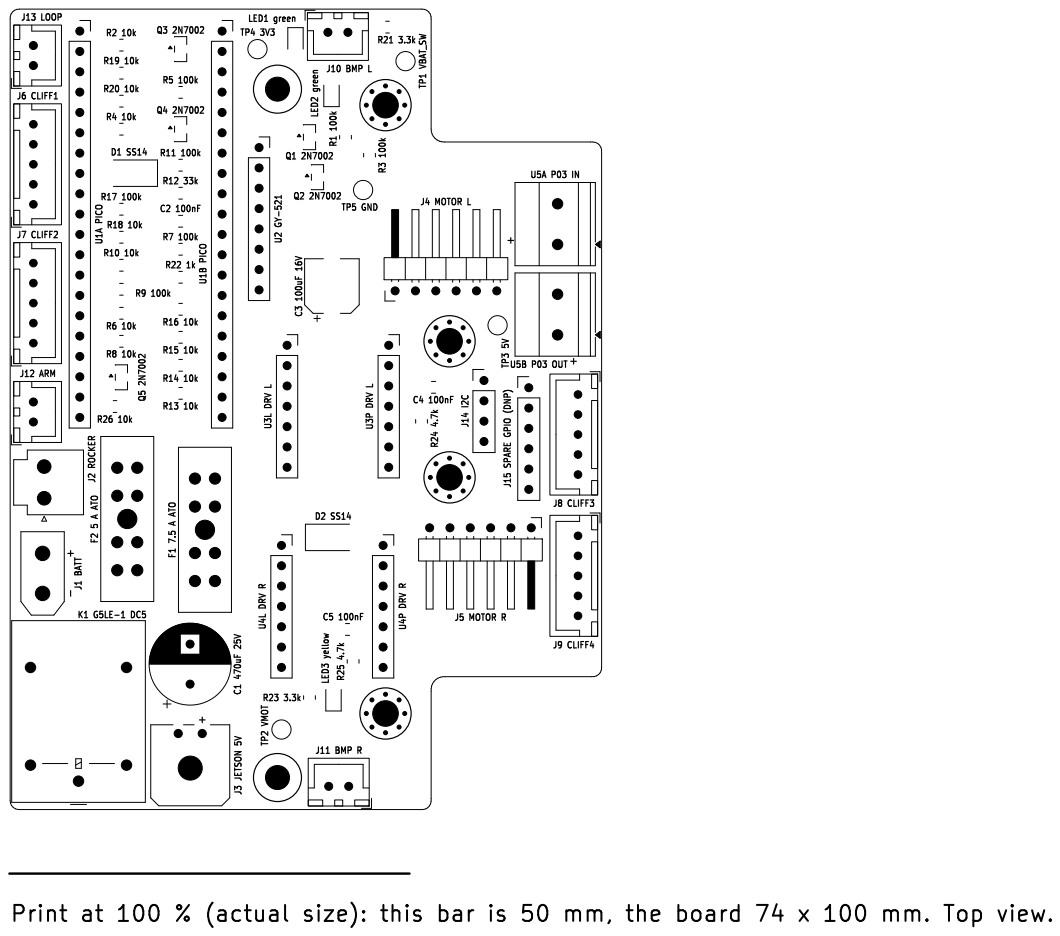
[picture p235: page 2]

Id: 2/4 Title: R1 bay board, 4 layers, 74 x 100 mm, 1:1

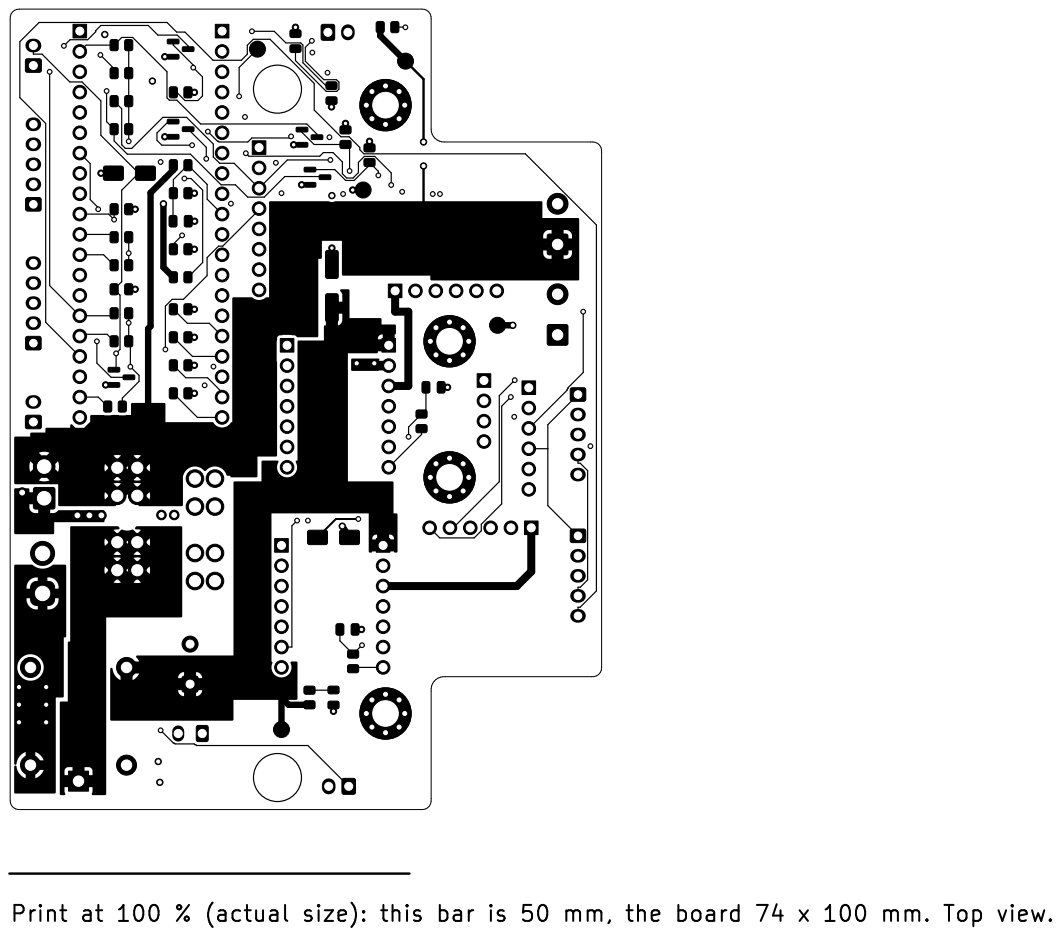
[picture p236: page 3]

Id: 3/4 Title: R1 bay board, 4 layers, 74 x 100 mm, 1:1

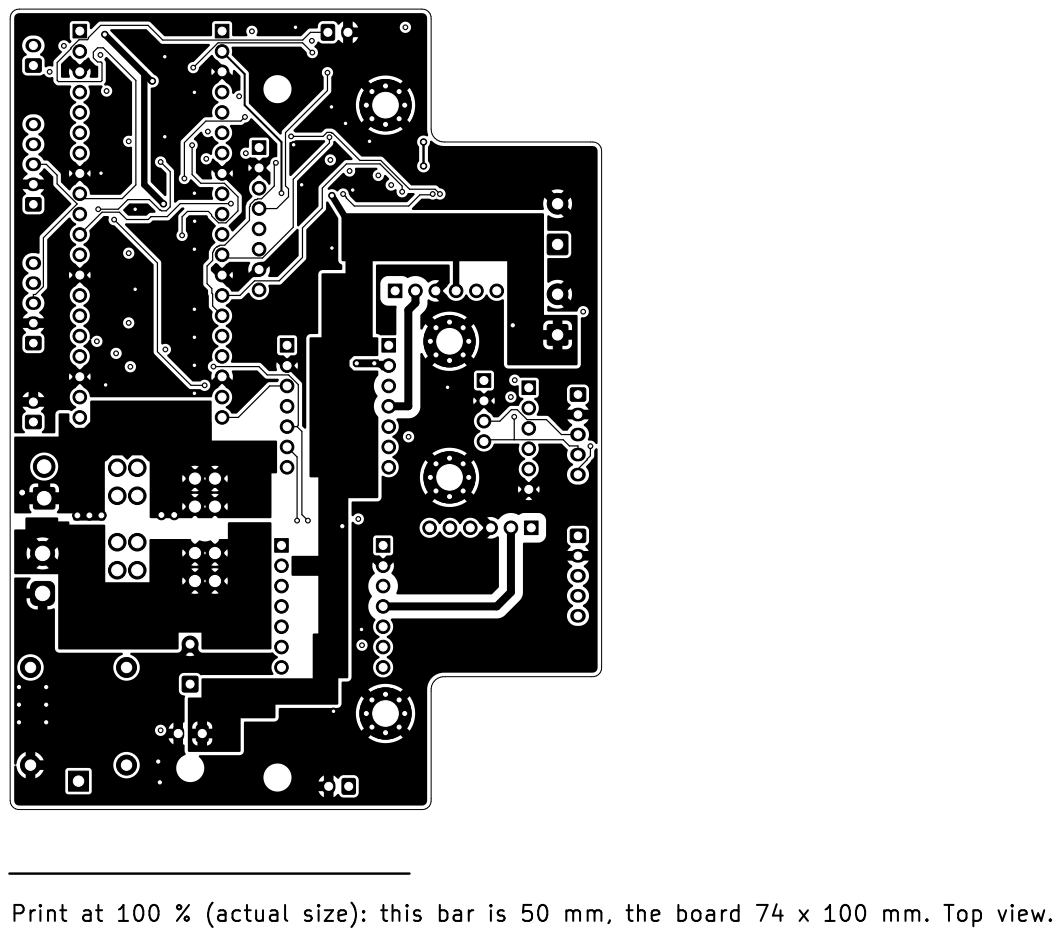
[picture p237: page 4]

Id: 4/4 Title: R1 bay board, 4 layers, 74 x 100 mm, 1:1
