liorknafo/home-robot/home-robot-r1/pcb/r1_power_io.kicad_pcb

## KiCad design home-robot-r1/pcb/r1_power_io.kicad_pcb (2026-10-20)

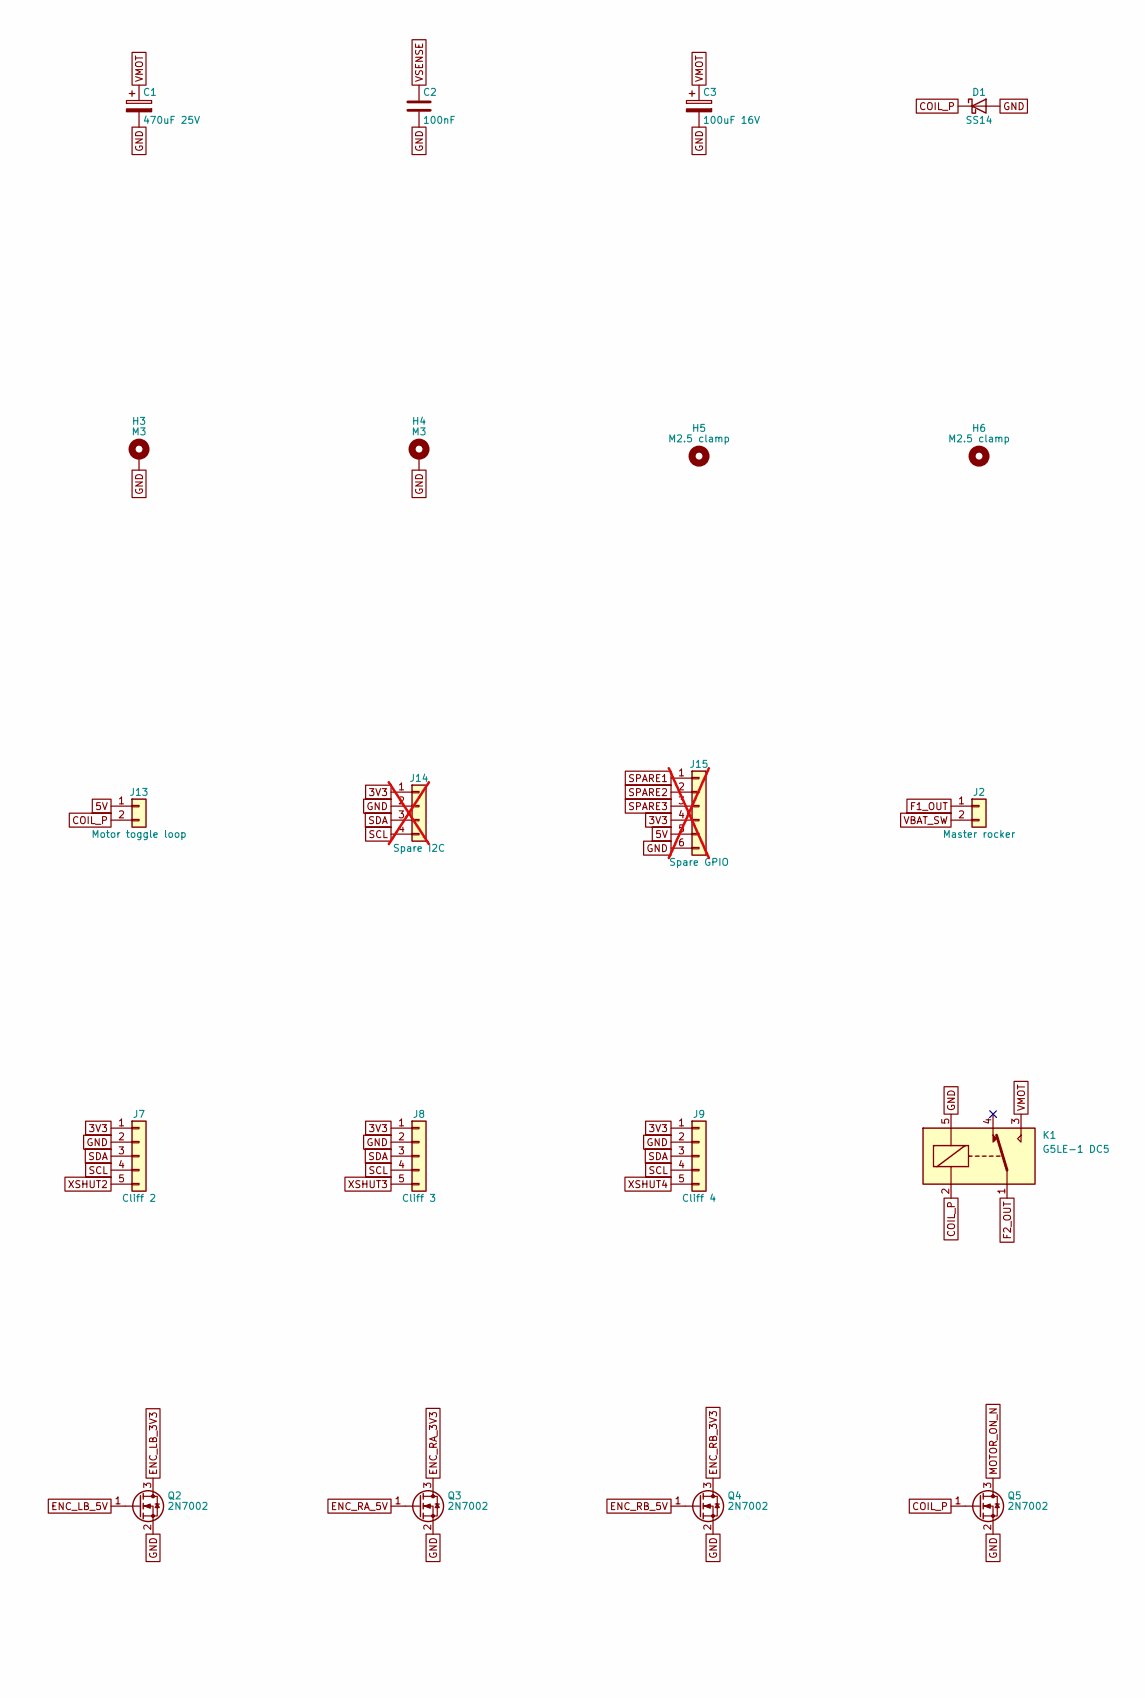
[picture p238: schematic r1_power_io.kicad_sch, part in row 1, column 1]

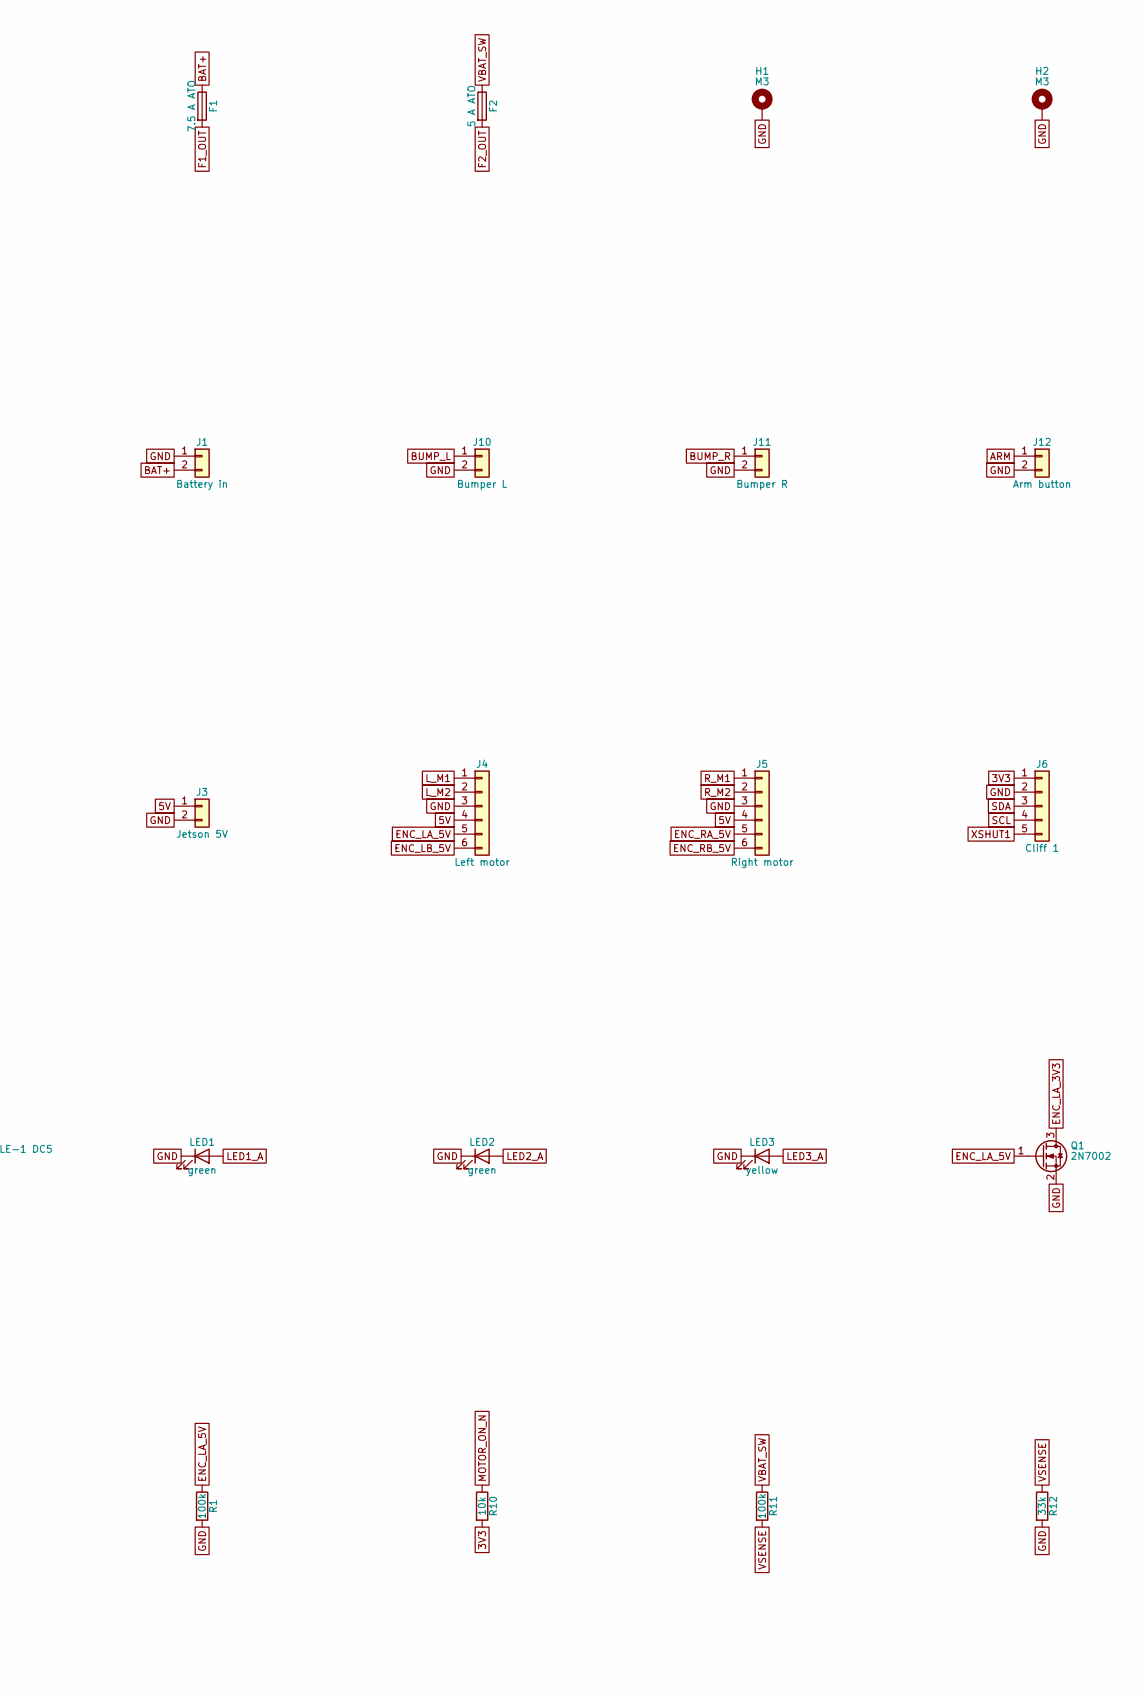
[picture p239: schematic r1_power_io.kicad_sch, part in row 1, column 2]

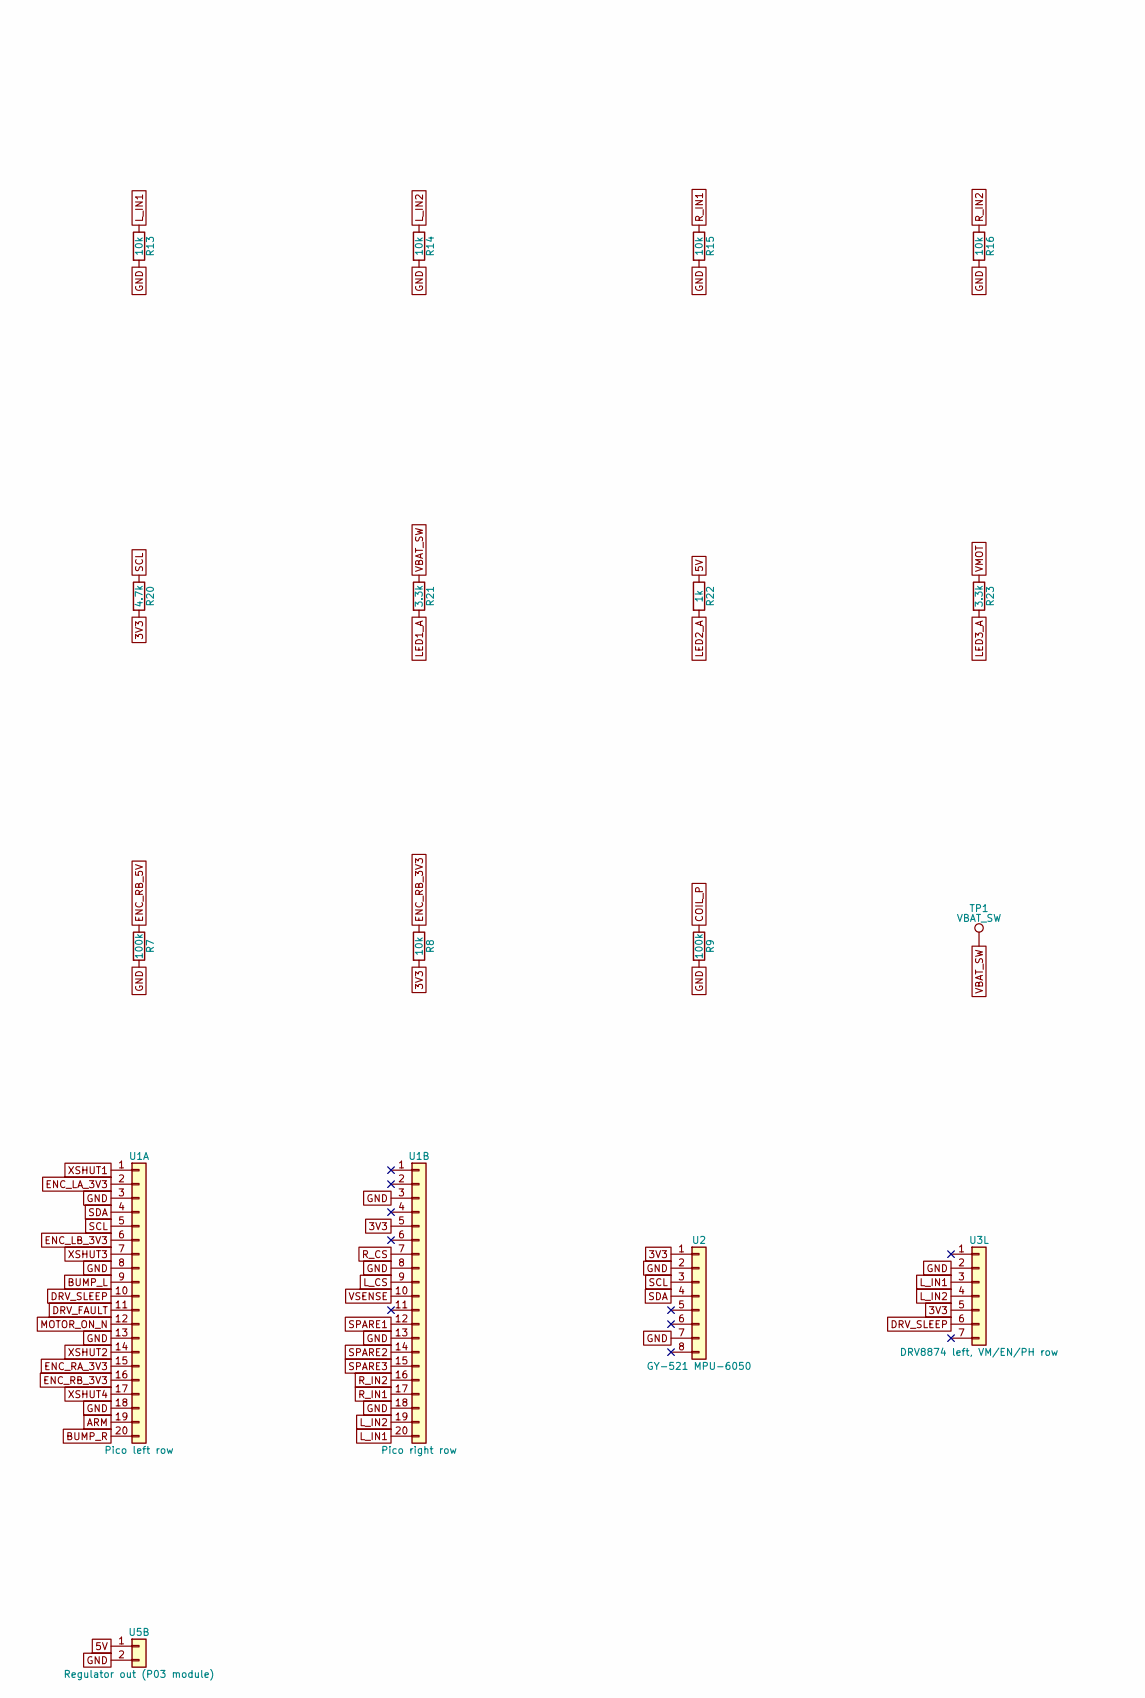
[picture p240: schematic r1_power_io.kicad_sch, part in row 2, column 1]

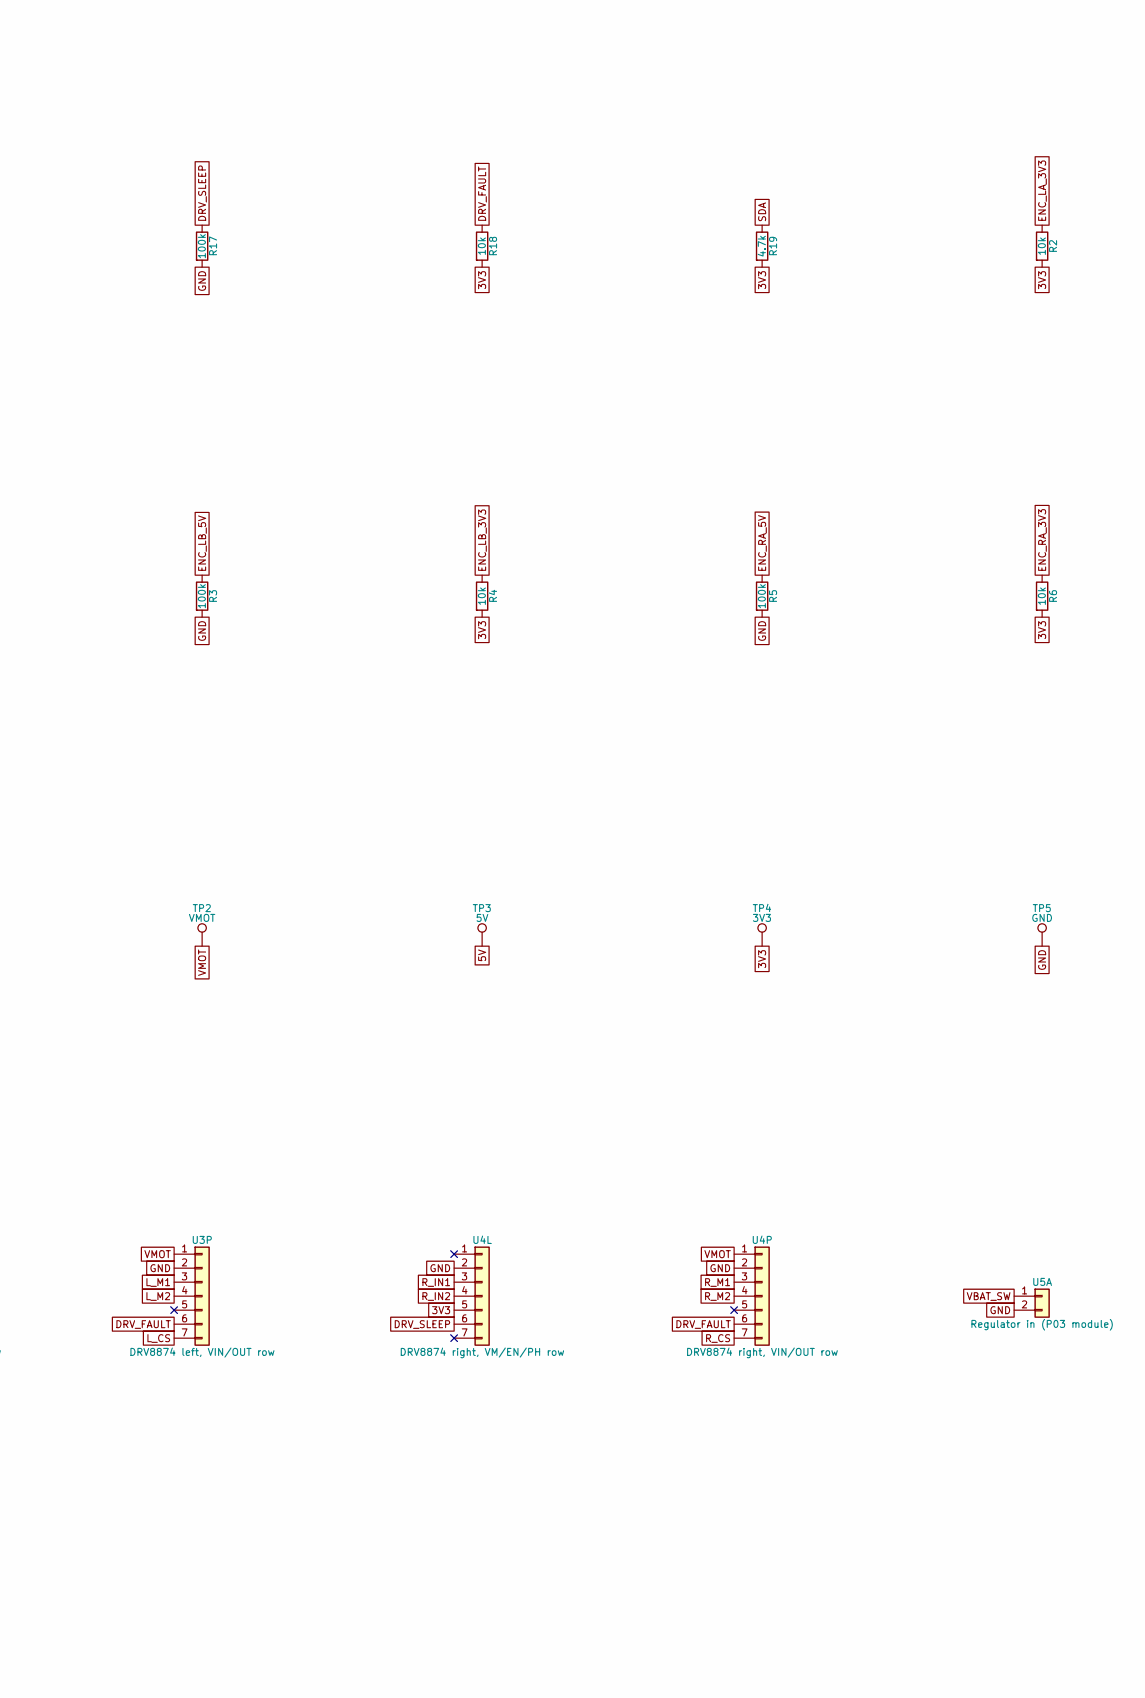
[picture p241: schematic r1_power_io.kicad_sch, part in row 2, column 2]

Parts:
C1: 470uF 25V; CP_Radial_D10.0mm_P5.00mm
C2: 100nF; C_0805_2012Metric
C3: 100uF 16V; CP_Elec_6.3x5.8
D1: SS14; D_SMA
F1: 7.5 A ATO; FuseHolder_Blade_ATO_Littelfuse_FLR_178.6165
F2: 5 A ATO; FuseHolder_Blade_ATO_Littelfuse_FLR_178.6165
H1, H2, H3, H4: M3; MountingHole_3.2mm_M3_Pad_Via
H5, H6: M2.5 clamp; MountingHole_3mm
J1: Battery in; AMASS_XT30UPB-M_1x02_P5.0mm_Vertical
J2: Master rocker; JST_VH_B2P-VH_1x02_P3.96mm_Vertical
J3: Jetson 5V; Molex_Micro-Fit_3.0_43650-0200_1x02_P3.00mm_Horizontal
J4: Left motor; PinHeader_1x06_P2.54mm_Horizontal
J5: Right motor; PinHeader_1x06_P2.54mm_Horizontal
J6: Cliff 1; JST_XH_B5B-XH-A_1x05_P2.50mm_Vertical
J7: Cliff 2; JST_XH_B5B-XH-A_1x05_P2.50mm_Vertical
J8: Cliff 3; JST_XH_B5B-XH-A_1x05_P2.50mm_Vertical
J9: Cliff 4; JST_XH_B5B-XH-A_1x05_P2.50mm_Vertical
J10: Bumper L; JST_XH_B2B-XH-A_1x02_P2.50mm_Vertical
J11: Bumper R; JST_XH_B2B-XH-A_1x02_P2.50mm_Vertical
J12: Arm button; JST_XH_B2B-XH-A_1x02_P2.50mm_Vertical
J13: Motor toggle loop; JST_XH_B2B-XH-A_1x02_P2.50mm_Vertical
J14: Spare I2C; PinHeader_1x04_P2.54mm_Vertical; not fitted
J15: Spare GPIO; PinHeader_1x06_P2.54mm_Vertical; not fitted
K1: G5LE-1 DC5; Relay_SPDT_Omron-G5LE-1
LED1, LED2: green; LED_0805_2012Metric
LED3: yellow; LED_0805_2012Metric
Q1, Q2, Q3, Q4, Q5: 2N7002; SOT-23
R1, R3, R5, R7, R9, R11, R17: 100k; R_0805_2012Metric
R2, R4, R6, R8, R10, R13, R14, R15, R16, R18: 10k; R_0805_2012Metric
R12: 33k; R_0805_2012Metric
R19, R20: 4.7k; R_0805_2012Metric
R21, R23: 3.3k; R_0805_2012Metric
R22: 1k; R_0805_2012Metric
TP1: VBAT_SW; TestPoint_Pad_D2.0mm
TP2: VMOT; TestPoint_Pad_D2.0mm
TP3: 5V; TestPoint_Pad_D2.0mm
TP4: 3V3; TestPoint_Pad_D2.0mm
TP5: GND; TestPoint_Pad_D2.0mm
U1A: Pico left row; PinSocket_1x20_P2.54mm_Vertical
U1B: Pico right row; PinSocket_1x20_P2.54mm_Vertical
U2: GY-521 MPU-6050; PinSocket_1x08_P2.54mm_Vertical
U3L: DRV8874 left, VM/EN/PH row; PinSocket_1x07_P2.54mm_Vertical
U3P: DRV8874 left, VIN/OUT row; PinSocket_1x07_P2.54mm_Vertical
U4L: DRV8874 right, VM/EN/PH row; PinSocket_1x07_P2.54mm_Vertical
U4P: DRV8874 right, VIN/OUT row; PinSocket_1x07_P2.54mm_Vertical
U5A: Regulator in (P03 module); TerminalBlock_Phoenix_MKDS-1,5-2-5.08_1x02_P5.08mm_Horizont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
U5B: Regulator out (P03 module); TerminalBlock_Phoenix_MKDS-1,5-2-5.08_1x02_P5.08mm_Horizont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

Connections:
3V3: J6.1, J7.1, J8.1, J9.1, J14.1, J15.4, R2.2, R4.2, R6.2, R8.2, R10.2, R18.2, R19.2, R20.2, TP4.1, U1B.5, U2.1, U3L.5, U4L.5; also elsewhere on the board
5V: J3.1, J4.4, J5.4, J13.1, J15.5, R22.1, TP3.1, U5B.1; also elsewhere on the board
ARM: J12.1, U1A.19; also elsewhere on the board
BAT+: F1.1, J1.2
BUMP_L: J10.1, U1A.9
BUMP_R: J11.1, U1A.20
COIL_P: D1.1 (K), J13.2, K1.2, Q5.1 (G), R9.1
DRV_FAULT: R18.1, U1A.11, U3P.6, U4P.6
DRV_SLEEP: R17.1, U1A.10, U3L.6, U4L.6
ENC_LA_3V3: Q1.3 (D), R2.1, U1A.2
ENC_LA_5V: J4.5, Q1.1 (G), R1.1
ENC_LB_3V3: Q2.3 (D), R4.1, U1A.6
ENC_LB_5V: J4.6, Q2.1 (G), R3.1
ENC_RA_3V3: Q3.3 (D), R6.1, U1A.15
ENC_RA_5V: J5.5, Q3.1 (G), R5.1
ENC_RB_3V3: Q4.3 (D), R8.1, U1A.16
ENC_RB_5V: J5.6, Q4.1 (G), R7.1
F1_OUT: F1.2, J2.1
F2_OUT: F2.2, K1.1
GND: C1.2, C2.2, C3.2, D1.2 (A), H1.1, H2.1, H3.1, H4.1, J1.1, J3.2, J4.3, J5.3, J6.2, J7.2, J8.2, J9.2, J10.2, J11.2, J12.2, J14.2, J15.6, K1.5, LED1.1 (K), LED2.1 (K), LED3.1 (K), Q1.2 (S), Q2.2 (S), Q3.2 (S), Q4.2 (S), Q5.2 (S), R1.2, R3.2, R5.2, R7.2, R9.2, R12.2, R13.2, R14.2, R15.2, R16.2, R17.2, TP5.1, U1A.3, U1A.8, U1A.13, U1A.18, U1B.3, U1B.8, U1B.13, U1B.18, U2.2, U2.7, U3L.2, U3P.2, U4L.2, U4P.2, U5A.2, U5B.2; also elsewhere on the board
LED1_A: LED1.2 (A), R21.2
LED2_A: LED2.2 (A), R22.2
LED3_A: LED3.2 (A), R23.2
L_IN1: R13.1, U1B.20, U3L.3
L_IN2: R14.1, U1B.19, U3L.4
L_M1: J4.1, U3P.3
L_M2: J4.2, U3P.4
MOTOR_ON_N: Q5.3 (D), R10.1, U1A.12
R_IN1: R15.1, U1B.17, U4L.3
R_IN2: R16.1, U1B.16, U4L.4
R_M1: J5.1, U4P.3
R_M2: J5.2, U4P.4
SCL: J6.4, J7.4, J8.4, J9.4, J14.4, R20.1, U1A.5, U2.3
SDA: J6.3, J7.3, J8.3, J9.3, J14.3, R19.1, U1A.4, U2.4
SPARE1: J15.1, U1B.12
SPARE2: J15.2, U1B.14
SPARE3: J15.3, U1B.15
VBAT_SW: F2.1, J2.2, R11.1, R21.1, TP1.1, U5A.1
VMOT: C1.1, C3.1, K1.3, R23.1, TP2.1, U3P.1, U4P.1
VSENSE: C2.1, R11.2, R12.1, U1B.10
VSYS: U1B.2; also elsewhere on the board
XSHUT1: J6.5, U1A.1
XSHUT2: J7.5, U1A.14
XSHUT3: J8.5, U1A.7
XSHUT4: J9.5, U1A.17

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
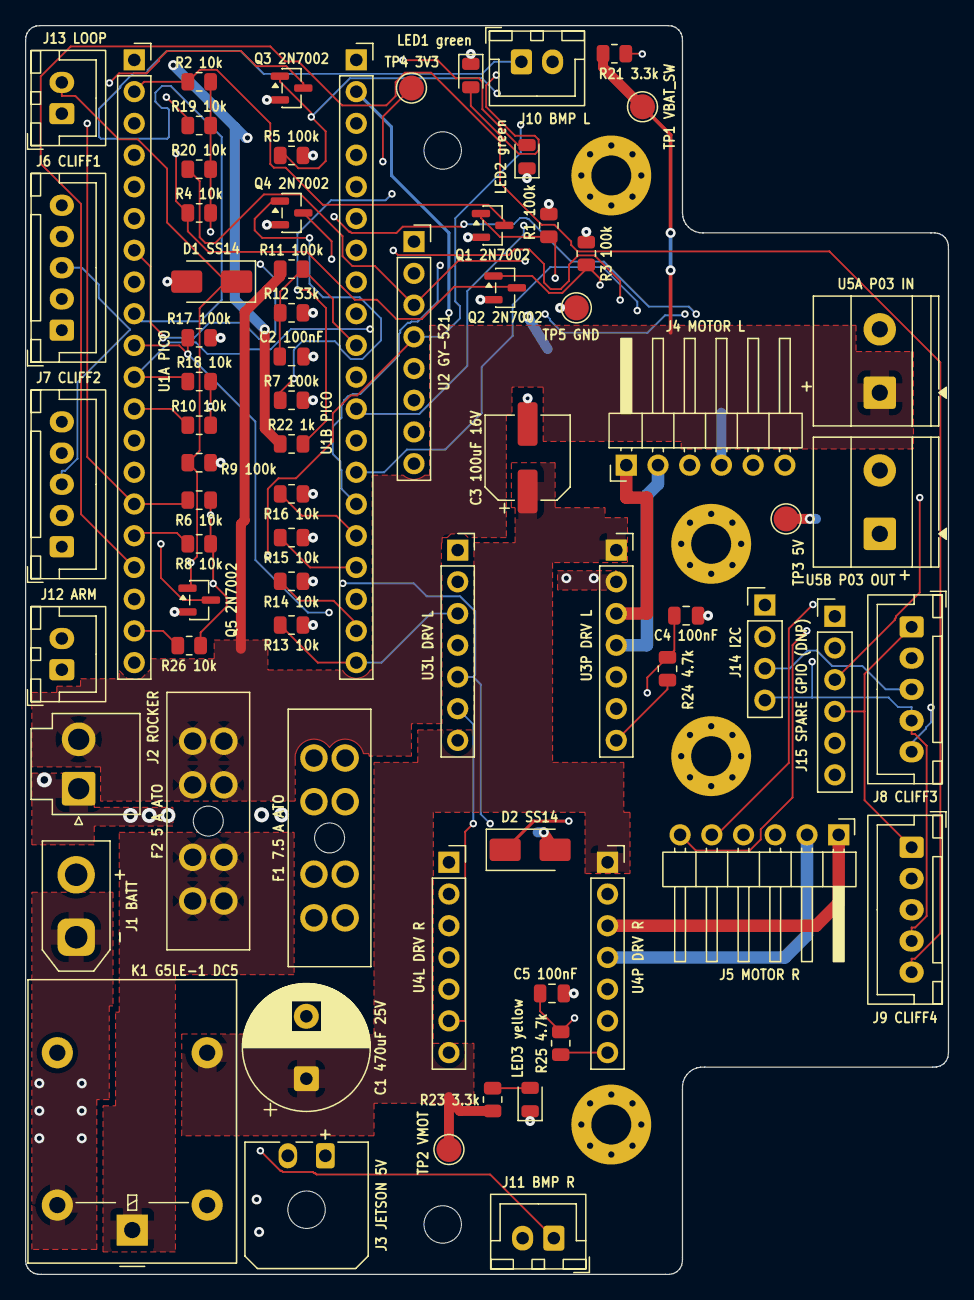
[picture p242: board r1_power_io.kicad_pcb from above]

Board: 4 copper layers, 73.9 x 100.0 mm, 79 parts (0 on the bottom side), 49 nets.

Other parts of the board:
C4, C5: 100nF; C_0805_2012Metric
D2: SS14; D_SMA
R24, R25: 4.7k; R_0805_2012Metric
R26: 10k; R_0805_2012Metric

Their connections:
3V3: R26.2; also elsewhere on the board
5V: D2.2; also elsewhere on the board
ARM: R26.1; also elsewhere on the board
GND: C4.2, C5.2; also elsewhere on the board
VSYS: D2.1; also elsewhere on the board
