liorknafo/home-robot/home-robot-r1/cad/build_robot.py

"""Home Robot R1 — editable CadQuery packaging model, units mm.

Round revision: the drive axle runs through base_link (x=0), the outer contact skin is a 158.9 mm circle (<= 160 with play, tilt and tolerance)
about the z axis (two floating front bumper arcs plus a fixed two-piece rear shell), so the robot turns in
place inside its own footprint. One rear ball caster, centre of mass behind the axle.
Run with cadquery (2.6.1 or 2.8.0) and trimesh. Most electronic parts are dimensioned envelopes; the LiDAR is
the manufacturer LD14 STEP (reference-models/LD14.step). The build ends with cad/check_printability.py
(support-free MK3S gate) and cad/validate_meshes.py. See design-review.html.

`build_robot.py --step-only` (LIO-170) builds the same parts but writes only cad/home-robot-r1.step (git-ignored, so the full-robot
STEP download on the review page works without a tracked file changing): no print-parts, coupons, meshes, JSON, validation or gates.
"""
from pathlib import Path
import json, math, itertools, subprocess, sys
import cadquery as cq
import trimesh
import numpy as np
from OCP.BRepTools import BRepTools

ROOT=Path(__file__).resolve().parents[1]
sys.path.insert(0,str(ROOT))
from pcb import board_spec as BS   # B9: the board's part numbers and pin -> net map for the harness and BOM tables (pure Python)
STEP_ONLY='--step-only' in sys.argv[1:]   # LIO-170: write only cad/home-robot-r1.step (see the docstring)
PRINT=ROOT/'print-parts'; PRINT.mkdir(exist_ok=True)
COUPONS=PRINT/'coupons';COUPONS.mkdir(exist_ok=True)
if not STEP_ONLY:
    for f in list(PRINT.glob('*.stl'))+list(PRINT.glob('*.step'))+list(COUPONS.glob('*.st*')):f.unlink()   # no stale files from removed or renamed parts
STL_TOL=(.02,.1)   # printed-part STL chord tolerance (mm) and angular tolerance (rad): sag <= 0.02 mm on the R157 arcs
# Jetson Nano B01 = NVIDIA's STEP (reference-models/jetson-nano-b01, simplified by cad/simplify_jetson.py); JO = robot position of the STEP
# origin (mounting hole (0, 0)), PCB underside z 57 (see the Jetson block below).
JDIR=ROOT/'reference-models'/'jetson-nano-b01'
JS=json.loads((JDIR/'jetson-nano-b01-simplified.json').read_text())
JO=(25,-46,57)
# Low-profile height chain (L2): ONE derived height drives the whole upper structure. Lid underside = top of the 40 mm fan on the Jetson
# heatsink + a >= 5 mm air gap, rounded up to 0.5 mm. Every height that hung from the deck-era lid (underside z 143) drops by DZ: lid
# sectors and posts, bumper and rear-shell tops (2 mm under the lid), LiDAR tray and LD14, lid switches. The camera no longer hangs from it:
# task F put it in the bumper band, fixed to the chassis behind a window in the bumper (see the camera block).
FAN_H,AIRGAP,LID_T=10.0,5.0,3.0
FS_HEAD=(2.8,2.1)                                       # fan screw pan heads (M3, radius and height) on the fan frame corners
ZFAN_TOP=JO[2]+JS['heatsink']['top_z']+FAN_H           # 95.28
ZLID=math.ceil((ZFAN_TOP+AIRGAP)*2)/2                   # lid underside 100.5
ZLIDT=ZLID+LID_T                                        # lid top 103.5
DZ=143.0-ZLID                                           # 42.5 mm drop from the deck-era lid
# Task L (LIO-120, user's "option 2": as low as the rules allow): the LD14 laser plane sits where the scan-band rule puts its floor, the band
# (plane ± 4 mm) 20 mm over the lid top (validation lidar_mount.scan_band_vertical): 127.5, 20 mm under task F's 147.5 (190 - DZ).
SCAN_OVER_LID,SCAN_HALF_BAND=20.0,4.0
LIDAR_H=ZLIDT+SCAN_OVER_LID+SCAN_HALF_BAND             # 127.5
assert abs((190-DZ)-LIDAR_H-20.0)<1e-9
PARAMS=dict(base_length=244,base_width=200,base_bottom=29,base_thickness=4,
            wheel_diameter=80,wheel_track=228,wheel_x=0,
            camera_baseline=0,camera_height=80.0,camera_x=146,lidar_height=LIDAR_H,lidar_x=54,lidar_yaw_deg=180,
            lidar_note='Task F (user decision 2026-10-11, option B): the LD14 is turned 180 deg about its spin axis (motor toward the back), spin axis x 54: the most forward position at which its '
                       '0.1 m minimum range (LD14P) stays inside the bumper skin with a half pressed to its stop, so the scan sees whatever the bumper touches (a trial at x 109, its front 10 mm inside '
                       'the skin, left a 5 cm blind strip ahead of the bumper). Its 0 deg (tail/motor) direction points along robot -x: a driver scan angle theta (REP-103, CCW, 0 = LD14 tail) maps to '
                       'the robot-frame bearing wrap(theta + 180 deg) into (-180, 180]; a raw LD14 angle a (clockwise from the tail) maps to wrap(180 deg - a). The simulator reports scans in the robot frame already. '
                       'Task L (LIO-120, user request 2026-10-12): the LD14 sits 20 mm lower than in task F, laser plane 127.5 mm (was 147.5): the scan band (plane ± 4 mm) is then exactly 20 mm over '
                       'the lid top, the floor the scan-band rule allows. Its lugs sit straight on the tray plate (no towers); its motor drops into the tray\'s fan intake duct, 1.4 mm over the fan frame.',
            outer_radius=158.9,shell_radius=157.4,rear_shell_radius=152.5,base_radius=148,bumper_tip_radius=152.7,
            bumper_axis_deg=30,bumper_travel=5.0,bumper_z=[18,ZLID-2],bumper_span_deg=90,
            rear_caster=[-75,0,0],caster_ball_radius=12.7,
            cliff_sensors=[[105,72],[105,-72],[-110,81],[-110,-81]],cliff_z=42.5,cliff_fov_deg=25,
            camera_hfov_deg=84,camera_image_px=[640,360],camera_check_image_px=[640,480],camera_check_vfov_deg=68.06,
            camera_led_points=[[145.8,0.0,89.45]],camera_led_intensity_cd=10.8,camera_led_beam_deg=120,camera_led_cct_k=5000,camera_led_current_a=0.059,
            camera_led_note='Task N (LIO-134): one Samsung LM281B+ Pro 2835 LED (5000 K, 37.5 lm at 65 mA / 2.7 V, 120 deg) above the lens, facing forward, '
                            'its emitting face at x 145.8, z 89.45. From J15 pin 5 (5 V) through 39 ohm: (5 - 2.7) / 39 = 59 mA, so ~37.5 x 59 / 65 = 34 lm and '
                            '~34 / pi = 10.8 cd on axis (a near-Lambertian emitter). Switched low-side by a TN0702N3-G MOSFET from GP20 (J15 pin 3).',
            camera_x_note='camera_x = lens front face; the image frustum apex used for every clearance check is 3 mm behind it (x 143), the assumed worst entrance-pupil position; the lens solid centre is x 141.4. '
                         'Task F: the camera sits in the bumper band behind a window in the two bumper halves (level, axis z 80). Below 80 mm the simulator camera loses the 6 cm shower tray in Unreal '
                         '(straight drives at it: found in 6/10 at 75 mm, 10/10 at 80 mm); 80 is also the highest axis whose image still fits a window closed under the 98.5 mm bumper top.',
            camera_image_note='The simulator renders 640 × 360 (16:9, as the OV2735 1920 × 1080 mode); the CAD clearance check deliberately uses a taller 4:3 frustum (VFOV 68.06 deg), which is conservative.',
            max_speed_mps=0.15,max_speed_source='home-robot-sim DriveCore.h max_speed (forward)',
            reverse_speed_limit_m_s=0.06,reverse_speed_limit_source='firmware reverse speed cap: the simulator firmware caps reverse at 0.06 m/s (the controller never commands more than 0.05 m/s in reverse); the rear-cliff coast check uses it',
            drive_model=dict(max_torque_nm=.10,setpoint_ramp_m_s2=.25,dynamic_brake_nm_per_rad_s=.010,rolling_drag_nm=.003,axle_inertia_kg_m2=.0005,hazard_action='disarm: tl = tr = 0, the wheels then see the simulator dynamic brake (coast)',
                source='home-robot-sim DriveCore.h (max_torque, accel: every wheel setpoint, braking included, ramps at 0.25 m/s2; disarm on hazard) and RobotPawn.cpp / robot-parameters.json (0.010 N m s/rad dynamic brake while disarmed, 0.003 N m rolling drag, 0.0005 kg m2 reflected axle inertia)'),
            base_x_range=[-124,120],printer_bed=[250,210,210])
parts=[]; shapes={}; cables=[]; TESS={}; ALLOW={}; BH=[]; RENDER={}   # RENDER: id -> [(solid, colour)], a render-only detail model (checks use shapes[id])
COL={'print':'#49768a','cover':'#c5d4db','owned':'#32876b','buy':'#bd8a38',
     'metal':'#b5bcc3','black':'#30363b','connector':'#ddcbaa','pcb':'#226c59',
     'power':'#c45749','signal':'#528fbc','usb':'#343c49','lens':'#284350','red':'#c8322d'}
AX=PARAMS['wheel_x']; R_SKIN=PARAMS['outer_radius']; R_SH=PARAMS['shell_radius']; R_RS=PARAMS['rear_shell_radius']; R_BASE=PARAMS['base_radius']; R_TIP=PARAMS['bumper_tip_radius']
WALL=2.4; RWALL=2.8; R_RS_IN=R_RS-RWALL; ZB0,ZB1=PARAMS['bumper_z']; BASE_X=tuple(PARAMS['base_x_range'])   # base plate x -124..120: 4 mm further aft (battery)
RZ=(18,27.5)               # rail / arm / cam band: top 1.5 mm under P_base (1.0 under the 0.5 mm race strips); the balls carry the vertical load
# M3 × 3 brass heat-set inserts (Ø4.0 through holes in the 4 mm plate) take every base screw that is not a rear-shell screw (>= 5 mm PETG
# engagement there). Each is pressed flush with the face its screw enters; the last 1 mm of the hole stays open as a relief for displaced PETG.
INS_R,INS_L=2.0,3.0
def ins_z(face):return 30.0 if face=='top' else 29.0   # insert bottom z: top-face inserts span z 30..33, bottom-face inserts z 29..32
CLIFF=[tuple(c) for c in PARAMS['cliff_sensors']]          # FL, FR, RL, RR
CLIFF_IDS=[CLIFF[2],CLIFF[3],CLIFF[0],CLIFF[1]]            # cliff_1..4 keep their ids: RL, RR, FL, FR
CZ=PARAMS['cliff_z']; CX=PARAMS['rear_caster'][0]; RB=PARAMS['caster_ball_radius']
BX=-96                                                      # battery tray centre: tray rear wall flush with the rear base edge x -124 (COM behind the axle, no ballast)
# Jetson Nano B01 = NVIDIA's STEP (reference-models/jetson-nano-b01, simplified by cad/simplify_jetson.py) on four H05 standoffs: the two
# front ones 24 mm from P_base, the two rear ones 20 mm from the bay board, which they clamp (low profile: no deck).
# The STEP is turned +90 deg about z, so its 100 mm I/O edge faces forward (+x): the USB, barrel
# and Ethernet ports point into the front bay toward the camera mount, and the heatsink and fan (on the far half of the module) sit over
# the axle. JO = robot position of the STEP origin (mounting hole (0, 0)). Carrier PCB underside z 57: motor top 52.5 + the 1.93 mm of
# through-hole leads under the PCB (2.23 allowed) + >= 2 mm; the bumper rail-pin B screws (top z 53) lie ahead of the carrier edge.
# x: the centre-of-mass guard (COM >= 15 mm behind the axle, every sensitivity case >= 14 mm) sets it; the carrier covers the bay board's
# under-carrier zone (x >= -38.5) and its rear standoffs clamp the board (validation com_estimate.placement).
# JDIR, JS and JO are defined at the top (the lid height derives from the fan top).
def J(x,y,z=0):return (JO[0]-y,JO[1]+x,JO[2]+z)   # NVIDIA STEP frame -> robot frame: +90 deg about z, then JO
JC=J(46,22.5)                                               # carrier centre (STEP x -4..96, y -17..62)
JHOLES=[J(*p)[:2] for p in JS['mounting_holes']['xy']]      # 86 × 58 mm pattern: (JO_x, -46), (JO_x - 58, -46), (JO_x, 40), (JO_x - 58, 40)
JFAN=J(*JS['heatsink']['fan_centre'],JS['heatsink']['top_z'])   # fan centre on the heatsink top (32 × 32 mm screw pattern)
JPORT=JS['ports']
JPCB=(JO[0]-62,JO[0]+17,JO[1]-4,JO[1]+96)                   # carrier PCB footprint x0, x1, y0, y1

def box(x,y,z,dx,dy,dz):
    return cq.Workplane('XY').box(dx,dy,dz,centered=(True,True,False)).translate((x,y,z)).val()
def cyl(x,y,z,r,h,axis='z'):
    s=cq.Solid.makeCylinder(r,h,cq.Vector(0,0,0),cq.Vector(0,0,1))
    if axis=='y':s=s.rotate((0,0,0),(1,0,0),-90)
    if axis=='x':s=s.rotate((0,0,0),(0,1,0),90)
    return s.translate((x,y,z))
def tidy(s):   # ShapeUpgrade clean when it succeeds and stays valid
    try:
        c=s.clean();return c if c.isValid() else s
    except Exception:return s
def union(*s):
    return s[0].fuse(*s[1:]) if len(s)>1 else s[0]
def rounded(x,y,z,dx,dy,dz,r=4):
    return cq.Workplane('XY').box(dx,dy,dz,centered=(True,True,False)).edges('|Z').fillet(r).translate((x,y,z)).val()
def hole(s,x,y,z,r,h,axis='z'):return s.cut(cyl(x,y,z,r,h,axis))
def tear(x,y,z,r,h):
    # Vertical hole with a 45 degree teardrop roof toward +x: support-free when the part prints on its -x face.
    k=cq.Workplane('XY').polyline([(0,0),(r*.7071,r*.7071),(r*1.4142,0),(r*.7071,-r*.7071)]).close().extrude(h).val()
    return union(cyl(0,0,0,r,h),k).translate((x,y,z))
def tearh(a,z,r,r0,r1):
    # Horizontal radial hole at azimuth a (deg) from radius r0 to r1, centre height z, 45 deg roof up: support-free upright.
    return tear(0,0,0,r,r1-r0).rotate((0,0,0),(0,1,0),-90).rotate((0,0,0),(0,0,1),a+180).translate((*polar(r0,a),z))
def stadium(p,q,r,z,h):
    # Straight slot between centres p and q (plan view), radius r, from z to z+h.
    (x0,y0),(x1,y1)=p,q;L=math.dist(p,q)
    s=box(0,0,z,L,2*r,h).rotate((0,0,0),(0,0,1),math.degrees(math.atan2(y1-y0,x1-x0))).translate(((x0+x1)/2,(y0+y1)/2,0))
    return union(s,cyl(x0,y0,z,r,h),cyl(x1,y1,z,r,h))
def prism(pts,z,h):
    if sum(a[0]*b[1]-b[0]*a[1] for a,b in zip(pts,pts[1:]+pts[:1]))<0:pts=pts[::-1]
    return cq.Workplane('XY').polyline(pts).close().extrude(h).translate((0,0,z)).val()
def polar(r,a):return (r*math.cos(math.radians(a)),r*math.sin(math.radians(a)))
def obox(c,u,du,dv,z,h):   # box centred at c with its first side (du) along unit vector u
    return box(0,0,z,du,dv,h).rotate((0,0,0),(0,0,1),math.degrees(math.atan2(u[1],u[0]))).translate((c[0],c[1],0))
def xz_fin(pts,y0,y1):   # vertical fin from an (x, z) outline, y0..y1
    return cq.Workplane('XZ').polyline(pts).close().extrude(-(y1-y0)).translate((0,y0,0)).val()
def yz_fin(pts,x0,x1):
    return cq.Workplane('YZ').polyline(pts).close().extrude(x1-x0).translate((x0,0,0)).val()
def near(a,b,m=0):
    A,B=a.BoundingBox(),b.BoundingBox()
    return A.xmin-m<B.xmax and B.xmin-m<A.xmax and A.ymin-m<B.ymax and B.ymin-m<A.ymax and A.zmin-m<B.zmax and B.zmin-m<A.zmax
def add(id,name,s,cat='buy',bom='',group='lower',check=False,printable=False,note='',explode=None,tess=None,print_rot_z=0,allow=(),pshape=None,print_flip=False,render=None):
    assert s.isValid(),f'Invalid CAD solid {id}'
    if render:   # drawn (GLB, assembly meshes, renders) as these coloured solids; every check still uses s, which must contain them
        assert all(r.isValid() for r,_ in render),f'Invalid render solid {id}';RENDER[id]=render
    if tess:TESS[id]=tess
    if allow:ALLOW[id]=set(allow)
    b=s.BoundingBox()
    p=dict(id=id,name=name,category=cat,color=COL.get(cat,cat),bom=bom,group=group,
      bounds=[round(v,3) for v in (b.xmin,b.ymin,b.zmin,b.xmax,b.ymax,b.zmax)],
      printable=printable,check=check,note=note,**({'vertex_colors':True} if render else {}),
      explode=explode or {'base':[0,0,0],'lower':[0,0,25],'upper':[0,0,85],'camera':[40,0,110],'cover':[0,0,170],'wheels':[0,0,0]}.get(group,[0,0,0]))
    parts.append(p); shapes[id]=s
    if printable:
        # Export each physical printed part at the origin, with a flat datum on bed (optionally turned upside down about x - print_flip: the
        # face that was on top goes on the bed - and then turned about z). pshape: the as-printed solid when the assembly shows it otherwise
        # (bumper leaf springs drawn deflected; the battery tray's hold-down fingers drawn as their own id).
        ps=pshape if pshape is not None else s
        r=ps.rotate((0,0,0),(1,0,0),180) if print_flip else ps
        r=r.rotate((0,0,0),(0,0,1),print_rot_z) if print_rot_z else r;rb=r.BoundingBox()
        t=(-(rb.xmin+rb.xmax)/2,-(rb.ymin+rb.ymax)/2,-rb.zmin);out=r.translate(t)
        p['export']=dict(rot_x_deg=180 if print_flip else 0,rot_z_deg=print_rot_z,translate_mm=[round(v,4) for v in t])
        if not STEP_ONLY:
            cq.exporters.export(out,str(PRINT/(id+'.stl')),tolerance=STL_TOL[0],angularTolerance=STL_TOL[1])
            cq.exporters.export(out,str(PRINT/(id+'.step')))
    return s
def screw(id,x,y,z,length=8,r=1.5,group='lower',allow=(),name='M3 fastener envelope',bom='H01/H02'):
    s=union(cyl(x,y,z,r,length),cyl(x,y,z+length,2.8,2.8))
    add(id,name,s,'metal',bom,group,check=True,allow=allow,note='Thread not modeled; head and shaft clearance only.')
INOTE='M3 machine screw into an M3 × 3 brass heat-set insert in P_base (shank drawn at the minor diameter); tip modelled at its real depth.'
def tfs(id,x,y,z0,z1,head='pan',group='base',allow=(),name='M3 thread-forming screw from below',bom='H10',note='Thread-forming M3 into a 2.6 mm PETG pilot; shank drawn at the minor diameter.'):
    # Screw driven upward from below into a 2.6 mm pilot: head (pan, recessed) or 90 deg countersunk at z0, shank r1.25 to z1.
    h=cyl(x,y,z0,2.75,2.0) if head=='pan' else cq.Solid.makeCone(3.36,1.25,2.11,cq.Vector(x,y,z0))
    add(id,name,union(h,cyl(x,y,z0,1.25,z1-z0)),'metal',bom,group,check=True,allow=allow,note=note)
def tfa(id,x,y,zseat,ztip,head='pan',group='lower',allow=(),name='M3 thread-forming screw from above',bom='H10',note=INOTE):
    # Screw driven downward into a blind Ø2.6 pilot: pan head (2.0) or button head (1.65) on the seat, or 90 deg countersunk head whose top is at zseat.
    if head=='csk':h=cq.Solid.makeCone(1.25,2.75,1.5,cq.Vector(x,y,zseat-1.5));zs=zseat-1.5
    else:h=cyl(x,y,zseat,2.75 if head=='pan' else 2.85,2.0 if head=='pan' else 1.65);zs=zseat
    add(id,name,union(h,cyl(x,y,ztip,1.25,zs-ztip)),'metal',bom,group,check=True,allow=allow,note=note)
INSERTS={}
def insert(id,x,y,face,allow=()):   # M3 × 3 brass heat-set insert in a Ø4.0 P_base through hole (thread bore r1.5 to knurl r2.0), flush with the screw face
    INSERTS[id]=dict(xy=(x,y),face=face)
    add(id,'M3 × 3 brass heat-set insert ('+face+' face)',cyl(x,y,ins_z(face),INS_R,INS_L).cut(cyl(x,y,28,1.5,6)),'metal','H12','base',check=True,allow=('P_base',)+tuple(allow),
        note='Pressed in with a soldering iron, flush with the '+face+' face of P_base, with the plate lying on a flat steel backing plate (the open last 1 mm of the Ø4.0 hole takes the displaced PETG; deburr or countersink the far face afterwards). Follow the insert maker\'s hole size.')
def wire(id,name,pts,r=1.4,cat='signal',bom='C11',group='lower',note='Harness route envelope; bend fillets and service loops must be adjusted at assembly.'):
    # r: one radius, or one per segment (a lead that changes section, e.g. a flat row of wires leaving a housing that gathers into a bundle)
    rs=list(r) if isinstance(r,(list,tuple)) else [r]*(len(pts)-1);assert len(rs)==len(pts)-1,id
    seg=[]
    for (a,b),rr in zip(zip(pts,pts[1:]),rs):
        a,b=cq.Vector(*a),cq.Vector(*b); v=b-a
        if v.Length>0.01:seg.append(cq.Solid.makeCylinder(rr,v.Length,a,v.normalized()))
    for k,p in enumerate(pts[1:-1]):seg.append(cq.Solid.makeSphere(min(rs[k],rs[k+1]),cq.Vector(*p),angleDegrees1=-90))
    s=cq.Compound.makeCompound(seg)
    add(id,name,s,cat,bom,group,note=note)
    length=sum(math.dist(a,b) for a,b in zip(pts,pts[1:]))
    cables.append(dict(id=id,name=name,route_mm=round(length),suggested_cut_mm=int(math.ceil((length*1.2+40)/50)*50),points=pts))
def connector(id,name,x,y,z,pins=2,family='XH',group='upper',rotation=0,check=False):
    pitch=2.5 if family=='XH' else 3.96
    width=(pins-1)*pitch+(5.0 if family=='XH' else 6.3)
    depth=5.8 if family=='XH' else 8.8
    # Distinct socket and mating housing. Contacts are represented as envelope only.
    s=union(box(0,0,0,width,depth,6.5),box(0,0,6.8,width-1,depth-1,5.5))
    if rotation:s=s.rotate((0,0,0),(0,0,1),rotation)
    return add(id,name,s.translate((x,y,z)),'connector','C05' if family=='VH' else 'C06/C08',group,check=check,note=f'{family} {pins}-way mated envelope. Verify purchased housing dimensions.')
def base_edge_r(a):   # radius of the P_base outline along azimuth a (deg): R148 disc clipped to 240 x 200
    c,s=abs(math.cos(math.radians(a))),abs(math.sin(math.radians(a)))
    xl=-BASE_X[0] if math.cos(math.radians(a))<0 else BASE_X[1]
    return min(R_BASE,xl/c if c>1e-9 else 1e9,100/s if s>1e-9 else 1e9)

# Front bumper guides (left half; the right half mirrors y). Each printed 90 deg arc half floats on its own:
# three pins fixed in it (countersunk M3 from below) travel 5 mm in P_base slots along the half's own axis,
# 30 deg inward of rearward, so every point of the 0..90 deg arc pushes along the travel (cos(az-30) >= 0.5)
# and the skin only ever moves inward. Two rail pins carry 693ZZ bearings that roll on the slot sides (lateral);
# the vertical support also rolls, on METAL races only: Ø4 steel balls in rail/arm-top pockets roll between a hardened
# spring-steel strip in the pocket floor and a strip bonded to the base underside; balls under a floating printed rider
# on each pin roll between a strip on the base top and a strip in the rider pocket ceiling. A compression spring above
# each rider (set at assembly to a 0.1 mm feeler gap above a brass stop tube) pulls the half up against its three
# down balls: zero vertical play at rest, independent of the printed plate thickness and pocket depths.
# In-plane play: the two rail bearings sit in slots at most 8.2 mm wide (±0.1 mm side play), so each half may shift ±0.1 mm sideways
# and yaw ±0.28 deg; the skin radius, the seam gap, the bumper-end gaps and the leaf contact are all checked over every feasible
# (travel, side shift, yaw) pose of the two slot stadiums (validation bumper_travel.planar_play).
BT=PARAMS['bumper_travel'];BA=math.radians(PARAMS['bumper_axis_deg'])
ft=(-math.cos(BA),-math.sin(BA));BD=(BT*ft[0],BT*ft[1],0)   # left half travel direction and full-travel shift
nrm=(-ft[1],ft[0])         # in-plane normal to the travel (+ toward the rail side of the switch frame)
G=3.75                     # half seam gap: 7.5 mm at rest, 2.5 mm (nominal) when both halves bottom out
RAILY=(11,23)              # left rail band under P_base (y); it runs along x into the shell at az ~6 deg
RAILP=[(112,17),(65,17)]   # rail pins A, B: Ø8 bearings in 8.2 mm slots along the travel (yaw arm 40.7 mm)
SLOTW=8.2                  # bearing slot width (max): ±0.1 mm side play. FDM slots print 0.1-0.3 undersize: print 8.2, file to 8.1-8.2 (go 8.1 / no-go 8.25, slot coupon)
SPLAY=SLOTW/2-4.0          # bearing side play (0.1); the slot ends are placed so the bearing centre stops at exactly s = 0 and s = 5.0 on the slot axis
PB=(55,88)                 # pin C on the outboard arm: vertical (roll) support only (slot 0.6 mm wider, 0.3 mm longer each end: never touches)
BR=2.0                     # Ø4 mm steel balls (AISI 52100, G10): rolling vertical contacts
BALL_DN=[(76,17),(98,17),(54,95)]   # rail/arm-top pockets: roll on the base underside race (base pushes the half down)
RIDE=dict(A=7.2,B=7.2,C=7.2)        # rider balls each side of the pin slot (along nrm): roll on the base top race (base pushes the half up)
RSIDES=dict(A=(1,-1),B=(1,-1),C=(1,-1)) # two balls per rider (rider B corners chamfered; the driver moved 3 mm aft for it)
BPL=2*BR+BT+2.5           # pocket length along the travel (11.5): free length 7.5 = ±3.75 about the rest position; the ball rolls BT/2 = 2.5 mm in its pocket (1.25 mm margin at the hard stop)
PKR=2.5                    # ball pocket half-width (Ø5 stadium: holds the 4 × 9 mm floor/ceiling race)
RACE_T,RACE_W,RACE_L,PRACE=0.5,3.6,8.0,(4.0,9.0)   # hardened spring-steel race strips: base strips 3.6 × 8, pocket strips 4 × 9, 0.5 thick
ZBU=29.0-RACE_T            # underside race face z 28.5
ZBD=ZBU-2*BR-RACE_T        # down-ball pocket floor z 24.0 (race 24.0..24.5, ball 24.5..28.5)
ZBT=33.0+RACE_T            # top race face z 33.5
ZRB,ZRC,ZRT=34.5,ZBT+2*BR+RACE_T,39.6   # rider underside, pocket ceiling (race 37.5..38.0) and top
RIDT=ZRT-ZRB
SPR=dict(k=2.0,free=7.1,stop_tube=5.0,gap=0.1,od=5.0)   # music-wire spring Ø5 OD × Ø0.5 wire, 2.0 N/mm; brass stop tube Ø4 × 5; 0.1 mm feeler gap
ZCB=36.2                   # rider counterbore ceiling over the clamp nut (nut top 35.8): 0.4 mm up-stop, 0.15..0.65 with print tolerance
PRE_P=round(SPR['k']*(SPR['free']-(SPR['stop_tube']+SPR['gap'])),2)   # preload per pin (N): spring set to stop tube + 0.1 mm feeler gap
ZW=ZRT+SPR['stop_tube']+SPR['gap']   # washer underside z 44.7 (set at assembly), nyloc above
SW=(78,34)                 # SS-5GL2 body centre under P_base; switch frame +X = against the travel, +Y toward the rail
# Omron SS-5GL2 = hinge ROLLER lever (Omron SS datasheet): body 19.8 × 10.2 × 6.4, Ø2.35 holes 9.5 apart 2.9 mm from the terminal edge,
# Ø4.8 × 3.2 roller on a 14.5 mm lever; FP max 19.3, OP 14.5 ± 0.8, OT min 1.2, MD max 0.8 (roller top above the hole line).
HY=-2.2                    # mounting-hole line in the body-centred switch frame (body Y -5.1..5.1, lever side +Y)
XR,RR,XH=6.2,2.4,-8.3      # roller centre X, roller radius, lever hinge X
YOP,YFP,OTM,MDM=HY+14.5,HY+19.3,1.2,0.8
YREST,YDW=13.9,11.65       # cam holds the roller top at 13.9 at rest (0.8 above the release position) and 11.65 on the dwell (0.65 past OP)
KR,S0=math.tan(math.radians(40)),0.9   # 40 deg ramp line; it starts 0.9 mm of travel past the roller centre, i.e. the round roller meets it from about s 0
S1=S0+(YREST-YDW)/KR;SWADJ=0.9         # end of ramp; ± slot adjustment of the switch along frame Y
# Leaf spring: constant-strength taper 2.5 -> 1.45 mm, 9.5 mm tall, 48 mm from the root to a Ø4 nose boss (sized for >= 0.5 N return force
# after 35 % creep at E 1700 MPa and t - 0.05 mm, and <= 15 MPa at the hard stop at E 2000).
LR0,LL,LT,LZB=(61,91),48.0,1.45,(18,27.5)  # leaf spring root (on the arm), length to the nose centre, minimum thickness, z band (9.5 tall)
LRB,LTR,NR=2.0,2.5,2.0     # root boss radius; constant-strength (parabolic) leaf: 2.5 mm at the boss edge, t ~ sqrt(distance to the nose), >= 1.45; nose boss radius
def tq_(q,dt=0.):return (LTR if q<=LRB else max(LT,LTR*math.sqrt(max(LL-q,0)/(LL-LRB))))+dt
lax=(math.sin(BA),-math.cos(BA))         # leaf axis: perpendicular to the travel, so the leaf only bends
LT0=(LR0[0]+LL*lax[0],LR0[1]+LL*lax[1]);PL=2.4   # leaf nose centre and its preload into the base abutment
ABD,ABDEP=(-4.0,3.0),6.0  # abutment extent along the leaf axis from the free nose centre (root side incl. a 1 mm 45 deg lead, tip side) and its depth along the travel
def swW(s):return s.mirror('XZ').rotate((0,0,0),(0,0,1),math.degrees(BA)).translate((SW[0],SW[1],0))   # switch frame -> world (left)
def swL(s):return s.translate((-SW[0],-SW[1],0)).rotate((0,0,0),(0,0,1),-math.degrees(BA)).mirror('XZ')
def swp(X,Y):c,s=math.cos(BA),math.sin(BA);return (SW[0]+X*c+Y*s,SW[1]+X*s-Y*c)
def mir(p,s):return (p[0],s*p[1])
def pp(p,k,v=nrm):return (p[0]+k*v[0],p[1]+k*v[1])
TOWERS=[(113.5,47),(105,37.5)]           # camera mount foot screws (M3 x 10, nuts under P_base; the old camera tower's holes)
MTAB=5.0                                  # motor-mount tab thickness (z 33..38)

# Lid posts (L2): with the deck gone they stand on P_base, from z 33 to the lid underside. The deck-era columns (-105, ±82) / (87, ±82) are
# blocked from the base up by the rear cliff mounts, sensors and leads, so each post takes the place of a deck-era harness saddle (no bundle
# uses them since L1) and its two M3 heat-set inserts at x ±8: rear pair at x -80 (aft of the bay board, x -66.5), front pair at x 85.
LIDPOSTS=[(-80,-94),(-80,94),(85,-94),(85,94)]
POST_R,POST_FOOT=4.5,(22,12,3)   # Ø9 column on a 22 × 12 × 3 foot (the foot screws sit beside the column)
LID_IDS=('P_lid_front','P_lid_left','P_lid_rear','P_lid_right')   # round cover sectors 300..37, 37..120, 120..215, 215..300 deg
# P03 5 V converter (bay plan): turned 90 deg in the front bay, ahead of the bay board's tongue (x 7.5) and aft of the bumper riders B at full
# travel (validation p03_clear_of_bumper_travel): x 9..47, |y| <= 31, on 1 mm foam tape (z 33-34), body z 34-48. A cable tie over its top runs
# through two P_base slots beside its short ends. Drawn as the real HW-316E board (LIO-169, below): its IN / OUT terminals are on the short ends.
P03C,P03S=(28,0),(38,62,14)   # P03 centre and size (x, y, z)
# LIO-169: the tie line at x 39.5 (controller ruling, option a): over the two cap tops, clear of the HW-316E's end terminals (x <= 36.0),
# the trimpot (x >= 41.7) and the heatsink edge (x <= 37.5); the slots, sized to the 2.5 mm tie (TIE below), keep it there (validation p03_model.tie).
P03_TIE_X=39.5
P03_TIES=[(P03_TIE_X,s*(P03S[1]/2+2.3)) for s in (-1,1)]   # 3.1 × 2.6 slots at y ±33.3: 1.0 mm off the P03 short ends
TIES=[(-36,-92)]+P03_TIES                     # zip-tie slots in P_base (the (20, ±24) pair went with the P03's old long-side-along-x pose)
# Motor inline joints, factory-cable coils and their cable ties (PB25; B9 carry items 3 / 10). Each joint (pigtail male housing + the motor cable's
# factory female housing, on edge, axis along +-y) rests on P_base just ahead of its motor, between the motor (x <= 12.5) and the front Jetson standoff
# (x >= 22). The factory cable's spare length is wound into a flat coil (MCOIL, 2.75 turns, CW seen from above on the left, mirrored on the right) on the base further out, clear of the
# wheels (|y| >= 104) and the fan. Each joint and each coil is held by a cable tie (TIE, 2.5 x 1.1 mm band) looped round it through P_base: the joint
# tie's inner leg passes down the motor opening (x < 15, beside the motor can), its outer leg through a slot; the coil tie straddles the coil's +x
# side through two slots. Both are cut and replaced when the joint is unplugged.
MJ=dict(x=16.5,t=2.6,w=15.24,z0=33.05,y0=38.0,male_l=8.0,female_l=14.0,engage=6.0,unplug=8.0,tie_y=52.0)
MJ['z']=round(MJ['z0']+MJ['w']/2,3)          # joint axis height (the six contacts stand in a vertical column)
MCOIL=dict(c=(25.0,72.0),r=6.0,turns=2.75,z_top=49.0,pitch=4.0,start_deg=180.0)   # B12a: z_top 48.5 -> 49 (3.5 turns: FAC_TURNS)
TIE=dict(w=2.5,t=1.1,gap=.3,slot_clr=.3,z_under=27.85,head=(3.5,5.0,4.5),head_z=40.0)   # band width / thickness, gap to what it holds, slot clearance, band underside
# under P_base (0.05 mm clear of it), and the ratchet head (x, y, z size) on the outer leg's outside face from z head_z. The ties have no clash allowance:
# the slots and the motor opening clear them, so the clash scan checks them against P_base and the joint like any part.
MOTOR_OPENING_X=15.0                          # P_base motor openings: x -15..15 (bcut 'motor opening')
def tie_legs(xin0,xout1,ztop):   # (inner leg x0..x1, outer leg x0..x1, top bar z0..z1) of a tie holding x in [xin0, xout1], z up to ztop
    return (xin0-TIE['gap']-TIE['t'],xin0-TIE['gap']),(xout1+TIE['gap'],xout1+TIE['gap']+TIE['t']),(ztop+TIE['gap'],ztop+TIE['gap']+TIE['t'])
_cx,_cy=MCOIL['c'];_bw=2.0                  # coil bundle radius (the factory cable drawn Ø4, as MC_R)
MOTOR_TIES={'joint':tie_legs(MJ['x']-MJ['t']/2,MJ['x']+MJ['t']/2,MJ['z0']+MJ['w']),
            'coil':tie_legs(_cx+MCOIL['r']-_bw,_cx+MCOIL['r']+_bw,MCOIL['z_top']+_bw)}
assert MOTOR_TIES['joint'][0][1]<MOTOR_OPENING_X,'the joint tie inner leg must pass down the motor opening'
MOTOR_TIE_SLOTS=[]   # (x0, x1, y centre) per slot, both sides
for _s in (1,-1):
    (_i,_o,_)=MOTOR_TIES['joint'];MOTOR_TIE_SLOTS.append((_o[0]-TIE['slot_clr'],_o[1]+TIE['slot_clr'],_s*MJ['tie_y']))
    (_i,_o,_)=MOTOR_TIES['coil'];MOTOR_TIE_SLOTS+=[(_i[0]-TIE['slot_clr'],_i[1]+TIE['slot_clr'],_s*_cy),(_o[0]-TIE['slot_clr'],_o[1]+TIE['slot_clr'],_s*_cy)]
# Power & I/O bay board (bay B8: the real routed board): one 4-layer 1.6 mm PCB at base level under the unchanged Jetson, bottom z 35.4 on four
# 2.4 mm printed PETG spacers (M3 × 8 pan head into heat-set inserts in P_base), clamped in the two rear Jetson standoff stacks: P_base → 2.4 mm
# printed clamp spacer → board → M2.5 × 20 mm F-F standoff → carrier (z 57), one M2.5 × 12 countersunk screw from under P_base. Everything placed
# or checked round the board comes from pcb/board_cad.json ($KPY pcb/export_cad.py, read from the routed KiCad board, robot frame): the outline,
# the M3 and clamp holes, every THT pad, the edge connectors (courtyard, F.Fab body, entry direction, mated height, wire bend, lay-flat reach),
# the module sockets and the Pico USB receptacle. The board itself is the fab STEP pcb/fab/r1_power_io.step (robot = STEP + (-66.5, 50, 35.4)).
BC=json.loads((ROOT/'pcb'/'board_cad.json').read_text());_BF=BC['frame']
ZBAY,BAY_T=_BF['z_bottom'],_BF['thickness'];ZBAY_TOP=round(ZBAY+BAY_T,3)   # board bottom, thickness, top (37.0)
LEAD_TRIM=_BF['lead_trim_mm']   # THT leads trimmed to <= 1.4 mm under the board (z 34.0): 1.0 mm over the base top (z 33)
assert ZBAY_TOP==_BF['z_top'] and _BF['step_to_robot_mm']==[-66.5,50.0,ZBAY],'board_cad.json frame'
BAY_OUTLINE=[tuple(p) for p in BC['outline_xy']]   # robot x, y: the board's Edge.Cuts (B2 outline: rear edge x -66.4, tongue |y| <= 33.4 to x 7.5)
BAY_MOUNTS=[tuple(h['xy']) for h in BC['holes']]   # M3 holes H1..H4 over the P_base inserts (H3/H4 beside the tongue centre: ruling PB4)
BAY_CLAMPS=[tuple(h['xy']) for h in BC['clamp_holes']]   # rear Jetson standoff stacks (JHOLES 3 and 1) clamp the board: Ø3.0 NPTH (ruling PB3)
assert all(math.dist(a,b)<1e-6 for a,b in zip(BAY_MOUNTS+BAY_CLAMPS,[(-19.5,38),(-19.5,-38),(-11.5,8.5),(-11.5,-8.5),(-33,40),(-33,-46)])),'holes moved: the P_base inserts and the Jetson holes are fixed'
CARRIER_X=BS.CARRIER_X   # height-zone boundary: the Jetson carrier's rear edge (x -37) less the 1.5 mm margin
UNDER_CARRIER_Z=BS.UNDER_CARRIER_Z   # carrier underside z 57 less the 2.23 mm allowed for its through-hole leads: under-carrier part tops <= UNDER_CARRIER_Z - 1.5
BCONN=BC['connectors'];BMOD=BC['modules']
def _bctr(b):return ((b[0]+b[2])/2,(b[1]+b[3])/2)
BAY_CONN={r:tuple(round(v,2) for v in _bctr(c['body_xy'])) for r,c in BCONN.items()}   # connector body centres: the harness ends (B9 sets the cut lengths)
PICO_USB=BC['pico_usb']['face_centre_xyz']   # Pico micro-USB receptacle face centre (at the board's left edge); checked against the placed Pico STEP
# Rear-edge connector row (plugged and unplugged with the lid off): the real courtyards (x0, x1, y0, y1).
REAR_REFS=('J13','J6','J7','J12','J2','J1')
BAY_REAR_ROW={r:(BCONN[r]['courtyard_xy'][0],BCONN[r]['courtyard_xy'][2],BCONN[r]['courtyard_xy'][1],BCONN[r]['courtyard_xy'][3]) for r in REAR_REFS}
# Printed bearing ribs on P_base under the rear row, from the real THT pads (board_cad.json tht_pads, copper bounding boxes), each >= RIB_GAP from
# every pad in plan (the leads hang 1.4 mm into the 2.4 mm gap) and under the connectors' bodies: rib 0 under the XH row J13 / J6 / J7 / J12
# between their pin row and the Pico socket U1A, rib 1 under J2 / J1 between their pins and the F2 holder (it stops RIB_SEP short of rib 0).
# Each is located by a RIB_POCKET deep pocket in the P_base top (RIB_CLR a side: room for the elephant's foot) and bonded there with epoxy;
# where a pocket would come within RIB_WALL of another base hole (the caster insert under J2) the rib stands on the plain base top instead,
# its underside stepped up by RIB_POCKET (pocket_spans; BAY_RIBS is set after the base hole lists, at CASTER_SCREWS).
RIB_GAP,RIB_W,RIB_SEP,RIB_POCKET,RIB_CLR,RIB_WALL=1.0,2.0,1.6,0.6,0.25,1.3   # RIB_WALL: P_base between a pocket and any other base hole (the base-hole wall gate 1.2 + 0.1)
BPADS=BC['tht_pads']
def pad_gap(b):   # (plan gap, pad) from a box (x0, y0, x1, y1) to the nearest THT pad's copper box
    return min((math.hypot(max(p['bbox_xy'][0]-b[2],b[0]-p['bbox_xy'][2],0.),max(p['bbox_xy'][1]-b[3],b[1]-p['bbox_xy'][3],0.)),f"{p['ref']}.{p['pin'] or 'peg'}") for p in BPADS)
def rib_from_pads(refs,y0=None,y1=None,w=RIB_W):
    """(x0, x1, y0, y1) of a rib along y under refs' courtyards: RIB_GAP in front of their own pins, RIB_GAP short of the next pins over its span."""
    ys=[BAY_REAR_ROW[r][2] for r in refs]+[BAY_REAR_ROW[r][3] for r in refs];y0=min(ys) if y0 is None else y0;y1=max(ys) if y1 is None else y1
    x0=max(p['bbox_xy'][2] for p in BPADS if p['ref'] in refs)+RIB_GAP                                                  # behind: the connectors' own pins
    nxt=min(p['bbox_xy'][0] for p in BPADS if p['bbox_xy'][0]>x0-RIB_GAP and p['bbox_xy'][1]<y1 and p['bbox_xy'][3]>y0)   # ahead: the next pins over that span
    return (round(x0,3),round(min(x0+w,nxt-RIB_GAP),3),round(y0,3),round(y1,3))
def pocket_spans(rib,holes,min_len=3.0):
    """The y-spans (y0, y1) of a rib's locating pocket: the rib's span less every stretch where the pocket (RIB_CLR a side) would come within
    RIB_WALL of a base hole ((x, y), r); pieces shorter than min_len are dropped. Closed form, no search."""
    x0,x1,y0,y1=rib;px0,px1=x0-RIB_CLR,x1+RIB_CLR;spans=[(y0,y1)]
    for (hx,hy),r in holes:
        dx=max(px0-hx,0.,hx-px1);reach=RIB_WALL+r
        if dx>=reach:continue
        half=math.sqrt(reach*reach-dx*dx)+RIB_CLR;c0,c1=hy-half,hy+half
        spans=[q for lo,hi in spans for q in ((lo,min(hi,c0)),(max(lo,c1),hi)) if q[1]-q[0]>1e-9]
    return [(round(lo,3),round(hi,3)) for lo,hi in spans if hi-lo>=min_len]
# Rear-edge hold-down (B8, PB24 amended): the band behind the carrier has no legal M3 spot within 35 mm of J1 / J2 / J7 / J12 (pcb side: every
# candidate meets another net's pad or a power zone in its 4.5 mm washer, or the Pico's SMD column), so the battery tray's front wall (x -70..-68,
# 1.6 mm behind the board's rear edge) carries three compliant hold-down fingers. Each finger sits in a gap between two rear-row connector bodies
# (HD_PAIRS), reaches HD['reach'] over the board's rear edge and hangs from the free end of a cantilever cut out of the wall (HD['L'] long along y,
# the wall raised to HD['top'] over it, bending vertically within the print layers). Unloaded, its underside is HD['preload'] below the board top,
# so with the board in place the beam is lifted by that much and holds the rear edge down on the ribs with a few newtons (hd_spring: the
# stack-up, force and stress). The slot under each beam is horizontal (a sloped one would leave sub-1.2 mm in-layer slivers in the 2 mm wall)
# and bridged by 1.3 mm breakaway posts every HD['post_pitch'] (2 mm bridges: the printability gate), freed after printing by running a fine
# razor saw along the slot. They print with the tray (one part); the CAD draws the beams and fingers in their installed pose as
# their own id (bay_holddown), so the board-outline tools list them with the ribs as designed contacts. The tray goes in after the board: set it
# 2 mm aft of its place and slide it forward so the fingers ride up their lead-ins onto the board's top face.
HD=dict(reach=1.95,w=1.4,lead=1.15,preload=.35,stack=.30,L=31.0,top=43.0,slot=.6,post_w=1.3,post_pitch=3.3,end_slot=1.0,z_over=.1,finger_h=3.4,relief_r=.75,
        E=2000.,E_creep=1700.,nu=.35,yield_MPa=50.,stress_limit_MPa=15.)
HD_PAIRS=(('J6','J13',1),('J12','J7',1),('J1','J2',-1))   # the bodies the finger sits between, the way its beam runs to its root (+-y)
HD_MIN_GAP,TRAY_FACE,TRAY_BACK=2.2,-68.0,-70.0
BAY_EDGE_X=min(p[0] for p in BAY_OUTLINE)   # the board's rear edge (x -66.4)
HOLDDOWN=[]   # (finger centre y, gap between the bodies, beam direction)
for _a,_b,_d in HD_PAIRS:
    _lo,_hi=sorted((BCONN[_a]['body_xy'],BCONN[_b]['body_xy']),key=lambda q:q[1]);_g=round(_hi[1]-_lo[3],3)
    assert _g>=HD_MIN_GAP,(_a,_b,_g);HOLDDOWN.append((round((_lo[3]+_hi[1])/2,3),_g,_d))
# The board is captive under the Jetson carrier (the rear standoffs clamp it); its rear band (Pico USB, rear connector row, fuses) stays reachable
# with the lid off, but the under-carrier connectors and the P03 only before the Jetson goes on: this fixes the assembly and service order written
# into the E01, H05, P03 and board notes.
def pin1_end(ref):
    """(which end of the lay-flat header pin 1 is at, in robot terms; True when pin 1 is on the left for someone looking into the mated socket's
    mating face, along the entry direction, with the socket's tails up)."""
    p_=BCONN[ref]['pins_xy'];ex_,ey_=BCONN[ref]['entry_xy'];lx,ly=-ey_,ex_   # left = z x (entry direction)
    return ('rear' if p_[0][0]<p_[-1][0] else 'front'),(p_[0][0]-p_[-1][0])*lx+(p_[0][1]-p_[-1][1])*ly>0
PIN1={r:pin1_end(r) for r in ('J4','J5')};assert all(v[1] for v in PIN1.values()),PIN1   # the same rule fits both headers: red on the left
ASSY_ORDER=('Assembly order (bay board under the Jetson): 0. on the bench, make the two motor pigtails (C18) and plug them on. They differ in length and in pin-1 order, so tag each one "L / J4" (left motor) or "R / J5" (right motor) right after making it, before it is plugged on. '
            'The pre-cut length of the six wires of each pigtail is @@PRECUT_J4@@ mm for J4 (left) and @@PRECUT_J5@@ mm for J5 (right): the drawn route + terminations + the full @@SPREAD@@ mm pin spread, rounded up to the mm, because the six wires fan out @@HALF@@ mm either side of the bundle\'s centre line at both ends (the socket\'s six sleeves and the male housing\'s six cavities each span @@SPREAD@@ mm). '
            'Solder the socket end first (one wire lapped on each solder tail of the right-angle socket under its Ø1.8 sleeve, red wire on pin 1, the tails and wires pointing up), then push the socket onto its header; leave the male ends long: they are dressed along the route, trimmed to length and crimped in step 4. '
            f'J4 pin 1 = {PIN1["J4"][0]} end, J5 pin 1 = {PIN1["J5"][0]} end (the square pads); the pigtails are built alike, so the rule is the same for both: looking into the socket\'s mating face with its tails up, the red wire (pin 1) is on the left. '
            'The pigtails stay with the board. '
            'Power connectors (ruling PB30): the battery (J1, an AMASS XT30 PCB male), the master rocker (J2, a JST VH header) and the Jetson 5 V (J3, a Molex Micro-Fit 3.0 right-angle header) are three different connector families, so no lead fits a wrong header; '
            'tag the three leads anyway ("J1 BATT", "J2 ROCKER", "J3 JETSON 5V") right after making them. '
            'Battery lead polarity: J1 pin 1 is GND (silk "-") and pin 2 is BAT+ (silk "+"), so the lead\'s XT30U-F carries GND in cavity 1 (its "-" contact: battery -, black) and BAT+ in cavity 2 (its "+" contact: battery +, red); '
            'the XT30 mates only one way round, but a lead soldered the wrong way round still mates. Check it fail-safe before the fuses go in: '
            'with F1 and F2 out, plug W01 into J1 and into the battery and measure F1\'s input clip (its BAT+ side, F1 pin 1) against a GND pad (TP5 or an M3 hole ring): it must read positive, about the pack voltage (≥ 6 V; a part-discharged pack reads lower); a reversed lead reads negative and, '
            'with the fuses out, has no current path. Only then fit the fuses, always with the rocker off (F1 first, F2 last): a reversed lead with the fuses in is the costliest mistake on this board (it has no reverse-polarity protection); '
            '1. bond the two printed bearing ribs into their 0.6 mm locating pockets in the P_base top with epoxy (F04) and let it cure; fit the two front Jetson standoffs (24 mm stacks), screwed from below; '
            '2. set the four 2.4 mm printed spacers and the two printed clamp spacers on P_base, lower the bay board onto them and screw it down with four M3 × 8 pan-head screws into the inserts; '
            '3. fit the battery tray (its hold-down beams freed: breakaway posts cut): set it 2 mm aft of its place, slide it forward so its three spring fingers ride up their lead-ins onto the board\'s top face between the rear connectors, screw it down, and check each finger stands lifted: '
            'a 0.05 mm feeler does not pass under its tip; if it does, that finger has play (it is off the board): stick 0.1 mm PTFE tape (F03) under its tip as a shim, a layer at a time (about 0.3 mm at most), until the feeler no longer passes; '
            f'4. plug the under-carrier cables. Pigtails: dress each one as drawn, with no slack (it rides up with the board when the joint is unplugged): straight up out of the socket, toward the front about 12 mm over the board beside U5A (J9 on the right), out between the P03 and the motor face, and down to the inline joint just ahead of the motor (x {MJ["x"]-MJ["t"]/2:g}..{MJ["x"]+MJ["t"]/2:g}, |y| {MJ["y0"]:g}..{MJ["y0"]+MJ["male_l"]+MJ["female_l"]:g}); '
            'then trim each wire at its own cavity of the male housing (finished lengths @@FIN_J4@@ for J4 and @@FIN_J5@@ for J5, set by where each wire sits at both ends) and crimp its male pin into the 1×6 housing, red wire = pin 1. '
            'Factory cables: measure each one from the encoder cap to the female housing\'s rear face (the wire entry); readings of @@R_LO@@–@@R_HI@@ mm all fit (2–3 turns), and a longer cable up to @@R_MAX@@ mm still fits (up to 3.5 turns). Route the fixed path first (about @@FIXED@@ mm outside the coil): a flat row along the motor\'s inner end face toward the rear, round the motor\'s rear shoulder and forward over the motor top (never over the pigtail), down the motor\'s front shoulder under the bumper lead, and from the coil position into the housing; '
            f'wind the remainder (the measured length less the fixed path: @@REM_LO@@–@@REM_HI@@ mm) into the coil on the base ahead of the motor (2–3.5 turns, about {2*MCOIL["r"]+4:g} mm across, at x {MCOIL["c"][0]:g}, |y| {MCOIL["c"][1]:g}) and tie it through its two slots. '
            'Then mate each motor\'s factory female housing onto its pigtail\'s male housing: the joint is not keyed, so mate the pin-1 stripe to the pin-1 stripe (both halves are marked at the red wire) and check the colours run straight across; stand the joint on the base and tie it down with a cable tie down the motor opening and up through the slot beside it; bumpers J10/J11; front cliffs J8/J9; '
            f'5. set and verify the P03 output voltage on the bench, connect it to U5A/U5B (pin 1 is "+" on both terminals, silk "+", the screw nearer the robot centre line: U5A.1 to P03 IN+, U5B.1 to P03 OUT+, red wires on pin 1; the P03\'s IN terminal is on the end toward the robot\'s left, display up and toward the rear), then fit it on its foam tape in the front bay with the cable tie through the P_base slots at ({P03_TIES[1][0]:g}, ±{P03_TIES[1][1]:g}); '
            'before the Jetson is connected (W04 unplugged): battery in, F1 fitted, rocker on, and measure against a GND pad: U5A.1 reads positive, about the pack voltage, and U5B.1 positive 5.1 V (0 V or negative: the P03 leads are swapped or loose); then rocker off; '
            '6. stand the two rear 20 mm F-F standoffs on the board and screw each down with an M2.5 × 12 countersunk screw from under P_base through the base, the clamp spacer and the board (they clamp the board); '
            '7. fit the Jetson (four M2.5 top screws), then its six plugs; before the 5 V barrel plug goes in, check the Jetson lead W04 on J3 with its barrel plug free and the rocker on: the plug\'s centre reads positive 5.1 V against its sleeve (negative: the two Micro-Fit crimps are swapped), then rocker off and plug it in. '
            'Service: step 0, every time, before reaching inside: shut the Jetson down, switch the rocker off and unplug the battery (BAT+ is live and unfused at F1\'s input whenever the battery is plugged in). '
            'Everyday rule: the rocker off before plugging or unplugging the battery; shut the Jetson down before switching the rocker off; fit or pull a fuse only with the rocker off (rocker off, fit F2, rocker on). '
            'With the lid off, the board\'s rear band (Pico USB, rear connector row, the Jetson 5 V lead J3, fuses) is reachable; the motor inline joints, the other under-carrier connectors and the P03 (tie, trimpot) need the Jetson off '
            '(its six plugs: camera, LiDAR and Pico USB, Wi-Fi dongle, 5 V barrel plug, fan; then its four top screws). To take the board out: Jetson off; the two rear standoffs off (their M2.5 screws from under P_base); the battery out (strap, Tamiya plug); '
            'the four tray screws out, the tray slid 2 mm aft and lifted straight out (its springs come off the board edge; its walls are cut clear of the rear cliff sensor boards); the four M3 board screws out; '
            f'unplug the rear-band plugs, the motor inline joints (loosen each factory-cable coil tie first: the {MJ["unplug"]:g} mm each housing slides back comes out of the coil; then cut the joint ties and slide each factory housing off its pigtail; the pigtails stay on J4 / J5 and ride up with the board), the bumper and front cliff leads and the P03 leads; lift the board. Fit new ties when it goes back (retie the coils).')
BAY_ZONES=(f'Height zones: under the carrier (x >= {CARRIER_X:g}) every part top, including a mated plug and its wire bend, <= z {UNDER_CARRIER_Z-1.5:.2f} ({UNDER_CARRIER_Z-1.5-ZBAY_TOP:.2f} mm over the board top); '
           f'behind it (x < {CARRIER_X:g}) <= z {ZLID-3:g} (lid underside - 3 mm), exposed with the lid off.')
TRAYS=[(BX-21,-66),(BX+21,-66),(BX-21,66),(BX+21,66)]
CASTER_BC=16.5                              # caster flange screws on a 16.5 mm bolt circle: outside the Ø25.4 ball (12.7 + 2.75 head + 1.0)
CASTER_SCREWS=[(CX+CASTER_BC*math.cos(math.radians(a)),CASTER_BC*math.sin(math.radians(a))) for a in [90,210,330]]
# The ribs (see RIB_GAP) and their pockets, now that the base holes are known.
_BASE_HOLES=[(p,INS_R) for p in BAY_MOUNTS+TRAYS+CASTER_SCREWS+[(cx+d,cy) for cx,cy in LIDPOSTS for d in (-8,8)]]+[(p,2.55) for p in JHOLES]   # inserts Ø4.0; Jetson countersinks Ø5.1
_r0=rib_from_pads(('J13','J6','J7','J12'));_r1=rib_from_pads(('J2','J1'),y1=_r0[2]-RIB_SEP)
BAY_RIBS=[_r0,_r1];RIB_POCKETS=[pocket_spans(r,_BASE_HOLES) for r in BAY_RIBS]
for _rb,_pk in zip(BAY_RIBS,RIB_POCKETS):assert _rb[1]-_rb[0]>=1.5 and pad_gap((_rb[0],_rb[2],_rb[1],_rb[3]))[0]>=RIB_GAP-1e-6 and sum(b-a for a,b in _pk)>=.5*(_rb[3]-_rb[2]),(_rb,_pk)

# Base: R148 disc clipped to a 244 x 200 mm plate, x -124..120 (one piece keeps both motor mounts aligned).
# Every hole is recorded (BH: name, solid) for the pairwise wall check in validation.
base=box(sum(BASE_X)/2,0,29,BASE_X[1]-BASE_X[0],200,4).intersect(cyl(0,0,28,R_BASE,6))
def bcut(name,s):
    global base;base=base.cut(s);BH.append((name,s))
for sign in [-1,1]:
    bcut(f'motor opening {sign:+d}',box(AX,sign*68,25,30,72,12))   # motor opening y 32..104 (3 mm to the motor end)
    for x in [AX-19,AX+19]:bcut(f'motor mount {x:+.0f},{sign*94}',cyl(x,sign*94,28,1.7,8))
for i,(x,y) in enumerate(JHOLES):bcut(f'jetson standoff {i}',union(cyl(x,y,28,1.45,8),cq.Solid.makeCone(2.55,1.45,1.1,cq.Vector(x,y,29))))   # M2.5 countersunk from below: nothing protrudes under the base
def ins_hole(name,x,y):bcut(name,cyl(x,y,28,INS_R,6))   # Ø4.0 through hole for an M3 × 4 brass heat-set insert (flush with the face the screw enters)
for i,(x,y) in enumerate(BAY_MOUNTS):ins_hole(f'bay mount insert {i}',x,y)   # bay board: M3 × 8 pan head through the board and its 2.4 mm printed spacer into the insert
for k,((x0,x1,_,_),pk) in enumerate(zip(BAY_RIBS,RIB_POCKETS)):
    for j,(y0,y1) in enumerate(pk):bcut(f'bay rib pocket {k}.{j}',box((x0+x1)/2,(y0+y1)/2,33-RIB_POCKET,x1-x0+2*RIB_CLR,y1-y0+2*RIB_CLR,RIB_POCKET+1))   # rib locating datum: 0.6 mm pocket in the P_base top (prints on the bed face)
for i,(x,y) in enumerate(CLIFF):
    bcut(f'cliff window {i}',box(x,y,28,13,14,8))                   # 13 x 14 window keeps 2 mm around the 25 deg ToF cone
    for xx in [-9.5,9.5]:bcut(f'cliff screw {i}{xx:+.1f}',cyl(x+xx,y,28,1.2,8))
for i,(x,y) in enumerate(CASTER_SCREWS):ins_hole(f'caster insert {i}',x,y)     # insert from below: M3 × 5 pan head through the 2 mm flange, tip z 32
def pslot(p,r,ext,s):   # P_base slot swept by a bumper pin from rest to the 5 mm hard stop (side s)
    u=(ft[0],s*ft[1])
    return stadium((p[0]-ext*u[0],p[1]-ext*u[1]),(p[0]+(BT+ext)*u[0],p[1]+(BT+ext)*u[1]),r,28,6)
ABUF=NR-PL                  # abutment face along the travel, from the free nose centre: the Ø4 nose boss is pressed PL into it
ABPOLY=[(ABUF,ABD[0]+1.),(ABUF+1.,ABD[0]),(ABUF+ABDEP,ABD[0]),(ABUF+ABDEP,ABD[1]),(ABUF,ABD[1])]   # (along travel, along leaf axis): face d -3..+3, root-side 45 deg lead to d -4
def abut(s):   # leaf-spring abutment under P_base: face normal to the travel; it spans d -3..+3 about the free nose (bending shortening and play keep the contact >= 1 mm inside)
    u=(ft[0],s*ft[1]);d=(lax[0],s*lax[1]);T=mir(LT0,s)
    return prism([(T[0]+a*u[0]+b*d[0],T[1]+a*u[1]+b*d[1]) for a,b in ABPOLY],18.5,10.6)
SWLEAD=(-14,-6)                                           # switch lead hole in the switch frame (behind the body)
for s in [-1,1]:
    for x,y in TOWERS:bcut(f'tower screw {x},{s*y}',cyl(x,s*y,28,1.7,8))                          # camera mount feet
    for k,p in zip('AB',RAILP):bcut(f'rail slot {k}{s:+d}',pslot(mir(p,s),SLOTW/2,-SPLAY,s))   # rail pins: Ø8 bearing, 8.2 mm slot (±0.1 mm side play); centred bearing stops at s 0 and 5.0
    bcut(f'pin C slot {s:+d}',pslot(mir(PB,s),3.1,.3,s))                                  # pin C: no side or end contact
    for X in [-4.75,4.75]:bcut(f'switch slot {X:+.2f}{s:+d}',stadium(mir(swp(X,HY-SWADJ),s),mir(swp(X,HY+SWADJ),s),1.2,28,6))   # M2 clearance slots along frame Y: set the switch at assembly
    bcut(f'switch lead {s:+d}',cyl(*mir(swp(*SWLEAD),s),28,3,8))                               # bumper switch lead
    base=union(base,abut(s))
for i,(x,y) in enumerate(TRAYS):ins_hole(f'tray insert {i}',x,y)   # insert from above: M3 × 6 countersunk from inside the tray
for i,(x,y) in enumerate(TIES):bcut(f'tie slot {i}',box(x,y,28,10 if i==0 else TIE['w']+2*TIE['slot_clr'],2.6,8))   # the P03 pair: the tie's width + clearance along x
for i,(x0,x1,yc) in enumerate(MOTOR_TIE_SLOTS):bcut(f'motor tie slot {i}',box((x0+x1)/2,yc,28,x1-x0,TIE['w']+2*TIE['slot_clr'],8))   # B9: joint / coil cable-tie slots
for i,(cx,cy) in enumerate(LIDPOSTS):
    for xx in [cx-8,cx+8]:ins_hole(f'lid post {i+1} insert {xx}',xx,cy)   # insert from above: M3 × 6 pan head through the post foot, tip at z 30

# Rear shell foot ribs: azimuths chosen PER SIDE by a scan of the real base-edge hardware on that side (saddles are not
# mirror-symmetric). Each rib screw goes into a Ø8 × 5 mm boss under P_base (pilot 8 mm deep, 1 mm skin).
def ring_pts(c,r,n=36):return [(c[0]+r*math.cos(2*math.pi*k/n),c[1]+r*math.sin(2*math.pi*k/n)) for k in range(n)]
def box_pts(x0,y0,x1,y1,n=12):return [(x0+(x1-x0)*k/n,y) for k in range(n+1) for y in (y0,y1)]+[(x,y0+(y1-y0)*k/n) for k in range(n+1) for x in (x0,x1)]
RIBW,BOSSR=14,4.0
def rib_poly(a,r0,w=RIBW):
    c,s=math.cos(math.radians(a)),math.sin(math.radians(a));n=(-s,c);r1=R_RS-1
    return [(r0*c+w/2*n[0],r0*s+w/2*n[1]),(r1*c+w/2*n[0],r1*s+w/2*n[1]),(r1*c-w/2*n[0],r1*s-w/2*n[1]),(r0*c-w/2*n[0],r0*s-w/2*n[1])]
def poly_gap(poly,pts):   # plan distance from a convex polygon to a point cloud (0 when a point is inside)
    P=np.array(poly);Q=np.array(pts);best=1e9
    for a,b in zip(P,np.roll(P,-1,0)):
        ab=b-a;t=np.clip(((Q-a)@ab)/(ab@ab),0,1);best=min(best,float(np.min(np.linalg.norm(Q-(a+t[:,None]*ab),axis=1))))
    inside=np.all([((b-a)[0]*(Q[:,1]-a[1])-(b-a)[1]*(Q[:,0]-a[0]))>=0 for a,b in zip(P,np.roll(P,-1,0))],0)|np.all([((b-a)[0]*(Q[:,1]-a[1])-(b-a)[1]*(Q[:,0]-a[0]))<=0 for a,b in zip(P,np.roll(P,-1,0))],0)
    return 0. if inside.any() else best
def rib_screws(a):e=base_edge_r(a);return [polar(e-7,a),polar(e-17,a)]
RIB_HARD=[(f'rear cliff window + ToF cone {n}',ring_pts(c,9.6)) for n,c in zip(('RL','RR'),CLIFF[2:])]+[(f'rear cliff screw head {c[0]+dx:.0f},{c[1]:.0f}',ring_pts((c[0]+dx,c[1]),2.0)) for c in CLIFF[2:] for dx in (-9.5,9.5)]+\
         [('rear caster housing',ring_pts((CX,0),20)),('tyre/wheel left',box_pts(-40,105,40,123)),('tyre/wheel right',box_pts(-40,-123,40,-105))]+[(f'Jetson standoff {i+1} countersunk head',ring_pts(p,2.55)) for i,p in enumerate(JHOLES)]
RIB_SOFT=[(f'lid post foot {i+1}',box_pts(x-11,y-8,x+11,y+8)) for i,(x,y) in enumerate(LIDPOSTS)]+[('signal bundle lane y=+94',box_pts(-108,88,94,100)),('power bundle lane y=-94',box_pts(-96,-98,90,-90))]+\
         [(f'lid post {i+1}',ring_pts(p,4.5)) for i,p in enumerate(LIDPOSTS)]
HC=[(n,s.BoundingBox()) for n,s in BH if not n.startswith('motor opening')]   # every other base hole, as a plan circle/box
def hole_gap(p,r):   # plan wall from a circle (p, r) to every recorded base hole (bounding boxes; circles by their own radius)
    best=(1e9,'')
    for n,b in HC:
        if b.xlen<=7.3 and abs(b.xlen-b.ylen)<.05:d=math.dist(p,((b.xmin+b.xmax)/2,(b.ymin+b.ymax)/2))-b.xlen/2-r   # round hole
        else:d=math.hypot(max(b.xmin-p[0],0,p[0]-b.xmax),max(b.ymin-p[1],0,p[1]-b.ymax))-r                          # slot / window: its box
        best=min(best,(d,n))
    return best
INS_XY=BAY_MOUNTS+TRAYS+CASTER_SCREWS+[(cx+d,cy) for cx,cy in LIDPOSTS for d in (-8,8)]   # every heat-set insert (flush with both base faces)
rib_scan={'left':[],'right':[]}
for side,sg in [('left',1),('right',-1)]:
    for a0 in range(96,178):
        a=sg*a0;poly=rib_poly(a,base_edge_r(a)-25)
        hard=min((poly_gap(poly,q),n) for n,q in RIB_HARD);soft=min((poly_gap(poly,q),n) for n,q in RIB_SOFT)
        wall=min(hole_gap(p,BOSSR) for p in rib_screws(a))
        insg=min(poly_gap(poly,ring_pts(p_,INS_R)) for p_ in INS_XY)   # a rib foot must not bear on an insert end face
        rib_scan[side].append(dict(az=a,hard_gap_mm=round(hard[0],1),hard_nearest=hard[1],plan_gap_to_saddles_lanes_posts_mm=round(soft[0],1),soft_nearest=soft[1],boss_wall_to_base_holes_mm=round(wall[0],1),boss_nearest=wall[1],gap_to_inserts_mm=round(insg,1)))
def pick(side,lo,hi):
    ok=[r for r in rib_scan[side] if lo<=abs(r['az'])<=hi and r['hard_gap_mm']>=4 and r['boss_wall_to_base_holes_mm']>=1.5 and r['gap_to_inserts_mm']>=1.0]
    return max(ok,key=lambda r:(min(r['hard_gap_mm'],12)+.25*min(r['plan_gap_to_saddles_lanes_posts_mm'],12)+.1*min(r['boss_wall_to_base_holes_mm'],10),-abs(abs(r['az'])-(lo+hi)/2)))['az']
RIBS={side:[pick(side,112,140),pick(side,148,174)] for side in ('left','right')}
for side in RIBS:
    for a in RIBS[side]:
        for k,p in enumerate(rib_screws(a)):
            base=union(base,cyl(*p,24,BOSSR,5.01))                     # Ø8 × 5 boss under the base (prints upward: base prints top face down)
            bcut(f'rear shell pilot {side} {a} {k}',cyl(*p,23.5,1.3,8.5))   # Ø2.6 pilot z 24..32: 8 mm deep, 1 mm skin; M3 × 10 tip at z 30.5
add('P_base','Single-piece chassis base',base,'print','F01','base',printable=True,note='R148 disc clipped to 244 × 200 × 4 mm (x -124..120, z 29–33). PETG, print top face down (the leaf-spring abutments and the rear-shell screw bosses under the base then point up). '
    'Slicer: NO brim; skirt distance 1 mm or skirt off for this part (244 mm of the 250 mm X travel); glue stick or a textured sheet, and watch the first layer at both X extremes (outside most of the mesh-bed-leveling grid). '
    f'First print P_coupon (print-parts/coupons): FDM slots come out 0.1–0.3 mm undersize; print the rail slots at {SLOTW} mm and file every one to {SLOTW-.1:.1f}–{SLOTW} mm with the coupon as the go / no-go gauge (go {SLOTW-.1:.1f}, no-go {SLOTW+.05:.2f}: a Ø8 bearing must roll on one side, ±0.05–0.1 mm side play, never touch both sides); check that the pin-C sleeve slides in its 6.2 mm slot. '
    f'Four {SLOTW} mm rail-pin slots (693ZZ bearings) and two 6.2 mm pin-C slots, 5 mm travel 30° inward of rearward. The bumper balls never touch PETG: bond the 0.5 mm hardened spring-steel race strips ({RACE_W} × {RACE_L:.0f} mm) to the base underside over each down-ball track and to the base top beside each slot (positions in the CAD, epoxy). '
    'The vertical guide is spring-preloaded, so the printed plate thickness does not set any play. Slotted switch holes; the Jetson standoff screws (M2.5) countersunk from below; rear-shell screws in Ø8 × 5 bosses (8 mm thread-forming pilots, 6.5 mm engagement); '
    f'bay-board, battery-tray, caster and lid-post foot screws go into {len(INS_XY)} M3 × 3 brass heat-set inserts in Ø4.0 through holes, each pressed in flush with the face its screw enters (plate on a flat steel backing plate; deburr the far face).')
for i,(x,y) in enumerate(BAY_MOUNTS):insert(f'insert_bay_{i}',x,y,'top',allow=(f'bay_spacer_{i}',))
for i,(x,y) in enumerate(TRAYS):insert(f'insert_tray_{i}',x,y,'top',allow=('P_battery_tray',))
for i,(x,y) in enumerate(CASTER_SCREWS):insert(f'insert_caster_{i}',x,y,'bottom',allow=('caster_housing','P_battery_tray'))   # flush with the base top under the tray floor
for i,(cx,cy) in enumerate(LIDPOSTS):
    for j,xx in enumerate([cx-8,cx+8]):insert(f'insert_lid_post_{i+1}_{j}',xx,cy,'top',allow=(f'P_lid_post_{i+1}',))

# Battery tray and pack, as far aft as the base allows. Pack is inserted with its 140 mm dimension across robot.
tray=box(BX,0,33,56,146,2)
tray=union(tray,box(BX-27,0,35,2,146,7),box(BX+27,0,35,2,146,7),box(BX,-72,35,52,2,7),box(BX,72,35,52,2,7))
for x in [BX-24.75,BX+24.75]:   # strap slots through the floor only, inside the full 2 mm side walls
    for y in [-42,42]:tray=tray.cut(box(x,y,32,2.5,14,4))
for x,y in TRAYS:   # Ø9 corner bosses (the battery seats on them at z 37); M3 × 6 countersunk machine screws into the inserts, heads 1.5 mm below the seat
    tray=union(tray,cyl(x,y,35,4.5,2)).cut(union(cyl(x,y,32,1.7,6),cq.Solid.makeCone(1.7,3.0,1.3,cq.Vector(x,y,34.2)),cyl(x,y,35.5,3.0,2.5)))
for x in [BX-12,BX+12]:
    for y in [-30,30]:tray=union(tray,box(x,y,35,8,8,2))   # seat pads
# Removal path (review I3): the rear cliff PCBs (cliff_1 / cliff_2: x -116.5..-103.5, |y| >= 72, z >= 42.5) overhang the tray's side walls, so the
# floor and side walls are trimmed back to |y| <= TRAY_TRIM_Y under them (allowing for the TRAY_SLIDE aft slide and 1 mm): after its screws are out
# and the slide, the tray lifts straight out (validation bay_board.tray_removal). The battery keeps its lateral stops on the rest of the walls.
TRAY_SLIDE,TRAY_TRIM_Y=2.0,71.0
_rc=[p for p in CLIFF_IDS if p[0]<0];TRAY_TRIM_X=(min(x for x,_ in _rc)-6.5+TRAY_SLIDE-1,max(x for x,_ in _rc)+6.5+TRAY_SLIDE+1)   # cliff PCB 13 mm long in x
for sy in (-1,1):tray=tray.cut(box(sum(TRAY_TRIM_X)/2,sy*(TRAY_TRIM_Y+2),32,TRAY_TRIM_X[1]-TRAY_TRIM_X[0],4,12))
# Bay board rear-edge hold-down (HD, HOLDDOWN). Per finger: the wall over its beam raised to HD['top']; a horizontal slot under the beam (top
# ZS, HD['slot'] high) through the wall, ending in a round relief at the root; a vertical end slot past the free end; breakaway posts in the slot; the finger on the beam's free-end face (unloaded underside z_f = board top - preload, an HD['lead'] x 45 deg lead-in (B9: >= preload + stack + 0.1)
# under the tip). The STL holds it all as printed; the assembly draws the tray without the beams and bay_holddown = beams + fingers lifted by the
# preload (turned about the beam root).
HD_ZF=round(ZBAY_TOP-HD['preload'],3);HD_ZS=round(HD_ZF-HD['z_over'],3);HD_XT=round(BAY_EDGE_X+HD['reach'],3)
def hd_slot_poly(z_lo,z_hi):   # an xz polygon through the wall thickness between z ZS + z_lo and ZS + z_hi
    return [(TRAY_BACK-.01,HD_ZS+z_lo),(TRAY_FACE+.01,HD_ZS+z_lo),(TRAY_FACE+.01,HD_ZS+z_hi),(TRAY_BACK-.01,HD_ZS+z_hi)]
HD_BEAMS=[]   # per finger: dict(yc, gap, d, y_end, y_root, posts)
_raised,_cuts,_posts,_fing=[],[],[],[]
for yc,gap,d in HOLDDOWN:
    ye=yc-d*HD['w']/2;yr=yc+d*HD['L'];lo,hi=sorted((ye,yr));n=math.ceil((hi-lo-HD['post_w']/2)/HD['post_pitch'])
    posts=[round(ye+d*(HD['post_w']/2+i*HD['post_pitch']),3) for i in range(n)]
    HD_BEAMS.append(dict(yc=yc,gap=gap,d=d,y_end=round(ye,3),y_root=round(yr,3),posts=posts))
    _ra,_rb=(lo+hi)/2+d*1.0-(hi-lo+2.0+2*HD['relief_r'])/2,(lo+hi)/2+d*1.0+(hi-lo+2.0+2*HD['relief_r'])/2;_ra,_rb=max(_ra,-73.0),min(_rb,73.0)   # kept within the tray's side walls (y +-73)
    _raised.append(box((TRAY_BACK+TRAY_FACE)/2,(_ra+_rb)/2,42-.01,TRAY_FACE-TRAY_BACK,_rb-_ra,HD['top']-42+.01))
    _cuts+=[xz_fin(hd_slot_poly(-HD['slot'],0.),lo,hi),                                                      # the slot under the beam
            box((TRAY_BACK+TRAY_FACE)/2,ye-d*HD['end_slot']/2,HD_ZS-HD['slot'],TRAY_FACE-TRAY_BACK+.02,HD['end_slot'],HD['top']-HD_ZS+HD['slot']+1),   # end slot
            cyl(TRAY_BACK-.01,yr,HD_ZS-HD['slot']/2,HD['relief_r'],TRAY_FACE-TRAY_BACK+.02,'x')]   # root relief (keyhole)
    _posts+=[xz_fin(hd_slot_poly(-HD['slot']-.01,.01),q-HD['post_w']/2,q+HD['post_w']/2) for q in posts]
    f=box((TRAY_FACE+HD_XT)/2,yc,HD_ZF,HD_XT-TRAY_FACE,HD['w'],HD['finger_h'])
    _fing.append(f.cut(xz_fin([(HD_XT-HD['lead'],HD_ZF-.01),(HD_XT+.01,HD_ZF-.01),(HD_XT+.01,HD_ZF+HD['lead']+.01)],yc-HD['w']/2-.01,yc+HD['w']/2+.01)))
tray=union(tray,*_raised)
for c_ in _cuts:tray=tray.cut(c_)
_beams=[tray.intersect(xz_fin(hd_slot_poly(-.02,HD['top']+1-HD_ZS),*sorted((b_['y_end'],b_['y_root'])))) for b_ in HD_BEAMS]
tray_fixed=tidy(tray.cut(union(*_beams)))
def hd_spring():
    """The finger springs: beam section (wall thickness x from the slot top to HD['top']), bending k_b = 3EI/L^3 plus the twist of the
    beam under the finger's offset load (k_t = GJ / (L e^2)), the stack-up of the board top against the finger's rest, and the force and root
    bending stress at the minimum, nominal and maximum stack."""
    n=400;b=TRAY_FACE-TRAY_BACK;xs=(np.arange(n)+.5)/n*b;dx=b/n;bot=HD_ZS+0*xs;h=HD['top']-bot   # xs from the front face
    A=float((h*dx).sum());zc=float(((bot+h/2)*h*dx).sum()/A);I=float(((h**3/12+h*(bot+h/2-zc)**2)*dx).sum());c=max(HD['top']-zc,zc-HD_ZS)
    xc=TRAY_FACE-float(((xs)*h*dx).sum()/A);e=(BAY_EDGE_X+HD_XT-HD['lead'])/2-xc;hm=float(h.mean());r=hm/b;J=(1/3)*(1-.63/r+.052/r**5)*b**3*hm
    stack=dict(rib_height_mm=.10,rib_pocket_depth_mm=.10,board_thickness_mm=.16,tray_floor_mm=.10,finger_rest_over_floor_mm=.10,base_flatness_mm=.10)
    rss=math.sqrt(sum(v*v for v in stack.values()));lin=sum(stack.values())
    out=dict(section=dict(area_mm2=round(A,2),I_mm4=round(I,2),c_mm=round(c,2),J_mm4=round(J,2),load_offset_mm=round(e,2)),beam_length_mm=HD['L'],
             stack_up_tolerances_mm=stack,stack_rss_mm=round(rss,3),stack_linear_mm=round(lin,3),design_stack_mm=HD['stack'],preload_mm=HD['preload'])
    for E,key in ((HD['E'],'E2000'),(HD['E_creep'],'E1700')):
        G=E/(2*(1+HD['nu']));kb=3*E*I/HD['L']**3;kt=G*J/(HD['L']*e*e);k=1/(1/kb+1/kt)
        rows={}
        for lab,dd in (('min',HD['preload']-HD['stack']),('nominal',HD['preload']),('max',HD['preload']+HD['stack']),('linear_min',HD['preload']-lin),('linear_max',HD['preload']+lin)):
            F=k*dd;rows[lab]=dict(deflection_mm=round(dd,3),force_N=round(F,2),root_bending_MPa=round(F*HD['L']*c/I,1))
        out[key]=dict(k_bend_N_mm=round(kb,2),k_twist_N_mm=round(kt,2),k_N_mm=round(k,2),**rows)
    m=out['E2000']
    # B9 carry item 12: the tip's 45 deg lead-in must be taller than the board corner stands over the finger's rest at the worst stack, or the tip's
    # front face meets the corner and jams when the tray slides forward: lead >= preload + design stack + 0.1 (and, here, the linear worst case too).
    req=round(HD['preload']+HD['stack']+.1,3);req_lin=round(HD['preload']+lin+.1,3)
    out.update(lead_in_mm=HD['lead'],lead_in_required_mm=req,lead_in_covers_linear_worst_case=HD['lead']>=req_lin-1e-9,lead_in_linear_required_mm=req_lin,lead_in_ok=HD['lead']>=req-1e-9,
               contact_flat_mm=round(HD['reach']-HD['lead'],3))
    # Slot-end (root) relief: the beam meets the wall at the end of its 0.6 mm slot in a keyhole of radius relief_r. Stress concentration at that root,
    # estimated from Peterson's stepped-bar bending chart (D/d >= 2) at r/h (h: the beam depth): about 2.0-2.3 at r 0.6 mm (B8), 1.8-2.1 at r 0.75 (B9: the
    # largest relief that keeps the printability gate's 1.2 mm in-layer wall to the nearest breakaway post; r 0.9 left a 1.12 mm sliver), 1.7-1.9 at r 0.9.
    hb=round(HD['top']-HD_ZS,2);kt=(1.7,1.9) if HD['relief_r']>=.9 else ((1.8,2.1) if HD['relief_r']>=.75 else (2.0,2.3))
    out['root_relief']=dict(relief_r_mm=HD['relief_r'],beam_depth_mm=hb,r_over_h=round(HD['relief_r']/hb,3),kt_estimate=list(kt),
        local_peak_MPa=dict(max_stack=round(kt[1]*m['max']['root_bending_MPa'],1),linear_max=round(kt[1]*m['linear_max']['root_bending_MPa'],1)),yield_MPa=HD['yield_MPa'],
        note='estimate (chart read, not an FE result): the peak sits at the slot end, under the beam root; PETG creep is the long-term limit, which the feeler check at assembly and service catches')
    out['ok']=(out['design_stack_mm']>=rss-1e-9 and m['min']['force_N']>0 and 2.0<=m['nominal']['force_N']<=5.0 and m['max']['root_bending_MPa']<=HD['stress_limit_MPa'] and out['lead_in_ok'])
    return out
HD_SPRING=hd_spring();assert HD_SPRING['ok'],HD_SPRING
_hs=HD_SPRING['E2000']
HD_NPOSTS=sum(len(b_['posts']) for b_ in HD_BEAMS)
_rr=HD_SPRING['root_relief'];_lmin,_lmax=_hs['linear_min'],_hs['linear_max']
HD_TEXT=(f'{len(HOLDDOWN)} compliant hold-down fingers on its front wall (CAD id bay_holddown; at y {", ".join(f"{yc:.2f}" for yc,_,_ in HOLDDOWN)}, in the gaps of the bay board\'s rear connector row): each hangs from the free end of a '
         f'{HD["L"]:g} mm cantilever cut out of the wall (wall raised to z {HD["top"]:g} over it; it bends vertically, within the layers), reaches {HD["reach"]} mm over the board\'s rear edge (flat contact {HD_SPRING["contact_flat_mm"]:g} mm, then a {HD["lead"]} × 45° lead-in under the tip) and rests {HD["preload"]} mm below the board top, so the board lifts it by that much and it '
         f'holds the rear edge down on the ribs with {_hs["nominal"]["force_N"]} N ({_hs["min"]["force_N"]}–{_hs["max"]["force_N"]} N over the ±{HD["stack"]} mm design stack-up: rib, pocket, board 1.6 ± 0.16, tray floor, print tolerance; RSS {HD_SPRING["stack_rss_mm"]} mm), '
         f'root bending stress <= {_hs["max"]["root_bending_MPa"]} MPa ({100*_hs["max"]["root_bending_MPa"]/HD["yield_MPa"]:.0f} % of a {HD["yield_MPa"]:g} MPa PETG yield; a Ø{2*HD["relief_r"]:g} mm keyhole relief at each beam root keeps the local peak near {_rr["local_peak_MPa"]["max_stack"]:g} MPa, Kt about {_rr["kt_estimate"][0]:g}–{_rr["kt_estimate"][1]:g}, an estimate). '
         f'At the linear worst case (all six tolerances at their limits at once, ±{HD_SPRING["stack_linear_mm"]:g} mm, unlikely but possible): a finger can stand up to {-_lmin["deflection_mm"]:.2f} mm off the board (no hold-down there until shimmed), or its beam bends to {_lmax["root_bending_MPa"]:g} MPa '
         f'({100*_lmax["root_bending_MPa"]/HD["yield_MPa"]:.0f} % of yield, local peak about {_rr["local_peak_MPa"]["linear_max"]:g} MPa). The {HD["lead"]} mm lead-in clears the board corner even there ({HD_SPRING["lead_in_linear_required_mm"]:g} mm needed; '
         f'{HD_SPRING["lead_in_required_mm"]:g} mm at the design stack), so a finger rides up instead of jamming. '
         f'After printing, free the beams: run a fine razor saw (kerf <= 0.5 mm) along each of the three 0.6 mm slots under them, cutting its {HD_NPOSTS // 3} breakaway posts, so each beam springs freely. Fit the tray after the board: set it {TRAY_SLIDE:g} mm aft of its place and slide it forward, the fingers riding up their lead-ins onto the board top. '
         'Check: each finger stands lifted about 0.35 mm off its rest, and a 0.05 mm feeler does not pass under its tip. If it does, either the board is not seated on the ribs, a post is left, or the stack-up ran to the low end: then stick 0.1 mm PTFE tape (F03) under that finger\'s tip, '
         'a layer at a time (about 0.3 mm at most), until the feeler no longer passes (the shim remedy for visible play).')
add('P_battery_tray','Battery tray with strap slots and the bay board hold-down springs',tray_fixed,'print','F01','lower',printable=True,pshape=tidy(union(tray,*_posts,*_fing)),
    note='Four corner bosses and four pads seat the pack at z 37; four M3 × 6 countersunk machine screws into M3 heat-set inserts in P_base (heads 1.5 mm under the pack, 3.5 mm thread engagement). '
         f'Floor and side walls trimmed to |y| <= {TRAY_TRIM_Y:g} for x {TRAY_TRIM_X[0]:g}..{TRAY_TRIM_X[1]:g}, under the rear cliff sensor boards: with the battery and the screws out it slides {TRAY_SLIDE:g} mm aft and lifts straight out. '
         'The front wall carries '+HD_TEXT+' The STL is the tray as printed (one part, floor down, no supports).')
def hd_installed(k):   # beam + finger k turned about the beam root so the finger's contact rises by the preload
    b_=HD_BEAMS[k];ang=-b_['d']*math.degrees(HD['preload']/HD['L']);zp=(HD_ZS+HD['top'])/2
    return union(_beams[k],_fing[k]).rotate((TRAY_BACK,b_['y_root'],zp),(TRAY_FACE,b_['y_root'],zp),ang)
HDF=cq.Compound.makeCompound([hd_installed(k) for k in range(len(HD_BEAMS))])
add('bay_holddown',f'Bay board rear-edge hold-down springs ({len(HOLDDOWN)}, printed with the battery tray)',HDF,'print','F01','lower',check=True,allow=('P_battery_tray',),
    note='Part of the P_battery_tray print, drawn installed (each beam lifted by the board through its preload): '+HD_TEXT+' Drawn as its own id so pcb/extract_outline.py lists it with the ribs as a designed contact.')
for i,(x,y) in enumerate(TRAYS):tfa(f'tray_screw_{i}',x,y,35.5,29.5,head='csk',allow=('P_base','P_battery_tray',f'insert_tray_{i}'),name='Battery tray M3 × 6 countersunk machine screw (into insert)',bom='H13')
add('battery','Existing Tenergy NiMH battery envelope',rounded(BX,0,37,50,140,27,3),'owned','P01','lower',check=True,note='Envelope allowance: 140 × 50 × 27 mm. Physical pack not measured. Centre x = -96 (tray rear wall flush with the rear base edge) to keep the robot centre of mass behind the axle without ballast.')
for i,y in enumerate([-42,42]):
    strap=union(box(BX,y,64.3,52,10,1),box(BX-25.5,y,35,1,10,30),box(BX+25.5,y,35,1,10,30))
    add(f'strap_{i}','Battery retaining strap',strap,'black','C12','lower')
TAM=(-82,-16)   # Tamiya mated pair on the battery top, between the straps and clear of the lid-top switches' plan areas (aft of the bay board)
add('tamiya','J01 battery connector, mated pair (on the battery top)',rounded(TAM[0],TAM[1],65,14,30,11,2),'connector','C04','lower',
    note='Lies along y on 1 mm hook-and-loop tape on the pack top (z 65-76), x -89..-75, y -31..-1: 4.7 mm ahead of the master rocker body and 6 mm from the -y strap. An adapter lead (W01) runs from it over the tray front wall to J1 on the bay board\'s rear edge.')

# Differential drive on the base_link axle (x = 0), shaft fits and fasteners.
for side,sgn in [('left',1),('right',-1)]:
    # All motor shapes are first made for the left side; mirror for right.
    motor=union(cyl(AX,35,40,12.2,14.7,'y'),cyl(AX,49.7,40,12.2,30.8,'y'),cyl(AX,80.5,40,12.5,23.5,'y'))
    shaft=cyl(AX,104,40,2,12.5,'y')
    motor=union(motor,shaft)
    if sgn<0:motor=motor.mirror('XZ')
    add('motor_'+side,'Pololu 4867 '+side+' encoder motor',motor,'metal','E05','wheels',check=True,explode=[0,sgn*55,0],note='Dimensioned simplified envelope; reference vendor STEP is included separately.')
    # Face plate (x ±23, y 104..107, z 25..55) outside the base edge; two 9 × 19 × 5 mm tabs on the base top carry the wheel load, each with a
    # 45 deg gusset (9 wide, 8 mm legs) into the plate's inner face: support-free when printed '+y down' (outer face on the bed).
    bracket=box(AX,105.5,25,46,3,30)
    for x in [AX-20,AX+20]:
        xc=AX+math.copysign(18.5,x-AX);bracket=union(bracket,box(xc,97.5,33,9,19,MTAB),yz_fin([(104.01,33+MTAB-.01),(96,33+MTAB-.01),(104.01,33+MTAB+8)],xc-4.5,xc+4.5))   # tabs x ±(14..23): 1.5 mm to the motor, 2 mm to saddle 3
    bracket=hole(bracket,AX,102,40,4.2,7,'y')
    for x in [AX-8.5,AX+8.5]:bracket=hole(hole(bracket,x,102,40,1.65,7,'y'),x,106,40,3.05,2,'y')   # 1 mm counterbore: button head 1.85 mm from the wheel disc
    for x in [AX-19,AX+19]:bracket=hole(bracket,x,94,32,1.7,MTAB+3)
    if sgn<0:bracket=bracket.mirror('XZ')
    add('P_motor_mount_'+side,'Motor face mount '+side,bracket,'print','F01','wheels',printable=True,explode=[0,sgn*45,0],note='17 mm motor-face screw spacing. The two 9 × 5 mm tabs carry the wheel load into the base top through 45 deg gussets (9 wide, 8 mm legs) on the plate\'s inner face: the tab bending stress is in validation interlayer_stress.motor_mount. Print on the outer face (+y down), supports disabled; the two Ø6.1 × 1 counterbores open on the bed face and their 1.4 mm ring ceilings print as short bridges (a 0.2 mm sacrificial layer would fail the 1.2 mm wall gate on this small part): if they sag, clean the seat with a Ø6 drill. Proof-load before use: hang 3 kg (about 3 g of wheel load) from the wheel for 1 min, no whitening at the tab roots.')
    tire=cyl(AX,109,40,40,10,'y').cut(cyl(AX,108,40,33,12,'y'))
    wheel=cyl(AX,109.5,40,33,9,'y').cut(cyl(AX,108,40,2.15,12,'y'))
    for a in range(0,360,60):
        x=AX+21*math.cos(math.radians(a));z=40+21*math.sin(math.radians(a))
        wheel=hole(wheel,x,108,z,7,12,'y')
    if sgn<0:tire=tire.mirror('XZ');wheel=wheel.mirror('XZ')
    add('tire_'+side,'80 mm tire '+side,tire,'black','M01','wheels',check=True,explode=[0,sgn*80,0])
    add('wheel_'+side,'Wheel disc and 4 mm collet '+side,wheel,'metal','M01','wheels',explode=[0,sgn*80,0],note='The Ø4.3 collet bore sits on the Ø4 D-shaft (0.15 mm radial clearance as drawn: the collet clamps it). The hub face starts 5.5 mm past the motor face plate (1.85 mm past the recessed button heads); set the wheel on the shaft with a 1.5 mm feeler between hub and plate.')
    for x in [AX-19,AX+19]:screw(f'motor_base_{side}_{x}',x,sgn*94,29,4+MTAB,group='wheels',allow=('P_base','P_motor_mount_'+side))
    for x in [AX-8.5,AX+8.5]:
        s=union(cyl(x,100,40,1.5,6,'y'),cyl(x,106,40,2.85,1.65,'y'))   # ISO 7380 button head recessed 1 mm: 1.85 mm to the wheel disc, 4 mm into the motor face
        if sgn<0:s=s.mirror('XZ')
        add(f'motor_face_{side}_{x}','Motor M3 × 6 button-head face screw',s,'metal','H06','wheels',check=True,allow=('motor_'+side,'P_motor_mount_'+side),explode=[0,sgn*45,0])

# One rear ball caster at x -75 (about 23 % of the weight): the rear cliff sensors (x -110) lead its loaded contact by 35 mm in reverse.
ball=cq.Solid.makeSphere(RB,cq.Vector(CX,0,RB),angleDegrees1=-90)   # full sphere (the default is a hemisphere)
housing=cyl(CX,0,14,20,15).cut(cq.Solid.makeSphere(13,cq.Vector(CX,0,RB),angleDegrees1=-90))
add('caster_ball','Rear caster ball',ball,'metal','M02','base',check=True)
add('caster_housing','Rear caster housing envelope',housing,'black','M02','base',note='Housing outline remains provisional; height is 29 mm. Three M3 × 5 pan-head machine screws on a 16.5 mm bolt circle (outside the Ø25.4 ball: the heads can never touch it) through the 2 mm flange tabs into M3 heat-set inserts pressed into P_base from below; tips 1.0 mm under the base top. Drill the flange tabs to this pattern if the purchased caster differs.')
for i,(x,y) in enumerate(CASTER_SCREWS):tfs(f'caster_screw_{i}',x,y,25.0,32.0,allow=('P_base','caster_housing',f'insert_caster_{i}'),name='Caster M3 × 5 pan-head machine screw (into insert)',bom='H13',note=INOTE)   # head under a 2 mm flange tab (z 27..29) outside the ball: tip z 32.0, 1.0 mm under the base top

# Power & I/O bay board (bay B8): the routed board from its fab STEP (laminate and every fitted part, leads trimmed to LEAD_TRIM), its plug-in
# modules from the official models on their real socket pads (Raspberry Pi Pico R3, Pololu 4035 DRV8874 carrier; the GY-521 as a body at its
# PARTS h), the mated plugs on its edge connectors, the Pico USB plug at the receptacle, four 2.4 mm printed spacers with M3 × 8 screws into the base
# inserts, two printed clamp spacers under the rear Jetson standoffs, and the printed bearing ribs under the rear connector row.
def step_components(path):
    """{component name: located shape} of an assembly STEP's top-level components (KiCad names each part by its reference; its board, copper and
    via bodies are unnamed components whose product names are r1_power_io_PCB / _copper / _via)."""
    from OCP.STEPCAFControl import STEPCAFControl_Reader
    from OCP.TDocStd import TDocStd_Document
    from OCP.XCAFDoc import XCAFDoc_DocumentTool
    from OCP.TDF import TDF_LabelSequence,TDF_Label
    from OCP.TCollection import TCollection_ExtendedString
    from OCP.TDataStd import TDataStd_Name
    from OCP.IFSelect import IFSelect_RetDone
    doc=TDocStd_Document(TCollection_ExtendedString('XmlOcaf'));rd=STEPCAFControl_Reader();rd.SetNameMode(True)
    assert rd.ReadFile(str(path))==IFSelect_RetDone,path
    rd.Transfer(doc);st=XCAFDoc_DocumentTool.ShapeTool_s(doc.Main());top=TDF_LabelSequence();st.GetFreeShapes(top);assert top.Length()==1
    def name(l):
        n=TDataStd_Name();return n.Get().ToExtString() if l.FindAttribute(TDataStd_Name.GetID_s(),n) else ''
    comps=TDF_LabelSequence();st.GetComponents_s(top.Value(1),comps);out={}
    for i in range(1,comps.Length()+1):
        l=comps.Value(i);ref=TDF_Label();st.GetReferredShape_s(l,ref);n=name(l)
        out[name(ref) if n.startswith('=>') or not n else n]=cq.Shape.cast(st.GetShape_s(l))
    return out
STEP_SKIP=('r1_power_io_copper','r1_power_io_via')   # 35 um copper skins and the via barrels: no volume to speak of, but 70k mesh vertices
ZTRIM=round(ZBAY-LEAD_TRIM,3)
_SC=step_components(ROOT/BC['step']);assert {'r1_power_io_PCB',*STEP_SKIP}<=set(_SC) and set(BC['parts'])>={n for n in _SC if not n.startswith('r1_')},sorted(_SC)
def _trim(s):   # STEP frame -> robot, THT leads cut at LEAD_TRIM under the board
    s=s.translate(cq.Vector(*_BF['step_to_robot_mm']))
    return s.intersect(box(-20,0,ZTRIM,300,300,200)) if s.BoundingBox().zmin<ZTRIM-1e-6 else s
BSTEP={n:_trim(s) for n,s in _SC.items() if n not in STEP_SKIP}
# STEP heights: max(model, PARTS h) (pcb/fab/ORDERING.md). Lower in the STEP than PARTS h: D1 (an envelope at its PARTS h joins the board), the XH
# headers J6-J13 (their mated plugs, bay_plug_*, stand at max(MATED_H, PARTS h)) and the module sockets (the modules plug in on top). Higher: U5A / U5B
# (the model's 13.8 mm is kept). The sets are asserted against that table, so a model or PARTS h change stops the build here.
SOCKETS={s for m in BMOD.values() for s in m['sockets']}
STEP_H={r:round(BSTEP[r].BoundingBox().zmax-ZBAY_TOP,2) for r in BSTEP if r in BC['parts']}
_lower={r for r,h in STEP_H.items() if BC['parts'][r]['h']>h+.2};_higher={r for r,h in STEP_H.items() if h>BC['parts'][r]['h']+.2}
assert _lower=={'D1',*(f'J{i}' for i in range(6,14)),*SOCKETS} and _higher=={'U5A','U5B'},(_lower,_higher)
_env=[]
for r in sorted(_lower-SOCKETS-set(BCONN)):
    q=BSTEP[r].BoundingBox();_env.append(box((q.xmin+q.xmax)/2,(q.ymin+q.ymax)/2,ZBAY_TOP,q.xlen,q.ylen,BC['parts'][r]['h']))
STEP_ENVELOPES=sorted(_lower-SOCKETS-set(BCONN))
bb=cq.Compound.makeCompound(list(BSTEP.values())+_env)
_bq=bb.BoundingBox()
add('bay_board','Power & I/O bay board: the routed 4-layer board with its fitted parts (pcb/fab/r1_power_io.step)',bb,'pcb','E17/E18','lower',check=True,tess=(.3,.5),
    note=f'KiCad fab STEP (pcb/fab/r1_power_io.step, robot = STEP + (-66.5, 50, 35.4)): the laminate and every fitted part model (the J1 XT30, J2 JST VH and J3 Micro-Fit headers, the FLR fuse holders and C1 as their envelopes), '
         f'copper skins and via barrels left out; THT leads cut at {LEAD_TRIM} mm under the board (z {ZTRIM:g}: the assembly trims them to <= {LEAD_TRIM} mm, 1.0 mm over the base top); '
         f'{", ".join(STEP_ENVELOPES)} at {"its" if len(STEP_ENVELOPES)==1 else "their"} PARTS h (STEP heights: max(model, PARTS h)). Outline x {_bq.xmin:.1f}..{_bq.xmax:.1f}, |y| <= 50 (tongue |y| <= 33.4 for x > -13.8), z {ZBAY:g}–{ZBAY_TOP:g}; '
         'on four 2.4 mm printed PETG spacers with M3 × 8 pan-head screws into heat-set inserts at '+', '.join(f'({x:g}, {y:g})' for x,y in BAY_MOUNTS)+' (Ø3.2 holes), and clamped at '
         +', '.join(f'({x:g}, {y:g})' for x,y in BAY_CLAMPS)+f' (Ø{BC["clamp_holes"][0]["d"]:g} NPTH, ruling PB3) between a printed clamp spacer and a rear 20 mm Jetson standoff; its rear edge held down by {len(HOLDDOWN)} fingers on the battery tray wall. '+BAY_ZONES+' '+ASSY_ORDER)
# Plug-in modules on their socket pads (as $SP/show/modules_bay.py places them for the viewer): the module PCB underside rests on its male header
# plastic (HDR_H) on top of the 8.5 mm sockets; the headers' short pin ends stand 3.0 mm over the module PCB underside (through the PCB).
HMOD,HDR_H=BMOD['Pico']['pcb_underside_z'],_BF['header_h']
assert all(m['pcb_underside_z']==HMOD for m in BMOD.values())
def rigid(p1_m,a_m,b_m,n_m,P1,A,Bv):
    """(R, t): model point p1_m -> P1, model axes (a, b, n) -> robot (A, B, +z). Fails if the socket layout would mirror the module."""
    M=np.column_stack([a_m,b_m,n_m]).astype(float);Rr=np.column_stack([A/np.linalg.norm(A),Bv/np.linalg.norm(Bv),[0,0,1]])
    R=Rr@np.linalg.inv(M);assert abs(np.linalg.det(R)-1)<1e-6,f'socket layout mirrors the module: det {np.linalg.det(R)}'
    return np.round(R,12),P1-R@np.asarray(p1_m,float)
def moved_shape(shape,R,t):
    from OCP.gp import gp_Trsf
    from OCP.BRepBuilderAPI import BRepBuilderAPI_Transform
    tr=gp_Trsf();tr.SetValues(*[float(v) for v in (R[0,0],R[0,1],R[0,2],t[0],R[1,0],R[1,1],R[1,2],t[1],R[2,0],R[2,1],R[2,2],t[2])])
    return cq.Shape.cast(BRepBuilderAPI_Transform(shape.wrapped,tr,True).Shape())
def spin(mod,sock,n):x,y=BMOD[mod]['sockets'][sock][str(n)];return np.array([x,y,HMOD])
def strip(P,Q,z0,z1,w=2.54):   # a pin-row strip from pin P to pin Q (plan), w wide, w/2 past the end pins, z0..z1
    d=Q-P;L=float(np.hypot(d[0],d[1]))+w
    return box(0,0,z0,L,w,z1-z0).rotate((0,0,0),(0,0,1),math.degrees(math.atan2(d[1],d[0]))).translate(((P[0]+Q[0])/2,(P[1]+Q[1])/2,0))
def headers(rows,pcb_t):   # male header plastic under the module PCB and the short pin ends (0.64 mm pins) through it, 3.0 mm over the PCB underside
    return [strip(P,Q,HMOD-HDR_H,HMOD) for P,Q in rows]+[strip(P,Q,HMOD+pcb_t,HMOD+3.0,.64) for P,Q in rows]
_pico=cq.importers.importStep(str(ROOT/'reference-models'/'pico-r3'/'Pico-R3.step')).val()
P1,P20,P40,P60=spin('Pico','U1A',1),spin('Pico','U1A',20),spin('Pico','U1B',1),spin('Pico','U1B',20)
R_,t_=rigid((1.61,-0.5,-49.63),(0,0,1),(1,0,0),(0,1,0),P1,P20-P1,P40-P1)   # Pico-R3.step: PCB y -0.5..0.5 (parts +y), pin 1 (GP0) at x 1.61, z -49.63, USB end z -51
_usbc=np.array([R_@np.array(c)+t_ for c in itertools.product((6.71,14.29),(0.5,3.02),(-52.3,-46.7))])   # micro-B receptacle (body y 0.5..3.02, shell tabs to z -52.3)
USB_FACE=(round(float(_usbc[:,0].mean()),3),round(float(_usbc[:,1].max()),3),round(float(_usbc[:,2].mean()),3))
assert all(abs(a-b)<.3 for a,b in zip(USB_FACE,PICO_USB)),(USB_FACE,PICO_USB)
add('bay_pico','Raspberry Pi Pico on sockets (official Pico R3 STEP)',cq.Compound.makeCompound([moved_shape(_pico,R_,t_)]+headers([(P1,P20),(P40,P60)],1.0)),'owned','E02','lower',check=True,tess=(.3,.5),allow=('pico_usb_plug',),
    note=f'Raspberry Pi Pico-R3.step on the U1A / U1B socket pads (pin 1 GP0 at U1A.1, not mirrored), PCB underside z {HMOD:g} on its male headers ({HDR_H:g} mm plastic on the 8.5 mm sockets). Behind the Jetson carrier '
         f'(exposed with the lid off), long axis along y, micro-USB receptacle face at ({USB_FACE[0]:.2f}, {USB_FACE[1]:.2f}, {USB_FACE[2]:.2f}), at the board\'s left edge.')
_drv=cq.importers.importStep(str(ROOT/'reference-models'/'pololu-4035-drv8874-carrier.step')).val()
for k,(mod,n,sd) in enumerate((('DRV_L',3,'left'),('DRV_R',4,'right'))):
    L1,L7,Q1,Q7=spin(mod,f'U{n}L',1),spin(mod,f'U{n}L',7),spin(mod,f'U{n}P',1),spin(mod,f'U{n}P',7)
    R_,t_=rigid((1.27,16.51,0),(0,-1,0),(1,0,0),(0,0,1),L1,L7-L1,Q1-L1)   # Pololu 4035 STEP: z-up, VM / logic row L at x 1.27 (pin 1 at y 16.51), VIN row P at x 13.97
    add(f'bay_drv_{k}',f'Pololu DRV8874 carrier on sockets, {sd} motor (official Pololu 4035 STEP)',cq.Compound.makeCompound([moved_shape(_drv,R_,t_)]+headers([(L1,L7),(Q1,Q7)],1.6)),'pcb','E16','lower',check=True,tess=(.3,.5),
        note=f'Pololu 4035 STEP on the U{n}L / U{n}P socket pads (turned 180 deg in place, PB15 / PB16: logic row toward the Pico, VIN / OUT row toward J{4 if n==3 else 5}; not mirrored), PCB underside z {HMOD:g}. Under the Jetson carrier.')
_r1,_r8=spin('IMU','U2',1),spin('IMU','U2',8);_d=(_r8-_r1)/np.linalg.norm(_r8-_r1);_e=np.array([-_d[1],_d[0],0.])   # row direction; module body side (+90 deg)
_ib=np.array(BMOD['IMU']['body_xy']);_ic=_ib.mean(0);_ia=math.degrees(math.atan2(_d[1],_d[0]))
def _imu_box(c,lx,ly,z0,h):return box(0,0,z0,lx,ly,h).rotate((0,0,0),(0,0,1),_ia).translate((float(c[0]),float(c[1]),0))
IMU_TOP=round(ZBAY_TOP+BC['parts']['U2']['h'],3)
_imu=[_imu_box(_ic,21.2,16.4,HMOD,1.6),_imu_box(_ic,4,4,HMOD+1.6,.9)]+[_imu_box(_ic+_d[:2]*s_+_e[:2]*4,3,1.6,HMOD+1.6,1.1) for s_ in (-5,5)]+headers([(_r1,_r8)],1.6)
add('bay_imu','GY-521 IMU on a socket (21.2 × 16.4 × 1.6 mm board, MPU-6050)',cq.Compound.makeCompound(_imu),'owned','E03','lower',check=True,
    note=f'GY-521 board (board_spec MODULES IMU) on the U2 socket pads, PCB underside z {HMOD:g}, parts and pin ends to z {IMU_TOP:g} (PARTS h). Under the Jetson carrier, over C3 (DRV_L\'s 100 uF V-chip): validation bay_board.c3_under_imu. Rigid attachment required (socket plus a screw or adhesive pad).')
# Mated plugs on the edge connectors (the harness housings; the P03 leads go straight into the screw terminals U5A / U5B): vertical XH / VH plugs on
# the header body up to max(MATED_H, PARTS h). J4 / J5 (right-angle 1x6 headers, B3): B3 sized their lay-flat zone for the motors' factory 1x6 housing
# (MOTOR_PLUG_L long from the header body face to the far end, courtyard + MATED_REACH: the B3 envelope, kept as the largest plug the zone takes). What
# is plugged there now is the C18 pigtail's board end (B9, carry item 2): a 1x6 2.54 mm RIGHT-ANGLE female socket header (RA_SOCKET; e.g. Sullins
# PPPC061LGBN-RC, verify) pushed onto the pins, its insulator lying on the board from the header body face, its six solder tails leaving its back face
# and turned UP; each wire is soldered to a tail tip under a heat-shrink sleeve, so the wires leave the board upward, well clear of the motor face, and
# bend over above the sleeves (the pigtail route below) - not along the pins into the 2.16 mm gap at the motor face (B8: 0.8 mm bend).
MOTOR_PLUG_L=14.0
RA_SOCKET=dict(part='Sullins PPPC061LGBN-RC: 1x6 2.54 mm right-angle female socket header, through-hole (2.54 mm insulator lying on the board, 8.51 mm deep, tails 3.15 mm; verify)',
               depth=8.51,h=2.54,tail_off=1.27,tail_len=3.15,sleeve_d=1.8,sleeve_past_tail=2.5,solder_overlap=2.0)
# h: the insulator (it lies on the board; contact axis at h / 2 = J4 / J5's pin height); tail_len: the tails stand 3.15 mm past the insulator face they
# leave (turned up: past its top face); tail_off: tail centre behind the rear face (0.050 in, from memory: verify on the Sullins drawing); the wire is
# lapped solder_overlap mm on each tail tip under a Ø sleeve_d heat-shrink that reaches sleeve_past_tail mm past the tip.
# B12a (ruling PB30): J1 / J2 / J3 are three connector families (XT30 / JST VH / Micro-Fit 3.0), each with its own mate (PLUG_BOM). J3 is a
# right-angle Micro-Fit header in the band: its receptacle enters its face at the board's right edge and stands out past it (board_cad
# offboard_reach: receptacle + crimp ends), at the header's height (MATED_H), the lead leaving its far end (plug_end_xy).
PLUG_BOM=dict(VH='C05',XT30='C19',MicroFit='C20')
PLUG_BOX={};SOCKET={}
for r,c in BCONN.items():
    if c['family']=='Terminal':continue
    bx0,by0,bx1,by1=c['body_xy']
    if c['vertical']:PLUG_BOX[r]=(bx0,by0,bx1,by1,ZBAY_TOP,ZBAY_TOP+max(c['mated_h'],BC['parts'][r]['h']))
    elif c['offboard_reach']:
        (ex,ey),(px,py)=c['entry_xy'],c['plug_end_xy'];face=(bx1 if ex>0 else bx0) if ex else (by1 if ey>0 else by0)
        PLUG_BOX[r]=((min(face,px),by0,max(face,px),by1) if ex else (bx0,min(face,py),bx1,max(face,py)))+(ZBAY_TOP,round(ZBAY_TOP+c['mated_h'],3))
    else:
        (ex,ey),(cx0,cy0,cx1,cy1)=c['entry_xy'],c['courtyard_xy'];W=2.54*len(c['pins_xy']);pc=np.mean(c['pins_xy'],0)
        assert not ex and r in ('J4','J5'),r   # only the motor headers lie on the board, entry along y
        far=cy1+c['mated_reach'] if ey>0 else cy0-c['mated_reach'];face=far-ey*MOTOR_PLUG_L;back=face+ey*RA_SOCKET['depth'];tail=back+ey*RA_SOCKET['tail_off']
        y0,y1=sorted((face,back));x0,x1=pc[0]-W/2,pc[0]+W/2
        PLUG_BOX[r]=(x0,y0,x1,y1,ZBAY_TOP,round(ZBAY_TOP+RA_SOCKET['h'],3))
        top=round(ZBAY_TOP+RA_SOCKET['h']+RA_SOCKET['tail_len']+RA_SOCKET['sleeve_past_tail'],3)   # sleeve tops (z 45.19): where the wires leave, upward
        ty0,ty1=sorted((back,tail+ey*RA_SOCKET['sleeve_d']/2))
        SOCKET[r]=dict(face_y=round(face,3),back_y=round(back,3),tail_y=round(tail,3),x=(round(x0,3),round(x1,3)),pc_x=round(float(pc[0]),3),top_z=top,
                       tails=(x0,ty0,x1,ty1,ZBAY_TOP,top),b3_far_y=round(far,3))
    x0,y0,x1,y1,z0,z1=PLUG_BOX[r]
    if r in SOCKET:
        tx0,ty0,tx1,ty1,tz0,tz1=SOCKET[r]['tails']
        add(f'bay_plug_{r}',f'{r}: C18 pigtail board end (right-angle female socket, tails and wire sleeves up)',union(box((x0+x1)/2,(y0+y1)/2,z0,x1-x0,y1-y0,z1-z0),box((tx0+tx1)/2,(ty0+ty1)/2,tz0,tx1-tx0,ty1-ty0,tz1-tz0)),
            'connector','C18','lower',check=True,allow=('bay_board',),
            note=f'{RA_SOCKET["part"]} on {r}\'s right-angle pins: insulator y {y0:.2f}..{y1:.2f}, z {z0:g}–{z1:g} on the board; its six tails turned up behind it (y {SOCKET[r]["tail_y"]:.2f}), a wire soldered to each tail tip under '
                 f'a Ø{RA_SOCKET["sleeve_d"]} heat-shrink sleeve, sleeve tops z {tz1:g} ({tz1-ZBAY_TOP:.2f} mm over the board, under-carrier limit {UNDER_CARRIER_Z-1.5-ZBAY_TOP:.2f}): the wires leave upward. '
                 f'Inside B3\'s lay-flat zone for {r} (the factory housing would end at y {SOCKET[r]["b3_far_y"]:.2f}). Plugged on the bench before the board goes in (PB25).')
    else:
        add(f'bay_plug_{r}',f'{r} mated plug ({c["family"]})',box((x0+x1)/2,(y0+y1)/2,z0,x1-x0,y1-y0,z1-z0),'connector',
            PLUG_BOM.get(c['family'],'C06' if len(c['pins_xy'])==5 else 'C08'),'lower',check=True,allow=('bay_board',),
            note=(f'Mated {c["family"]} receptacle on {r}\'s right-angle header, out past the board edge: x {x0:.2f}..{x1:.2f}, y {y0:.2f}..{y1:.2f}, z {z0:g}–{z1:g} (the receptacle and its crimp ends, {c["offboard_reach"]:g} mm past the header face); '
                  f'the lead leaves its far end ({c["entry"]} in board terms) and bends up ({c["offboard_bend"]:g} mm) into the W04 corridor. Verify the purchased housing.') if c['offboard_reach'] else
                 f'Mated {c["family"]} plug envelope on {r} (z {z0:g}–{z1:g}; the cable leaves {c["entry"]} in board terms, after a {c["bend"]:g} mm wire bend over the plug). Verify the purchased housing.')
PICO_PLUG=(11,18,7)   # micro-B plug overmold (x, y, z) out of the receptacle along +y, centred on the receptacle
add('pico_usb_plug','Pico micro-B cable plug (mated)',box(USB_FACE[0],USB_FACE[1]+PICO_PLUG[1]/2,USB_FACE[2]-PICO_PLUG[2]/2,*PICO_PLUG),'black','C02','lower',allow=('bay_pico',),
    note=f'Plugs along -y into the Pico micro-USB at the board\'s left edge, in the free space x {USB_FACE[0]-PICO_PLUG[0]/2:.1f}..{USB_FACE[0]+PICO_PLUG[0]/2:.1f}, y {USB_FACE[1]:.2f}..{USB_FACE[1]+PICO_PLUG[1]:.2f} '
         '(the old strip end), pushed in from above with the lid off (validation pico_usb_insert_path_clear). The W16 cable leaves along +y.')
for i,(x,y) in enumerate(BAY_MOUNTS):
    add(f'bay_spacer_{i}','Bay board 2.4 mm printed PETG spacer (Ø7 / Ø3.4)',hole(cyl(x,y,33,3.5,ZBAY-33),x,y,32,1.7,ZBAY-31),'print','F01','lower',check=True,printable=True,
        allow=('bay_board','P_base',f'insert_bay_{i}',f'bay_screw_{i}'),note='Printed flat in PETG, 100 % infill (it carries the screw clamp load); sits on the insert, under the board\'s M3 hole.')
    tfa(f'bay_screw_{i}',x,y,ZBAY_TOP,ZBAY_TOP-8,allow=('P_base',f'bay_spacer_{i}','bay_board',f'insert_bay_{i}'),name='Bay board M3 × 8 pan-head machine screw (through the board and its spacer into the insert; tip flush with the base underside)',bom='H13')
for x,y in BAY_CLAMPS:   # under the rear Jetson standoff stacks: P_base → clamp spacer → board → 20 mm standoff
    ji=min(range(len(JHOLES)),key=lambda k:math.dist(JHOLES[k],(x,y)));assert math.dist(JHOLES[ji],(x,y))<1e-6,'BAY_CLAMPS must sit on the rear Jetson holes'
    add(f'bay_clamp_spacer_{ji}',f'Bay board 2.4 mm printed PETG clamp spacer under the rear Jetson standoff {ji} (Ø7 / Ø2.9)',hole(cyl(x,y,33,3.5,ZBAY-33),x,y,32,1.45,ZBAY-31),'print','F01','lower',check=True,printable=True,
        allow=('bay_board','P_base',f'jetson_screw_{ji}'),note='Printed flat in PETG, 100 % infill: the board is clamped between it and the 20 mm F-F standoff by the M2.5 × 12 countersunk screw from under P_base.')
for k,((x0,x1,y0,y1),pk) in enumerate(zip(BAY_RIBS,RIB_POCKETS)):
    under=[r for r,(a0,a1,b0,b1) in BAY_REAR_ROW.items() if a0<x1 and x0<a1 and b0<y1 and y0<b1]
    rib=union(box((x0+x1)/2,(y0+y1)/2,33,x1-x0,y1-y0,ZBAY-33),*[box((x0+x1)/2,(a_+b_)/2,33-RIB_POCKET,x1-x0,b_-a_,RIB_POCKET+.01) for a_,b_ in pk])
    _plen=sum(b_-a_ for a_,b_ in pk)
    add(f'bay_rib_{k}',f'Bay board bearing rib {k} under the rear connector row ({", ".join(under)}; printed PETG)',rib,'print','F01','lower',check=True,printable=True,allow=('P_base','bay_board'),
        note=f'{x1-x0:.2f} × {y1-y0:.1f} mm bar along y (x {x0:g}..{x1:g}), {ZBAY-33:g} mm tall over the base top plus a {RIB_POCKET} mm key into its locating pocket in the P_base top ({RIB_CLR} mm a side) '
             f'over {_plen:.1f} of its {y1-y0:.1f} mm'+('' if _plen>=y1-y0-1e-6 else ' (elsewhere it stands on the plain base top, clear of the caster insert under it)')+
             f': it carries the board when the rear-edge connectors are plugged and unplugged. Bonded in its pocket with epoxy (assembly step 1, cure before the board goes on). >= {RIB_GAP} mm in plan from every THT pad of the real board '
             f"(leads trimmed to <= {LEAD_TRIM} mm; validation bay_board.rear_row_ribs). Print it on its long side ('+x down' or '-x down' in cad/printability.json: its largest flat face, so the key profile prints in the layer plane); check its {ZBAY-33:g} mm height with calipers.")
# Motor pigtails, inline joints and factory cables (ruling PB25 amended; B9 carry items 2, 3, 8-11, fix round 1). The factory motor cable is
# permanent at the motor and J4 / J5 cannot be unplugged with the motors fitted (B8 review I2), so each of J4 / J5 carries a short pigtail (BOM C18),
# plugged in on the bench before the board goes in; it stays with the board. The motor's factory female housing mates with the pigtail's male end at
# an inline joint (MJ) resting on P_base just ahead of the motor, reachable from above with the Jetson off. To take the board out, the joints are
# unplugged first (PB25 amended), so a pigtail rides up with the board and needs no slack.
#  - Pigtail: the board end is the right-angle socket on J4 / J5 (RA_SOCKET, SOCKET) with its six wires leaving its tails upward. Six 28 AWG
#    silicone wires (Ø1.0), colour-coded like the factory cable, rise out of the sleeves, turn toward the front (+x) and run as a Ø3 bundle at
#    z PG['run_z'] beside U5A / J9 (|y| 30.5, inboard of the factory leads' flat row on the motor face), step out to |y| 33 before the P03 corner
#    (x 9, |y| <= 31), pass between the P03 and the motor's inner end face, and turn down into the joint's male housing. Every corner is a fillet
#    of PG['r_fillet'] (centreline; the innermost wire bends at r_fillet - (r_run - r_wire) >= 3 x the wire OD). Finished length of a wire on the bundle
#    axis = the drawn route (sleeve top to the male housing's rear face) + the terminations drawn inside the socket's sleeve block and the housing
#    (PG['term']); the six sleeves span PG['pin_spread_mm'] along the header, so the outer wires are +-spread/2 off that axis (the rear pin's wire the
#    longest). Fix round 2: the wires are PRE-CUT to route + terminations + spread/2 (rounded up to the mm), the socket end soldered first, the bundle
#    dressed along its route and each wire then trimmed to its own length and crimped. Per side (J4's socket sits 4.3 mm further aft than J5's).
#  - Factory cable (200 mm): from the encoder exit on the motor's inner end face (board_spec MOTOR_CABLE_EXIT, z 43) as a flat row of leads along
#    the face toward -x (outboard of the pigtail, never over it: the pigtail's lift path stays clear), round the motor's -x shoulder, forward (+y)
#    beside it under the carrier, up outside the carrier's footprint (|y| > 50), along +x over the motor top at |y| MC['y_top'], down the motor's
#    front shoulder (x 11) under the bumper lead, into a flat
#    coil on the base ahead of the motor (MCOIL: the spare length, held by its tie) and out of the coil into the female housing's rear end. Corners
#    are fillets of MC['r_fillet']; the route uses the cable's length (no loose loop), checked in validation motor_joints.
def _polylen(pts):return sum(math.dist(a_,b_) for a_,b_ in zip(pts,pts[1:]))   # (not _pl: a later line rebinds that name)
# Pin spread (B9 fix round 2): the pigtail is drawn as one Ø3 bundle from the pin-row centre, but its six sleeves sit on the header's pins along x, so the outer
# wires are +-spread/2 off that centre line (the bundle runs toward +x: the rear pin's wire is the longest). Taken from board_cad's pad positions.
PIN_SPREAD={r:round(max(q[0] for q in BCONN[r]['pins_xy'])-min(q[0] for q in BCONN[r]['pins_xy']),2) for r in ('J4','J5')}
assert all(abs(PIN_SPREAD[r]-2.54*(len(BCONN[r]['pins_xy'])-1))<.01 and len({round(q[1],3) for q in BCONN[r]['pins_xy']})==1 for r in PIN_SPREAD) and len(set(PIN_SPREAD.values()))==1,PIN_SPREAD
PG=dict(r_wire=.5,r_run=1.5,r_fillet=4.5,od=1.0,run_y=30.5,step_y=33.0,run_z=49.3,pin_spread_mm=PIN_SPREAD['J4'],
        term=dict(solder_overlap_on_tail=RA_SOCKET['solder_overlap'],inside_sleeve_past_tail=RA_SOCKET['sleeve_past_tail'],inside_male_housing=4.0),
        wire='six 28 AWG silicone wires (Ø1.0 mm), colour-coded red, black, green, blue, yellow, white = pins 1-6 (pins 1-2, the motor pair: 26 AWG thin-wall PTFE / ETFE, OD <= 1.0 mm, preferred if available)')
MC=dict(r=2.0,r_face=1.0,r_fillet=4.5,y_top=52.6,z_top=54.8,length=200.0)   # r_face: the leads' flat row against the motor face (B3: 6 x 2 mm)
MC_R=MC['r']
def fillet_path(pts,R,step=30.):
    """A polyline with each interior corner replaced by a circular arc tangent to both legs (points every `step` deg). The arc radius is R, or
    the largest that fits when a leg is short (each interior leg is shared by two corners: half of it is available to each). Returns (points,
    [radius used at each corner])."""
    P=[np.array(p,float) for p in pts];out=[P[0]];radii=[]
    for k in range(1,len(P)-1):
        a=P[k]-P[k-1];b=P[k+1]-P[k];la,lb=float(np.linalg.norm(a)),float(np.linalg.norm(b));a=a/la;b=b/lb
        c=float(np.clip(a@b,-1,1));th=math.acos(c)
        if th<math.radians(1):out.append(P[k]);continue
        avail=min(la if k==1 else la/2,lb if k==len(P)-2 else lb/2)
        r=min(R,avail/math.tan(th/2));t=r*math.tan(th/2)
        S=P[k]-a*t;n=b-a*c;n=n/np.linalg.norm(n);C=S+n*r
        m=max(2,int(math.ceil(math.degrees(th)/step)))
        out+=[q for q in (C-n*r*math.cos(th*j/m)+a*r*math.sin(th*j/m) for j in range(m+1)) if np.linalg.norm(q-out[-1])>1e-6];radii.append(round(r,3))
    if np.linalg.norm(P[-1]-out[-1])>1e-6:out.append(P[-1])
    return [tuple(round(float(v),3) for v in q) for q in out],radii
def helix(c,r,z0,turns,a0,pitch,cw=True,step=30.):   # points of a flat coil: centre c, radius r, from azimuth a0 (deg) at z0, dropping pitch per turn
    n=int(round(turns*360/step));sgn=-1 if cw else 1
    return [(round(c[0]+r*math.cos(math.radians(a0+sgn*step*k)),3),round(c[1]+r*math.sin(math.radians(a0+sgn*step*k)),3),round(z0-pitch*step*k/360,3)) for k in range(n+1)]
MOTOR_CABLE,PIGTAIL,JOINT,COIL={},{},{},{}
for side,sg,ref,motor in (('left',1,'J4','motor_left'),('right',-1,'J5','motor_right')):
    so=SOCKET[ref];pcx=so['pc_x'];Y=lambda y:round(sg*y,3)
    x2=round(pcx+8.1,3)   # where the wires, turned over toward +x at the run height, reach the run's |y| (left: beside U5A; right: beside J9's plug)
    corners=[(pcx,so['tail_y'],so['top_z']),(pcx,so['tail_y'],PG['run_z']),(x2,Y(PG['run_y']),PG['run_z']),(4.5,Y(PG['run_y']),PG['run_z']),
             (8.0,Y(PG['step_y']),PG['run_z']),(MJ['x'],Y(PG['step_y']),PG['run_z']),(MJ['x'],Y(MJ['y0']),MJ['z'])]
    pts,rad=fillet_path(corners,PG['r_fillet'])
    nl=max(k for k,p in enumerate(pts) if p[0]<=max(q[0] for q in BAY_OUTLINE))+1   # the points over the board ride on it when it is lifted
    PIGTAIL[side]=dict(ref=ref,corners=corners,points=pts,fillet_radii=rad,lift_points=nl,route_exact=round(sum(math.dist(a_,b_) for a_,b_ in zip(pts,pts[1:])),2))
    wire('motor_pigtail_'+side,f'Motor pigtail {side}: {ref} right-angle socket (wires up) to the inline joint\'s male housing (PB25, B9)',pts,PG['r_run'],'signal','C18',
         note=f'{PG["wire"]}: soldered to the tails of the right-angle socket on {ref} (plugged on the bench, stays with the board), leaving upward; they turn over at >= {min(rad):.2f} mm (centreline), '
              f'run beside {"U5A" if sg>0 else "J9"} and between the P03 and the motor face, and end in the male housing at the inline joint.')
    cables[-1]['never_end']=['p03_regulator',motor]   # passed close by, never a termination: the generic wire check keeps WIRE_GAP to them
    # the exit: the socket with its tails and sleeves, the wires' rise and their first turn over (to the end of the first fillet arc)
    k1=next(k for k,p_ in enumerate(pts) if k>1 and abs(p_[2]-pts[k-1][2])<1e-6 and p_[2]>=PG['run_z']-1e-6)
    _ex=cq.Compound.makeCompound([cq.Solid.makeCylinder(PG['r_run'],math.dist(a_,b_),cq.Vector(*a_),(cq.Vector(*b_)-cq.Vector(*a_)).normalized()) for a_,b_ in zip(pts[:k1],pts[1:k1+1]) if math.dist(a_,b_)>.01])
    PIGTAIL[side].update(exit_points=k1+1,exit_to_motor_mm=round(min(_ex.distance(shapes[motor]),shapes[f'bay_plug_{ref}'].distance(shapes[motor])),2))
    _route=cables[-1]['route_mm'];PIGTAIL[side]['route']=_route
    jm=box(MJ['x'],sg*(MJ['y0']+MJ['male_l']/2),MJ['z0'],MJ['t'],MJ['male_l'],MJ['w'])
    jf=box(MJ['x'],sg*(MJ['y0']+MJ['male_l']+MJ['female_l']/2),MJ['z0'],MJ['t'],MJ['female_l'],MJ['w'])
    JOINT[side]=dict(male=jm,female=jf,axis=(0,sg,0),rear_y=sg*(MJ['y0']+MJ['male_l']+MJ['female_l']))
    add(f'motor_joint_{side}',f'Motor inline joint {side}: pigtail male housing + factory female housing (PB25)',cq.Compound.makeCompound([jm,jf]),'connector','C18/E05','lower',check=True,
        note=f'0.1 in 6-way inline joint resting on P_base on edge (the six contacts in a vertical column), axis along {"+" if sg>0 else "-"}y: the pigtail\'s male housing y {sg*MJ["y0"]:g}..{sg*(MJ["y0"]+MJ["male_l"]):g}, the motor cable\'s factory female '
             f'housing to {sg*(MJ["y0"]+MJ["male_l"]+MJ["female_l"]):g}; x {MJ["x"]-MJ["t"]/2:g}..{MJ["x"]+MJ["t"]/2:g}, z {MJ["z0"]:g}..{MJ["z0"]+MJ["w"]:.2f}. Polarity: unkeyed, so pin 1 is marked on both halves (paint-pen stripe at the red wire, '
             f'pigtail and factory housing) and the colours run straight across. Held down by its cable tie (motor_tie_joint_{side}); cut the tie, then unplug the female housing along the axis '
             f'(>= {MJ["unplug"]:g} mm clear, validation motor_joints_serviceable); reachable from above with the Jetson off.')
    # the joint's cable tie: a loop in the plane y = +-tie_y round the female housing, down the motor opening (inner leg) and through a P_base slot (outer leg)
    (ix0,ix1),(ox0,ox1),(tz0,tz1)=MOTOR_TIES['joint'];yt=sg*MJ['tie_y'];zu=TIE['z_under']
    tj=union(box((ix0+ix1)/2,yt,zu,ix1-ix0,TIE['w'],tz1-zu),box((ox0+ox1)/2,yt,zu,ox1-ox0,TIE['w'],tz1-zu),box((ix0+ox1)/2,yt,tz0,ox1-ix0,TIE['w'],tz1-tz0),box((ix0+ox1)/2,yt,zu,ox1-ix0,TIE['w'],TIE['t']),
             box(ox1+TIE['head'][0]/2,yt,TIE['head_z'],TIE['head'][0],TIE['head'][1],TIE['head'][2]))   # + the tie head on the outer leg's outside face
    add(f'motor_tie_joint_{side}',f'Cable tie holding the {side} motor inline joint down (through the motor opening and a P_base slot)',tj,'black','C12','lower',check=True,
        note=f'2.5 mm cable tie (C12) round the joint\'s female housing at y {yt:g}: down the motor opening beside the motor can (x {ix0:.1f}..{ix1:.1f}), under P_base, up through the slot at x {ox0-TIE["slot_clr"]:.1f}..{ox1+TIE["slot_clr"]:.1f}; '
             'pull it snug so the joint sits on the base (retention, B9 carry item 10). Cut and replace it to unplug the joint.')
    # factory cable: exit -> a flat row along the face toward -x -> round the -x shoulder -> forward under the carrier -> up outside its footprint ->
    # over the motor top -> the coil (spare length) -> the female housing's rear end
    ex=tuple(BC['motor_cables'][ref]['exit_xyz']);cx,cy=MCOIL['c'];cyc=sg*cy
    coil=helix((cx,cyc),MCOIL['r'],MCOIL['z_top'],MCOIL['turns'],MCOIL['start_deg'],MCOIL['pitch'],cw=(sg>0))   # the right coil mirrors the left one
    face,rf=fillet_path([ex,(-3.0,Y(34.0),44.0),(-9.0,Y(34.0),45.5)],MC['r_fillet'])   # the leads leave the encoder cap as a flat row along the face
    fc=[(-9.0,Y(34.0),45.5),(-12.8,Y(36.5),47.5),(-12.8,Y(50.5),51.0),(-10.5,Y(MC['y_top']),MC['z_top']),(11.0,Y(MC['y_top']),MC['z_top']),(11.0,Y(58.0),49.5),(11.0,Y(63.0),49.5)]   # down the motor's front shoulder under the bumper lead
    head,rh=fillet_path(fc+[coil[0],coil[1]],MC['r_fillet'])
    tail,rt=fillet_path([coil[-2],coil[-1],(MJ['x'],coil[-1][1],coil[-1][2]+2.0),(MJ['x'],JOINT[side]['rear_y'],MJ['z'])],MC['r_fillet'])
    MOTOR_CABLE[side]=face+head[1:]+coil[2:-2]+tail
    MC_RADII=[MC['r_face']]*(len(face)-1)+[MC['r']]*(len(MOTOR_CABLE[side])-len(face))
    COIL[side]=dict(points=coil,centre=(cx,cyc),r=MCOIL['r'],turns=MCOIL['turns'],fillet_radii=rf+rh+rt,face_points=len(face))
    wire('motor_cable_'+side,f'Factory 200 mm motor/encoder cable {side} (to the inline joint; spare length coiled, PB25 / B9)',MOTOR_CABLE[side],MC_RADII,'signal','E05',
         note=f'The motor\'s permanent 6-wire cable: a flat row along its inner end face toward the rear, round the motor\'s rear shoulder, forward beside it, over the motor top at |y| {MC["y_top"]:g}, {MCOIL["turns"]:g} turns of a Ø{2*MCOIL["r"]:g} mm coil (centreline) on the base at ({cx:g}, {cyc:g}) held by its tie, '
              'then into the inline joint\'s female housing. Not cut, not re-terminated.')
    (ix0,ix1),(ox0,ox1),(tz0,tz1)=MOTOR_TIES['coil']
    tc=union(box((ix0+ix1)/2,cyc,zu,ix1-ix0,TIE['w'],tz1-zu),box((ox0+ox1)/2,cyc,zu,ox1-ox0,TIE['w'],tz1-zu),box((ix0+ox1)/2,cyc,tz0,ox1-ix0,TIE['w'],tz1-tz0),box((ix0+ox1)/2,cyc,zu,ox1-ix0,TIE['w'],TIE['t']),
             box(ox1+TIE['head'][0]/2,cyc,TIE['head_z'],TIE['head'][0],TIE['head'][1],TIE['head'][2]))
    add(f'motor_tie_coil_{side}',f'Cable tie holding the {side} factory-cable coil down (two P_base slots)',tc,'black','C12','lower',check=True,
        note=f'2.5 mm cable tie (C12) over the coil\'s +x side at y {cyc:g}, through two P_base slots (x {ix0-TIE["slot_clr"]:.1f}..{ix1+TIE["slot_clr"]:.1f} and {ox0-TIE["slot_clr"]:.1f}..{ox1+TIE["slot_clr"]:.1f}): the slack store (B9 carry item 3).')
PG['term_mm']=round(sum(PG['term'].values()),2)
# B9 fix round 2 (controller ruling): the pigtail wires are PRE-CUT long, the socket end soldered first, the bundle dressed along its route, then each
# wire trimmed to its own length and crimped. B12a (final review N4): the wires fan out +-spread / 2 off the drawn bundle axis at BOTH ends - the
# socket's six sleeves along the header and the male housing's six cavities - so the pre-cut is route + terminations + the full pin spread (rounded up
# to the mm), and each wire is trimmed at its own cavity: its finished length lies within route + terminations +- the spread.
for s_ in PIGTAIL:
    pg_=PIGTAIL[s_];base_=pg_['route_exact']+PG['term_mm']
    pg_['finished_centre_mm']=round(base_,1)
    pg_['finished_range_mm']=[round(base_-PG['pin_spread_mm'],1),round(base_+PG['pin_spread_mm'],1)]
    pg_['precut_mm']=int(math.ceil(base_+PG['pin_spread_mm']-1e-9));pg_['precut_margin_mm']=round(pg_['precut_mm']-base_,2)
    assert PG['pin_spread_mm']-1e-9<=pg_['precut_margin_mm']<PG['pin_spread_mm']+1.0 and pg_['finished_range_mm'][1]<=pg_['precut_mm'],pg_
    c_=next(c for c in cables if c['id']==f'motor_pigtail_{s_}')
    c_.update(suggested_cut_mm=pg_['precut_mm'],pigtail=dict(part='C18 motor pigtail (B9)',board_end_part=RA_SOCKET['part'],
        joint_end_part='Pololu 1905 1x6 0.1 in crimp housing with six male crimp pins (or a 1x6 straight male header with the wires soldered on)',wire=PG['wire'],
        route_mm=pg_['route_exact'],terminations_mm=PG['term'],pin_spread_mm=PG['pin_spread_mm'],precut_mm=pg_['precut_mm'],precut_margin_mm=pg_['precut_margin_mm'],
        finished_centre_mm=pg_['finished_centre_mm'],finished_range_mm=pg_['finished_range_mm'],trim='at its own cavity of the male housing, after dressing',length_source='crimped',
        length_note=f'pre-cut length {pg_["precut_mm"]} mm per wire = the drawn route {pg_["route_exact"]:g} mm + {PG["term_mm"]:g} mm of terminations ({PG["term"]["solder_overlap_on_tail"]:g} lapped on the tail, {PG["term"]["inside_sleeve_past_tail"]:g} in the sleeve past the tip, '
                    f'{PG["term"]["inside_male_housing"]:g} in the male crimp housing) + the full {PG["pin_spread_mm"]:g} mm pin spread, rounded up to the mm: the six wires fan out {PG["pin_spread_mm"]/2:g} mm either side of the drawn bundle axis at both ends (the socket\'s six sleeves and the male housing\'s six cavities each span {PG["pin_spread_mm"]:g} mm). '
                    f'Build: cut bulk 28 AWG silicone to the pre-cut length, solder the socket end first, dress the bundle along its route, then trim each wire at its own cavity of the male housing (finished length about {pg_["finished_centre_mm"]:g} mm on the bundle axis, '
                    f'{pg_["finished_range_mm"][0]:g}-{pg_["finished_range_mm"][1]:g} mm by where the wire sits at the two ends) and crimp the male pin. '
                    'No slack: the joint is unplugged before the board is lifted (PB25 amended). Tag the pigtail "'+('L / J4' if s_=='left' else 'R / J5')+'" right after making it (the two differ in length and pin-1 order).',
        board_end=f'right-angle socket on {pg_["ref"]} (bench, before the board goes in), wires up',male_end=f'inline joint motor_joint_{s_}'))
# Factory cable: the fixed path (everything outside the coil) + the coil (the measured variable). Pololu's "200 mm" is to be measured to the female
# housing's rear face (the verify list asks); readings FAC_READINGS must all fit the coil's FAC_TURNS.
# B12a (final review N4): a cable longer than the 200 mm reading still fits - the coil takes up to 3.5 turns (FAC_TURNS; MCOIL z_top 49 keeps the 3.5th
# turn on the base top) - up to FAC_MAX_READING.
FAC_READINGS,FAC_TURNS,BASE_TOP=(186.0,200.0),(2.0,3.5),33.0
FAC={}
for s_ in COIL:
    fr_=_polylen(MOTOR_CABLE[s_]);cl_=_polylen(COIL[s_]['points']);fx_=round(fr_-cl_,1);tl_=cl_/MCOIL['turns']
    FAC[s_]=dict(route=fr_,coil_len=cl_,fixed=fx_,turn=tl_,turns_needed=[round((r_-fx_)/tl_,2) for r_ in FAC_READINGS],remainder=[round(r_-fx_,1) for r_ in FAC_READINGS],
                 bottom_z_at_max_turns=round(MCOIL['z_top']-MCOIL['pitch']*FAC_TURNS[1]-MC['r'],2))
    assert FAC_TURNS[0]<=FAC[s_]['turns_needed'][0] and FAC[s_]['turns_needed'][1]<=FAC_TURNS[1] and FAC_READINGS[0]<=fr_<=FAC_READINGS[1] and FAC[s_]['bottom_z_at_max_turns']>=BASE_TOP,FAC[s_]
    m_=next(c for c in cables if c['id']==f'motor_cable_{s_}');m_.update(suggested_cut_mm=int(MC['length']),factory=dict(length_mm=MC['length'],cut=False,coil=dict(centre_mm=list(COIL[s_]['centre']),r_mm=MCOIL['r'],turns=MCOIL['turns']),
        fixed_path_mm=fx_,cable_readings_mm=list(FAC_READINGS),coil_turns_allowed=list(FAC_TURNS),coil_turns_needed=FAC[s_]['turns_needed']),
        notes=f'Factory cable, not cut: measure it from the encoder cap to the female housing\'s rear face (readings of {FAC_READINGS[0]:g}-{FAC_READINGS[1]:g} mm all fit), route the fixed path first (about {fx_:.0f} mm outside the coil), '
              f'wind the remainder ({FAC[s_]["remainder"][0]:.0f}-{FAC[s_]["remainder"][1]:.0f} mm, {FAC_TURNS[0]:g}-{FAC_TURNS[1]:g} turns) into the coil ahead of the motor and tie it (assembly step 4); loosen the coil tie before unplugging the inline joint.')
assert f'{FAC["left"]["fixed"]:.0f}'==f'{FAC["right"]["fixed"]:.0f}' and FAC["left"]["remainder"]==FAC["right"]["remainder"],FAC   # the two sides are mirror images
FAC_MAX_READING=math.floor(FAC['left']['fixed']+FAC_TURNS[1]*FAC['left']['turn'])   # the longest reading the 3.5-turn coil takes
def _fin(s_):
    lo,hi=PIGTAIL[s_]['finished_range_mm'];return f'{lo:g}–{hi:g} mm'
# the assembly order is written before the pigtails and the factory cable are routed, so its numbers are tokens, resolved here (manifest notes already made included)
ASSY_TOKENS={'@@PRECUT_J4@@':str(PIGTAIL['left']['precut_mm']),'@@PRECUT_J5@@':str(PIGTAIL['right']['precut_mm']),'@@SPREAD@@':f'{PG["pin_spread_mm"]:g}','@@HALF@@':f'{PG["pin_spread_mm"]/2:g}',
    '@@FIN_J4@@':_fin('left'),'@@FIN_J5@@':_fin('right'),'@@R_LO@@':f'{FAC_READINGS[0]:g}','@@R_HI@@':f'{FAC_READINGS[1]:g}','@@FIXED@@':f'{FAC["left"]["fixed"]:.0f}',
    '@@REM_LO@@':f'{FAC["left"]["remainder"][0]:.0f}','@@REM_HI@@':f'{FAC["left"]["remainder"][1]:.0f}','@@R_MAX@@':f'{FAC_MAX_READING:g}'}
def assy_resolve(t):
    for k_,v_ in ASSY_TOKENS.items():t=t.replace(k_,v_)
    return t
ASSY_ORDER=assy_resolve(ASSY_ORDER)
for p_ in parts:p_['note']=assy_resolve(p_['note'])
assert '@@' not in ASSY_ORDER and not any('@@' in p_['note'] for p_ in parts),'unresolved assembly-order token'
# P03 drawn as the real board (LIO-169): the listing's generic "5A buck, 4-38 V to 1.25-36 V, LED display" module is the HW-316E V4.0
# (XL4015, blue PCB, silk "HW-316E V4.0."; layout from the DIYmore photo set of the same board, scaled to the 62 mm length, about ±1 mm).
# Board frame: u along the long side from the IN end (0..62), v from the top edge (input / output caps, trimpot; 0..37) to the display
# edge, z up from the PCB underside. Turned into the robot as a rotation (not a mirror): the IN end at +y (the robot's left: the end
# nearer U5A / U5B), the top edge forward (x 47), the display and buttons aft. The board stands on the measured 1 mm foam tape; every
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
