liorknafo/home-robot/home-robot-r1/pcb/gen_power_zones.py

"""Generates board_spec's copper data (bay B4 and its fix 1): POWER_ZONES, GND_PATCHES and STITCH_VIAS, written into the block between the
BEGIN / END markers of pcb/board_spec.py. Each polygon is a union of rectangular lanes less cuts: octagon notches (with a slot to the lane's
edge) round other nets' pads and the LP12 / stitching GND vias, so the polygon keeps >= 0.4 mm off those pads and >= 0.8 mm off the vias'
centres without holes. Notch centres come from board_spec (pad_uv, SMD_GND_VIAS), so a placement nudge moves them.

Run with KiCad's Python (SHAPE_POLY_SET booleans):
    $KPY pcb/gen_power_zones.py            rewrite the block in board_spec.py
    $KPY pcb/gen_power_zones.py --check    exit 1 if the block is stale (ktest_pcb.test_power_zones_are_generated)"""
import math, sys
from pathlib import Path
import pcbnew
sys.path.insert(0, str(Path(__file__).resolve().parents[1]))
from pcb import board_spec as B, build_pcb as BP

SPEC = Path(B.__file__)
BEGIN, END = '# --- BEGIN generated by gen_power_zones.py (do not edit by hand) ---', '# --- END generated by gen_power_zones.py ---'
MM, TOMM = pcbnew.FromMM, pcbnew.ToMM
PAD = 1.7 / 2 + BP.ZONE_CLEARANCE + 0.05   # octagon (edges r from the centre) round a 1.7 mm socket / header pad: 0.85 + 0.4 clearance + 0.05
VIA = B.SMD_PAD_VIA[0] / 2 + 0.5   # octagon round an LP12 GND via (0.4 radius + 0.5)
SPOKE_POWER = 1.5    # mm, BAT+ / F1_OUT / VBAT_SW F.Cu relief spokes (PB12, B6: J1.1 / J2.1 / J2.2 carry 7.5 A; R13 >= 1.2, <= 2.0)


def rect(u0, v0, u1, v1):
    p = pcbnew.SHAPE_POLY_SET(); p.NewOutline()
    for u, v in ((u0, v0), (u1, v0), (u1, v1), (u0, v1)): p.Append(MM(u), MM(v))
    return p


def octa(c, r):
    p = pcbnew.SHAPE_POLY_SET(); p.NewOutline(); R = r / math.cos(math.pi / 8)
    for k in range(8): p.Append(MM(c[0] + R * math.cos(math.pi / 8 + k * math.pi / 4)), MM(c[1] + R * math.sin(math.pi / 8 + k * math.pi / 4)))
    return p


def notch(c, side, edge, r=VIA):
    """An octagon round c plus a slot of its width out to the coordinate `edge` (side W / E: a u value, N / S: a v value)."""
    u, v = c
    n = octa(c, r)
    n.BooleanAdd({'W': rect(edge, v - r, u, v + r), 'E': rect(u, v - r, edge, v + r),
                  'N': rect(u - r, edge, u + r, v), 'S': rect(u - r, v, u + r, edge)}[side])
    return n


def circ(c, r, n=48):
    """An n-gon whose edges touch the circle of radius r round c from outside (keeps the whole circle out of the polygon)."""
    p = pcbnew.SHAPE_POLY_SET(); p.NewOutline(); R = r / math.cos(math.pi / n)
    for k in range(n): p.Append(MM(c[0] + R * math.cos(math.pi / n + 2 * math.pi * k / n)), MM(c[1] + R * math.sin(math.pi / n + 2 * math.pi * k / n)))
    return p


def cnotch(c, side, edge, r):
    """notch() with a near-exact circle (circ) instead of the octagon: for the pads at a corridor's binding neck."""
    u, v = c
    n = circ(c, r)
    n.BooleanAdd({'W': rect(edge, v - r, u, v + r), 'E': rect(u, v - r, edge, v + r),
                  'N': rect(u - r, edge, u + r, v), 'S': rect(u - r, v, u + r, edge)}[side])
    return n


CLEAR = BP.ZONE_CLEARANCE + 0.005   # mm: polygon to another net's pad at a binding neck (0.4 zone clearance + round-off)


def build(rects, cuts=()):
    s = pcbnew.SHAPE_POLY_SET()
    for r in rects: s.BooleanAdd(rect(*r))
    for c in cuts: s.BooleanSubtract(c)
    s.Simplify()
    assert s.OutlineCount() == 1 and s.HoleCount(0) == 0, (s.OutlineCount(), s.HoleCount(0) if s.OutlineCount() else None)
    o = s.Outline(0)
    pts = [(round(TOMM(o.CPoint(i).x), 2), round(TOMM(o.CPoint(i).y), 2)) for i in range(o.PointCount())]
    out = []
    for i, p in enumerate(pts):                                   # drop repeated and collinear points
        a, c = pts[i - 1], pts[(i + 1) % len(pts)]
        if p != a and abs((p[0] - a[0]) * (c[1] - a[1]) - (p[1] - a[1]) * (c[0] - a[0])) > 1e-6: out.append(p)
    return out


def pad(ref, pin): return B.pad_uv(ref, pin)
def gv(ref): return B.SMD_GND_VIAS[ref]


VBAT_LANES = [(2.6, 52.9, 6.1, 59.36), (0.6, 53.4, 2.6, 59.36),    # LIO-236: west of J2.2 too (its W spoke; from v 53.4, no R4 speck)
               (4.5, 50.6, 27.85, 57.15), (10.2, 49.2, 19.5, 50.6), (6.1, 57.15, 21.69, 62.1), (27.6, 55.9, 31.0, 58.5),
              (27.85, 36.0, 33.45, 55.9), (27.85, 36.0, 38.6, 41.0), (32.45, 24.0, 38.6, 41.0), (32.45, 24.0, 66.6, 31.2),
              (41.4, 24.0, 66.6, 33.3), (52.6, 24.0, 66.6, 33.9), (66.6, 26.1, 71.2, 33.9),
              (21.69, 57.15, 27.6, 58.3)]      # bay B5: down to F1.2's north pads' clearance circles (the U1B.20 - F1.2 neck, 4.94 mm)


def zones():
    """[(entry dict without 'poly', lanes, cuts)] in POWER_ZONES order."""
    global VBAT_CUTS
    # bay B5: with DRV_L 0.7 mm further +u the F.Cu trunk's binding neck is between U1B.20 and F1.2's north pads (centres 7.69 mm apart):
    # near-exact circles there (cnotch / circ, CLEAR) instead of the octagon and the straight cuts, so F.Cu alone keeps >= 4.84 mm (7.5 A)
    VBAT_CUTS = [notch(pad('U1A', '20'), 'N', 47.0, PAD), cnotch(pad('U1B', '20'), 'N', 47.0, 0.85 + CLEAR), rect(4.0, 47.0, 7.6, 52.3),
                 rect(19.5, 47.0, 24.5, 51.6), rect(24.5, 47.0, 27.85, 51.6), cnotch(pad('U2', '8'), 'N', 30.0, 0.85 + CLEAR),
                 notch(pad('U3L', '1'), 'S', 44.0, PAD),
                 rect(39.05, 28.95, 41.55, 34.1),               # PB16: C3's GND pad and its LP12 via
                 rect(10.0, 47.0, 15.2, 50.7)                   # LIO-226: R26 (ARM pull-up) under Q5, its pads + 0.35 mm (the router keepout
                                                                # grows 0.3): the strip down to J2.2 / F2.1's relief rings keeps >= 4.84 mm
                 ] + [circ(p, 1.1 + CLEAR) for p in pad_all('F1', '2') if p[1] < 60]    # bay B5: F1.2's north pads (fix 1: restored)
    f21 = pcbnew.SHAPE_POLY_SET()                                 # F2.1's 2 x 2 VBAT_SW pads, for F1_OUT on B.Cu
    for p in (pad_all('F2', '1')): f21.BooleanAdd(octa(p, 1.55))
    us, vs = sorted({p[0] for p in pad_all('F2', '1')}), sorted({p[1] for p in pad_all('F2', '1')})
    f21.BooleanAdd(rect(us[0], vs[0], us[-1], vs[-1])); f21.BooleanAdd(rect(us[0] - 1.55, vs[0], us[-1] + 1.55, 64.5))
    return [
        # VBAT_SW, F.Cu trunk (and In2.Cu below): J2.2, round F2.1, the strip over F2 / F1 (to v 49.2 under the Pico, clear of TP2 and R13), the channel
        # between U1B and U3P, past U3P.7 and U2.8, the column beside the IMU, east under J4's pins to U5A.1.
        # Bay B6: 1.5 mm spokes (SPOKE_POWER), so J2.2's four F.Cu spokes carry its 7.5 A alone (8.8 A; with 1.2 mm 7.46 A).
        # LIO-236: also west of J2.2 (from v 53.4), so its W spoke leads on north (its ring cut: 6.41 -> 8.3 A against 7.5 A).
        (dict(net='VBAT_SW', layers=('F.Cu',), spoke=SPOKE_POWER), VBAT_LANES, VBAT_CUTS),
        # VBAT_SW, In2.Cu helper (bay B5): round J2.2 only. B6: it holds no via and no other VBAT_SW pin, so it is a dead end - its In2
        # spokes carry nothing (zone_check.pin_path_capacity); it stays as heat spreading and as the router keep-out it has always been
        # (F2.1's fourteen F.Cu spokes carry its 5 A alone). With DRV_L 0.7 mm further +u the F.Cu trunk alone is >= 4.84 mm (7.5 A),
        # so In2 stays free under the channel, the column beside the IMU and the arm to U5A (the Pico -> driver crossings) and south of
        # the Pico (the PowerTap taps in the Pico pocket, R22 / TP2, leave it on In2: a 0.8 mm track cannot pass between 2.54 mm header
        # pins).
        (dict(net='VBAT_SW', layers=('In2.Cu',), trunk=False), [(2.6, 52.9, 8.0, 59.36)], VBAT_CUTS),
        # VMOT, F.Cu trunk: the spine west of the driver rows, the bar over U3P.1, the bar by U4L.7 (DRV_R's VIN until PB15; it still feeds
        # R23), the bar west through C1.1 to K1's NO pin, and (PB15, DRV_R turned) a 4 mm lane across the gap to U4P.1. LIO-232: 1.5 mm
        # spokes here and in the In2 helper (K1.3, the relay's NO pin, has two of each: 5.1 -> 6.0 A against its 5 A).
        (dict(net='VMOT', layers=('F.Cu',), spoke=SPOKE_POWER),
         [(28.0, 59.0, 32.75, 86.3), (31.5, 56.4, 37.7, 63.0), (32.75, 81.5, 36.0, 86.3), (12.6, 80.75, 28.0, 88.9),     # B12a: bar 0.4 mm off J3's pads
          (37.7, 59.0, 48.0, 63.0), (44.9, 63.0, 48.5, 67.9),       # PB15: F.Cu lane across the gap to U4P.1 (DRV_R turned)
          (36.0, 41.4, 42.3, 59.0), (39.3, 38.6, 46.5, 43.0), (46.5, 39.4, 48.3, 43.0), (39.0, 35.0, 42.5, 38.6)], []),     # PB16: up DRV_L's interior and along its north end to U3P.1 and C3.1
        # VMOT, In2 helper (PB15): the spine and the bars, less the bar over U3P.1 - In2 stays free from the strip west of DRV_L down into
        # the gap, the Pico links' way to DRV_R's logic row (U4L, now on the west).
        (dict(net='VMOT', layers=('In2.Cu',), trunk=False, spoke=SPOKE_POWER),
         [(28.0, 59.0, 32.75, 86.3), (32.75, 81.5, 36.0, 86.3), (12.6, 80.75, 28.0, 88.9)], []),
        # 5V, B.Cu trunk: U5B.1, north between J4.6 and U5B.2 (the box keeps off U5B.2's south-east spoke), west north of J4's pins, south
        # through DRV_L, through the gap between the drivers, through DRV_R, out between U4P.1 and U4L.1, west to J3.1, with room for
        # U4P.2's GND stitching via. The column north of DRV_L starts at u 42.0; the exit lane south of DRV_R is 3.3 mm tall east of u 33.25
        # (PB13: LED3's GND via below it).
        # LIO-236: U5B.1's box and the strip west of it reach v 44.5 (its S spoke had a 0.5 mm strip), and a block north-west of J3.1
        # (u 22.3 - 24.0 from v 86.0, under C1.1's clearance) takes its N and W spokes: both ring cuts +28 % or more.
        (dict(net='5V', layers=('B.Cu',)),
         [(62.2, 37.4, 66.8, 44.5), (66.8, 38.2, 71.0, 44.5), (62.2, 25.5, 66.8, 37.4), (41.5, 25.5, 66.8, 31.5), (42.0, 31.5, 45.4, 41.0), (39.0, 33.0, 42.0, 41.0),
          (37.5, 41.0, 46.1, 58.5), (35.25, 68.3, 38.6, 70.8),    # PB17: an ear over U4L.2's east side (no one-spoke B.Cu thermal)
          (38.6, 56.7, 46.1, 61.1), (38.6, 61.1, 42.35, 83.6), (37.9, 78.0, 42.35, 83.6),
          (33.25, 83.6, 41.1, 86.9), (24.0, 83.6, 33.25, 88.6), (22.3, 88.6, 28.9, 92.8), (22.3, 86.0, 24.0, 88.6)],
         # PB14 / PB16: DRV_L's strip u 37.5-46.1 (DRV_L turned; U3P.2's patch stitching via in a notch with its slot toward U3P.2, so
         # the B.Cu GND fill gives U3P.2 no one-spoke thermal; 2 mm left west of it for U3L.2's B.Cu spokes), a bar across the gap's
         # north end, then one 3.75 mm strip (u 38.6-42.35) through the gap and DRV_R; the B.Cu west of it is left to the Pico links.
         [notch((43.4, 44.25), 'E', 46.6)]),
        # 5V, In2 helper round U5B.1 for the J4 / J5 / J15 taps.
        (dict(net='5V', layers=('In2.Cu',), trunk=False), [(66.15, 38.0, 69.6, 62.5)], []),     # B5: clear of J15 (moved 3.1 mm +u)
        # BAT+, B.Cu trunk: J1.2 (PB20: J1's north pin; its block sits where the old battery GND pocket was, 0.5 mm off F1_OUT's),
        # between J1 and F2, south of F2, the F2 / F1 gap, south of F1.1 (round C1.2) and east of F1 in the channel. PB20: nothing west of u 6.1 south of
        # J1.2 - that strip is the GND pin's (J1.1) way into the main B.Cu GND fill; the block's north-west corner is cut back (no eroded
        # speck under R4's 3 mm erosion).
        # LIO-236: down to v 70.6 under J1.2 (its S spoke had a 0.2 mm strip; the mouth east of its relief 4.4 mm), north edge left
        # at v 63.5 / 64.0 for that mouth (F1_OUT takes no strip south of J2.1); stepped to v 64.4 east of u 7.5 for J2.1's stitching vias.
        (dict(net='BAT+', layers=('B.Cu',), spoke=SPOKE_POWER),
         [(6.1, 64.0, 7.5, 80.0), (7.5, 64.4, 11.98, 80.0), (2.0, 63.5, 6.1, 70.6), (0.6, 65.0, 2.0, 70.6), (11.98, 71.6, 21.15, 80.0), (17.5, 66.2, 27.3, 77.9),
          (24.0, 77.9, 32.75, 80.0), (27.3, 64.1, 32.75, 80.0)], []),
        # BAT+, In2 copy (fix 1, ruling PB11): dropped by PB20 - with J1's pins swapped BAT+'s B.Cu trunk alone carries 8.6 A at its true
        # narrowest and J1.2's four B.Cu spokes 8.8 A, while the copy could reach J1.2 with one relief spoke only (KiCad: starved thermal):
        # its north side is the F1_OUT copy's, its south J1.1's antipad. In2 in the band is left to the router.
        # F1_OUT, B.Cu trunk: J2.1, north between J2.2 and F2.1, over F2 (to v 48.9 under the Pico), F1.2 and east of F1 in the channel.
        # LIO-236: also round J2.2 (west and north), which makes J2.1's west pocket live, and to v 63.9 east of u 8.0 under the F.Cu
        # helper's stitching vias.
        (dict(net='F1_OUT', layers=('B.Cu',), spoke=SPOKE_POWER),
         [(0.6, 58.95, 6.15, 63.0), (6.15, 50.5, 11.95, 63.0), (8.0, 63.0, 11.95, 63.9), (10.1, 48.9, 25.3, 56.5), (25.3, 53.9, 32.75, 56.5), (17.5, 55.0, 32.75, 63.6),
          (0.6, 53.4, 6.15, 58.95),     # LIO-236: round J2.2 (the fill keeps its clearance; a notch would leave a hole), so J2.1's west pocket is
                                        # live; from v 53.4, so no corner past J2.2 survives R4's erosion as a second piece
          (32.75, 53.9, 33.45, 58.0)],      # bay B5: up to U3P's pins (0.7 mm further +u), so no B.Cu GND sliver gives U3P.2 one spoke;
                                            # top at v 53.9 in the channel: L_M1 leaves U3P.3 westward on B.Cu
         [notch(pad('U1A', '20'), 'N', 47.0, PAD), notch(pad('U1B', '20'), 'N', 47.0, PAD), f21]),
        # F1_OUT, F.Cu helper (LIO-236): west and south of J2.1, where F.Cu is free (VBAT_SW holds its north and east sides), and a
        # strip east between VBAT_SW and F2_OUT to three stitching vias into the B.Cu trunk (STITCH): J2.1's W and S F.Cu spokes.
        (dict(net='F1_OUT', layers=('F.Cu',), trunk=False, spoke=SPOKE_POWER), [(0.6, 59.86, 5.6, 65.6), (5.6, 62.6, 11.9, 64.1)], []),
        # F1_OUT, In2 copy (fix 1, ruling PB11): J2.1, down between J1 and F2, under F2, up the F2 / F1 gap to F1.2's south-west pad;
        # stitched to the B.Cu trunk beside J2.1 and at F1.2.
        (dict(net='F1_OUT', layers=('In2.Cu',), trunk=False, spoke=SPOKE_POWER),
         [(0.6, 59.86, 5.6, 65.86), (0.6, 62.6, 6.1, 65.86), (5.6, 59.86, 11.98, 62.6), (6.1, 62.6, 11.98, 75.0), (6.1, 71.6, 21.69, 75.0), (17.48, 62.6, 21.69, 75.0),
          (17.48, 62.6, 22.99, 65.0), (20.5, 60.6, 22.99, 62.6)], []),
        # F2_OUT, F.Cu trunk: F2.2 (copper west of F2 and in the F2 / F1 gap), south between J1 and K1 to K1's COM pin; kept east of u 7.6
        # beside J1 and of u 6.3 south of it for the battery GND patch (PB20: J1.1's). LIO-232: east of u 7.6 to v 79 and of u 7.3 to v 86.5
        # (4.5 / 4.8 mm: the trunk's narrowest is now 4.5 mm, 7.1 A against 5 A), so the patch is 1 mm wider past J1.1's south side and K1.4.
        # LIO-236: 1.5 mm spokes (K1.1 has N, E and a W spoke into a 0.6 mm strip: 3.0 mm of copper at 1.2 mm, 5.30 A).
        (dict(net='F2_OUT', layers=('F.Cu',), spoke=SPOKE_POWER),
         [(7.6, 64.6, 21.6, 76.0), (7.6, 74.5, 12.1, 79.0), (7.3, 79.0, 12.1, 86.5), (6.3, 86.5, 12.1, 98.2)], []),
        # 3V3, In2 pour (bay B5: a strip, not the whole Pico pocket): under the pull-up column (u 14.91 pads, via down) and a link over to
        # the Pico's 3V3 pin (U1B.5); the rest of In2 under the Pico is left to the signals that cross from U1A to U1B's pin gaps.
        (dict(net='3V3', layers=('In2.Cu',), trunk=False),
         [(13.4, 1.0, 16.6, 34.0), (16.6, 11.62, 27.3, 14.2)], []),
    ]


def pad_all(ref, pin):
    """Board (u, v) of every pad numbered `pin` of `ref` (a fuse contact has four), from the footprint file."""
    from pcb.sexpr import parse, find
    lib, name = B.PARTS[ref]['fp'].split(':')
    base = B.CUSTOM_FP_DIR if lib == 'R1' else B.tools.FOOTPRINT_DIR / f'{lib}.pretty'
    out = []
    for p in find(parse((base / f'{name}.kicad_mod').read_text(encoding='utf-8'))[0], 'pad'):
        if str(p[1]) == pin:
            at = find(p, 'at')[0]
            out.append(tuple(round(x, 4) for x in B.local_to_board(B.PLACEMENT[ref], (float(at[1]), float(at[2])))))
    return out


def gnd_patches():
    """F.Cu GND patches (ruling PB12), one per board_spec.GND_PATCH_PINS pin: round the battery GND pin and west of U3P.2. PB20: the
    battery GND pin is J1.1 (J1's south pin); its patch runs from J1.2's side down the west edge, 0.5 mm off F2_OUT, past K1.4 (no net)
    to K1.5 (GND), with the stitching vias south of K1.4 (STITCH). U3P.2's patch (PB16, DRV_L turned) lies between the VMOT bar (0.65 mm
    north) and U3P.3's Motor clearance (south); ruling PB21 (B6 fix 2) draws it to the pad's centre - it used to end at u 46.5, 0.05 mm
    short of the pad, so KiCad drew it no spoke - and U3P.2 takes 90 degree spokes (board_spec.PAD_SPOKE_ANGLE): the west one lands in
    the patch, the only free side (one spoke per outer layer: board_spec.DRC_RULES). LIO-232: J1.1's patch reaches u 7.1 down to v 78.5
    and u 6.8 down to v 86 (F2_OUT east of u 7.6 / 7.3 there): K1.4's clearance circle had left it 1.6 mm of copper and the step at
    v 74 0.6 mm beside J1.1's south spoke, the F.Cu necks of the battery pin's ring cut."""
    return [build([(0.6, 69.4, 7.1, 78.5), (0.6, 78.5, 6.8, 86.0), (0.6, 86.0, 5.8, 98.0)]),
            build([(42.7, 43.65, pad('U3P', '2')[0], 45.2)])]
    # bay B5: U4P.2's patch is gone - R_M1 leaves U4P.3 across that corner; U4P.2 keeps 2 In1 + 2 B.Cu spokes (5.87 A >= 2.1)


# Stitching vias (ruling PB11 / PB12): GND - the battery GND patch (PB20: J1.1's, down the west edge: six vias south of K1.4, >= 0.5 mm
# of copper off K1.4 / K1.5; BAT+ has no In2 copy since PB20), U3P.2's patch (two vias in the 5V B.Cu notch's slot toward U3P.2, whose
# GND island U3P.2's west B.Cu spoke reaches; PB21 / B6 fix 2 added (45.6, 44.25): 1.80 mm off U3P.2's centre, clear of its relief ring,
# >= 0.9 mm inside the notch, 1.25 mm off the VMOT bar, 0.68 mm off DRV_FAULT's In2 track), the B.Cu GND fill round
# J3.2 / C1.2 / K1; F1_OUT - its In2 copy to its B.Cu trunk at both ends. PB20 dropped the BAT+ vias with BAT+'s In2 copy (at (2.0, 74.3)
# and F1.1) and J1.2's old GND pocket vias (1.4, 67.0 / 68.6), now under the BAT+ block. Bay B6: U4P.2's old pocket via
# (37.0, 82.7) is gone - DRV_R's turn (PB15) moved U4P.2 to u 46.7 and left the via alone in a 34 mm2 B.Cu island that joined nothing
# (ktest_pcb test_stitch_vias, carry item 8: a stitching via must tie live copper on >= 2 layers).
# LIO-236: F1_OUT's F.Cu helper round J2.1 to its B.Cu trunk, three vias in the strip between VBAT_SW and F2_OUT (u 8.5 - 11.5).
STITCH = [('F1_OUT', (1.6, 60.4)), ('F1_OUT', (19.0, 63.2)), ('F1_OUT', (20.6, 63.2)),
          ('F1_OUT', (8.5, 63.25)), ('F1_OUT', (10.0, 63.25)), ('F1_OUT', (11.5, 63.25)),       # LIO-236: J2.1's F.Cu helper to the B.Cu trunk
          ('GND', (1.2, 84.7)), ('GND', (4.6, 84.7)), ('GND', (1.2, 86.9)), ('GND', (4.6, 86.9)), ('GND', (1.2, 89.1)), ('GND', (4.6, 89.1)),
          ('GND', (43.4, 44.25)), ('GND', (45.6, 44.25)), ('GND', (18.6, 94.0)), ('GND', (18.8, 96.6))]


def fmt_pts(pts, indent):
    lines, cur = [], indent + 'poly=['
    for k, (u, v) in enumerate(pts):
        item = f'({u:g}, {v:g})' + (', ' if k < len(pts) - 1 else ']')
        if len(cur) + len(item) > 138: lines.append(cur.rstrip()); cur = indent + '      '
        cur += item
    lines.append(cur)
    return '\n'.join(lines)


def block():
    out = [BEGIN, 'POWER_ZONES = [']
    for entry, lanes, cuts in zones():
        head = ', '.join(f'{k}={v!r}' for k, v in entry.items())
        out.append(f'    dict({head},\n{fmt_pts(build(lanes, cuts), "         ")}),')
    out.append(']')
    out.append('GND_PATCHES = [')
    for pts in gnd_patches(): out.append(fmt_pts(pts, '    ').replace('    poly=', '    ', 1) + ',')
    out.append(']')
    items = [f'({n!r}, ({u:g}, {v:g}))' for n, (u, v) in STITCH]
    lines, cur = [], 'STITCH_VIAS = ['
    for k, it in enumerate(items):
        it += ', ' if k < len(items) - 1 else ']'
        if len(cur) + len(it) > 138: lines.append(cur.rstrip()); cur = '               '
        cur += it
    out.append('\n'.join(lines + [cur]))
    out.append(END)
    return '\n'.join(out)


def main():
    text = SPEC.read_text(encoding='utf-8')
    i, j = text.index(BEGIN), text.index(END) + len(END)
    new = text[:i] + block() + text[j:]
    if '--check' in sys.argv:
        if new != text:
            print('board_spec.py POWER_ZONES / GND_PATCHES / STITCH_VIAS are stale: run  $KPY pcb/gen_power_zones.py'); return 1
        print('board_spec.py generated block is current'); return 0
    SPEC.write_bytes(new.encode()); print('wrote', SPEC.name)
    return 0


if __name__ == '__main__':
    sys.exit(main())
