liorknafo/home-robot/(commit log)

2026-10-09 R1 home robot: hardware and simulator
    home-robot-r1/: parametric CAD (CadQuery), printable parts, the 74 x 100 mm
    4-layer power & I/O board (KiCad, generated and auto-routed), JLCPCB fab
    package, harness and BOM, bring-up guide.
    home-robot-sim/: Unreal Engine 5.8 simulator and the Python autonomy
    controller (LiDAR mapping, camera low-obstacle detection, exploration).
    Manufacturer 3D models and the meshes generated from them are fetched,
    not committed (tools/fetch_reference_models.sh).
2026-10-10 Sync: simulator IMU and odometry error model (bay B11)
    Seeded MPU-6050 error model in a sim-only layer, robot-side gyro bias and
    accelerometer level calibration, tests, BRINGUP IMU calibration section.
2026-10-10 Sync: IMU calibration fixes (bay B11 fix 1)
    DLPF_CFG 4 / 20 Hz sampling requirement, time-based settling skip, in-spec
    offset bounds, scenario clock after IMU start-up calibration.
2026-10-11 Sync: bay B12a connectors, B12b sim cleanups, task G bumper recovery
    R1 from power-io-board 8bd8195:
    - Battery, rocker and Jetson connectors that can't be swapped (J1 XT30, J2 VH, J3 Micro-Fit):
    board re-placed and re-routed, power check, fab files, CAD and harness updated.
    - Final-review guide fixes (BRINGUP, ORDERING, pigtail lengths) and test cleanups.
    Simulator from main 94d346d:
    - Statistical scenario checks, IMU minors, C++/comment minors (B12b).
    - Contact recovery with no straight trail behind the robot: re-planned back-off, slow creep
    over driven ground, then a 60 s cap and a stop message (task G).
    - 2D house harness (tests/house2d), mapping analysis and the Unreal contact repla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
2026-10-12 Sync: camera in the bumper, LD14 turned round at x 54, closed lid, contact and mapping fixes
    R1 from power-io-board 60c57a7:
    - Camera fixed to the chassis at 80 mm behind a 44.5 x 27.2 mm bumper window (LIO-86).
    - LD14P turned 180 deg (motor to the back) with its spin axis at x 54 mm; the pressed bumper
    stays outside its 0.1 m minimum range. User-approved COM limits: nominal <= -12, worst <= -10 mm (LIO-87).
    - The lid's open front notch is closed, with a 1.5 mm seam pocket under the lid; cooling model
    counts the LD14 overhang and the exhaust ring. Robot 2.444 kg, COM -16.0 / worst -13.5 mm (LIO-113).
    Simulator from main 1d86f30:
    - New camera and LiDAR positions synced; bedroom-edges fix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
2026-10-12 Sync: mapping keeps close-range obstacles against far beams, close look at pockets (LIO-118)
    Simulator from main 9e7c95e:
    - An obstacle cell confirmed from within 10 cm is not cleared by a later far beam passing under
    it, for up to 600 s or until it is re-crossed from close by (the sofa ends, the dining table).
    - Before reporting the map incomplete, the robot looks at a pocket's opening from close by.
    - sim2d ledge_sofa scenario and an Unreal LiDAR replay tool.
    Unreal full mapping, errors on: complete at 886 s and 947 s on the final code (was 1380-1500 s).
    Gates: SIM unit 239 OK; scenarios_round errors on and off rc 0; goto_wall rc 0.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
2026-10-12 Sync: LiDAR 20 mm lower on a flat tray (LIO-120), camera finds overhangs in the LiDAR's blind band (LIO-121)
    R1 main 725a910, SIM main 064cf1d.
2026-10-13 Sync: LiDAR 20 mm lower (final tray), camera overhang detection, camera LED, GI, contact recovery, overhang and completion fixes (LIO-120, 121, 133-137, 153)
    R1 main f53a454, SIM main b0da0a5. Controller re-check on b0da0a5: unit 304 OK; scenarios_round errors on 94/0 and
    errors off 94/0 (rc 0); goto_wall 16/16. R1 pure 171 OK; CAD summary all true (friction_lock false is good);
    printability 40/40. Replaces the unchecked 917a53c (its LiDAR tray had the 4.8 mm grille slots).
2026-10-13 Sync: robot model page works from a phone, and build_robot.py --step-only (LIO-170)
    The review template links the LiDAR review relatively (../lidar-review.html).
    cad/build_robot.py --step-only writes only cad/home-robot-r1.step (about 1 min),
    so the page's STEP download works without a 33-minute full build.
2026-10-13 Sync: R1 tests pass on a fresh copy; parts links checked (LIO-173)
    Tests that need a file this copy leaves out (cad/assembly-meshes.json,
    design-review.html, pcb/tools/freerouting.jar) now skip and name the command
    that makes it: 179 tests, OK, 12 skipped. The parts list links C18, C19, C20
    and E19 to confirmed product pages or the datasheet; the review builder shows
    any other source as plain text.
2026-10-13 Sync: a test fails when the robot review page falls behind its data (LIO-173)
    cad/rebuild_review.py --out FILE builds the page elsewhere; test_review_page
    compares that build with the committed design-review.html byte for byte. It
    skips in this copy, which leaves the page out: 180 tests, OK, 13 skipped.
2026-10-13 Sync: the P03 5 V converter drawn as the real HW-316E board; its cable tie moved clear of the terminals (LIO-169)
    The P03 renders as the HW-316E XL4015 board (display, toroid, heatsink,
    trimpot, screw terminals) inside its measured 62 x 38 x 14 mm envelope, which
    the checks still use. Its leads are now 46 mm (in) and 70 mm (out). The P_base
    tie slots move to x 39.5, so the tie crosses the two capacitor tops instead of
    pressing on the terminal wires. Printability 40/40, 0 clashes.
    Tests on this copy: 181, OK, 14 skipped.
2026-10-17 Run the simulator on Windows; live YOLO26 segmentation; Jetson TensorRT path
    Windows support (home-robot-sim):
    - Scripts/*.cmd twins of the macOS .command scripts; launch.cmd starts the
    simulator plus, minimized, the autonomy service and object detection.
    Every launcher stops its own earlier runs first (_stop-previous.ps1;
    the simulator is asked to quit over UDP before being forced).
    - Unreal 5.8 is found through the Epic launcher's install record on any
    drive (_ue.cmd) or UE_ROOT; Python runs in UTF-8 mode (_venv.cmd).
    - autonomy_service / robot_client: ignore the UDP reset Windows reports
    when a datagram found no simulator listening (WinError 10054).
    - RobotPawn: movable sun ligh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
2026-10-20 PCB toolchain runs on Windows and Linux: per-OS paths, UTF-8 file I/O, tests skip without KiCad (LIO-225)
    - pcb/tools.py: per-OS defaults (macOS unchanged; Windows %ProgramFiles% or %LOCALAPPDATA%\Programs\KiCad\9.0; Linux kicad-cli on
    PATH, /usr/share/kicad), each overridable: KICAD_CLI, KICAD_PYTHON, KICAD9_SYMBOL_DIR, KICAD9_FOOTPRINT_DIR, KICAD9_3DMODEL_DIR,
    JAVA (or JAVA_HOME, then PATH, then a Temurin JDK 25 under ~/tools or Program Files; not on macOS), FREEROUTING_JAR.
    New MODEL_DIR; make_fab uses it, so the STEP gets the real models off macOS too (it put an envelope on every part before).
    - Every file read in pcb/ and pcb/tests/ is UTF-8. Generated files are written as write_b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
2026-10-20 pcb script nits: sexpr \n escape, multi-goal A* heuristic, one definition per constant, arc courtyard bulge (LIO-230)
    - sexpr: parse unescapes \n, \" and \ in one pass (other \x kept as is); dump writes \n back, so library strings with \n round-trip.
    - gridroute.search: the heuristic is the octile distance to the nearest goal cell (was the first goal of the set: inadmissible with
    several goals). The committed routing is unchanged (ktest_route does not re-route).
    - Constants: route.THERMAL_GAP = build_pcb.THERMAL_GAP; gen_power_zones PAD / VIA / CLEAR from build_pcb.ZONE_CLEARANCE and
    board_spec.GND_VIA (same floats, block still current); ktest_route.VIA_PAD_MIN = route.VIA_PAD_KEEP; cad/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
2026-10-20 PCB docs: P03 tested at 6.0 V in under 4.5 A, Jetson 5 V set under load, stale reference notes, ORDERING sizes, harness ids (LIO-229)
    Documentation and reference-note fixes only: no board regeneration, the KiCad files and fab/ binaries are unchanged,
    board_spec.py gains comments only.
    - BRINGUP.md section 5: bench test at 6.0 V in, 4.5 A load, with the rule for raising the low-battery stop
    (lowest passing input + 0.5 V) and P03_VIN_MIN; section 7 step 3: 5 V at the Jetson barrel plug under load
    (>= 5.0 V, U5B <= V5_MAX 5.25 V); section 8 refers to the rule; PB22 -> PB21.
    - BRINGUP-NOTES.md: the stop rule, left-encoder pins GP1 / GP4 not adjacent, MOTOR_ON_N reports the toggle not
    VMOT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
2026-10-20 Routing and fab reproducibility: tool versions in ROUTED_WITH, pinned Freerouting jar, fab SOURCE.sha256, .net currency (LIO-228)
    - route.py appends the KiCad version, the Freerouting jar's sha256 and the Java version to ROUTED_WITH.
    - tools.py pins FREEROUTING_SHA256 (Freerouting 2.4.1); test_tools checks the jar against it (skips when the jar is absent).
    - ktest_route accepts ROUTED_WITH with or without the tool suffix and, when present, checks KiCad 9.0.x, the pinned jar and Java 25.
    The committed board predates the suffix; the next route.py run adds it. The board is not re-routed here.
    - make_fab writes fab/SOURCE.sha256 (LF-normalised sha256 of .kicad_pcb, .kicad_dru, .kicad_pro); tes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
2026-10-20 Power model: C3 ripple per PWM decay mode, stacked-layer IPC capacity, P03 input current and 5 V budget (LIO-227)
    - power_check.c3_ripple(slow_decay=True): fast decay (IN1 PWM, IN2 low: the off-time coasts) puts
    2 I sqrt(D (1 - D)) on VIN, so C3 carries 0.202 A at 20 kHz against its 0.16 A (100 kHz) rating;
    slow decay stays at 0.101 A. ktest_power asserts both; BRINGUP.md / BRINGUP-NOTES.md require
    slow-decay PWM (IN1 = 1, IN2 = inverted PWM) and forbid fast decay.
    - copper.capacity_a rates stacked layers on their combined external-equivalent cross-section
    (A_eq = sum A_i (k_i / 0.048)^(1 / 0.725)): 3 mm F.Cu + 3 mm B.Cu = 8.77 A, not 10.6 A.
    zone_check.pin_path_capacity caps the p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
2026-10-20 Board changes before fab: CS RC filters, DNP VSYS diode, ARM pull-up, 10k I2C pull-ups, 0.3 mm LP12 vias, JLCPCB DRC rules (LIO-226)
    - CS filters: R24 / R25 (4.7k) + C4 / C5 (100 nF, LP12 GND vias) on new nets L_CS_ADC / R_CS_ADC
    (GP27 / GP28, RC 0.47 ms), placed beside the drivers' CS pins: both Pico columns are full at
    the silk-label pitch, so there is no legal 0805 spot by U1B.7 / U1B.9.
    - D2: SS14 (SMA, DNP) from 5V to a new VSYS net at the Pico's pin 39 (U1B.2); VSYS left NC.
    The only legal SMA spot is the north end of DRV_R's interior.
    - R26: 10k ARM pull-up at the foot of the U1A column, with a notch in the VBAT_SW F.Cu strip
    (4.93 mm left there, 7.6 A); its 3V3 end is a scrip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
2026-10-20 Round-2 docs: CS reads I × duty, RC 0.72 ms, P03 test at 4.71 A, powered I2C check, D2 firmware note, harness ids (LIO-234)
    - CS under slow decay reads D × I × 1.1 V/A (high-side sense only): I = V_ADC / (1.1 V/A × D), valid for D ≳ 0.1, the 1.8 A limit
    on the corrected I; section 7 step 6 checks it at ~50 % duty against a series ammeter.
    - CS filter τ = (2.49 k + 4.7 k) × 100 nF = 0.72 ms (~220 Hz, 5τ 3.6 ms) everywhere; the cap raises ITRIP to ~3.5 A at D = 0.5.
    - §7 keeps the Pico on the bench USB; I2C pull-up check is powered (mA to GND, BOOTSEL).
    - D2-fitted firmware note (USB only with VBUS / GPIO24); relay-inrush and unprotected off-board lines on the verify list (LIO-235)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
2026-10-20 Round-2 scripts: DRC at every severity, JAVA_HOME / JDK 25 lookup, router tools read at start-up, BOM checked against board_spec (LIO-233)
    - route.evaluate runs kicad-cli DRC with --severity-all (was --severity-error): warning-level rules
    (hole_to_hole, via_dangling here) now make a board not clean. ktest_route's DRC also runs at
    --severity-all and test_drc_no_errors requires 0 violations of any severity.
    - tools._java(): candidates tested with Path.is_file() (java.exe on Windows), so JAVA_HOME works
    under KiCad's Python 3.11; order JAVA -> JAVA_HOME -> pinned JDK 25 (both Homebrew prefixes,
    ~/tools/jdk-25* and Program Files, /usr/lib/jvm/*25*), version-sorted -> PATH java. JAVA_HOME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
2026-10-20 Round-2 board: D2 5V tap via, scripted 0.25 mm VSYS, R_CS_ADC off the motor tracks, C4 / R24 labels, DRC rule severities, J1.1 ring cut rated as a stack (LIO-232, LIO-231)
    - D2.2's 5V anode taps the 5V B.Cu strip through one pre-routed PowerTap via (41.6, 64.6), like TP3: the router's
    32 mm J3 -> D2 F.Cu chain is gone and LED3_A routes straight (46.5 -> 3.0 mm).
    - VSYS is a scripted pre-route, 0.25 mm (0.27 A on 0.5 oz In2 at 10 degC vs PICO_VSYS_A 0.2 A; 0.15 mm carries 0.18 A):
    F.Cu -> In2 up DRV_L's interior -> B.Cu to U1B.2, 70.8 mm and 2 vias (was 92.1 mm, 4 vias, 38 mm of 0.15 mm In2;
    spanning tree 61.9 mm). Freerouting cannot leave D2's pocket (its DSN grows every via by VIA_GRO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
2026-10-20 Regenerate the fab package and board_cad.json on the merged tree (LIO-232, LIO-231)
    After merging origin/main (LIO-233 / LIO-234): make_schematic, gen_power_zones --check, build_pcb, route.py with
    no arguments (the same board as before the merge, byte for byte: stage F, 2818 mm, 101 vias), make_fab and
    export_cad. kicad-cli pcb drc --schematic-parity --severity-all: 0 violations, 0 unconnected, 0 parity; sch erc
    --severity-all: 0.
2026-10-20 Round-3 docs: J15.5 / 3V3 taps / COIL_P in the unprotected-lines note, JSON verify rows, README heights, bay-board review template, wording fixes (LIO-237)
    - ORDERING.md / BRINGUP.md unprotected-lines note: J15.5 also runs on 0.8 mm In2; the 3V3 taps
    J6.1 / J7.1 leave on 0.15 mm In2 (about 0.76 A for 1 s), limited only by the Pico's 3V3
    regulator; COIL_P leaves on J13.2 to Q5's gate (D1 clamps it negative).
    - parts-and-connections.json verify list: D1 row adds D2 (DNP), C2 row adds C4 / C5.
    - README.md: 135.15 mm tall, LiDAR at 127.5 mm, camera at 80 mm (robot-parameters.json).
    - cad/review-template.html: bay-board text in place of the Pico / relay carriers, MDD3A, the
    ground distribut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
2026-10-20 Round-3 board: J2.1 / J1.2 / J2.2 / K1.1 / U5B.1 / J3.1 copper reworked, every trunk pin rated by its ring cut, lib_footprint_issues ignored, router tool checks, tooling fixes (LIO-236)
    Zones (gen_power_zones, block regenerated; full pipeline re-run, routed clean):
    - F1_OUT: B.Cu round J2.2 (the fill keeps its clearance), so J2.1's west pocket
    is live; an F.Cu helper west and south of J2.1 stitched to the B.Cu trunk by
    three vias (u 8.5 / 10.0 / 11.5, v 63.25; B.Cu lane to v 63.9 there, BAT+
    stepped to v 64.4 east of u 7.5); In2 copy also east of J2.1. J2.1's ring cut
    4.32 -> 10.33 A (round-3 max-flow 4.45 -> 8.76 A).
    - BAT+: down to v 70.6 under J1.2, north edge kept for its mouth: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
2026-10-20 Round-4 board: trunk-pin ring cut out to +4.5 mm, J1.2 BAT+ copper widened, project fp-lib-table instead of ignoring lib_footprint_issues, ORDERING figures asserted, J6.1-J9.1 3V3 note (LIO-238)
    1. power_check.trunk_pin_ring: PIN_RINGS (2.5, 4.5), was (1.0, 2.5). The old outer ring stopped
    short of J2.1's F.Cu helper neck (10.3 A rated against 8.6-8.8 A by a pin-to-pin max-flow);
    at +4.5 J2.1 reads 8.40 A. Docstring, report section 3b and ORDERING.md now describe it as the
    pin's escape out to its ring, not the path to the trunk beyond it (section 1 rates the trunk
    necks). Cross-checked against a scratch raster max-flow on all 15 non-GND trunk pins: every
    committed figure is at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
2026-10-21 Round-5 scripts: ring cut drops dead-end copper past its outer ring, route.py closes its worker-log handle, README note for the kicad-cli ERC crash without a global fp-lib-table (LIO-239)
    1. power_check.live_copper: before each layer is rastered, pin_ring_cut drops every piece of
    (net copper - disc(centre, outer - 0.15 mm)) that holds no via and no pad of the net but the
    pin's own; such copper leads nowhere, yet raster_cut_mm took it as the sink. copper_raster takes
    the trimmed fill. Section 3b: F2.2 12.36 -> 7.44 A, F2.1 13.52 -> 9.29, F1.1 14.23 -> 10.55,
    F1.2 14.20 -> 11.23, J2.2 7.95 -> 7.93 (its +2.5 ring 8.31 -> 7.93 now binds); J2.1's +2.5 ring
    10.33 -> 8.41 (binding +4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
2026-10-21 Round-6 scripts: live_copper sinks only trunk pads and vias on non-GND nets, README ERC note (kicad-cli's first run copies the template table then crashes), ring cut "lower bound to within ~5 %" word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
    - power_check.live_copper: on a non-GND net a piece past the ring stays only if it holds a via of the net or another POWER_TRUNK pad;
    a signal pad (R11.1, a 0.07 mA divider) had kept a 24.5 sq mm F.Cu piece alive on F2.1's +4.5 ring: F2.1 9.29 -> 8.48 A. GND keeps
    every pad as a sink (its load pins are real returns; trunk-only drops J1.1's F.Cu cut to 0, 8.37 -> 5.34 A). No other figure moves.
    - README / make_schematic.py: kicad-cli 9.0.8's first `sch` run in a fresh config dir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
2026-10-21 Round-7 wording: 8-neighbour over-read is ~8 % in width / ~6 % in amps (2.02 mm whole-cell example), ERC crash is on the first `sch erc` run, README macOS template path (LIO-241)
2026-10-21 Round-8 docs: BRINGUP §7 "Jetson not fitted" (step 3 runs it beside the robot), J4/J5 comments and BOM note name the C18 pigtail socket (PB25), PowerTap 2.0 A / 0.62 A and via ~0.94 A in comments (LI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
2026-10-21 Round-8 board: silk "VIN" at the DRV8874 carriers' VIN pin (U3P.1, U4P.1), carrier orientation line in ORDERING and BRINGUP (LIO-242)
    The Pololu 4035 fits its two sockets turned 180 degrees too (carrier row L pin k in socket row P pin 8 - k), which puts its VREF on
    VMOT and its GNDs on DRV_SLEEP / DRV_FAULT. PIN_MARKS now takes a text mark: build_pcb draws 'VIN' 2.1 mm past the carrier's pin-1
    end, added last in build() so no seeded UUID moves. The committed board gets the two silk texts only (its U3P / U4P blocks replaced
    by a fresh build's, which differ by the texts alone); no copper changed, no re-route. Fab package regenerated (STEP left as is: it
    carries no silk), SOURCE.sha256 current.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
2026-10-21 Round-9 docs: solder the DRV8874 carriers' loose headers from the silkscreen side (parts-visible build), VIN named on that underside (LIO-244)
    ORDERING step 4 and BRINGUP section 1 item 4 now say, before the carriers are plugged, to solder each
    Pololu 4035's two 1 x 7 headers so the pins stand out of its silkscreen (labelled) side, so the components
    face up (Pololu's "parts visible" option, as pcb/reference/pololu-4035.txt assumes), and that VIN is named
    on that underside. "named on the carrier" becomes "named on its underside".
2026-10-24 Docs: the Jetson Nano A02 fits as well as the B01
    Checked against NVIDIA's developer kit user guide (DA_09402_004): same
    outline, mounting holes, I/O edge, barrel jack + J48, J15 fan header,
    module and heatsink. The A02's extra J40 / J44 pin headers at the
    carrier's rear-right corner clear W04 and the rear standoff.
    - build_robot.py / parts-and-connections.json: drop the wrong "other
    port positions" claim, list the real A02 differences (text only, no
    CAD rebuild)
    - README: compute is B01 or A02
    - BRINGUP: A02 J48 location; include the J40 / J44 tails in the
    under-carrier gap measurement
    - JETSON.md: same SD image for both; QSPI / force-recovery fallback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
